tetrabiodistributed/project-tetra/README.md

# Project Tetra - Project Repository
This repository contains STL files and schematics for Project Tetra.

Project documentation available at https://tetrabiodistributed.github.io/docs
