tetrabiodistributed/project-tetra/02_Development/README.md

READ ME

File for designs of the part in all stages, 
draft, final, in testing, 

PLEASE LABEL THE DESIGNS WITH THE STATUS AND VERSION.

PLEASE CREATE A PULL REQUEST FOR EACH DESIGN OF SPLITTER

MAIN FOCUS:

TEST RESULTS NEEDED

dimensions of tubing, if they fit

strength

flow

test with different lung sizes and compliances

flow rates to diff patients

TO DESIGN ensure fittings are ISO

device at the mouth to measure tidal flow, pressure,tidal volume

antiviral & antibacterial filter - integrated into design but not essential for operation

regulator of max pressure into lungs

PEEP valve connector

3 way valve formpatiemt isolation

On git with files please create a text/pdf documentation

Thread specs: ALL IN 3/8" NPT PLEASE
