tetrabiodistributed/project-tetra/03_Visulisation_and_Handbooks/CAD_drawings/readme

Add folder for CAD drawings of components and assemblies
