tetrabiodistributed/project-tetra/02_Development/one way valve/ReadMe.txt

One_way_valve V3

*** Parts list

* "one-way valve body V3"
* "one-way valve umbrella seal V3"
*** ASSEMBLY INSTRUCTION
* The umbrella seal is a felxible silicone component with a small diameter "stem" feature and a wide flat "umbrella" feature. 
* Insert the umbrella seal, stem first, from the downstream end (against the arrow) and push the stem such that it pushes all the way through the center hole, trapping the seal. 
* The underside of the umbrella feature should lie flat against the flat internal surface.

*** TESTING:

* Test ability as a one way valve and also do cycle testing to ensure it can withstand the 1000cycles/hour
