tetrabiodistributed/project-tetra/02_Development/CPAP Regulator/README.md

**Read Me**

The folder venturi valve contains the most up to date venturi valve
The other folder contains all the other parts to be printed.
