tetrabiodistributed/project-tetra/03_Visulisation_and_Handbooks/CAD_drawings/PEEP_valve_rev2/readme

CAD drawings for PEEP valve regulator rev2
