tetrabiodistributed/project-tetra/02_Development/3WayValve/3WayConicalValve/readme.md

# 3 Way Conical Valve

3D printed 3 Way Valve for 22mm/15mm ISO 5356 Respiratory Tubing

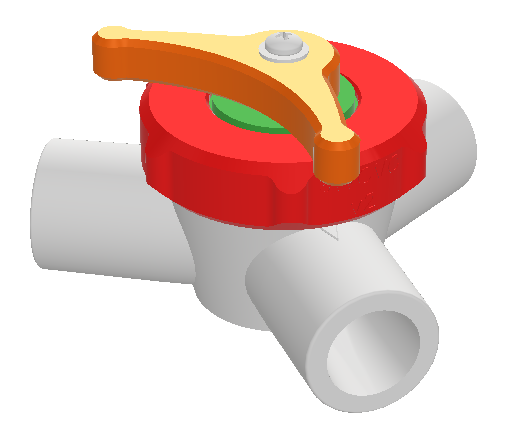
[picture p1: 02_Development/3WayValve/3WayConicalValve/3WayConicalValve.PNG]
valve


## Background

Based on request here: https://helpfulengineering.slack.com/archives/C0103QJMA84/p1584585757410000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

Valve design created that supports airflow in any 2 of the 3 ports. Utilizes 2 3D printed parts, a M3x6 screw and M3x8 washer. Substitue with #4-40 screw and #4 washer. 

Latest version is now 4 parts.

### Making Valve

Print 1 each of the following parts

* 3WayConicalValveBodyV2.stl
* 3WayConicalValveCockV2.stl
* 3WayConicalValveCapV2.stl
* 3WayConicalValveHandleV3.stl (UPDATED: new design to indicate port flow)

Purchase or find the following hardware

* M3 x 6 screw 
     * https://www.mcmaster.com/92000a116
       * or
     * https://www.homedepot.com/p/Everbilt-M3-0-5-x-6-mm-Phillips-Pan-Head-Zinc-Plated-Machine-Screw-3-Pack-802698/204282657
* M3 washer with a minimum 8mm OD (outer diameter) 
     * https://www.mcmaster.com/91116a120
       * or
     * https://www.homedepot.com/p/Everbilt-M3-Zinc-Plated-Steel-Flat-Washers-5-Pack-803518/204284512

Blind tap the screw hole at the bottom of the 3WayValveCock. If you don't have access to a tap, you can force the m3 screw into the hole. If it's not easy going, pre-heat the screw to make it easier.

Assemble, per drawing
