tetrabiodistributed/project-tetra/02_Development/TetraValve/STL/v4-1/Readme

Design works with G-74 - Compression Spring from Century Spring Corp
https://www.centuryspring.com/catalog/?page=product&cid=root&id=G-74CS

Add seal pad to base of valve head (allowance for 0.5mm thickness, if larger, characteristics may change)

Original spec o-rings ordered from McMaster Carr

O-Ring: -018 N70 NITRILE (NBR, BUNA) 70 DUROMETER BLACK https://www.globaloring.com/product/n70018/
O-Ring: -020 N70 NITRILE (NBR, BUNA) 70 DUROMETER BLACK https://www.globaloring.com/product/n70020/
O-Ring: -128 N70 NITRILE (NBR, BUNA) 70 DUROMETER BLACK https://www.globaloring.com/product/n70128/
