tetrabiodistributed/project-tetra/02_Development/FlowMeter/RPi Board/Sensor_manifold/v2/Readme.md

## Pressure sensor manifold V2 

Details on changes listed on [project card](https://github.com/orgs/tetrabiodistributed/projects/1#card-41428429)

Manifold v1 design by jgrano, updated by Burhan-Q
