tetrabiodistributed/project-tetra/02_Development/Display/Documentation/TubingDataInformationScreen.odp

## Tubing Data Information Screen

Each column is a patient connected to the port labelled with the number

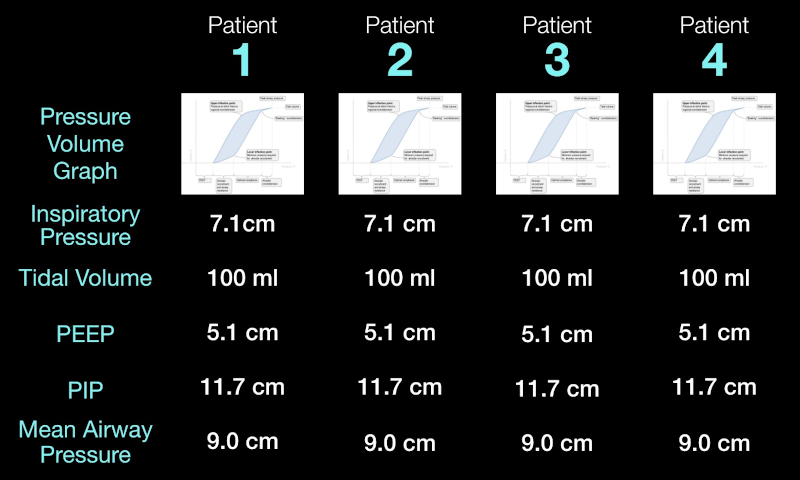
[picture p3: figure]

At the intersection of a row and column, there is the value of the row's descriptor for the column's patient

Positive End-Expiratory Pressure

Peak Inspiratory Pressure

Each row is a descriptor of the state of the patients's airways
