tetrabiodistributed/project-tetra/02_Development/CPAP Regulator/Concept Sketches/CPAP valve concept - bubbler fixed.pdf

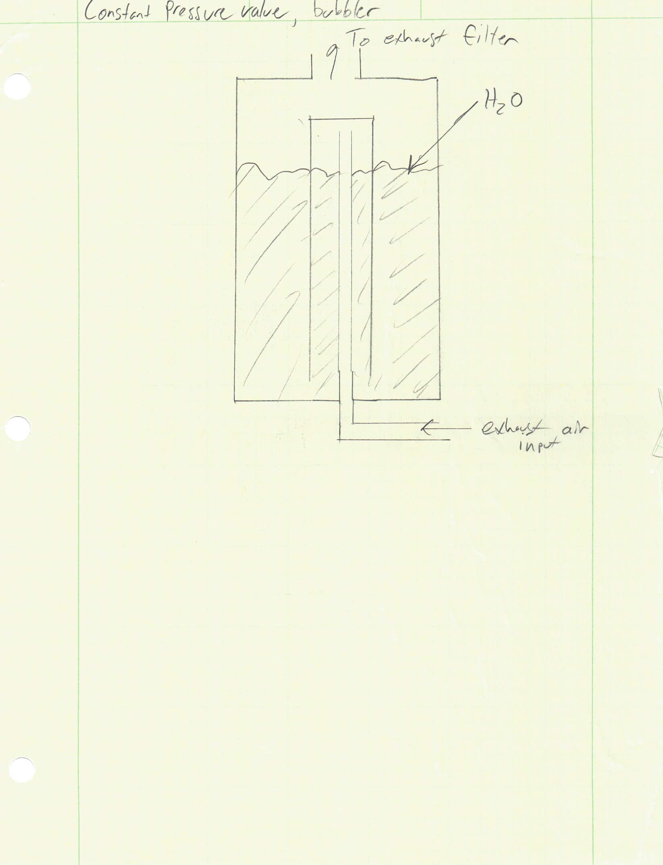
[picture p14: page 1]
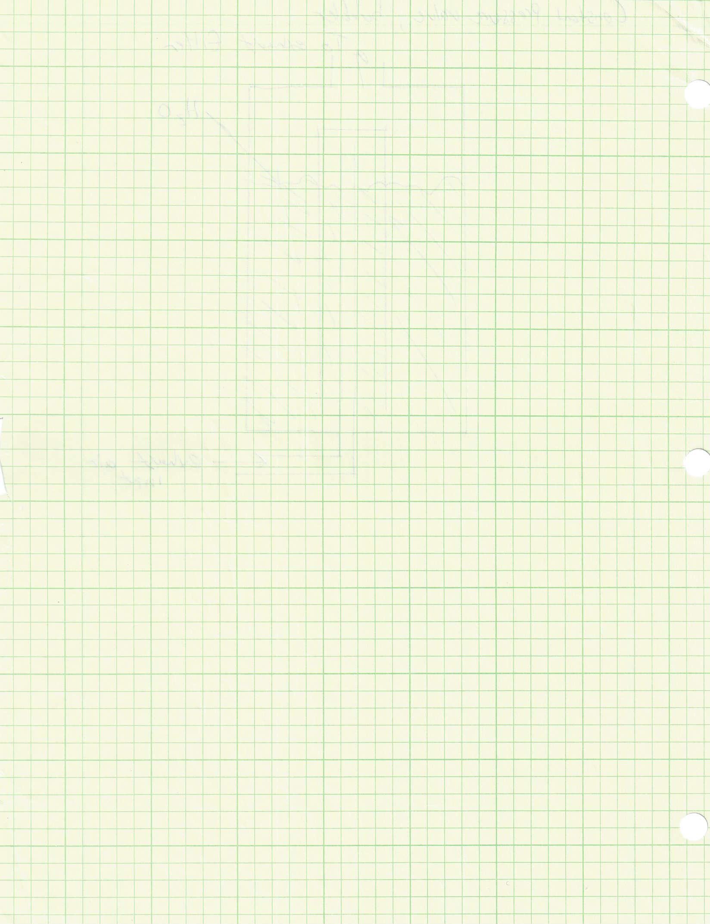
[picture p15: page 2]
