tetrabiodistributed/project-tetra/02_Development/CPAP Regulator/Concept Sketches/CPAP valve concept - isolated piston.pdf

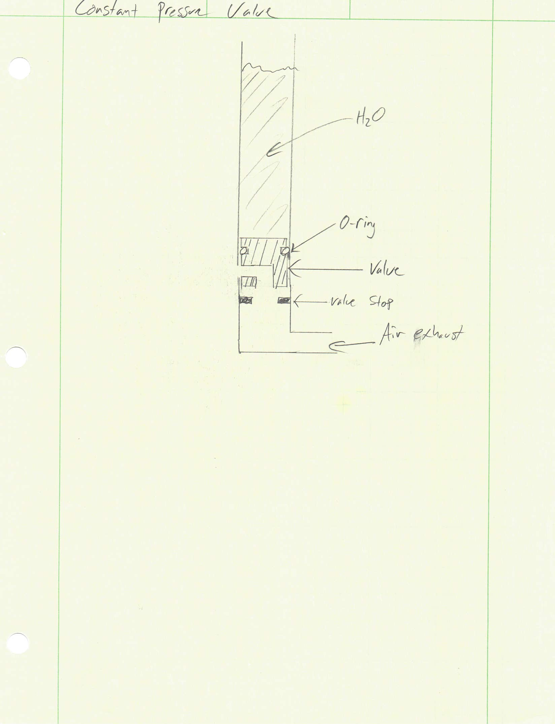
[picture p16: page 1]
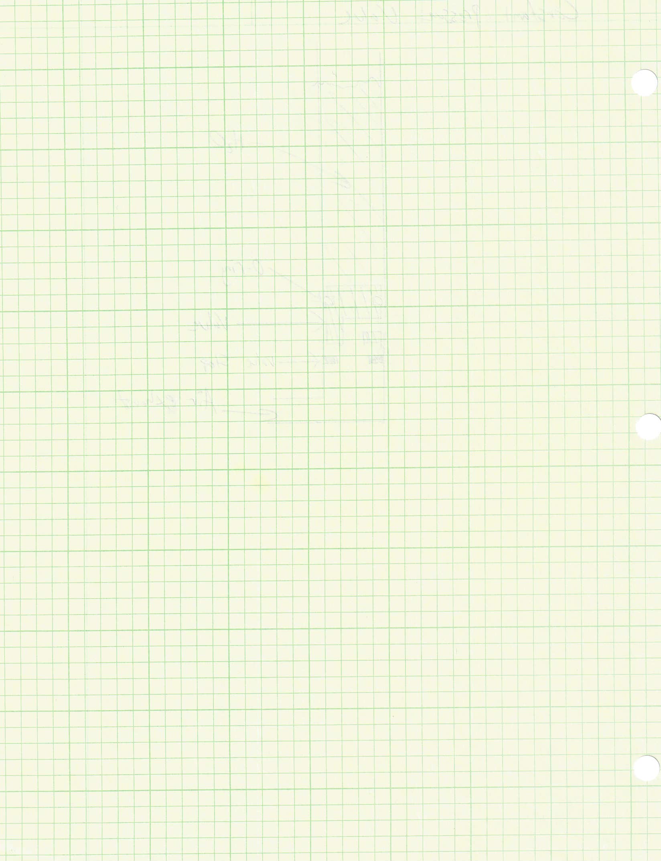
[picture p17: page 2]
