tetrabiodistributed/project-tetra/02_Development/Old/3WayValve/TeeValve - older/readme.md

# Project Title

3D printed Tee Valve for 22mm/15mm ISO 5356 Respiratory Tubing

## Background

This is an iteration of 3WayValve design and is similar as flow can be directed from any port to the other port. Unrestricted flow is from any 90 degree connection. Thru flow is somewhat restricted. It also allows for fully shutting off flow. Utilizes 2 3D printed parts, a M3x6 screw and M3x8 washer.

The T shape of the valve is less confusing than a symmetric 3 way valve. The T offers 2 ports in-line that are the inputs, and a 3rd port that can go to the user.

### Making Valve

Print 1 each of the following parts

* TeeValveBody_v001.stl
* TeeValveCock_v001.stl

Note: 3D printers make parts with varying tolerances, and material can affect the fit.  If fit is too tight, I included 2 parts that are undersized. Need to confirm air leaks are acceptable with these parts. 
* TeeValveCock_v001-undersize 1 (body diameter is undersized by .2 mm)
* TeeValveCock_v001-undersize 2 (body diameter is undersized by .4 mm)

Purchase or find the following hardware

* M3 x 6 screw
     * https://www.mcmaster.com/92000a116
     * https://www.homedepot.com/p/Everbilt-M3-0-5-x-6-mm-Phillips-Pan-Head-Zinc-Plated-Machine-Screw-3-Pack-802698/204282657
* M3 washer with a minimum 8mm OD (outer diameter) 
     * https://www.mcmaster.com/91116a120
     * https://www.homedepot.com/p/Everbilt-M3-Zinc-Plated-Steel-Flat-Washers-5-Pack-803518/204284512

Blind tap the screw hole at the bottom of the TeeValveCock

Assemble, per drawing. Remove any loose printed material and clean part before use.

## Revisions
19MAR2020 - Initial Release

## Designed With

* Autodesk Inventor 2020 

by Patrick Campbell

## License

This project is licensed under the MIT License
