tetrabiodistributed/project-tetra/02_Development/FlowMeter/RPi Board/Sensor_manifold/v1/Readme.md

## Pressure sensor manifold v1

by jgrano
