tetrabiodistributed/project-tetra/03_Visulisation_and_Handbooks/Old/Schematics/Vent Splitter Schematics v7.pptx

Inspiratory Splitter Box

Patient A Tubing

Patient B Tubing

A

Filter

Filter

B

Bias Circuit

Patient A Tubing

Patient B Tubing

A

Filter

Filter

B

Ventilator

Inspiratory Arm

Expiratory Splitter Box

Expiratory Arm

This design will allow a modern ventilator to have a splitter. The key innovation here came from the Differential Multiventilation group– the Bias Circuit. That circuit bypasses the compensatory electronics inside the ventilator. Ventilators without those electronics will not need that bias circuit. Inspiratory and Expiratory Splitter Boxes are on the pages to follow. #project-4-way-ventilator, Helpful Engineering (rev v7 25 April 2020)

## Slide 2

Ventilator Splitter Box (VSB)

Inspiratory Section

Expiratory Section

Ventilator

VSP VSB Schematics v7
25 April 2020

Inspiratory Arm

1-Way Valve

Patient 1 Flow Control

P1 Inspiration

1-Way Valve

Patient 2 Flow Control

P2 Inspiration

1-Way Valve

Patient 3 Flow Control

P3 Inspiration

1-Way Valve

Patient 4 Flow Control

P4 Inspiration

Bias Circuit

P1 Expiration

Expiratory Arm

P1 PEEP

P1 Flow Meter

P1 Shutoff

P2 PEEP

P2 Flow Meter

P2 Shutoff

P2 Expiration

P3 PEEP

P3 Flow Meter

P3 Shutoff

P3 Expiration

P3 PEEP

P4 Flow Meter

P4 Shutoff

P4 Expiration
