tetrabiodistributed/project-tetra/03_Visulisation_and_Handbooks/Old/Schematics/Vent Splitter Schematics v6.pptx

Inspiratory Splitter Box

Patient A Tubing

Patient B Tubing

A

Filter

B

Filter

Patient A Tubing

A

Filter

B

Filter

Patient B Tubing

Ventilator

Inspiratory Arm

1-way
Valve

Flow Control

Splitter

1-way
Valve

Flow Control

Expiratory Splitter Box

Expiratory Arm

PEEP Valve

Shutoff

Flow Meter

Splitter

PEEP Valve

Shutoff

Flow Meter

The goal of this design is to compartmentalize patient tubing so that patients can be added and removed without affecting other patients on the circuit. Thus, all components need to be separated by filters, but self-contained so clinicians aren’t having to attach individual splitter components. Flow control can initially be by a hand-controlled valve. #project-4-way-ventilator, Helpful Engineering (rev v5 8 April 2020)

## Slide 2

Ventilator Splitter Box (VSB)

Inspiratory Section

Expiratory Section

Ventilator

VSP VSB Schematics v6
13 April 2020

Inspiratory Arm

Patient 1 Flow Control

P1 Inspiration

Patient 2 Flow Control

P2 Inspiration

Patient 3 Flow Control

P3 Inspiration

Patient 4 Flow Control

P4 Inspiration

Expiratory Arm

P1 PEEP

P1 Flow Meter

P1 Shutoff

P1 Expiration

P2 PEEP

P2 Flow Meter

P2 Shutoff

P2 Expiration

P3 PEEP

P3 Flow Meter

P3 Shutoff

P3 Expiration

P3 PEEP

P4 Flow Meter

P4 Shutoff

P4 Expiration
