tetrabiodistributed/project-tetra/02_Development/3WayValve/3WayOring/Rev8/V1_0_X_SAK/01_CAD_Daten/image (1).png

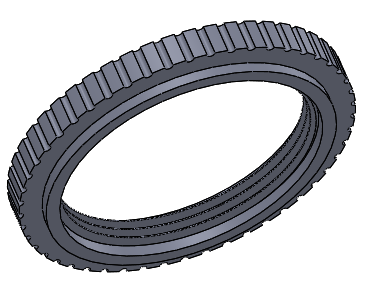
02_Development/3WayValve/3WayOring/Rev8/V1_0_X_SAK/01_CAD_Daten/image (1).png
