tetrabiodistributed/project-tetra/02_Development/3WayValve/3WayOring/Rev8/V1_0_X_SAK/02_Renderings/01_SAK.png

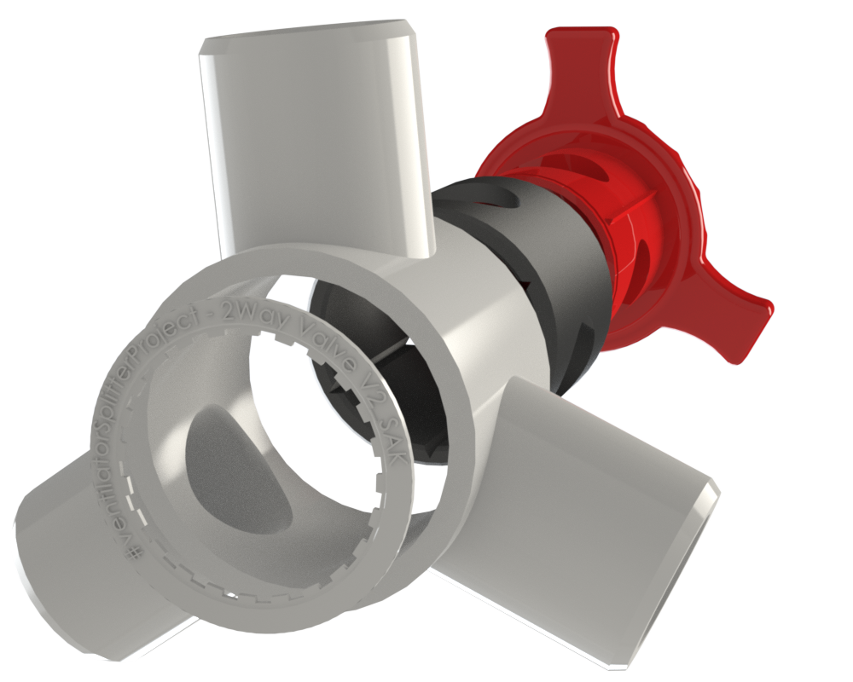
02_Development/3WayValve/3WayOring/Rev8/V1_0_X_SAK/02_Renderings/01_SAK.png
