tetrabiodistributed/project-tetra/02_Development/3WayValve/3WayOring/Rev8/V1_0_X_SAK/MoldingForm/3WayValveMoldingForm.jpg

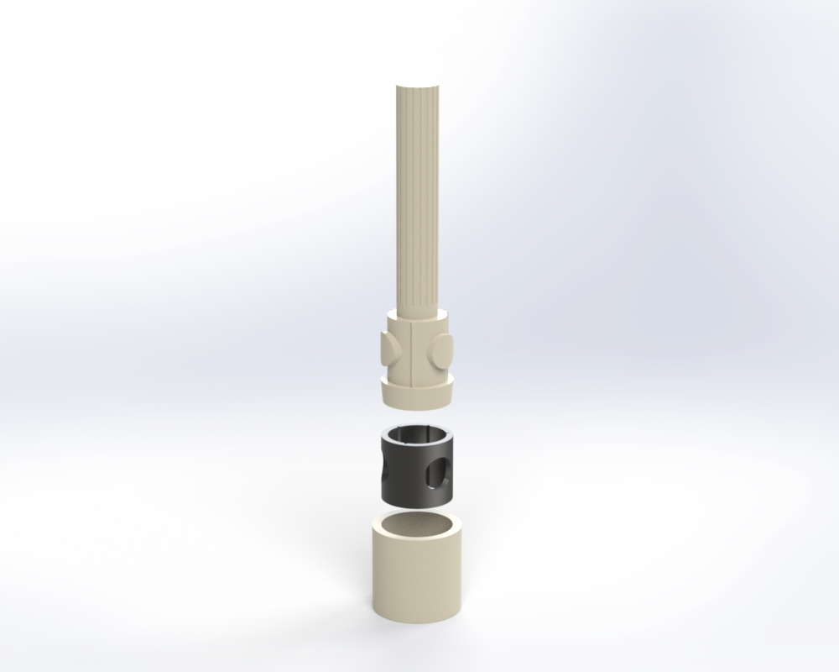
02_Development/3WayValve/3WayOring/Rev8/V1_0_X_SAK/MoldingForm/3WayValveMoldingForm.jpg
