tetrabiodistributed/project-tetra/02_Development/CPAP Regulator/Concept Sketches/CPAP valve concept - bubbler sliding dipstick.jpg

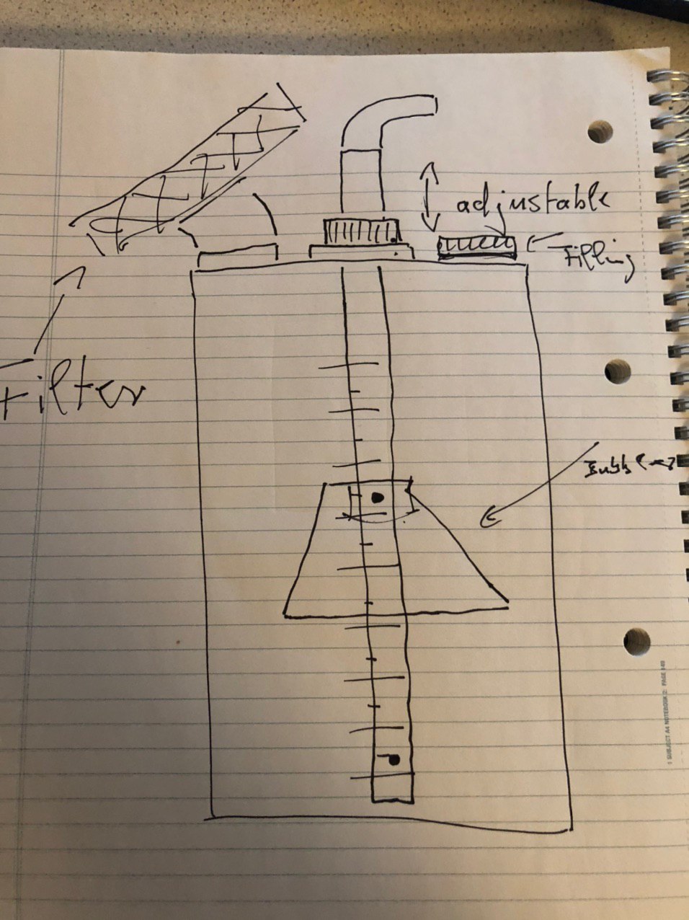
02_Development/CPAP Regulator/Concept Sketches/CPAP valve concept - bubbler sliding dipstick.jpg
