tetrabiodistributed/project-tetra/02_Development/CPAP Regulator/Positive Ending Expiratory Pressure Valve (rev. 2)/Pictures/IMG_5869.JPG

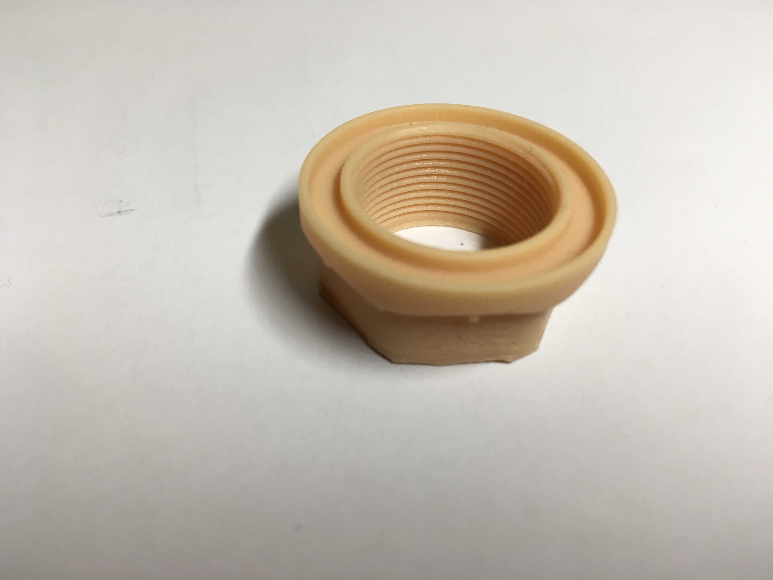
02_Development/CPAP Regulator/Positive Ending Expiratory Pressure Valve (rev. 2)/Pictures/IMG_5869.JPG
