tetrabiodistributed/project-tetra/02_Development/CPAP Regulator/positive-ending-expiratory-pressure-valve-rev1/3D/Venturi Nozzle/CFD r2.jpg

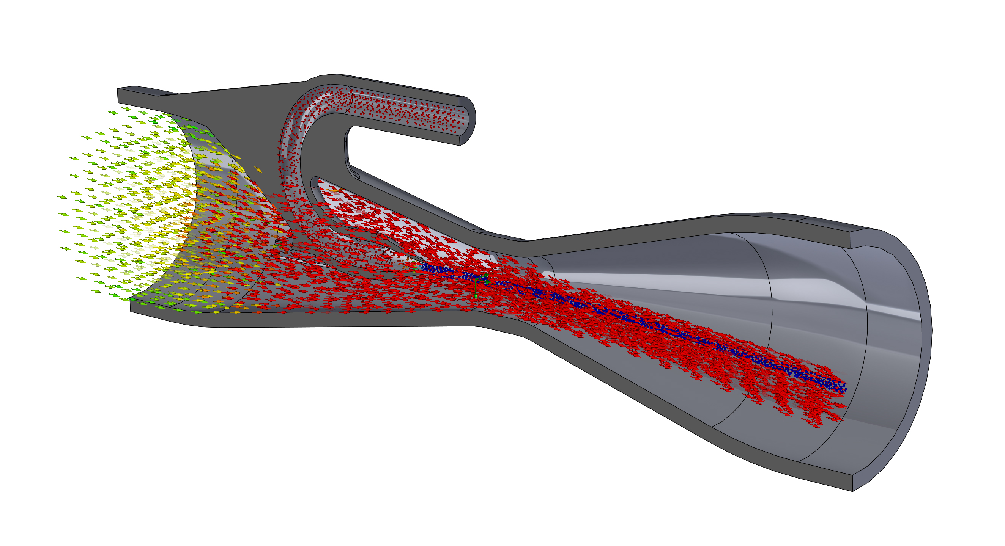
02_Development/CPAP Regulator/positive-ending-expiratory-pressure-valve-rev1/3D/Venturi Nozzle/CFD r2.jpg
