tetrabiodistributed/project-tetra/02_Development/CPAP Regulator/positive-ending-expiratory-pressure-valve-rev1/3D/Venturi Nozzle/Render rev2_1.jpg

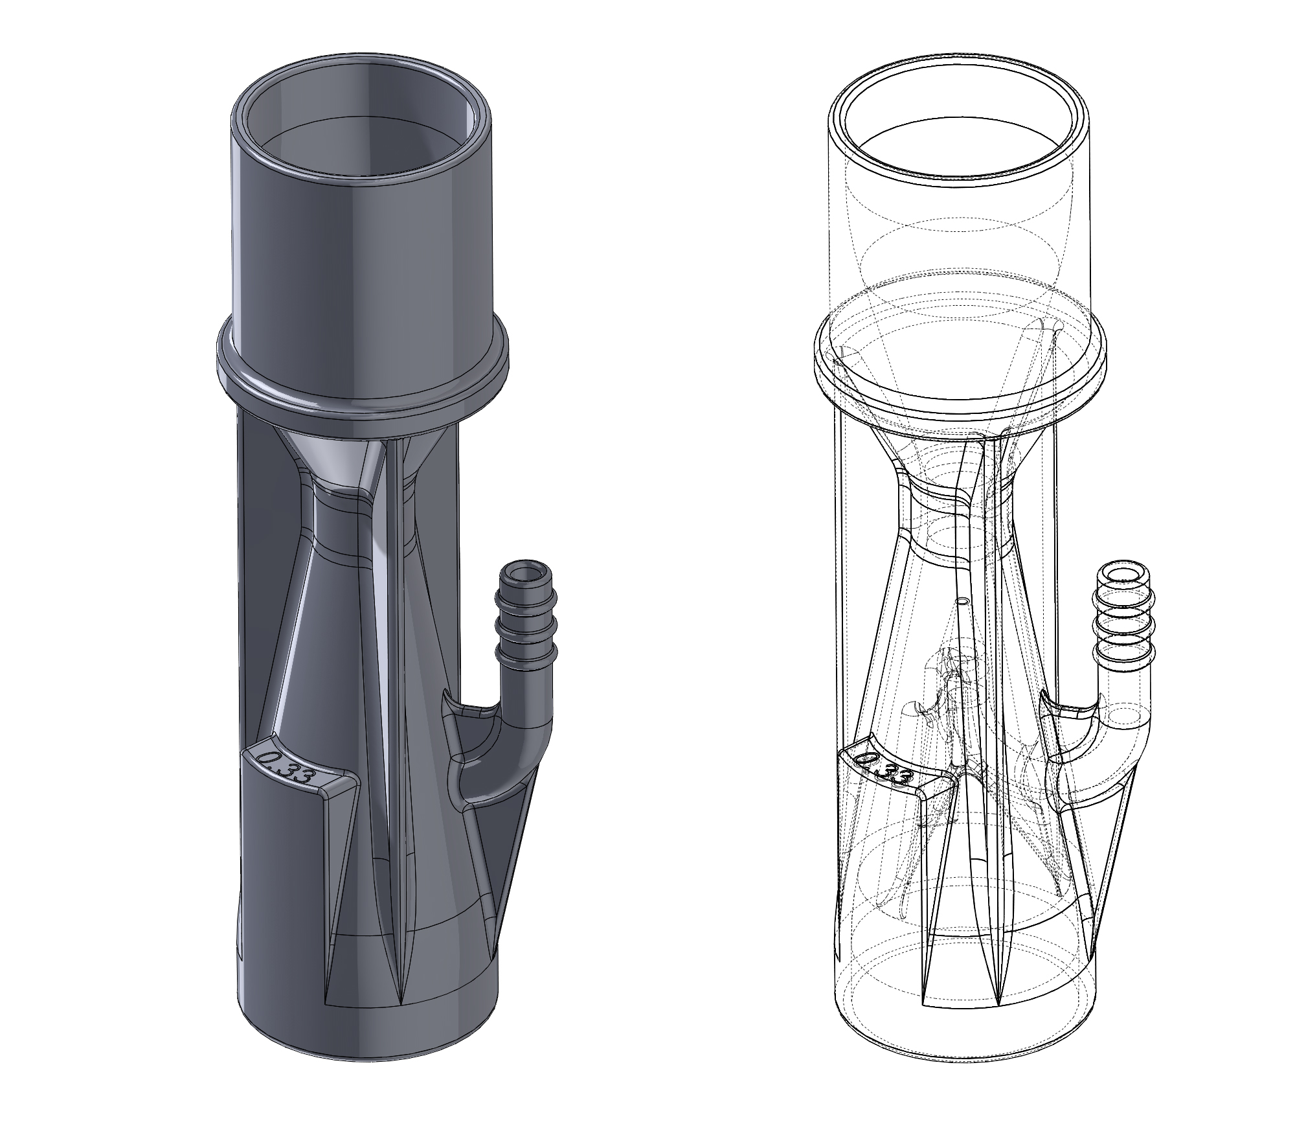
02_Development/CPAP Regulator/positive-ending-expiratory-pressure-valve-rev1/3D/Venturi Nozzle/Render rev2_1.jpg
