tetrabiodistributed/project-tetra/02_Development/CPAP Regulator/positive-ending-expiratory-pressure-valve-rev1/PEEP Calculation.png

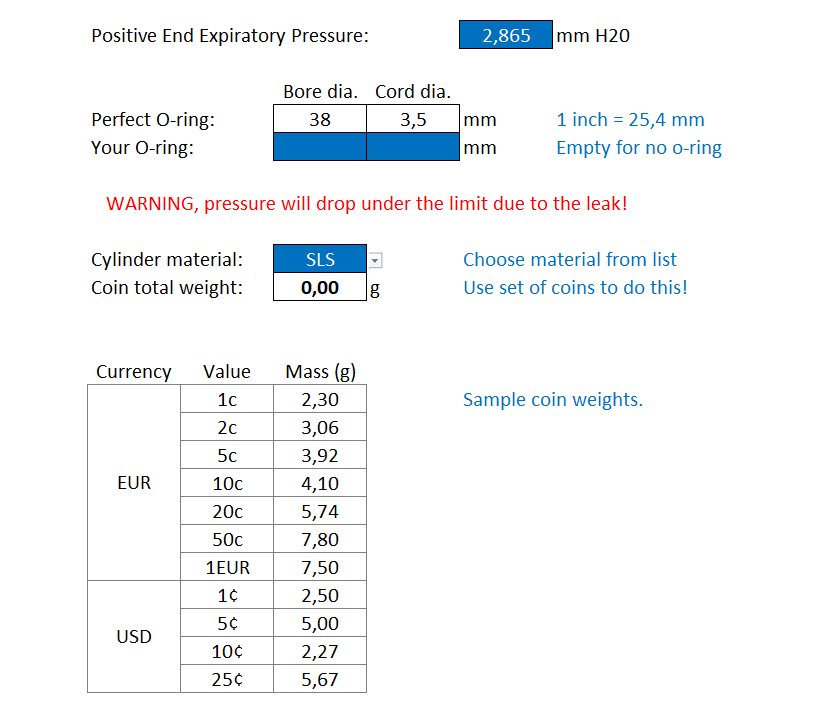
02_Development/CPAP Regulator/positive-ending-expiratory-pressure-valve-rev1/PEEP Calculation.png
