tetrabiodistributed/project-tetra/02_Development/CPAP Regulator/positive-ending-expiratory-pressure-valve-rev1/Render 2.jpg

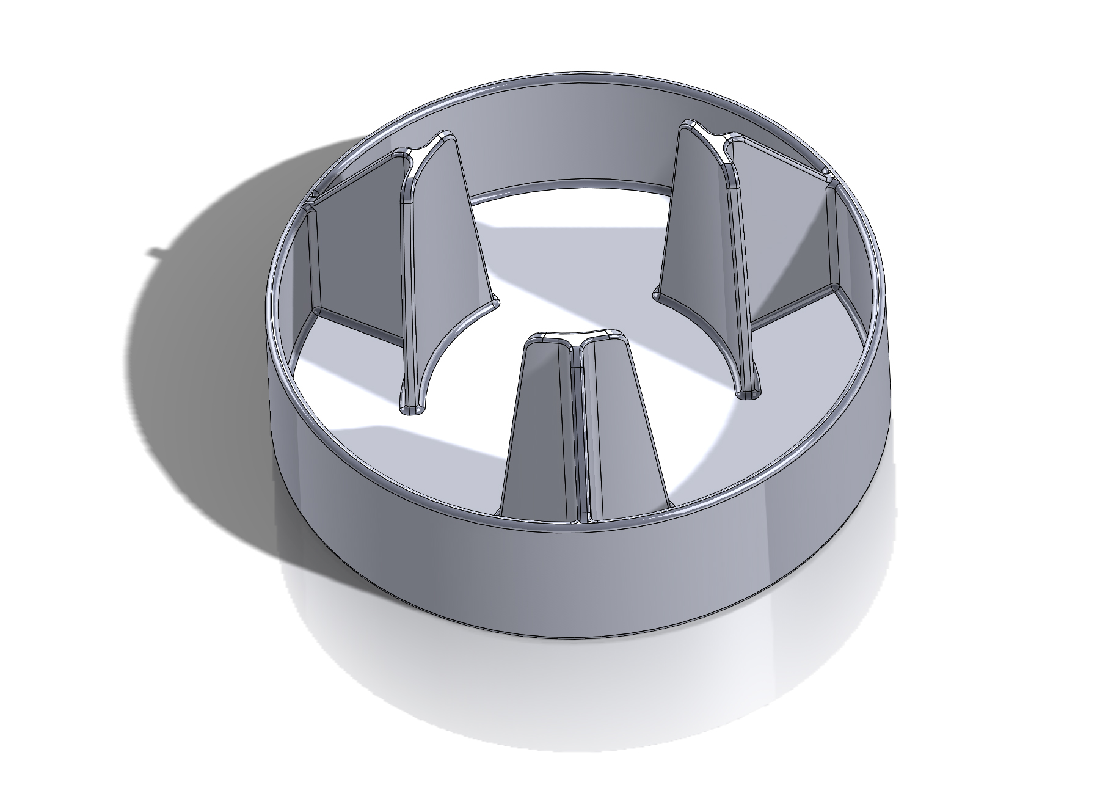
02_Development/CPAP Regulator/positive-ending-expiratory-pressure-valve-rev1/Render 2.jpg
