tetrabiodistributed/project-tetra/02_Development/CPAP Regulator/positive-ending-expiratory-pressure-valve-rev1/Render 4.jpg

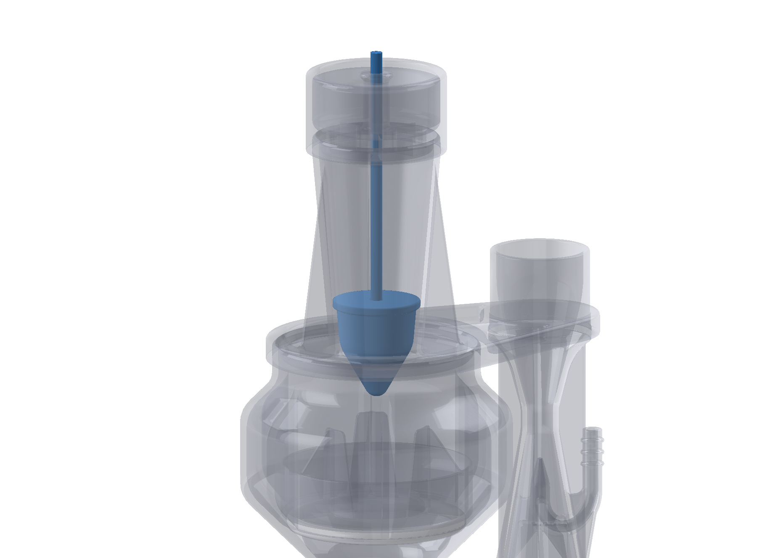
02_Development/CPAP Regulator/positive-ending-expiratory-pressure-valve-rev1/Render 4.jpg
