tetrabiodistributed/project-tetra/02_Development/CPAP Regulator/Venturi valve/Respirator-free reanimation Venturi's valve (rev. 4)/Renderings/Revision 4 - rendering 5_2.JPG

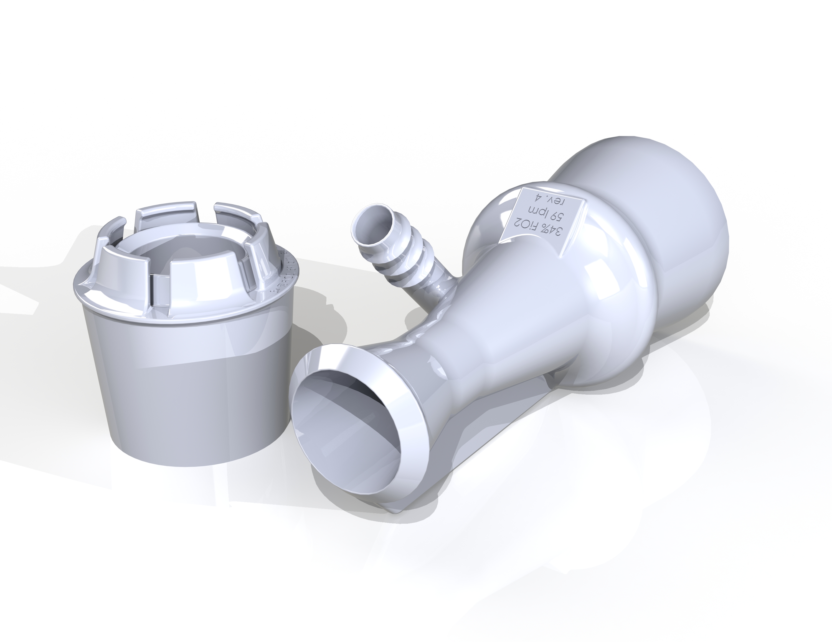
02_Development/CPAP Regulator/Venturi valve/Respirator-free reanimation Venturi's valve (rev. 4)/Renderings/Revision 4 - rendering 5_2.JPG
