tetrabiodistributed/project-tetra/02_Development/CPAP Regulator/Venturi valve/Respirator-free reanimation Venturi's valve (rev. 4)/Renderings/Revision 4 - rendering 6_2.jpg

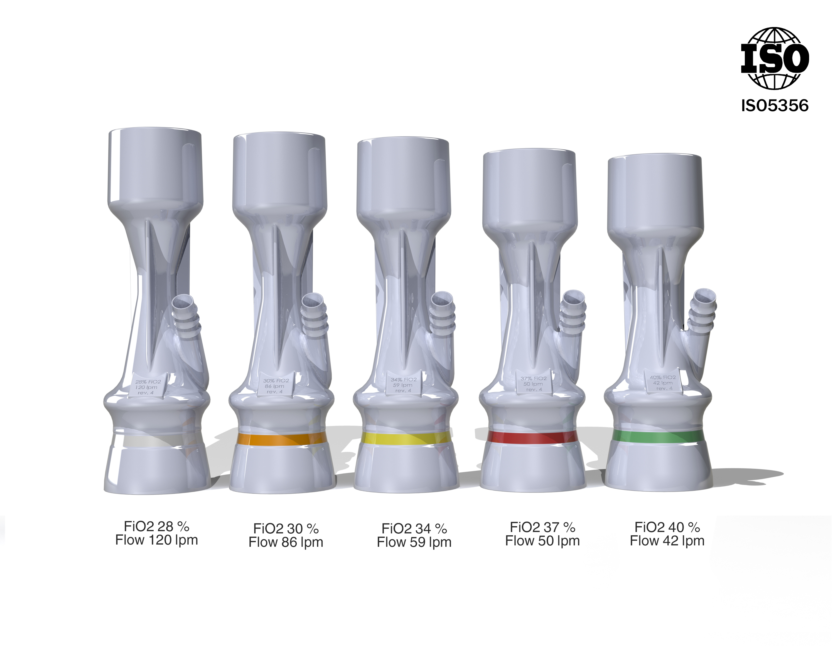
02_Development/CPAP Regulator/Venturi valve/Respirator-free reanimation Venturi's valve (rev. 4)/Renderings/Revision 4 - rendering 6_2.jpg
