tetrabiodistributed/project-tetra/02_Development/FlowMeter/flowmeter.png

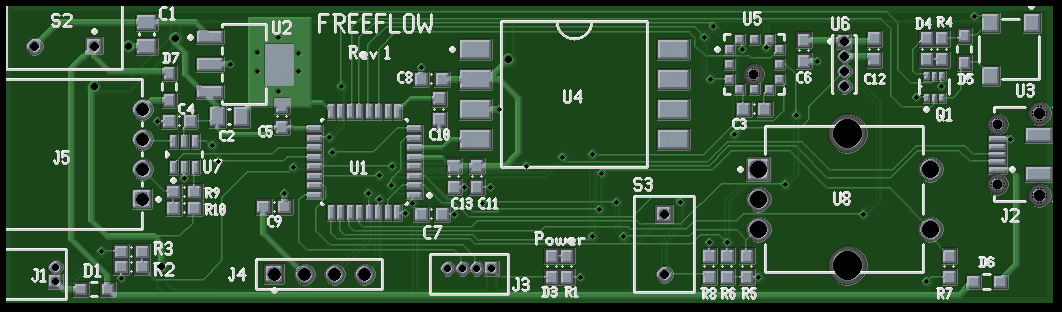
02_Development/FlowMeter/flowmeter.png
