tetrabiodistributed/project-tetra/02_Development/FlowMeter/Honeywell.PNG

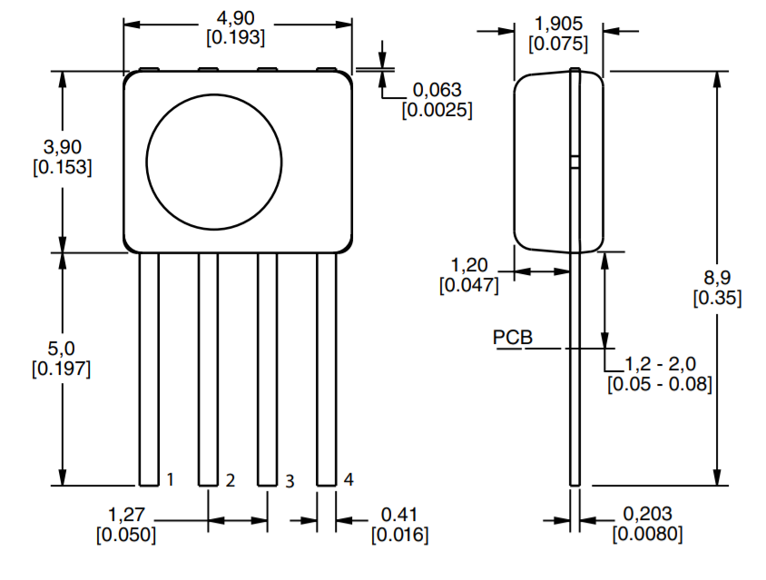
02_Development/FlowMeter/Honeywell.PNG
