tetrabiodistributed/project-tetra/02_Development/inspiratory 2-way splitter/02_Renderings/inspiratory 2-way splitter front view.PNG

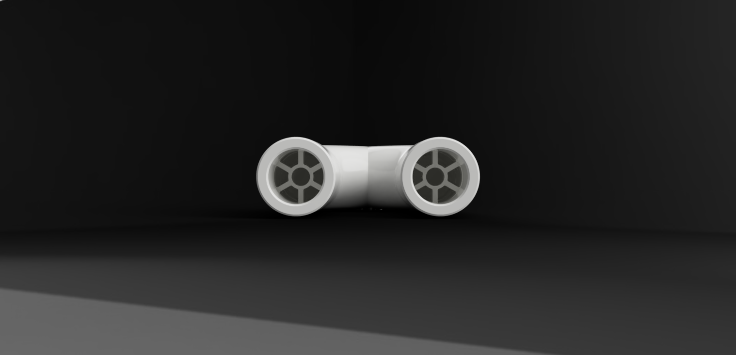
02_Development/inspiratory 2-way splitter/02_Renderings/inspiratory 2-way splitter front view.PNG
