tetrabiodistributed/project-tetra/02_Development/inspiratory 2-way splitter/02_Renderings/inspiratory 2-way splitter.png

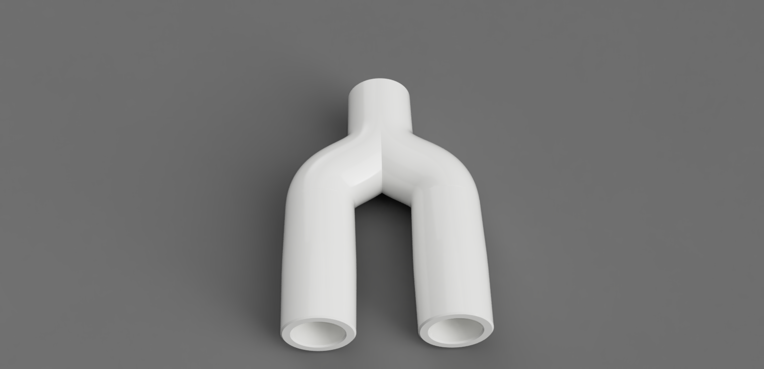
02_Development/inspiratory 2-way splitter/02_Renderings/inspiratory 2-way splitter.png
