tetrabiodistributed/project-tetra/02_Development/Main-Splitter/03_15mm adaptor/4WayVent_3DP_v06_15 mm adapter.JPG

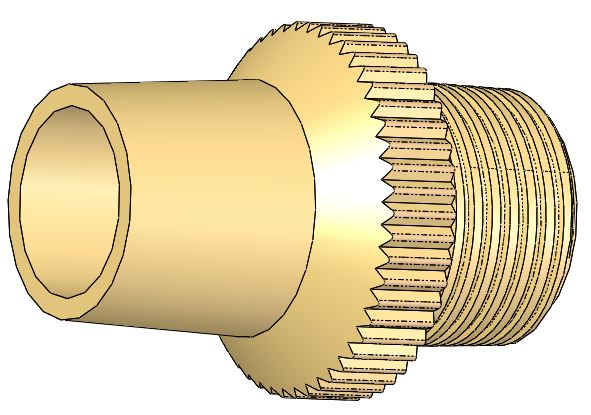
02_Development/Main-Splitter/03_15mm adaptor/4WayVent_3DP_v06_15 mm adapter.JPG
