tetrabiodistributed/project-tetra/02_Development/Male to male connector/Rev2/02_Renderings/male_conector_3_8_NPT_Render_1.png

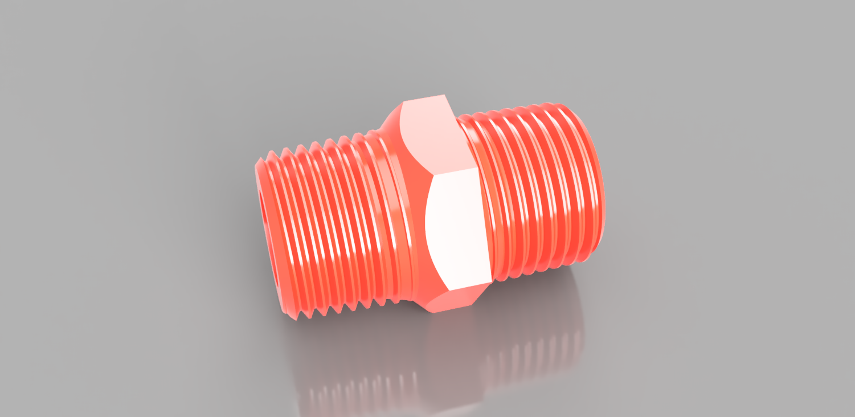
02_Development/Male to male connector/Rev2/02_Renderings/male_conector_3_8_NPT_Render_1.png
