tetrabiodistributed/project-tetra/02_Development/one way valve/one-way valve umbrella seal V3.JPG

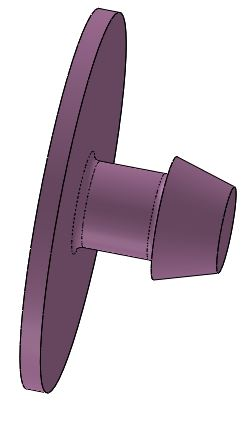
02_Development/one way valve/one-way valve umbrella seal V3.JPG
