tetrabiodistributed/project-tetra/02_Development/one way valve/one-way valve V3 cross-section.JPG

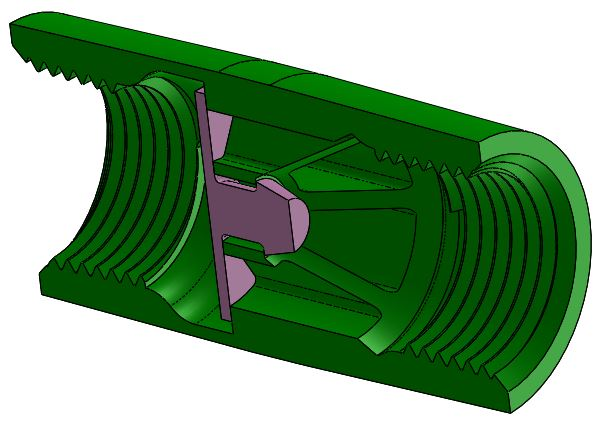
02_Development/one way valve/one-way valve V3 cross-section.JPG
