tetrabiodistributed/project-tetra/02_Development/one way valve/Rev2 - Use This with TPU/02_Renders/Cut view.png

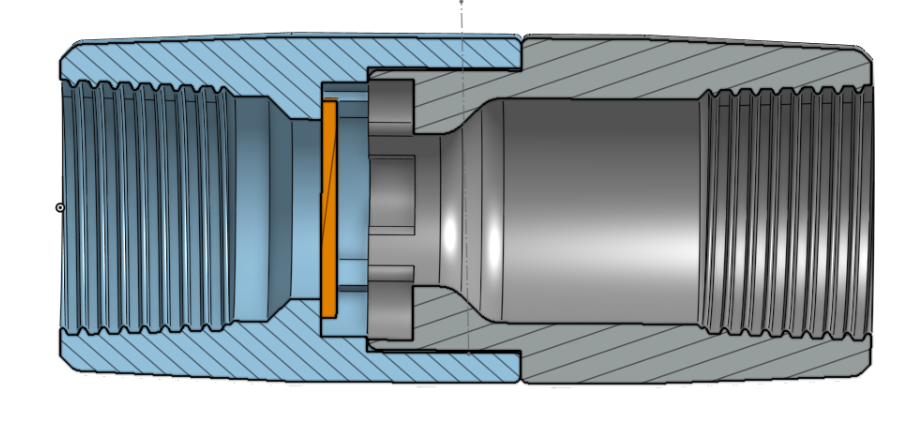
02_Development/one way valve/Rev2 - Use This with TPU/02_Renders/Cut view.png
