tetrabiodistributed/project-tetra/02_Development/one way valve/Rev4_Unthreaded/02_Renders/ValveBody_CrossSection.png

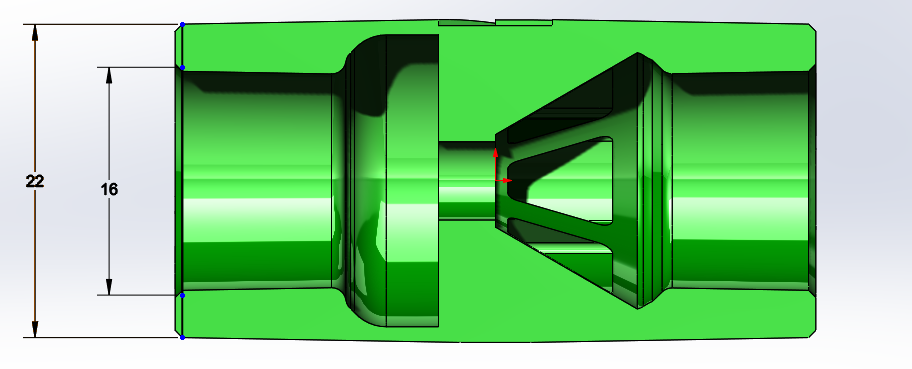
02_Development/one way valve/Rev4_Unthreaded/02_Renders/ValveBody_CrossSection.png
