tetrabiodistributed/project-tetra/02_Development/OneWayValveNew/photo_2020-04-03 14.55.22.jpeg

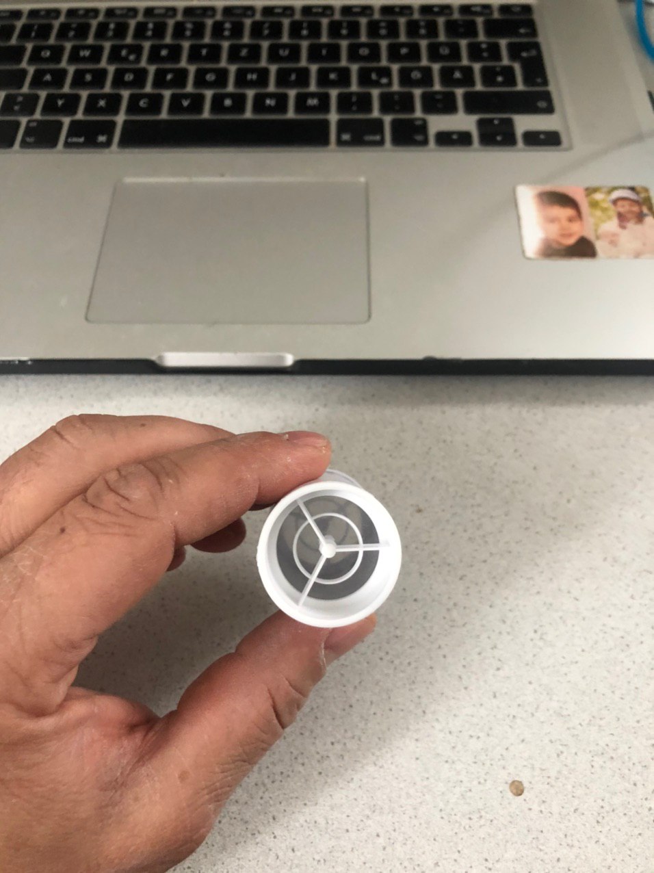
02_Development/OneWayValveNew/photo_2020-04-03 14.55.22.jpeg
