tetrabiodistributed/project-tetra/02_Development/OneWayValveNew/photo_2020-04-03 20.42.10.jpeg

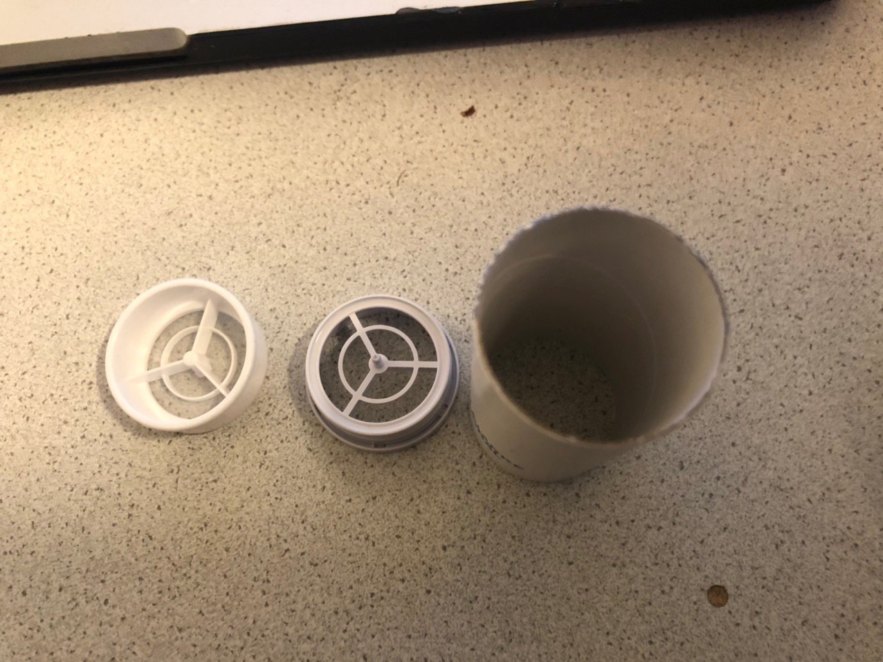
02_Development/OneWayValveNew/photo_2020-04-03 20.42.10.jpeg
