tetrabiodistributed/project-tetra/02_Development/OneWayValveNew/photo_2020-04-03 21.38.17.jpeg

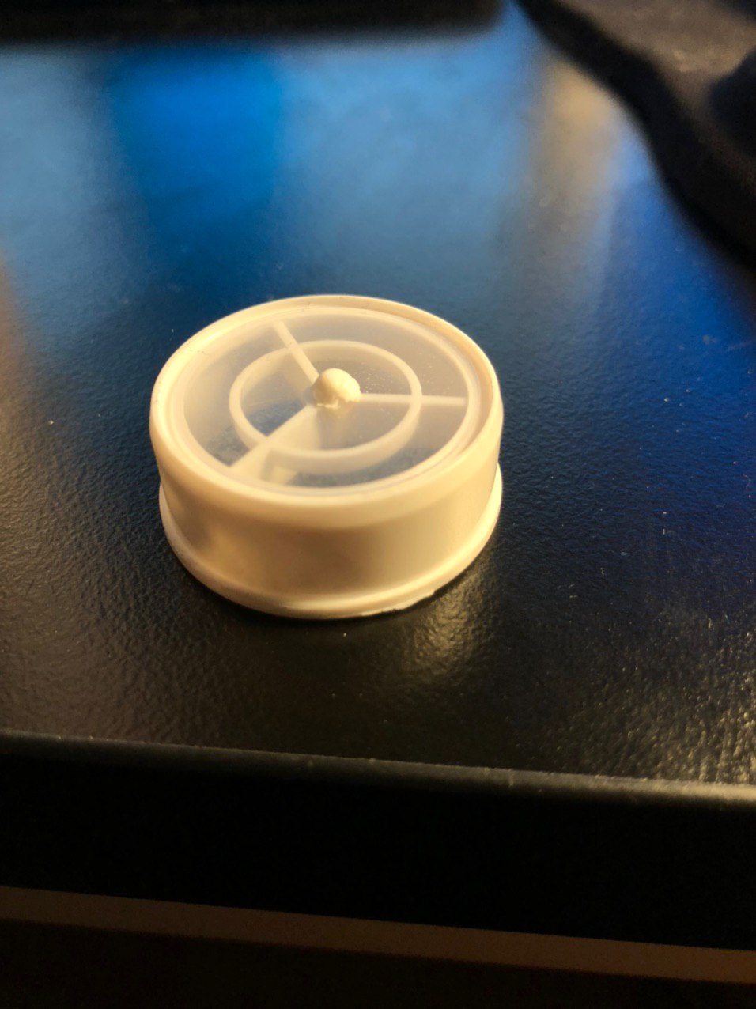
02_Development/OneWayValveNew/photo_2020-04-03 21.38.17.jpeg
