tetrabiodistributed/project-tetra/02_Development/tesla valve 1-4_1.png

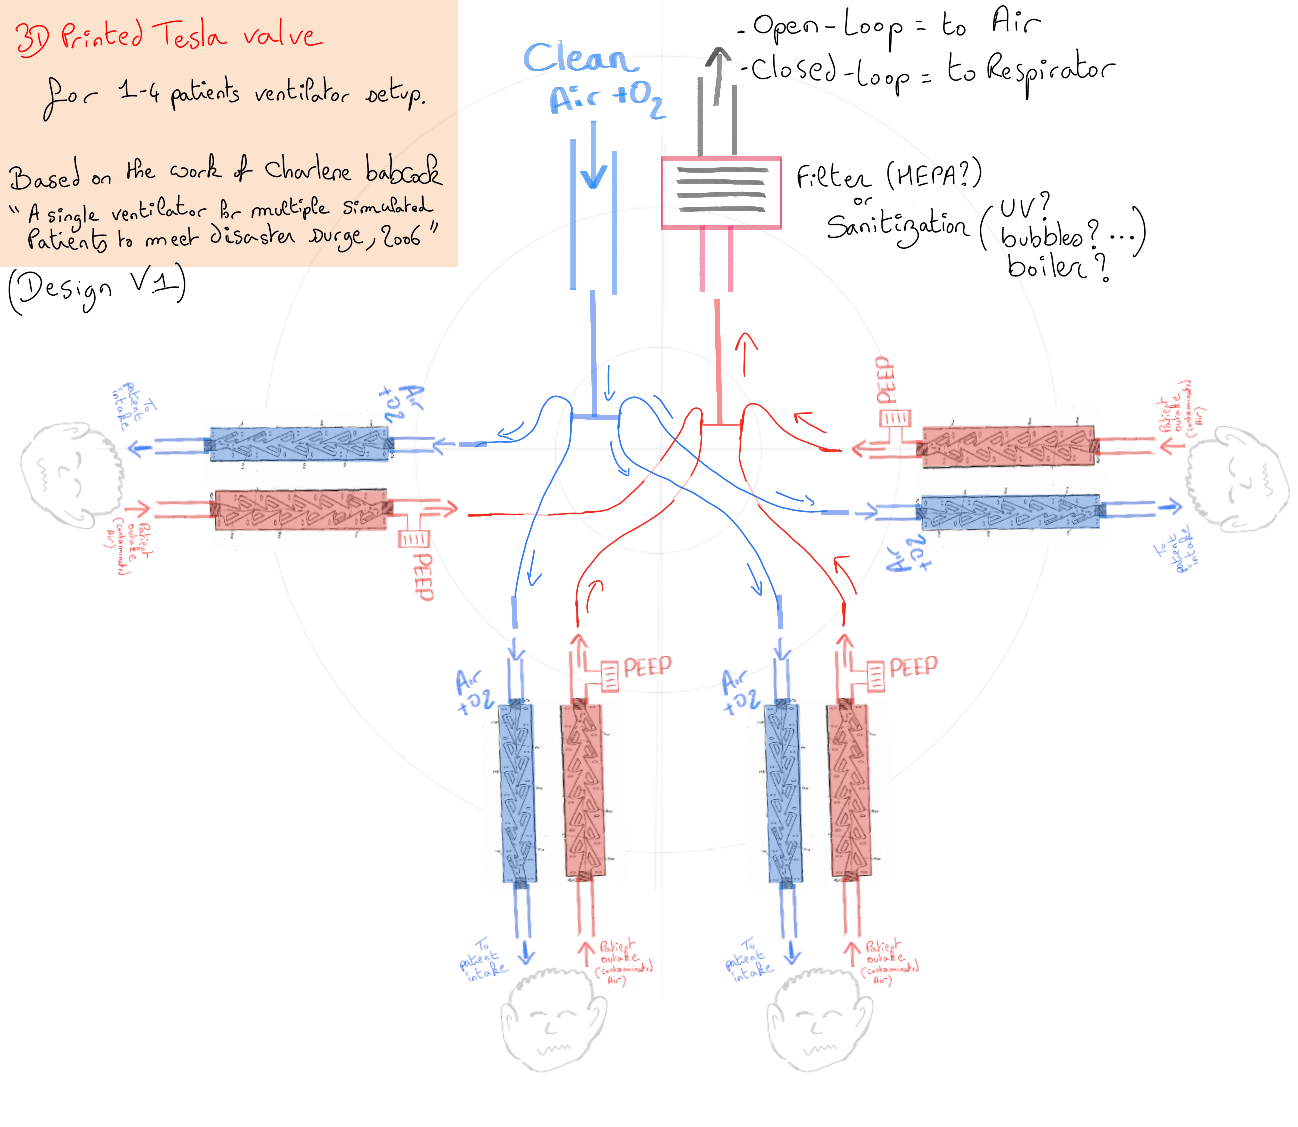
02_Development/tesla valve 1-4_1.png
