tetrabiodistributed/project-tetra/03_Visulisation_and_Handbooks/CAD_drawings/Tetra_drawing_templates/August-2020/DWG/output-onlinejpgtools_1.png

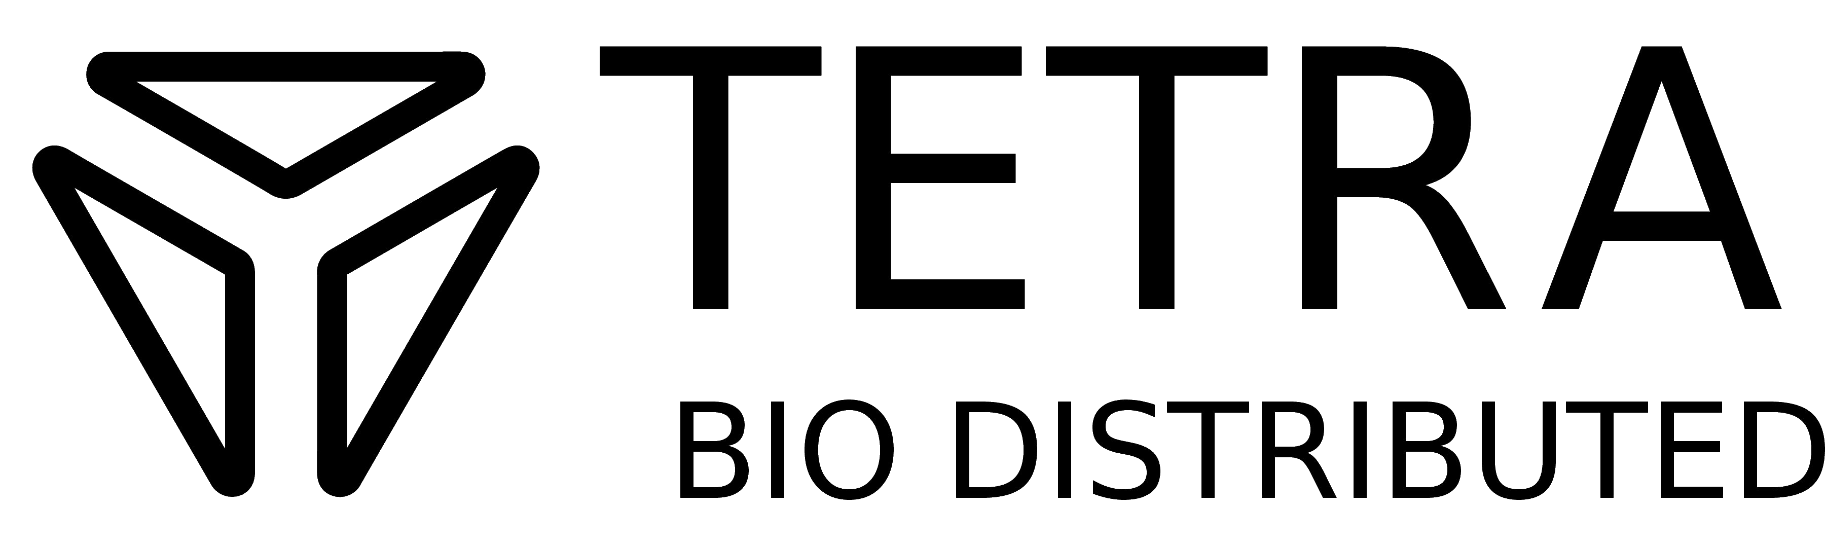
03_Visulisation_and_Handbooks/CAD_drawings/Tetra_drawing_templates/August-2020/DWG/output-onlinejpgtools_1.png
