tetrabiodistributed/project-tetra/05_Visulisation_and_Handbooks/Label Advisory v1 schematic.png

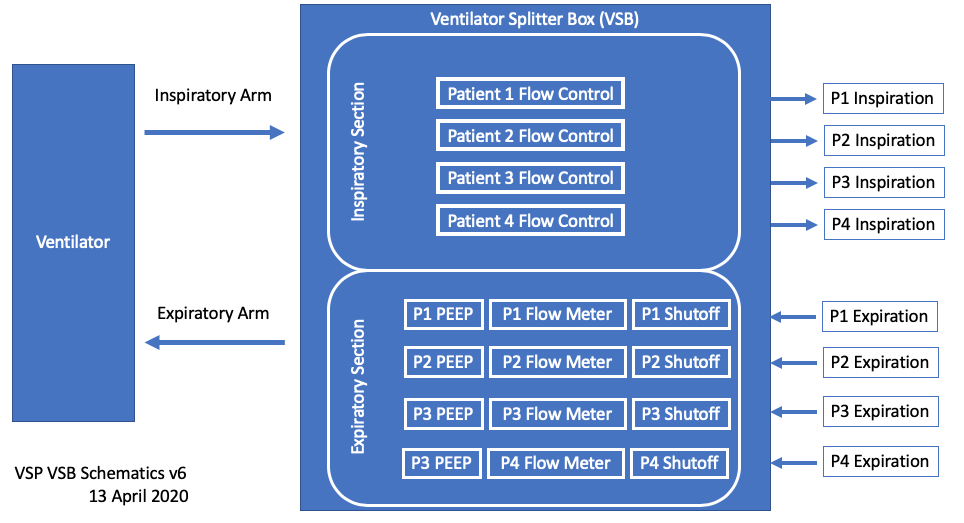
05_Visulisation_and_Handbooks/Label Advisory v1 schematic.png
