tetrabiodistributed/project-tetra/05_Visulisation_and_Handbooks/Overall Schematic v1.png

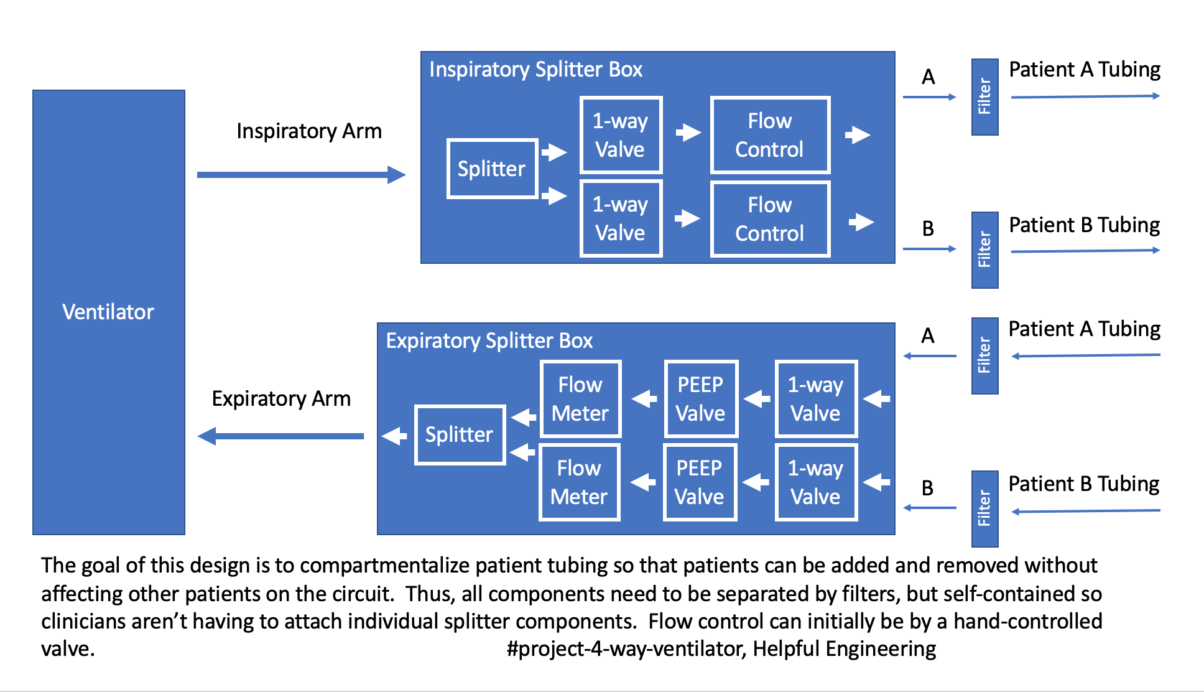
05_Visulisation_and_Handbooks/Overall Schematic v1.png
