tetrabiodistributed/project-tetra/05_Visulisation_and_Handbooks/PVC Inspiratory v1.png

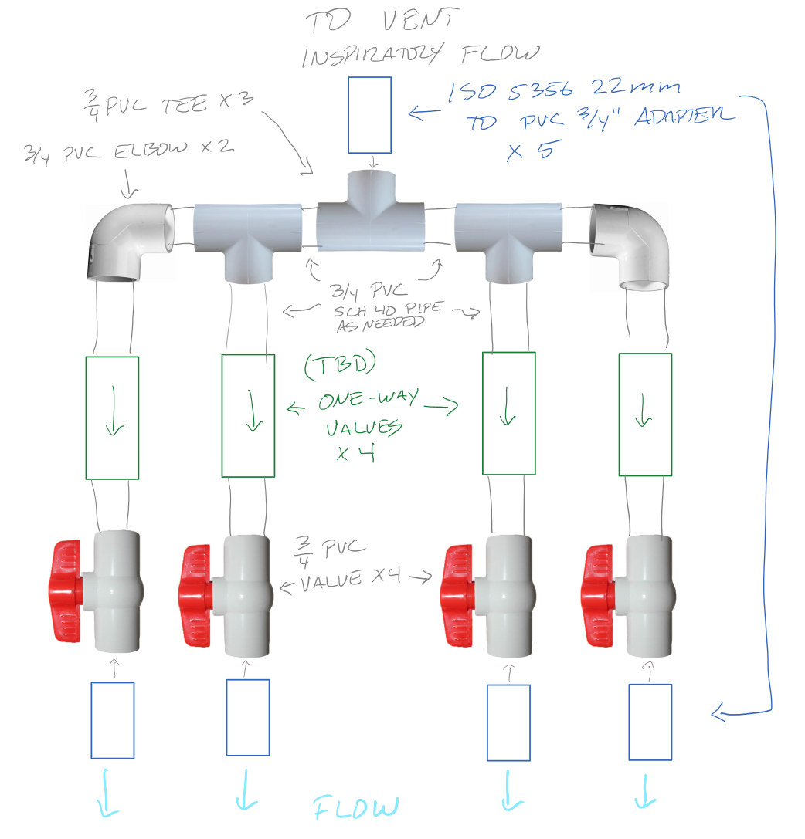
05_Visulisation_and_Handbooks/PVC Inspiratory v1.png
