tetrabiodistributed/project-tetra/05_Visulisation_and_Handbooks/Screen Shot 2020-06-04 at 10.51.27 AM.png

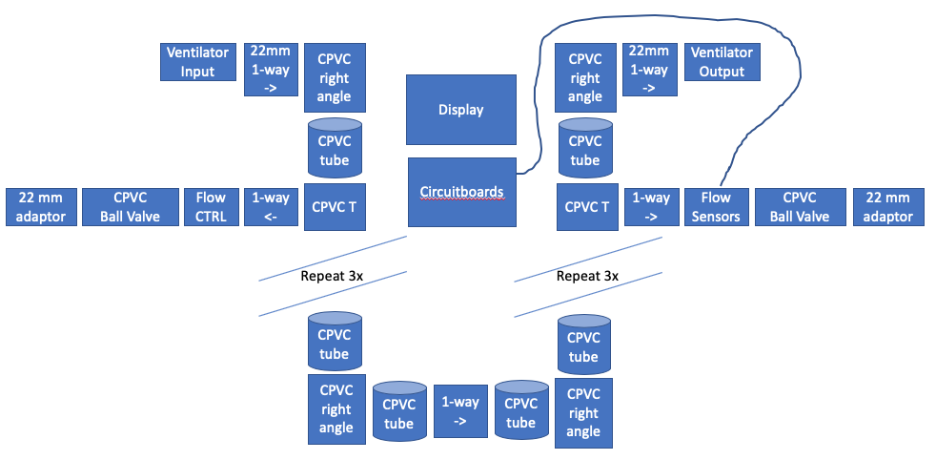
05_Visulisation_and_Handbooks/Screen Shot 2020-06-04 at 10.51.27 AM.png
