tetrabiodistributed/project-tetra/02_Development/Prototype_release/Alpha/Parts_to_print/Readme.md

# Parts Released for production #

[Project Tetra Printing Doc](https://docs.google.com/spreadsheets/d/1FWTYRxglWDqIK_xI6HlBGKUegICQRsXe5NHCJTlTlHs/edit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)

Part number | Description | Quantity
------------ | ------------ | ------------ 
P-TET-000001-0 | 90 Degree Elbow | 4
P-TET-000002-0 | Large T | 4
P-TET-000003-0 | Ventilator_IO-T | 2
P-TET-000004-0 | RPi display frame | 1
P-TET-000005-0 | Pressure Manifold (SLA)| 1
P-TET-000006-0 | ISO Adapter w/ pressure port | 4
P-TET-000008-0 | Pressure Manifold (FDM) | 1
P-TET-000009-0 | Front Port Cover | 4
P-TET-000010-0 | interior insipiratory support lower | 4
P-TET-000011-0 | interior insipiratory support upper | 4
P-TET-000012-0 | interior expiratory support upper | 5
P-TET-000013-0 | interior expiratory support lower | 5
P-TET-000014-0 | Handle | 2
P-TET-000015-0 | Corner Bracket Left | 1
P-TET-000016-0 | Corner Bracket Right | 1
P-TET-000017-0 | RPi display mounting bracket | 2
P-TET-000018-0 | Shut off Valve Main Body | 4
P-TET-000019-0 | Shut off Valve Thru Body | 8
P-TET-000020-0 | Shut off Valve Cap | 8
P-TET-000021-0 | Shut off Valve Knob | 8
P-TET-000022-0 | Tetra Valve Plunger | 4
P-TET-000023-0 | Tetra Valve Main Body | 4
