tetrabiodistributed/project-tetra/02_Development/Push_Fit_Design/BOM.md

| P/N 	| Item 	| Link 	| No off 	|
|---	|---	|---	|---	|
| M-AS-PT12 	| Equal Tee Push In Fittings 12mm 	| https://www.airsupplies.co.uk/equal-tee-12303 	| 6 	  |
| M-AS-PY12 	| Equal Y Push In Fittings 12mm 	| https://www.airsupplies.co.uk/equal-y | 2 	  |
| M-AS-PSY12 	| Stem Y Push In Fittings 12mm 	| https://www.airsupplies.co.uk/stem-y | 4 	 |
| M-AS-PSCF12 	| Flow Controller Push In Fittings 12mm 	| https://www.airsupplies.co.uk/flow-controller 	| 4 	  |
| M-RS-145-3731  	| Ball Valve Push In Fittings 12mm 	| https://uk.rs-online.com/web/p/pneumatic-manual-control-valves/1453731 | 8 	 |
| M-AS-MNT12-10B  | Nylon Tubing 12mm 30m 	| https://www.airsupplies.co.uk/colour-blue-12mm-o-d-x-10mm-i-d-x30m-lengt 	 | 1 	  |
| M-AS-PL12 | Equal Elbow Push In Fittings 12mm 	| https://www.airsupplies.co.uk/equal-elbow-12395 	 | 8 	  |
| M-AS-PMS12/06 | Male Stud Push In Fittings 12mm 3/8" BSPT  	| https://www.airsupplies.co.uk/male-stud-11886 | 38 	  |
| M-RS-265-5545 | 6mm Push fit to M5 elbow 	| https://uk.rs-online.com/web/p/pneumatic-fittings/2655545 | 4 	  |
| M-TBC-BS111 | 70A Durometer Nitrile O-Ring BS111 	 | https://www.thebearingcompany.co.uk/products/bs111-10-77mm-x-2-62mm-70-shore-oring/ | 4 	  |
| M-AS-PRC08/06  	| Stem Reducer 8mm to 6mm 	| https://www.airsupplies.co.uk/stem-o-d-mm-a-12-tube-o-d-mm-b-8 | 4 	 | 
| M-AS-PRC12/08 | Stem Reducer 12mm to 8mm 	 | https://www.airsupplies.co.uk/stem-o-d-mm-a-12-tube-o-d-mm-b-8 | 4 	 |
| M-AM-MS016-10 | Silicone one way valves 	 | https://www.amazon.co.uk/Trimming-Shop-Breathing-Accessories-Protection/dp/B08F2JQKSX | 9 	  | 
| P-TET-000138-0 	| 3D print non-return valve 	| https://github.com/tetrabiodistributed/project-tetra/blob/main/02_Development/Push_Fit_Design/P-TET-000138-0.stl 	| 9 	  |
| P-TET-000127-1 	| 3D print push fit to tube adapter | https://github.com/tetrabiodistributed/project-tetra/blob/main/02_Development/Push_Fit_Design/P-TET-000127-1.stl 	| 10 	  |
| P-TET-000126-0 	| Push fit pressure manifold | https://github.com/tetrabiodistributed/project-tetra/blob/main/02_Development/Push_Fit_Design/D-TET-001105-0%20Push%20Fit%20Manifold%20Drawing.pdf| 1 	  |
| P-TET-000136-1 	| 3D print push fit to Sensirion adapter female | https://github.com/tetrabiodistributed/project-tetra/blob/main/02_Development/Push_Fit_Design/P-TET-000136-1.stl 	| 4 	  |
| P-TET-000137-1 	| 3D print push fit to Sensirion adapter female | https://github.com/tetrabiodistributed/project-tetra/blob/main/02_Development/Push_Fit_Design/P-TET-000137-1.stl  | 4 	 | 
| M-AS-PC01 | Nylon Tube Cutter 	| https://www.airsupplies.co.uk/nylon-tube-cutter 	 | 1 	  |
