tetrabiodistributed/project-tetra/02_Development/FlowMeter/RPi Board/BOM and Parts Layout/RPI_v2_BOM.csv

Qty | designator | footprint | comment | LCSC Part#
5 | C1,C4,C5,C16,C17 | CAP-0805 | 33NF 50V 0805 | C1739
7 | C2,C3,C6,C9,C10,C11,C12 | CAP-0805 | 100NF 50V 0805 | C49678
5 | C14,C15,C19,C20,C23 | CAP-0805 | 1UF 50V 0805 ROHS | C28323
2 | C7, C8 | CAP-0805 | 10UF 25V 0805 | C15850
1 | R46 | 0805_R | 0OHMS ±1% 1/8W 0805 | C17477
8 | R4,R26,R27,R28,R37,R38,R43,R44 | 0805_R | 100OHMS ±1% 1/8W 0805 ROHS | C17408
4 | R3,R23,R24,R45 | 0805_R | 1KOHMS ±1% 1/8W 0805 ROHS | C17513
2 | R5,R12 | 0805_R | 2KOHMS ±1% 1/8W 0805 ROHS | C17604
1 | R2 | 0805_R | 3.3KOHMS ±1% 1/8W 0805 ROHS | C26010
30 | R1,R6,R7,R8,R9,R10,R11,R13,R14,R15,R16,R17,R18,R19,R20,R21,R22,R25,R29,R30,R31,R32,R33,R34,R35,R36,R39,R40,R41,R42 | 0805_R | 10KOHMS ±1% 1/8W 0805 ROHS | C17414
1 | C22 | SMD-ECAP-10x10 | 220uF 50V 10x10mm panasonic G | C134732
1 | C21 | SMD-ECAP-10x10 | 330UF ±20% 35V 10x10mm panasonic G | C134522
1 | D3 | SMA(DO-214AC) | SCHOTTKY BARRIER DIODES (SBD) SMA(DO-214AC) | C22452
1 | C18 | CAP-0805 | 470NF 50V 0805 | C13967
1 | L1 | SMD-PIND-12.5x12.5x8_2.9x5.4 | 47UH ±20% 2.5A SMD,12.5X12.5X8MM(MAX) ROHS | C169376
1 | ADC1 | HTSSOP-16_EP_4.4x5.0x0.65P | (ADCS) 12 1M 8 SPI,DSP 2.7V~5.25V | C179666
1 | Q2 | SOT-23 | NPN 500MA 25V SOT-23(SOT-23-3) ROHS | C2146
4 | D1,D2,D4,D5 | LED-1206 | red led, FV1.8V 20ma | C88326
1 | REF1 | SOT23-3 | VOLTAGE REFERENCES 4.096V | C19415
5 | P1,P2,P3,P4,P5 | LGA-8-2.5X2.0 | SPL006-007 – Pressure humidity sensors | C233787
1 | VREG1 | TO263-5 | XL4015 DC-DC CONVERTERS ADJ 1 8V 36V 1.25V 32V 5A | C51661
2 | U6, U7 | TSSOP-24_4.4x7.8x0.65P | TCA9548AP – i2c multiplexer | C21198
