tetrabiodistributed/project-tetra/02_Development/3WayValve/3WayConicalValve/3WayConicalValveAssembly.step

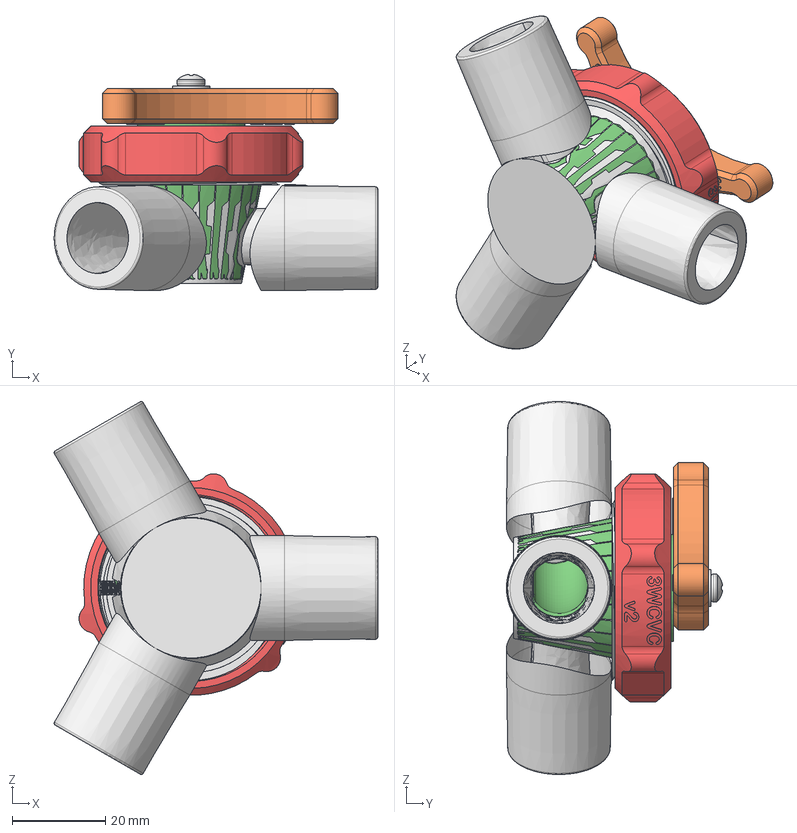
[picture p96: CAD file, 2020-03-27]
02_Development/3WayValve/3WayConicalValve/3WayConicalValveAssembly.step
69.3 x 46.3 x 79.9 mm
3WayConicalValveBodyv3
3WayConicalValveCockV2
3WayConicalValveHandle
3WayConicalValveCapV2
Screw M3 x 6 Pan Head Phillips
Washer M3
