tetrabiodistributed/project-tetra/02_Development/3WayValve/3WayOring/Rev8/V1_0_X_SAK/01_CAD_Daten/2WaySplitterAssemblyV1_0_2.SLDASM

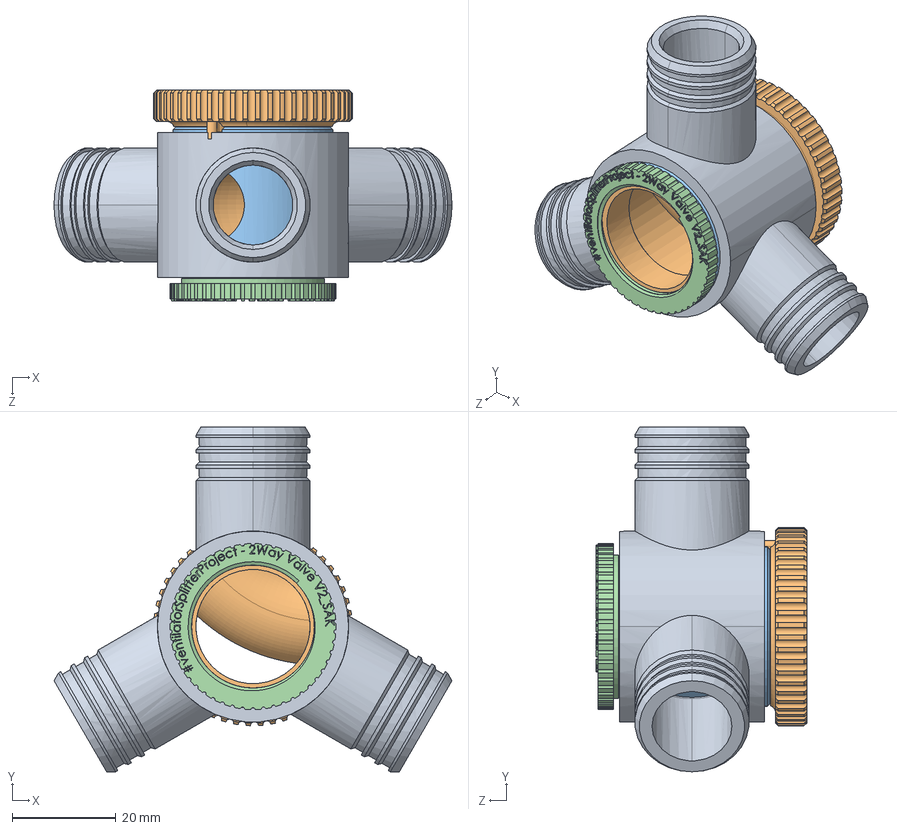
[picture p97: CAD file, 2020-04-07]
02_Development/3WayValve/3WayOring/Rev8/V1_0_X_SAK/01_CAD_Daten/2WaySplitterAssemblyV1_0_2.SLDASM
76.6 x 66.4 x 40.5 mm
ValveBodyV1_Unthreaded
ValveCock_V1_0_3_SAK
TPERing_V1_0_2_SAK
FixRingV1_0_1_SAK
