tetrabiodistributed/project-tetra/02_Development/shut_off_valve/ver5/globe_valve_005.SLDASM

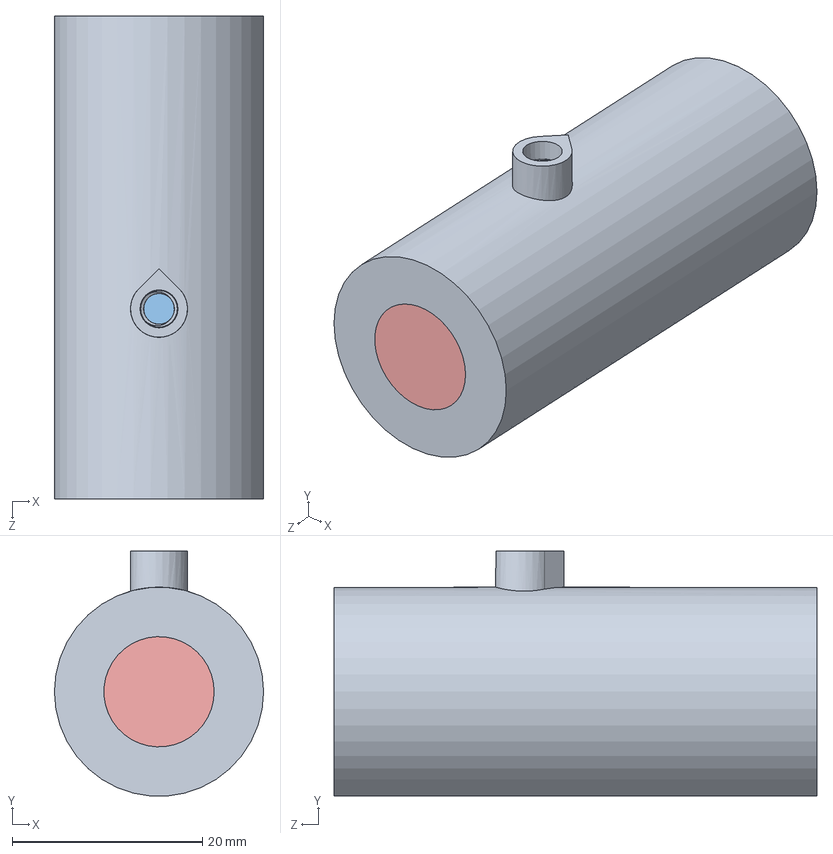
[picture p98: CAD file, 2020-04-15]
02_Development/shut_off_valve/ver5/globe_valve_005.SLDASM
22.0 x 25.8 x 50.8 mm
globe_valve_test-005
globe_valve_test-005_stopper-001
LID4
LID5
LID6
