tetrabiodistributed/project-tetra/02_Development/3WayValve/3WayOring/Rev8/V1_0_X_SAK/MoldingForm/MoldAssmably.SLDASM

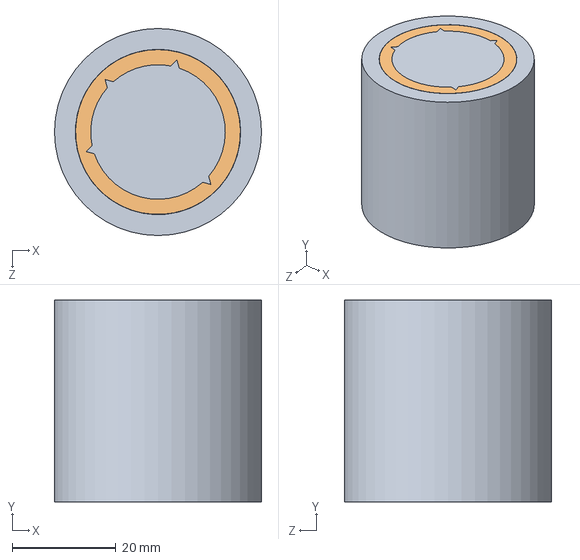
[picture p99: CAD file, 2020-03-27]
02_Development/3WayValve/3WayOring/Rev8/V1_0_X_SAK/MoldingForm/MoldAssmably.SLDASM
40.0 x 39.0 x 40.0 mm
ShellV1_0_0
TPERing_V1_0_3_MoldV_SAK
