tetrabiodistributed/project-tetra/02_Development/TetraValve/v7/SW-2018/tetra_concept-v7-4.SLDASM

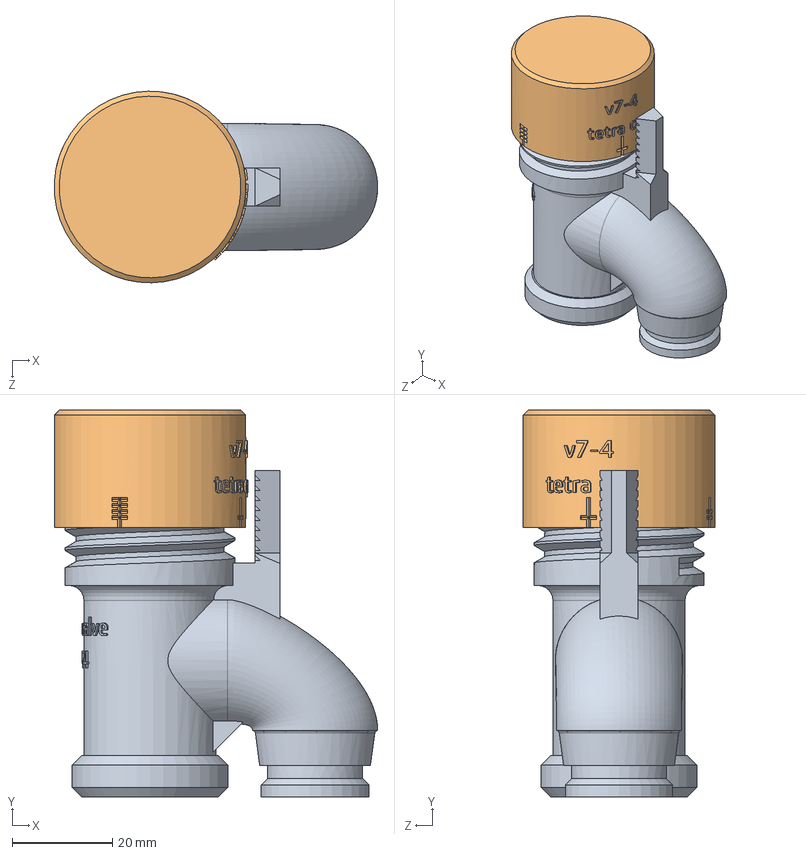
[picture p100: CAD file, 2020-07-01]
02_Development/TetraValve/v7/SW-2018/tetra_concept-v7-4.SLDASM
64.6 x 77.3 x 38.3 mm
tetra_concept-body-v7-4
tetra_cap_v7-4
