tetrabiodistributed/project-tetra/02_Development/3WayValve/3WayOring/Rev8/V1_0_X_SAK/MoldingForm/MoldAssmably02.SLDASM

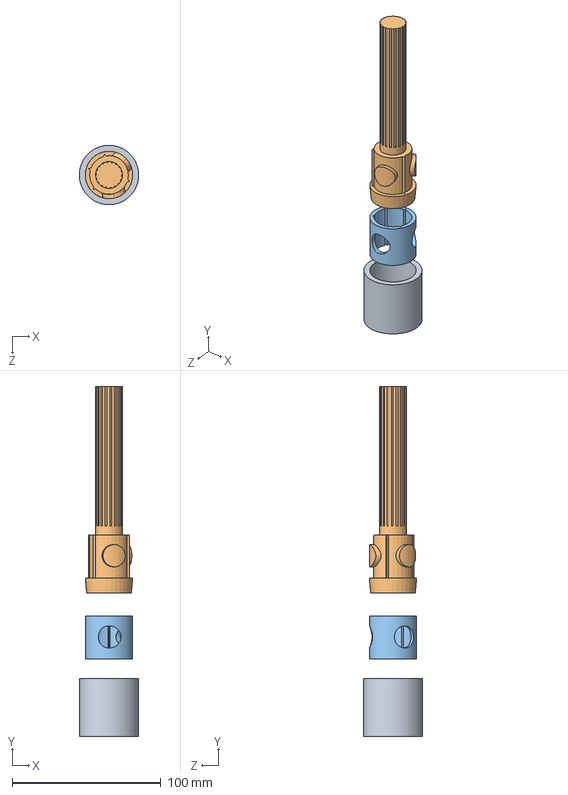
[picture p101: CAD file, 2020-03-27]
02_Development/3WayValve/3WayOring/Rev8/V1_0_X_SAK/MoldingForm/MoldAssmably02.SLDASM
40.0 x 235.7 x 40.0 mm
3WayValve_RIng_MoldPartA
3WayValve_RIng_MoldPartB
TPERing_V1_0_3_MoldV_SAK
