tetrabiodistributed/project-tetra/02_Development/CPAP Regulator/positive-ending-expiratory-pressure-valve-rev1/3D/2. Main body.STEP

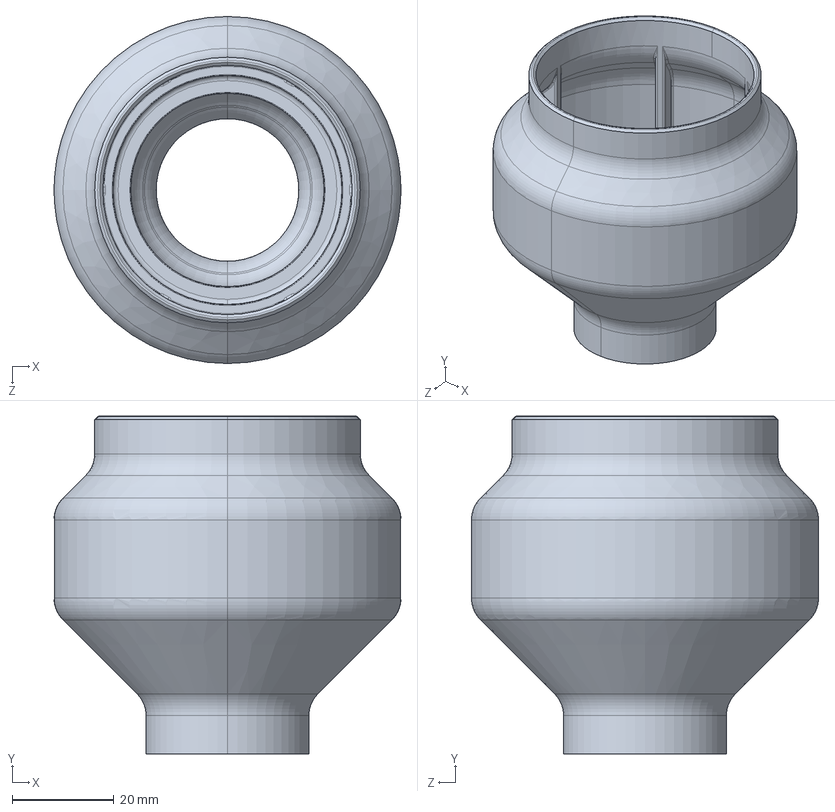
[picture p102: CAD file, 2020-03-22]
02_Development/CPAP Regulator/positive-ending-expiratory-pressure-valve-rev1/3D/2. Main body.STEP
68.1 x 66.4 x 68.2 mm
