tetrabiodistributed/project-tetra/02_Development/one way valve/Rev3 - Test Both/01_CAD_Data/OWV Assembly.STEP

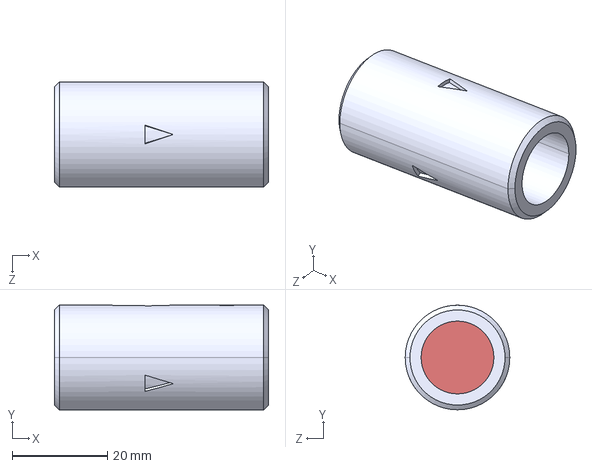
[picture p103: CAD file, 2020-03-24]
02_Development/one way valve/Rev3 - Test Both/01_CAD_Data/OWV Assembly.STEP
45.0 x 22.0 x 22.0 mm
OWV
Umbrella Silicone
