tetrabiodistributed/project-tetra/02_Development/3WayOring/Rev8_V1_0_0/V1_0_0_SAK/01_CAD_Daten/ValveCock_V1_0_1_SAK.SLDPRT

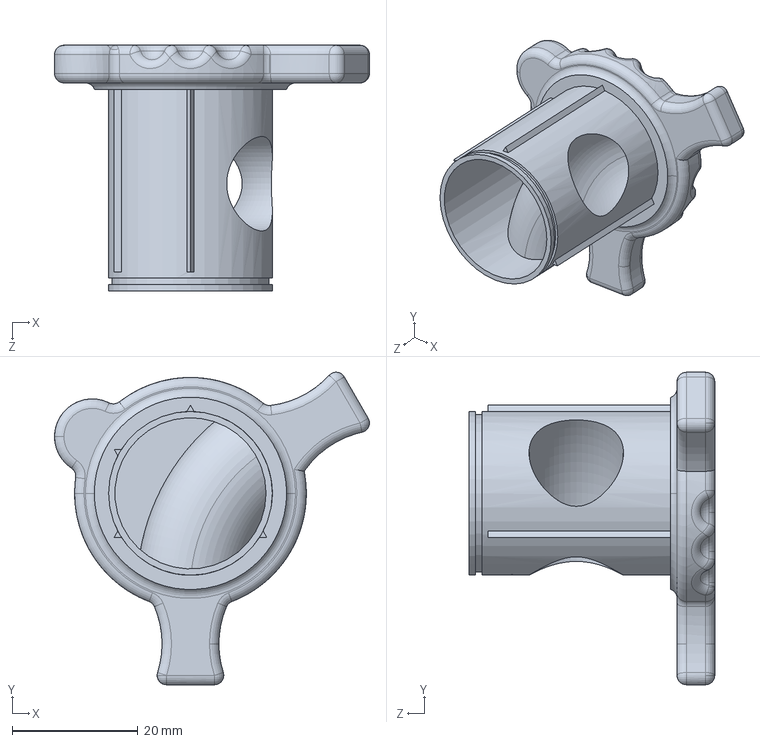
[picture p105: CAD file, 2020-03-23]
02_Development/3WayOring/Rev8_V1_0_0/V1_0_0_SAK/01_CAD_Daten/ValveCock_V1_0_1_SAK.SLDPRT
50.0 x 49.6 x 39.0 mm
