tetrabiodistributed/project-tetra/02_Development/3WayValve/3WayOring/Rev8/V1_0_X_SAK/03_Printign/UM5/UMS5_TPERing_V1_0_2_SAK.3mf

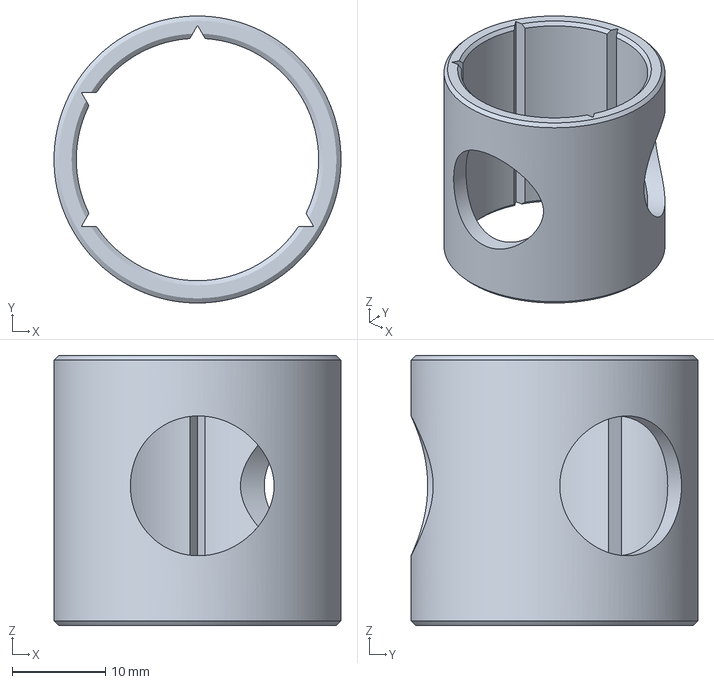
[picture p106: CAD file, 2020-03-23]
02_Development/3WayValve/3WayOring/Rev8/V1_0_X_SAK/03_Printign/UM5/UMS5_TPERing_V1_0_2_SAK.3mf
30.8 x 30.8 x 29.0 mm
