tetrabiodistributed/project-tetra/02_Development/3WayValve/3WayOring/Rev8/V1_0_X_SAK/04_STL_Files/ValveBodyV1_0_3_SAK.STL

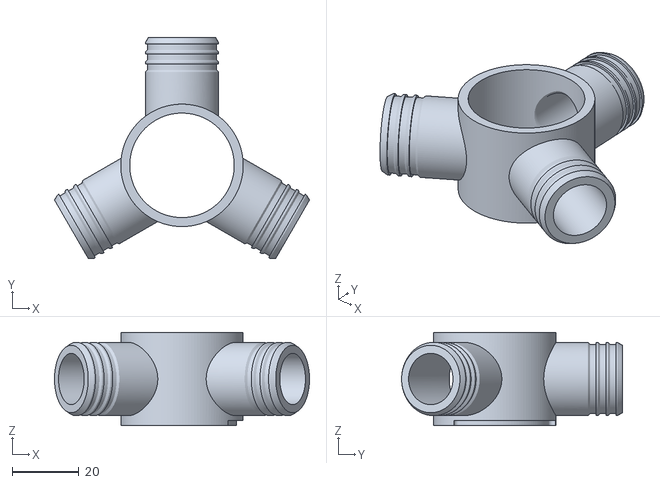
[picture p107: CAD file, 2020-04-07]
02_Development/3WayValve/3WayOring/Rev8/V1_0_X_SAK/04_STL_Files/ValveBodyV1_0_3_SAK.STL
76.6 x 66.4 x 28.0
