tetrabiodistributed/project-tetra/02_Development/3WayValve/3WayOring/Rev8/V1_0_X_SAK/MoldingForm/3WayValve_RIng_MoldPartA.sldprt

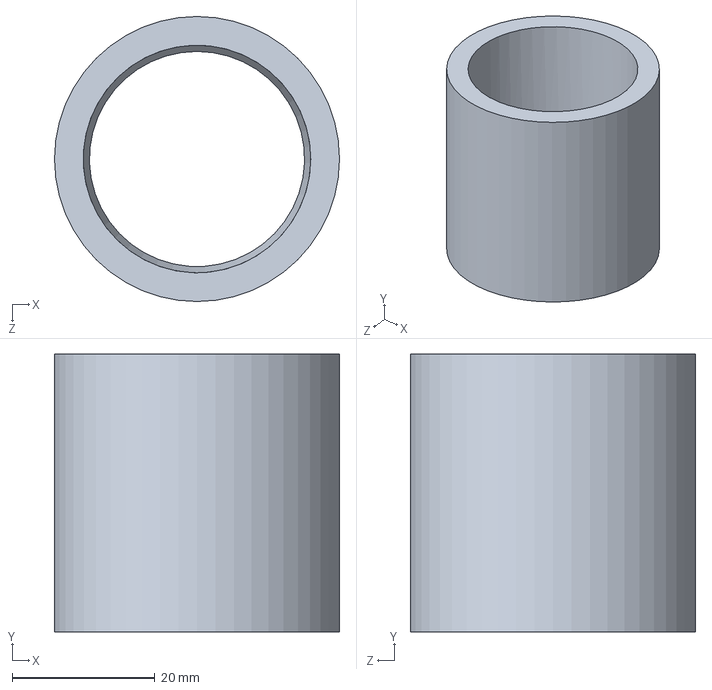
[picture p108: CAD file, 2020-03-27]
02_Development/3WayValve/3WayOring/Rev8/V1_0_X_SAK/MoldingForm/3WayValve_RIng_MoldPartA.sldprt
40.0 x 39.0 x 40.0 mm
