tetrabiodistributed/project-tetra/02_Development/CPAP Regulator/positive-ending-expiratory-pressure-valve-rev1/3D Printing/Venturi Nozzle revision 2 B=0,3.STL

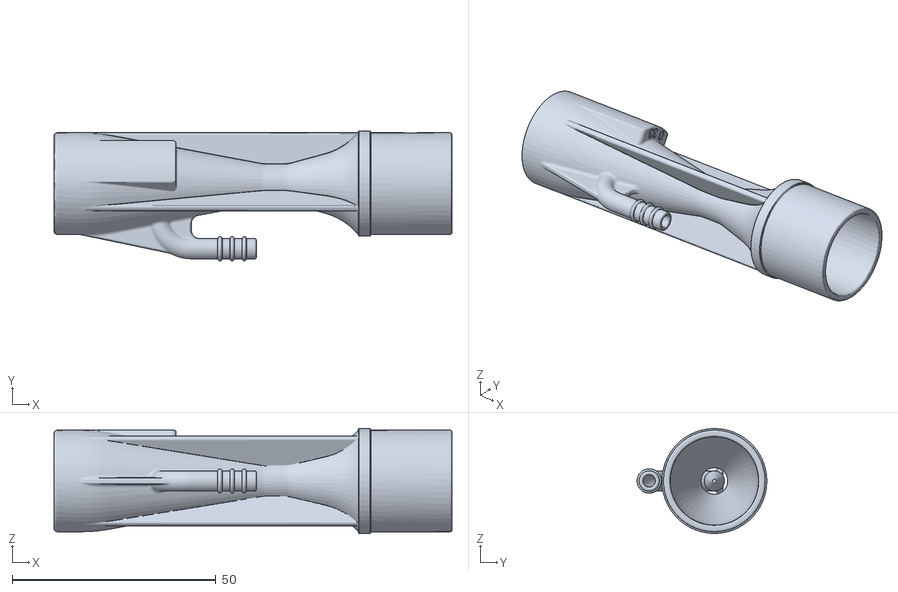
[picture p109: CAD file, 2020-03-22]
02_Development/CPAP Regulator/positive-ending-expiratory-pressure-valve-rev1/3D Printing/Venturi Nozzle revision 2 B=0,3.STL
97.8 x 31.9 x 25.8
