tetrabiodistributed/project-tetra/02_Development/CPAP Regulator/positive-ending-expiratory-pressure-valve-rev1/3D/D. Coins.SLDPRT

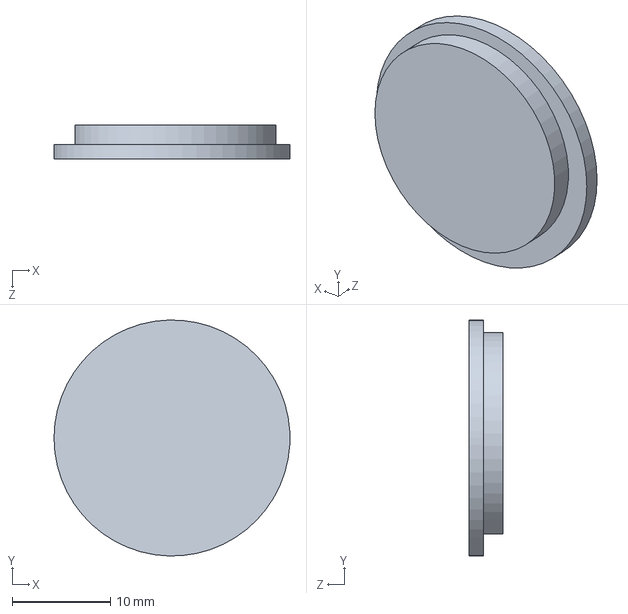
[picture p110: CAD file, 2020-03-22]
02_Development/CPAP Regulator/positive-ending-expiratory-pressure-valve-rev1/3D/D. Coins.SLDPRT
24.0 x 24.0 x 3.50 mm
