tetrabiodistributed/project-tetra/02_Development/CPAP Regulator/Venturi valve/Respirator-free reanimation Venturi's valve (rev. 4)/STEP/Respirator-free reanimation Venturi's valve (rev. 4) FiO2-37 Cap ISO 22mm.STEP

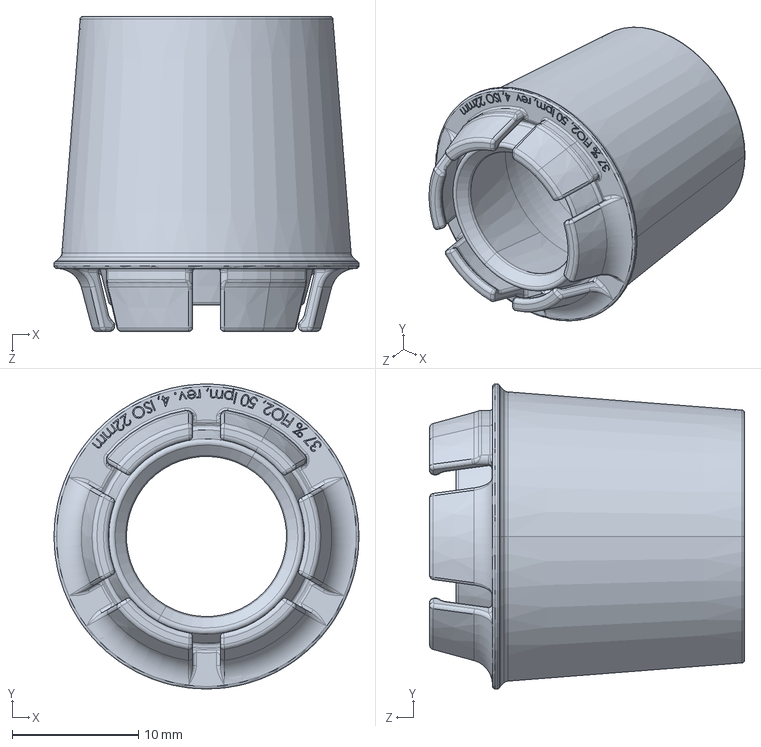
[picture p111: CAD file, 2020-03-26]
02_Development/CPAP Regulator/Venturi valve/Respirator-free reanimation Venturi's valve (rev. 4)/STEP/Respirator-free reanimation Venturi's valve (rev. 4) FiO2-37 Cap ISO 22mm.STEP
24.2 x 24.2 x 25.0 mm
