tetrabiodistributed/project-tetra/02_Development/CPAP Regulator/Venturi valve/Respirator-free reanimation Venturi's valve (rev. 4)/STL/Respirator-free reanimation Venturi's valve (rev. 4) FiO2-30 Vertical, 1-piece.STL

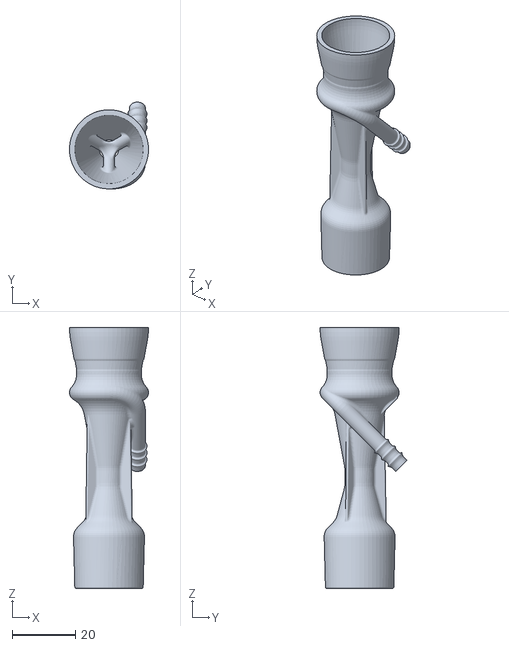
[picture p112: CAD file, 2020-03-26]
02_Development/CPAP Regulator/Venturi valve/Respirator-free reanimation Venturi's valve (rev. 4)/STL/Respirator-free reanimation Venturi's valve (rev. 4) FiO2-30 Vertical, 1-piece.STL
25.0 x 27.5 x 82.5
