tetrabiodistributed/project-tetra/02_Development/Expiratory 2 way splitter/01_CAD_Data/Expiratory 2 way splitter v2.step

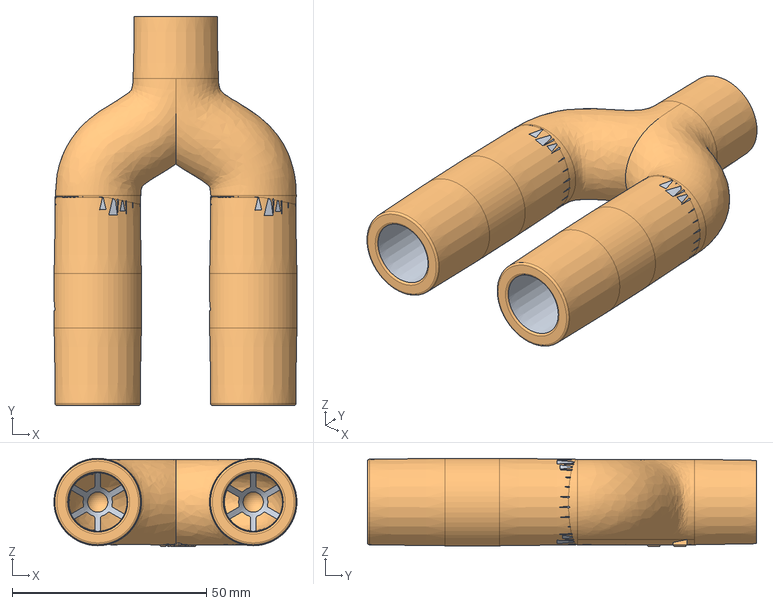
[picture p113: CAD file, 2020-04-11]
02_Development/Expiratory 2 way splitter/01_CAD_Data/Expiratory 2 way splitter v2.step
62.5 x 100.1 x 22.8 mm
OWV body Rev5 x 2
