tetrabiodistributed/project-tetra/02_Development/FlowMeter/FastTrackTidalVolMeter/PCB/Olimex POE ISO PCBA.stp

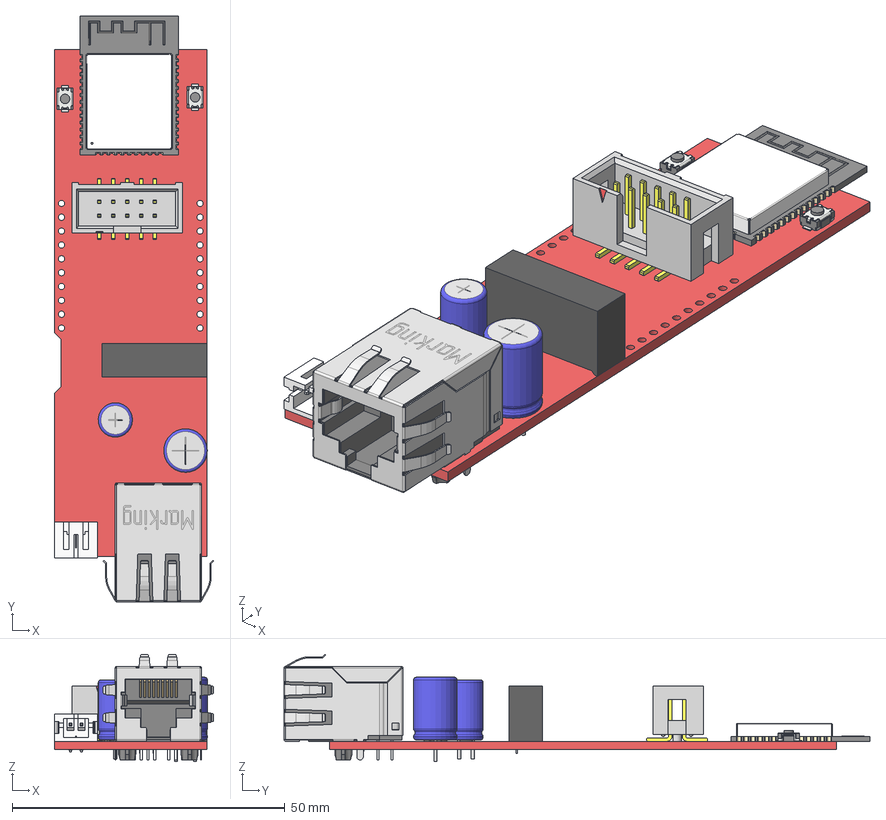
[picture p114: CAD file, 2020-03-23]
02_Development/FlowMeter/FastTrackTidalVolMeter/PCB/Olimex POE ISO PCBA.stp
29.2 x 107.4 x 19.7 mm
Olimex POE ISO PCB
Olimex POE ISO C29
Olimex POE ISO C27
insulator
shielding
ESP-WROOM-32D
Pushbutton IT1185AU2 x 2
Olimex POE ISO BAT1 JST PH 2 Pin DW02R
User Library-HTST-105-01-F-DV-A__HTST-105-01-DV-A_header
User Library-HTST-105-01-F-DV-A__HTST-First_Position_Indicator
User Library-HTST-105-01-F-DV-A__T-1S6-05-01-DV_
Olimex POE ISO DCDC1 Mornsun F0505S-2WR2
