tetrabiodistributed/project-tetra/02_Development/FlowMeter/LQFP-32-7x7.STEP

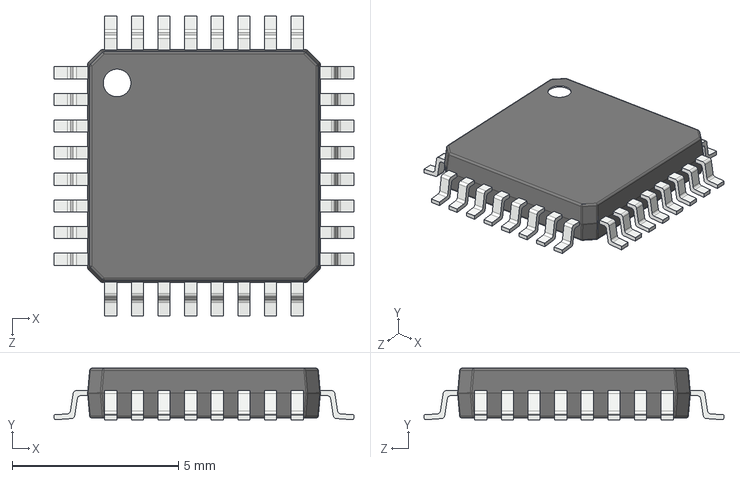
[picture p115: CAD file, 2020-03-22]
02_Development/FlowMeter/LQFP-32-7x7.STEP
9.02 x 1.55 x 9.02 mm
