tetrabiodistributed/project-tetra/02_Development/FlowMeter/RPi Board/Sensor_manifold/v2/STEP/Manifold_v2-0.STEP

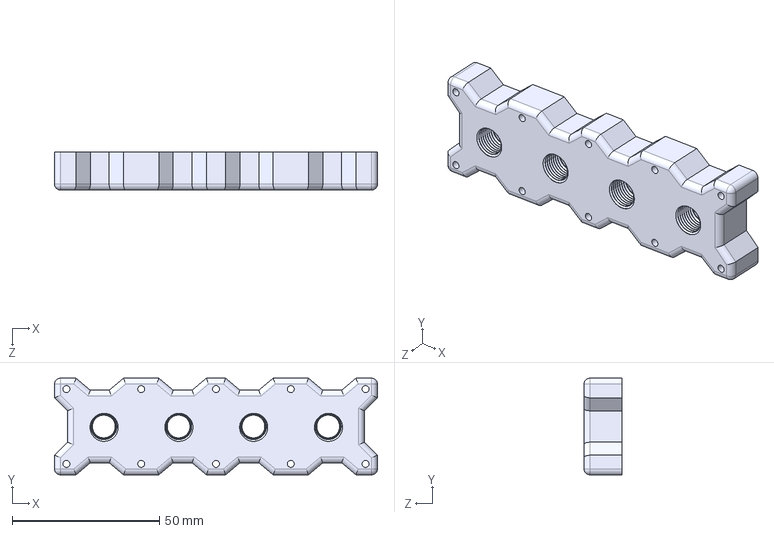
[picture p116: CAD file, 2021-01-24]
02_Development/FlowMeter/RPi Board/Sensor_manifold/v2/STEP/Manifold_v2-0.STEP
109.7 x 32.8 x 12.9 mm
