tetrabiodistributed/project-tetra/02_Development/FlowMeter/sensirion_connector_pcb/cad_step_files/connector_board.step

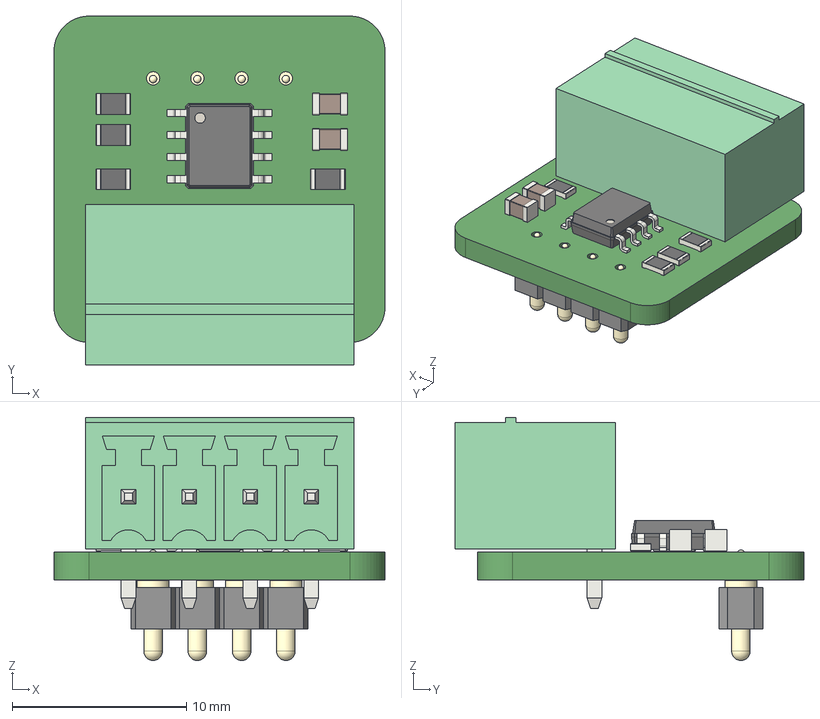
[picture p117: CAD file, 2020-08-05]
02_Development/FlowMeter/sensirion_connector_pcb/cad_step_files/connector_board.step
19.0 x 20.0 x 13.9 mm
