tetrabiodistributed/project-tetra/02_Development/Main-Splitter/00_Unthreaded_Splitters/3Way_WYE_V1.STEP

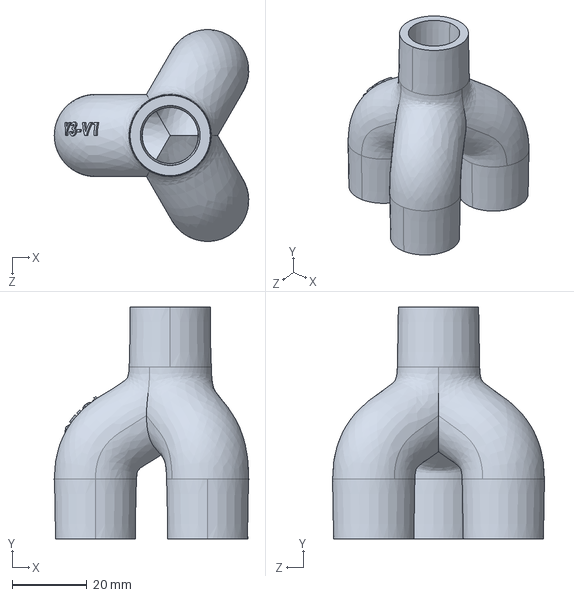
[picture p118: CAD file, 2020-04-07]
02_Development/Main-Splitter/00_Unthreaded_Splitters/3Way_WYE_V1.STEP
52.0 x 62.0 x 56.6 mm
