tetrabiodistributed/project-tetra/02_Development/Main-Splitter/01_2Way/2WayVent_3DP_v05.step

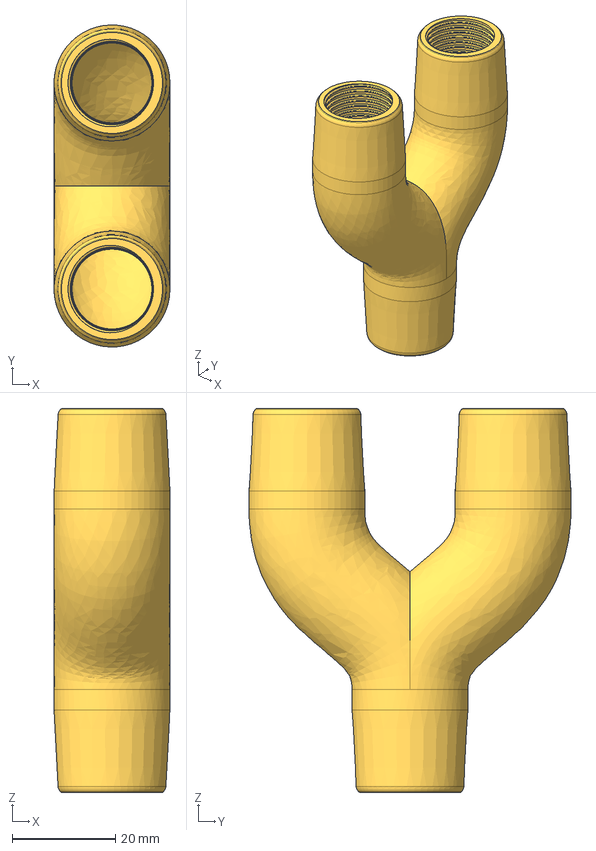
[picture p119: CAD file, 2020-03-19]
02_Development/Main-Splitter/01_2Way/2WayVent_3DP_v05.step
22.5 x 62.5 x 74.5 mm
