tetrabiodistributed/project-tetra/02_Development/Main-Splitter/02_4Way/4WayVent_3DP_v05.step

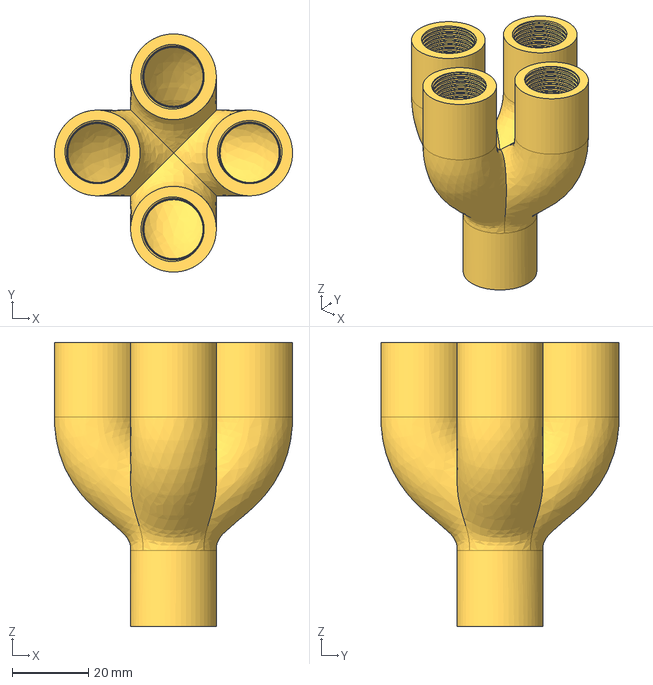
[picture p120: CAD file, 2020-03-19]
02_Development/Main-Splitter/02_4Way/4WayVent_3DP_v05.step
62.5 x 62.5 x 74.5 mm
