tetrabiodistributed/project-tetra/02_Development/Main-Splitter/03_15mm adaptor/4WayVent_3DP_v06_15 mm adapter.STEP

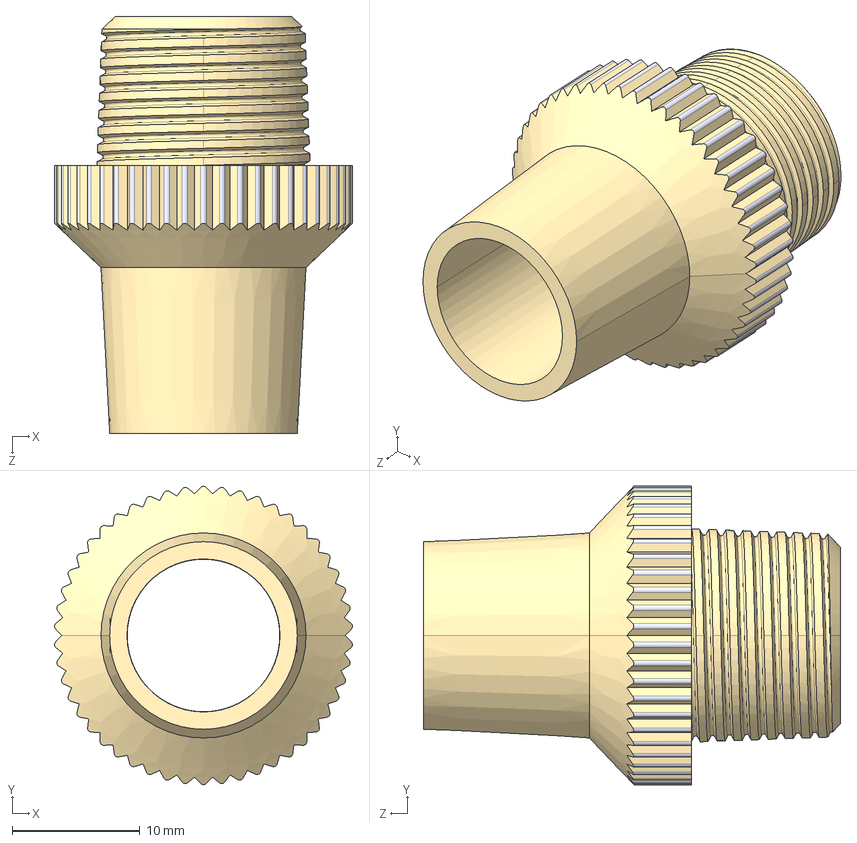
[picture p121: CAD file, 2020-03-26]
02_Development/Main-Splitter/03_15mm adaptor/4WayVent_3DP_v06_15 mm adapter.STEP
23.4 x 23.4 x 32.7 mm
