tetrabiodistributed/project-tetra/02_Development/Main-Splitter/04_Hand oprerated cap - Newer/4WayLid_HandOperated_BBC_V2_0_1.STEP

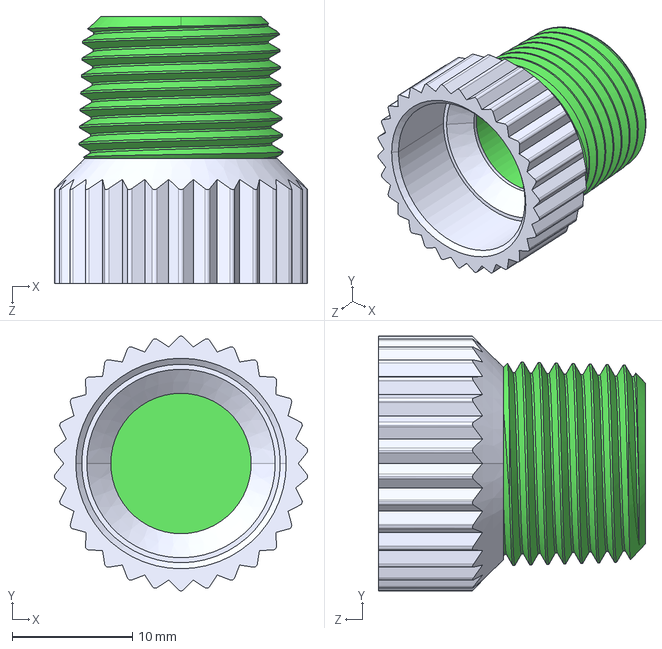
[picture p122: CAD file, 2020-03-24]
02_Development/Main-Splitter/04_Hand oprerated cap - Newer/4WayLid_HandOperated_BBC_V2_0_1.STEP
21.1 x 21.2 x 22.2 mm
