tetrabiodistributed/project-tetra/02_Development/Main-Splitter/06 Peep and Restrictor Valve/STEP/HEVS PEEP V1.stp

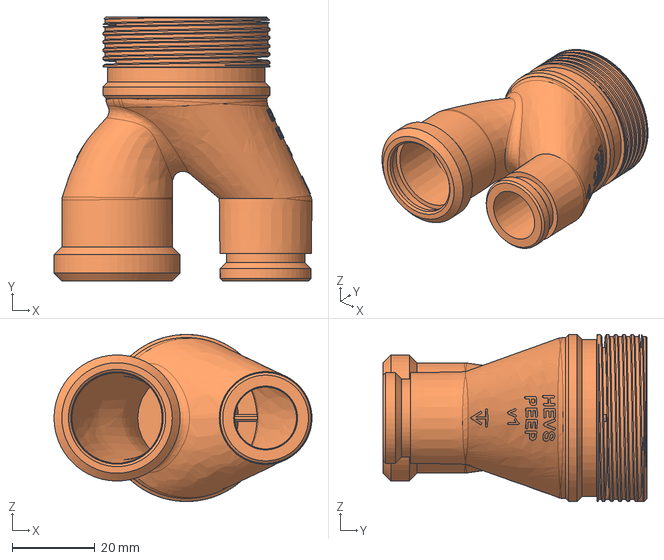
[picture p123: CAD file, 2020-04-30]
02_Development/Main-Splitter/06 Peep and Restrictor Valve/STEP/HEVS PEEP V1.stp
62.5 x 64.0 x 40.5 mm
