tetrabiodistributed/project-tetra/02_Development/Main-Splitter/BQ_parts/01-SW2018/1-5way_splitter_BQ_SW-2018.SLDPRT

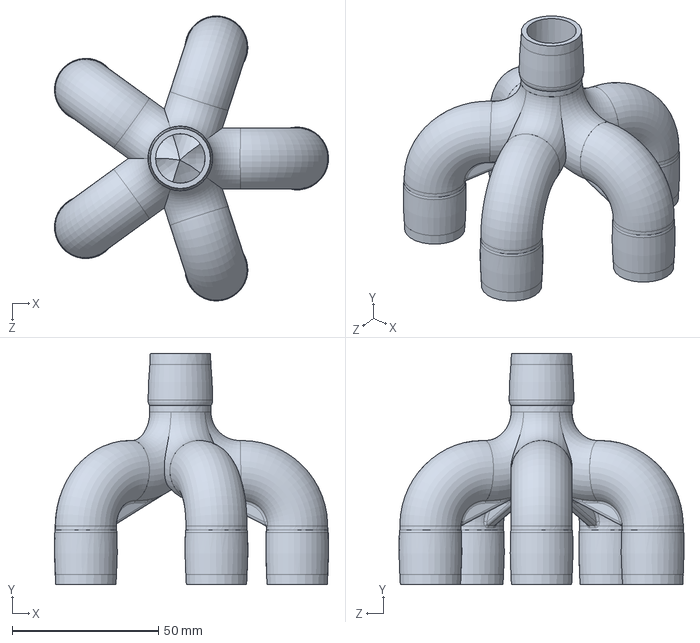
[picture p124: CAD file, 2020-06-04]
02_Development/Main-Splitter/BQ_parts/01-SW2018/1-5way_splitter_BQ_SW-2018.SLDPRT
93.9 x 79.1 x 97.6 mm
