tetrabiodistributed/project-tetra/02_Development/Male to male connector/Rev2/01_CAD_Data/male conector 3_8 NPT.STEP

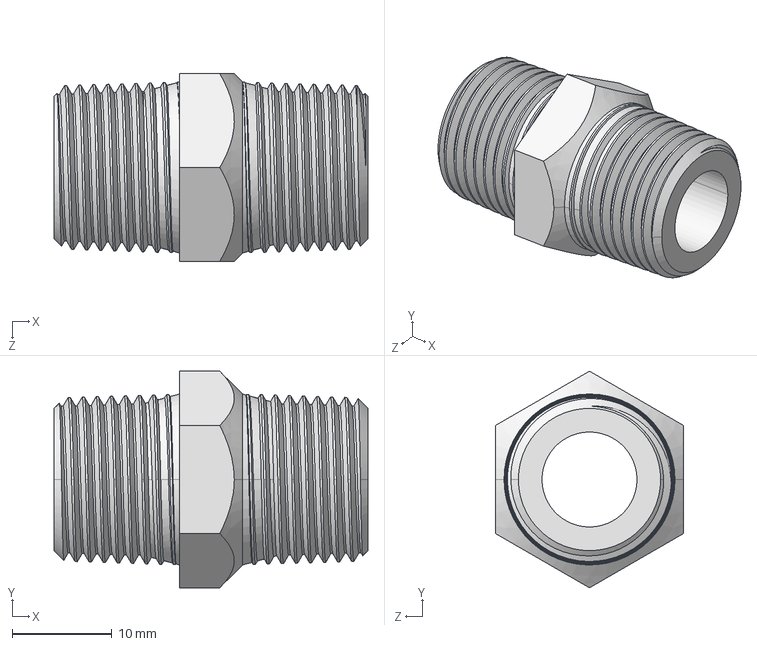
[picture p125: CAD file, 2020-03-23]
02_Development/Male to male connector/Rev2/01_CAD_Data/male conector 3_8 NPT.STEP
31.5 x 21.7 x 18.8 mm
