tetrabiodistributed/project-tetra/02_Development/one way valve/Rev2 - Use This with TPU/01_CAD_Data/TPU - Disk v1.stl

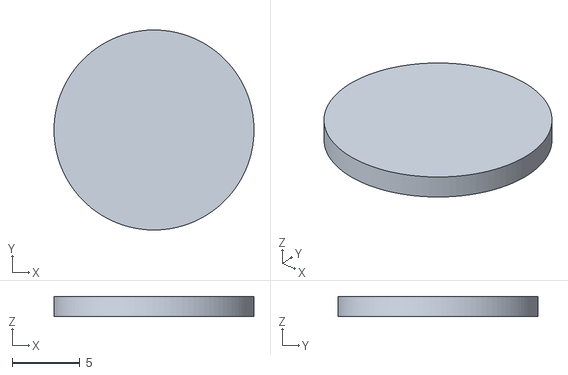
[picture p126: CAD file, 2020-03-24]
02_Development/one way valve/Rev2 - Use This with TPU/01_CAD_Data/TPU - Disk v1.stl
14.8 x 14.8 x 1.50
