tetrabiodistributed/project-tetra/02_Development/one way valve/Rev3 - Test Both/01_CAD_Data/Umbrella Silicone.STEP

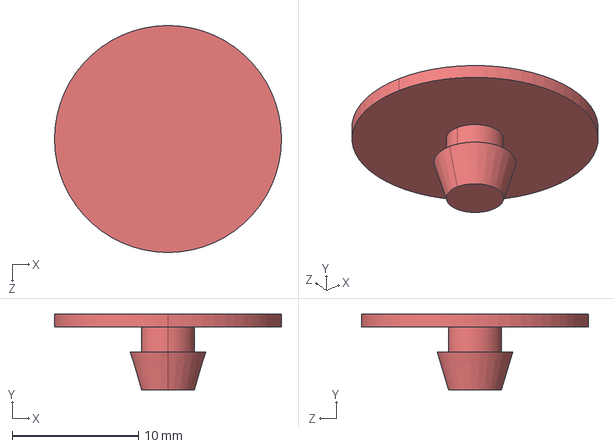
[picture p127: CAD file, 2020-03-24]
02_Development/one way valve/Rev3 - Test Both/01_CAD_Data/Umbrella Silicone.STEP
18.0 x 6.00 x 18.0 mm
