tetrabiodistributed/project-tetra/02_Development/one way valve/Rev3 - Test Both/03_STL_Files/OWV.STL

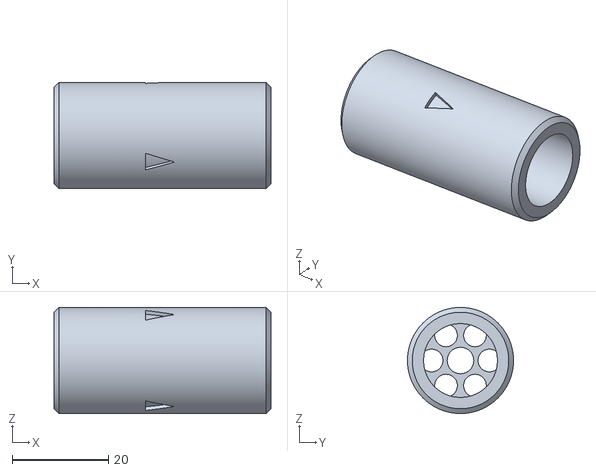
[picture p128: CAD file, 2020-03-24]
02_Development/one way valve/Rev3 - Test Both/03_STL_Files/OWV.STL
45.0 x 22.0 x 22.0
