tetrabiodistributed/project-tetra/02_Development/one way valve/Rev4 TPU use under test/03_STL_Files/one-way valve umbrella seal V3.STL

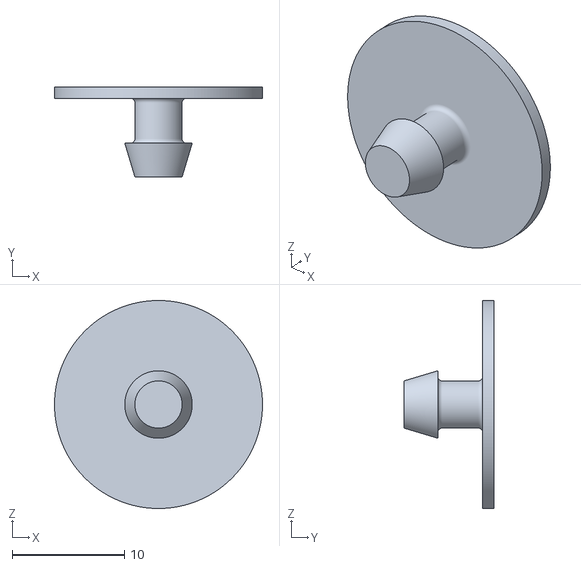
[picture p130: CAD file, 2020-03-25]
02_Development/one way valve/Rev4 TPU use under test/03_STL_Files/one-way valve umbrella seal V3.STL
18.5 x 8.00 x 18.5
