tetrabiodistributed/project-tetra/02_Development/one way valve/Rev4 TPU use under test/04_Molding_Form_Umberella/V2/BC Umbrella Mold_male.STL

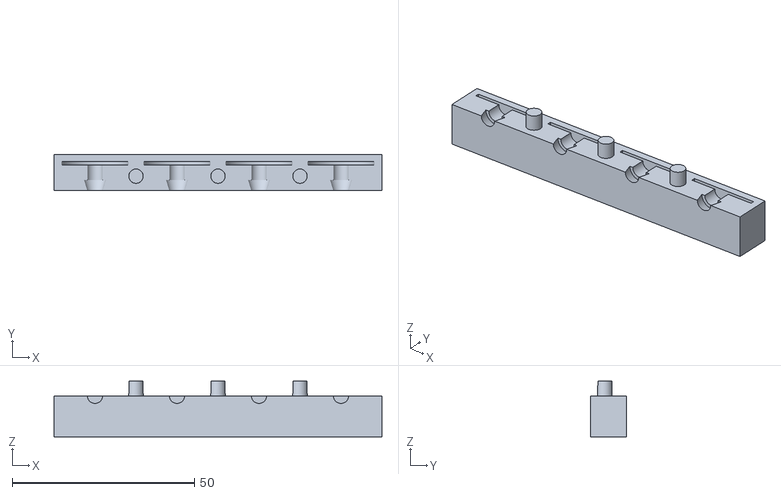
[picture p131: CAD file, 2020-04-07]
02_Development/one way valve/Rev4 TPU use under test/04_Molding_Form_Umberella/V2/BC Umbrella Mold_male.STL
90.0 x 10.0 x 15.3
