tetrabiodistributed/project-tetra/02_Development/one way valve/Rev4_Unthreaded/01_CAD_Data/Backup (1) of one-way valve body V3_Unthreaded.SLDPRT

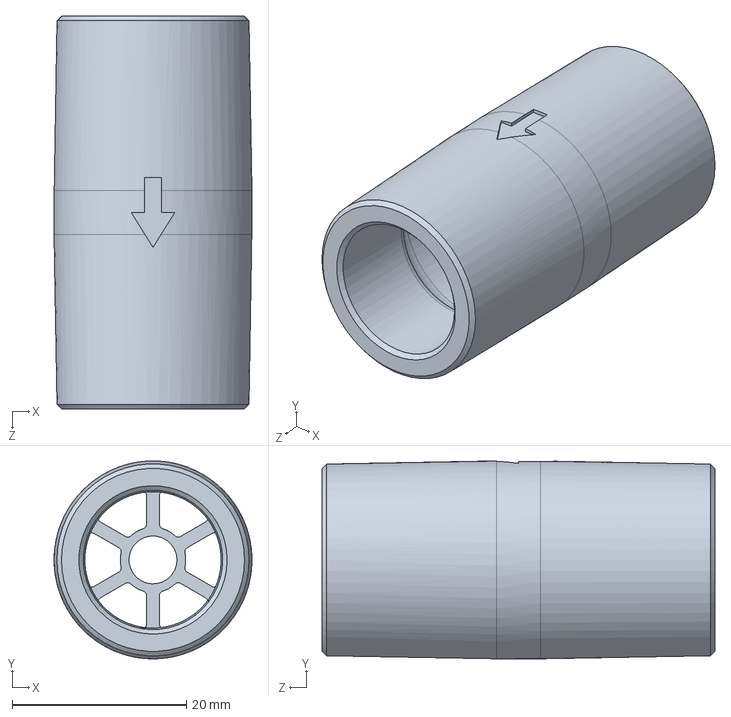
[picture p132: CAD file, 2020-04-07]
02_Development/one way valve/Rev4_Unthreaded/01_CAD_Data/Backup (1) of one-way valve body V3_Unthreaded.SLDPRT
22.7 x 22.7 x 45.0 mm
