tetrabiodistributed/project-tetra/02_Development/one way valve/Rev5/01_CAD_Data/OWV seal ReV5.STEP

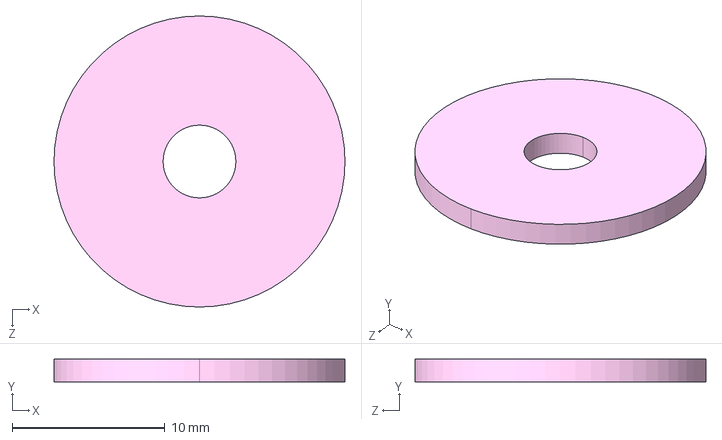
[picture p133: CAD file, 2020-04-07]
02_Development/one way valve/Rev5/01_CAD_Data/OWV seal ReV5.STEP
19.0 x 1.50 x 19.0 mm
