tetrabiodistributed/project-tetra/02_Development/one way valve/Rev5/01_CAD_Data/SW-2018/OWV_body_rev5_BQ-2018.SLDPRT

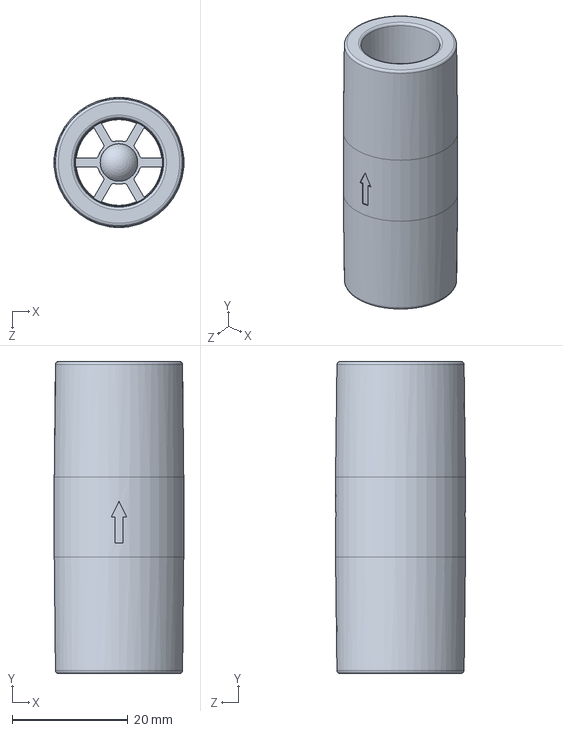
[picture p134: CAD file, 2020-04-27]
02_Development/one way valve/Rev5/01_CAD_Data/SW-2018/OWV_body_rev5_BQ-2018.SLDPRT
22.4 x 54.0 x 22.5 mm
