tetrabiodistributed/project-tetra/02_Development/one way valve/Rev5/02_Mold_files/OWV Rev5 seal Mold Female.STL

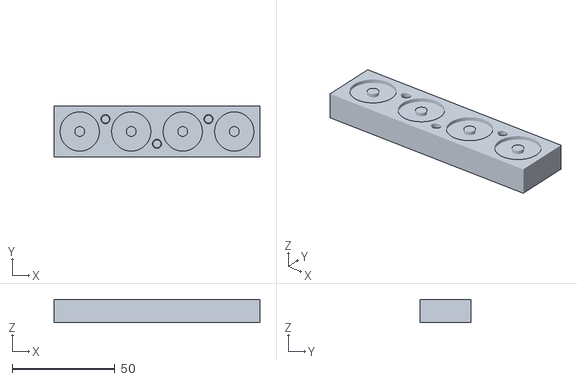
[picture p135: CAD file, 2020-04-07]
02_Development/one way valve/Rev5/02_Mold_files/OWV Rev5 seal Mold Female.STL
100.0 x 25.0 x 11.2
