tetrabiodistributed/project-tetra/02_Development/OneWayValveNew/FlapperBodyV1_0_0.SLDPRT

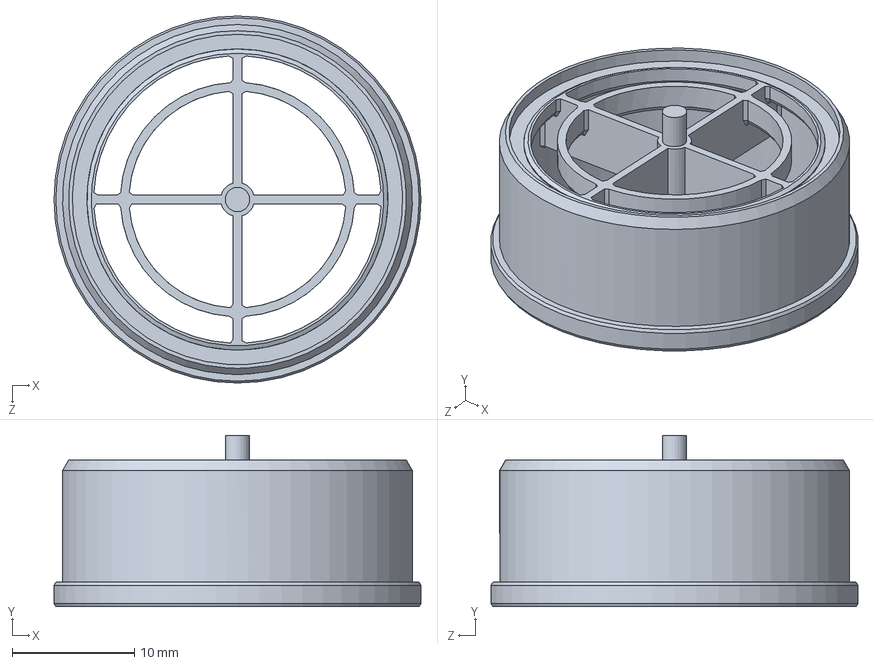
[picture p136: CAD file, 2020-04-07]
02_Development/OneWayValveNew/FlapperBodyV1_0_0.SLDPRT
30.0 x 14.0 x 30.0 mm
