tetrabiodistributed/project-tetra/02_Development/peep knob.stp

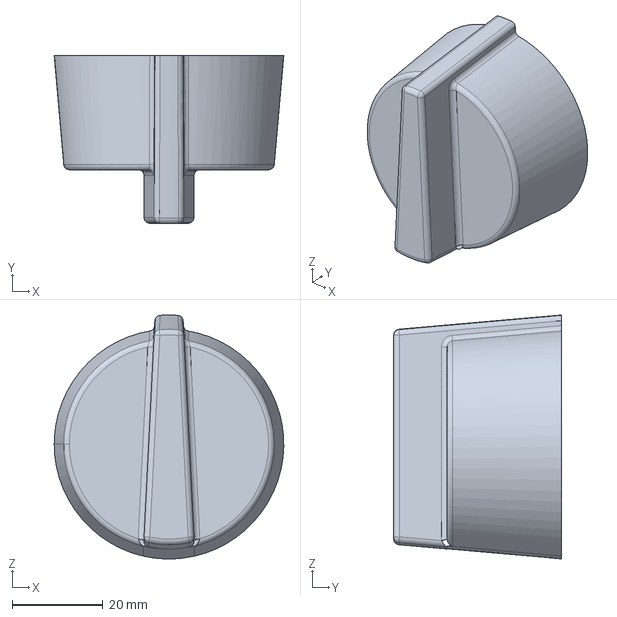
[picture p137: CAD file, 2020-05-14]
02_Development/peep knob.stp
50.6 x 36.9 x 53.8 mm
