tetrabiodistributed/project-tetra/02_Development/PEEP_valve/Hevs_Peep_Body_v2_cut-feet.STL

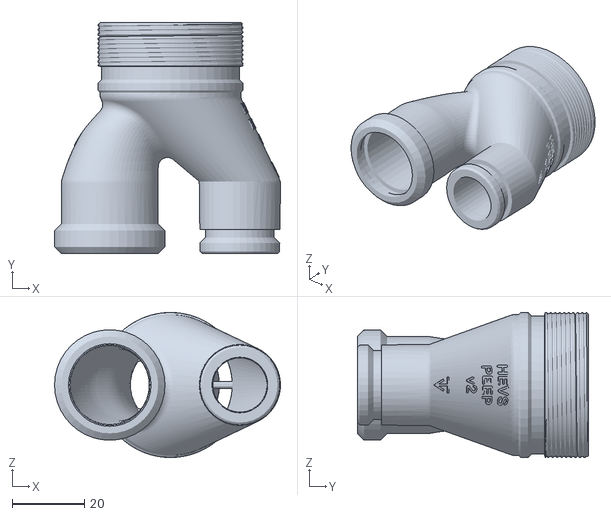
[picture p138: CAD file, 2020-05-14]
02_Development/PEEP_valve/Hevs_Peep_Body_v2_cut-feet.STL
62.5 x 64.0 x 40.1
