tetrabiodistributed/project-tetra/02_Development/Prototype_release/Alpha/For_testing/P-TET-000019-2.stl

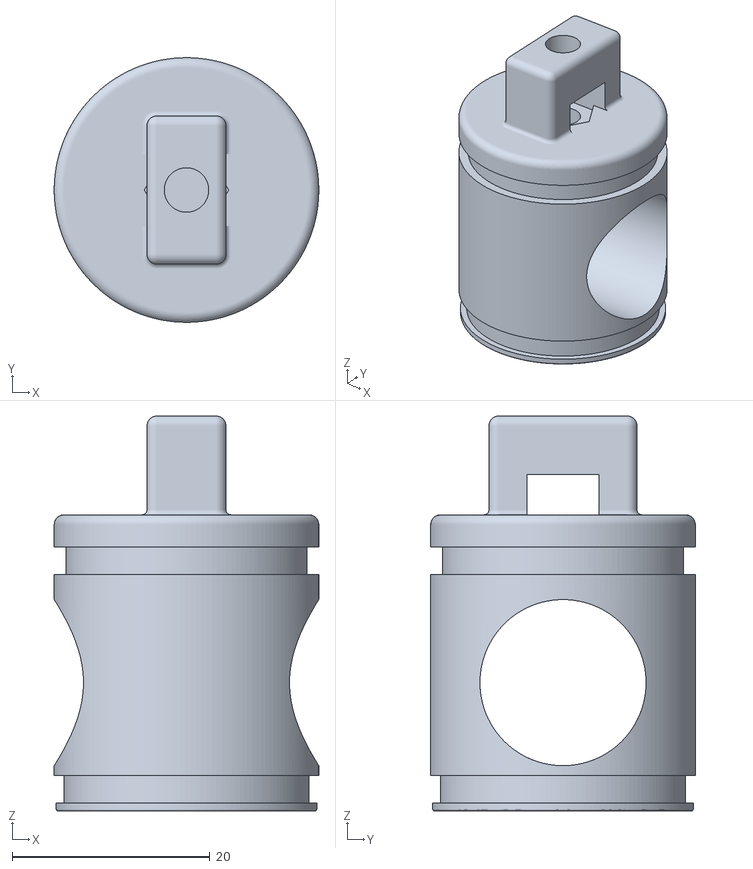
[picture p139: CAD file, 2020-07-30]
02_Development/Prototype_release/Alpha/For_testing/P-TET-000019-2.stl
26.8 x 26.8 x 40.0
