tetrabiodistributed/project-tetra/02_Development/Prototype_release/Alpha_sprint-2/STEP/A-TET-001002_RPi_complex/A-TET-001004_Tetra_PBCA/A-TET-001003_Pressure_manifold/P-TET-000008-0_Pressure_manifold-FDM.step

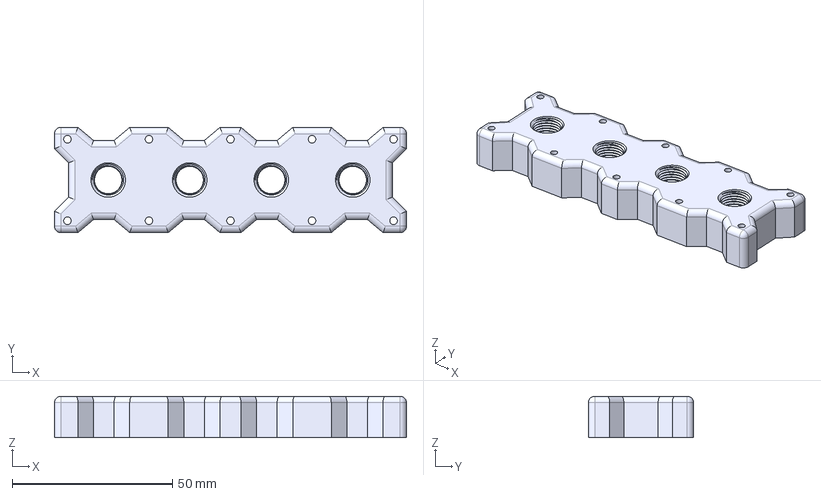
[picture p140: CAD file, 2020-09-01]
02_Development/Prototype_release/Alpha_sprint-2/STEP/A-TET-001002_RPi_complex/A-TET-001004_Tetra_PBCA/A-TET-001003_Pressure_manifold/P-TET-000008-0_Pressure_manifold-FDM.step
109.7 x 32.8 x 12.9 mm
