tetrabiodistributed/project-tetra/02_Development/Prototype_release/Alpha_sprint-2/STEP/A-TET-001002_RPi_complex/A-TET-001004_Tetra_PBCA/P-TET-000004-1_RPi_display_frame.step

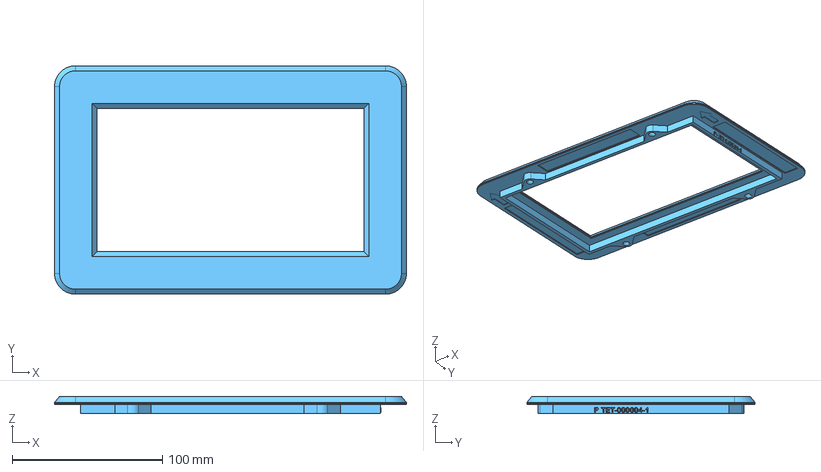
[picture p141: CAD file, 2020-09-01]
02_Development/Prototype_release/Alpha_sprint-2/STEP/A-TET-001002_RPi_complex/A-TET-001004_Tetra_PBCA/P-TET-000004-1_RPi_display_frame.step
234.3 x 152.0 x 11.5 mm
