tetrabiodistributed/project-tetra/02_Development/Prototype_release/Alpha_sprint-2/STEP/A-TET-001002_RPi_complex/P-TET-000017-1_RPi_display_bracket.step

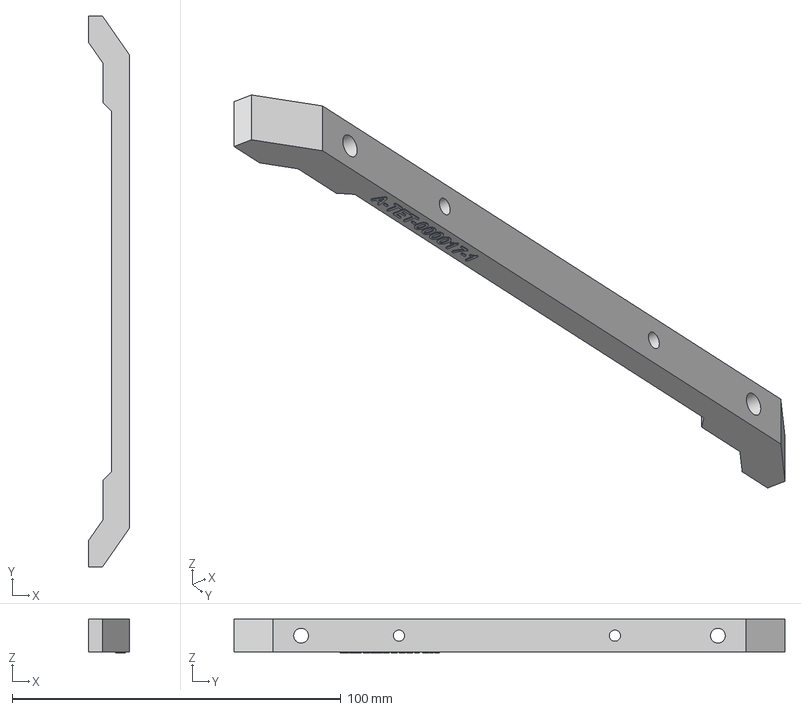
[picture p142: CAD file, 2020-09-01]
02_Development/Prototype_release/Alpha_sprint-2/STEP/A-TET-001002_RPi_complex/P-TET-000017-1_RPi_display_bracket.step
12.5 x 167.5 x 10.2 mm
