tetrabiodistributed/project-tetra/02_Development/Prototype_release/Alpha_sprint-2/STEP/A-TET-001007_Tetra_enclosure/P-TET-000016-1_Enclosure_corner-right.step

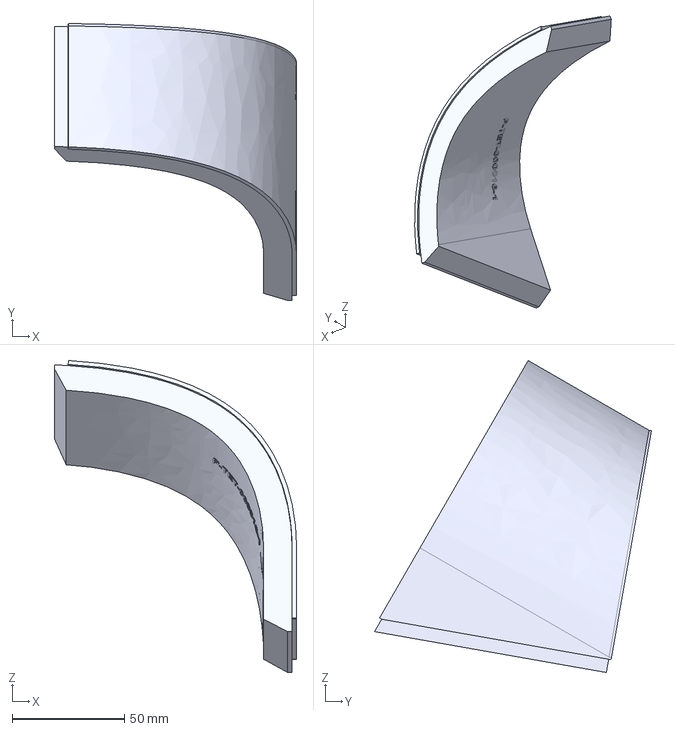
[picture p143: CAD file, 2020-09-01]
02_Development/Prototype_release/Alpha_sprint-2/STEP/A-TET-001007_Tetra_enclosure/P-TET-000016-1_Enclosure_corner-right.step
108.0 x 123.5 x 139.1 mm
