tetrabiodistributed/project-tetra/02_Development/Prototype_release/Alpha_sprint-2/STEP/A-TET-001007_Tetra_enclosure/Sheet_metal/Flat_patterns/Tetra-Flat-Pattern_Base_panel.dxf

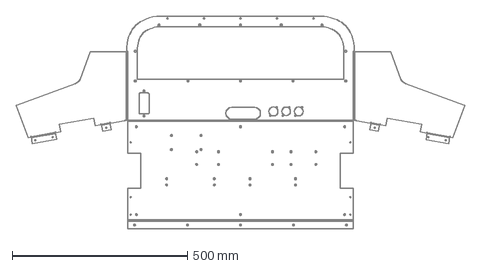
[picture p144: CAD file, 2020-09-01]
02_Development/Prototype_release/Alpha_sprint-2/STEP/A-TET-001007_Tetra_enclosure/Sheet_metal/Flat_patterns/Tetra-Flat-Pattern_Base_panel.dxf
1278.4 x 606.9 mm
