tetrabiodistributed/project-tetra/02_Development/Prototype_release/Alpha_sprint-2/STEP/A-TET-001007_Tetra_enclosure/Sheet_metal/Tetra-Front_cover_panel.step

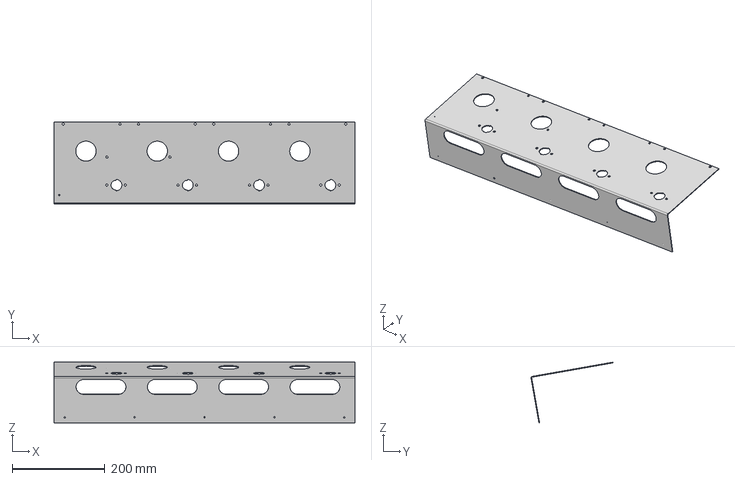
[picture p145: CAD file, 2020-09-01]
02_Development/Prototype_release/Alpha_sprint-2/STEP/A-TET-001007_Tetra_enclosure/Sheet_metal/Tetra-Front_cover_panel.step
650.0 x 177.1 x 131.0 mm
