tetrabiodistributed/project-tetra/02_Development/Prototype_release/Alpha_sprint-2/STEP/A-TET-001013_Tetra_inspiratory_and_expiratory_complex/P-TET-000002-0_Large-T.step

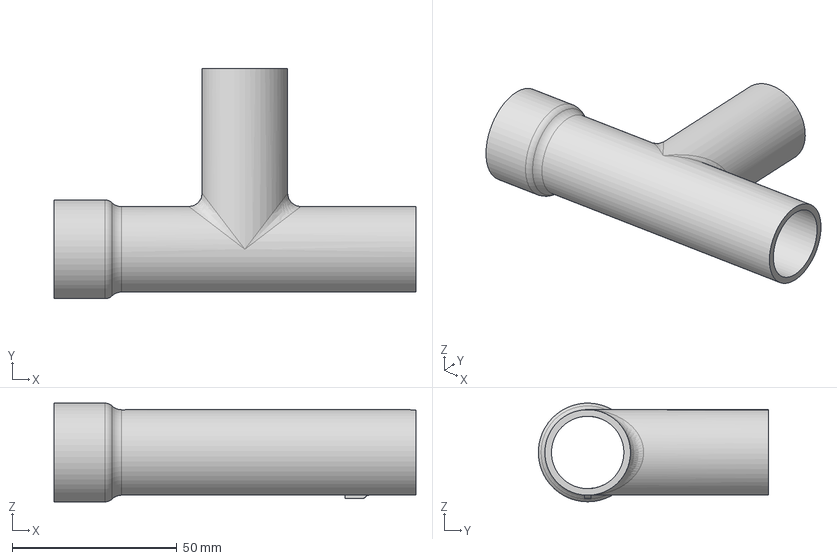
[picture p146: CAD file, 2020-09-01]
02_Development/Prototype_release/Alpha_sprint-2/STEP/A-TET-001013_Tetra_inspiratory_and_expiratory_complex/P-TET-000002-0_Large-T.step
110.0 x 70.0 x 30.0 mm
