tetrabiodistributed/project-tetra/02_Development/Prototype_release/Alpha_sprint-2/STEP/A-TET-001015_Standalone_shutoff_valve/P-TET-000018-2_Shutoff_valve_body.step

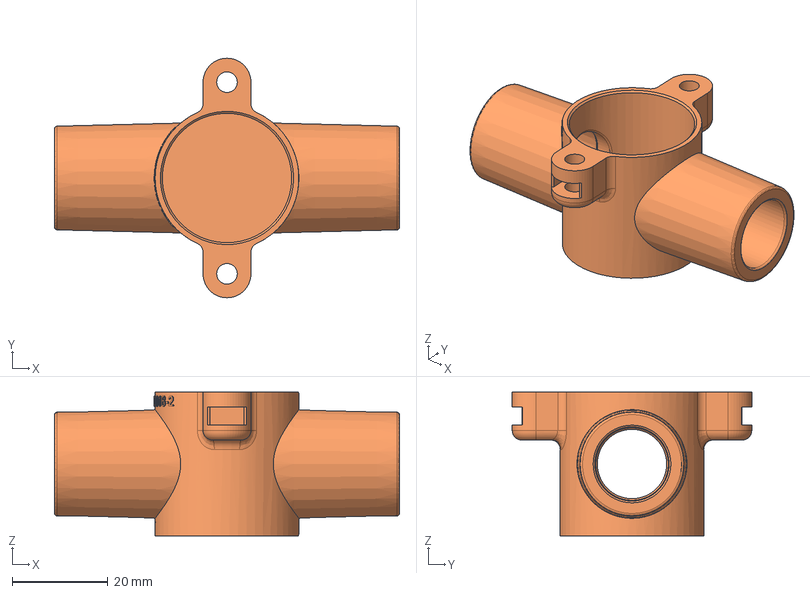
[picture p148: CAD file, 2020-09-01]
02_Development/Prototype_release/Alpha_sprint-2/STEP/A-TET-001015_Standalone_shutoff_valve/P-TET-000018-2_Shutoff_valve_body.step
72.0 x 50.0 x 30.0 mm
