tetrabiodistributed/project-tetra/02_Development/Prototype_release/Alpha_sprint-2/STEP/A-TET-001016_Bias_complex/P-TET-000025-1.step

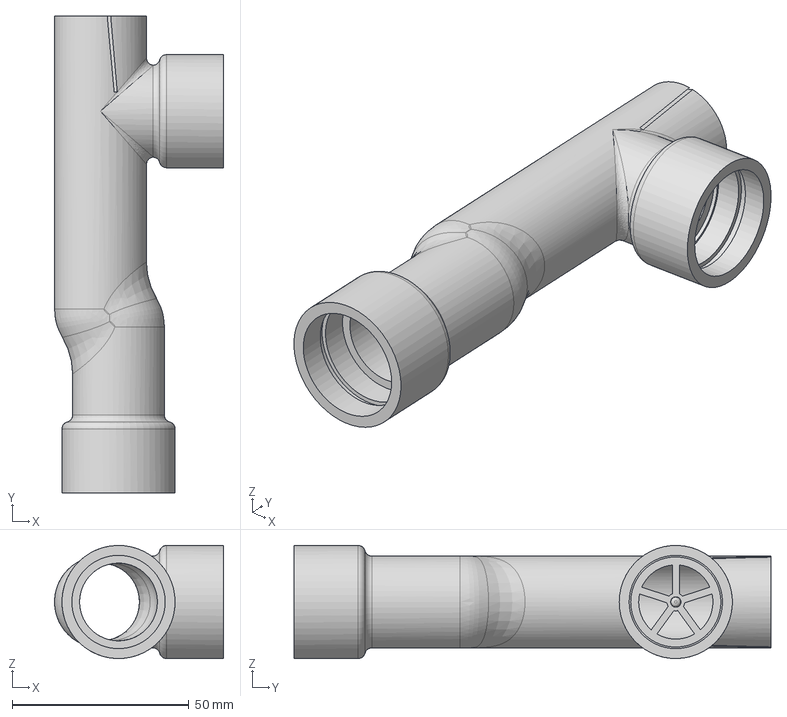
[picture p149: CAD file, 2020-09-01]
02_Development/Prototype_release/Alpha_sprint-2/STEP/A-TET-001016_Bias_complex/P-TET-000025-1.step
47.8 x 134.9 x 32.0 mm
