tetrabiodistributed/project-tetra/02_Development/Prototype_release/Alpha_sprint-2/STEP/A-TET-001019_ISO_Adapter/P-TET-000006-1.step

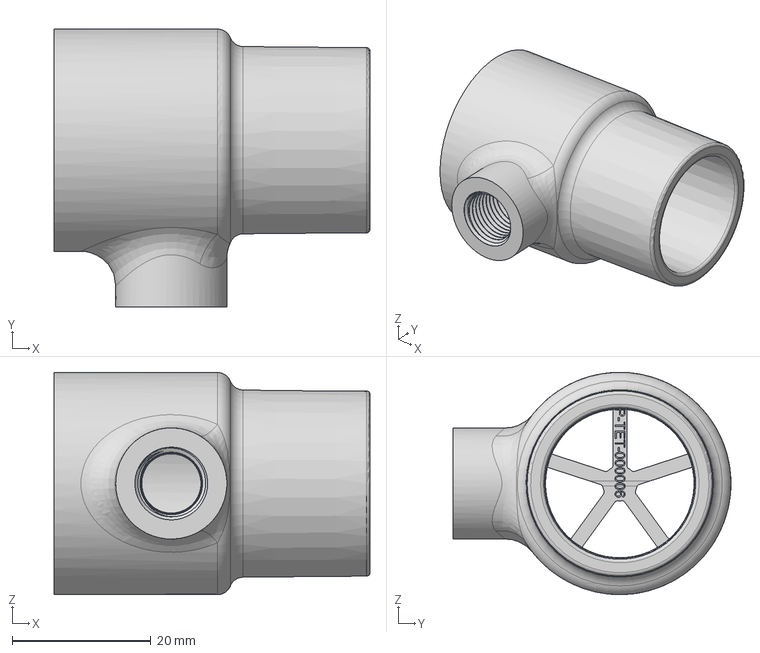
[picture p150: CAD file, 2020-09-01]
02_Development/Prototype_release/Alpha_sprint-2/STEP/A-TET-001019_ISO_Adapter/P-TET-000006-1.step
45.5 x 40.0 x 32.0 mm
