tetrabiodistributed/project-tetra/02_Development/Prototype_release/Alpha_sprint-2/STEP/A-TET-001020_Inspiratory_support_mounts/P-TET-000011-0_Inspiratory_mount_support_upper.step

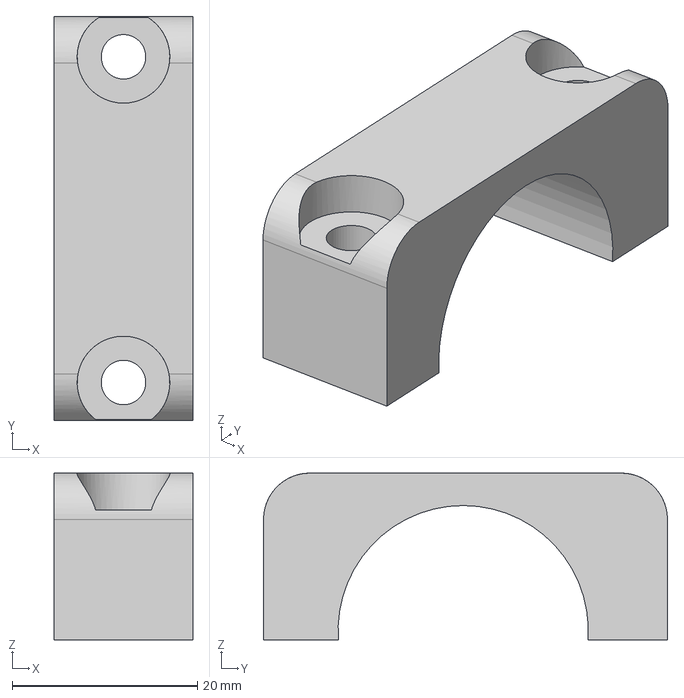
[picture p151: CAD file, 2020-09-01]
02_Development/Prototype_release/Alpha_sprint-2/STEP/A-TET-001020_Inspiratory_support_mounts/P-TET-000011-0_Inspiratory_mount_support_upper.step
15.0 x 43.6 x 18.0 mm
