tetrabiodistributed/project-tetra/02_Development/Prototype_release/Alpha_sprint-2/STEP/A-TET-001030_Tetra_valve/A-TET-001018_Tetra_Valave_knob_and_core/P-TET-000031-0_Tetra_valve_knob.step

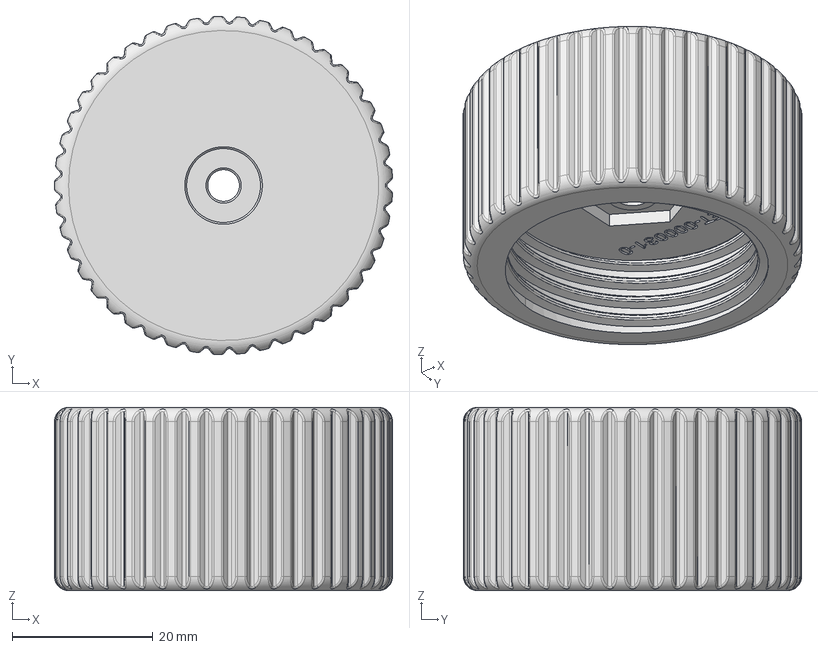
[picture p152: CAD file, 2020-09-01]
02_Development/Prototype_release/Alpha_sprint-2/STEP/A-TET-001030_Tetra_valve/A-TET-001018_Tetra_Valave_knob_and_core/P-TET-000031-0_Tetra_valve_knob.step
48.0 x 48.0 x 26.0 mm
