tetrabiodistributed/project-tetra/02_Development/Prototype_release/Alpha_sprint-2/STEP/A-TET-001030_Tetra_valve/P-TET-000028-1_Tetra_valve_body.step

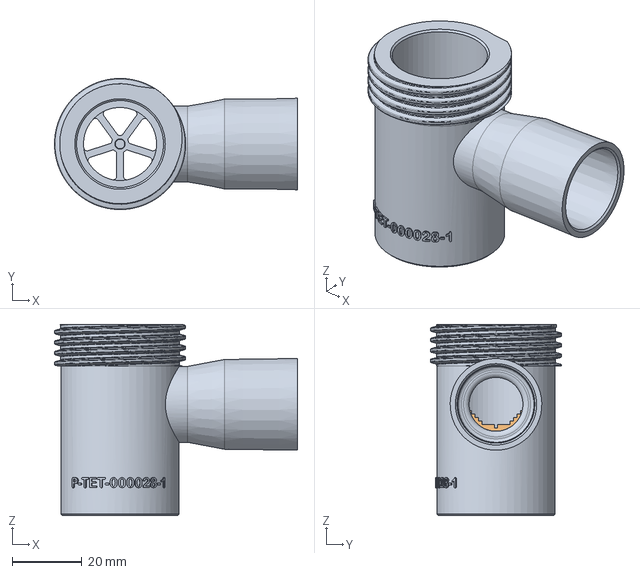
[picture p153: CAD file, 2020-09-01]
02_Development/Prototype_release/Alpha_sprint-2/STEP/A-TET-001030_Tetra_valve/P-TET-000028-1_Tetra_valve_body.step
69.8 x 37.7 x 55.0 mm
