tetrabiodistributed/project-tetra/02_Development/Prototype_release/Alpha_sprint-2/STL/A-TET-001007_Tetra_enclosure/P-TET-000007-0_Radial_panel_joint/P-TET-000007B-0_Radial_panel_joint.stl

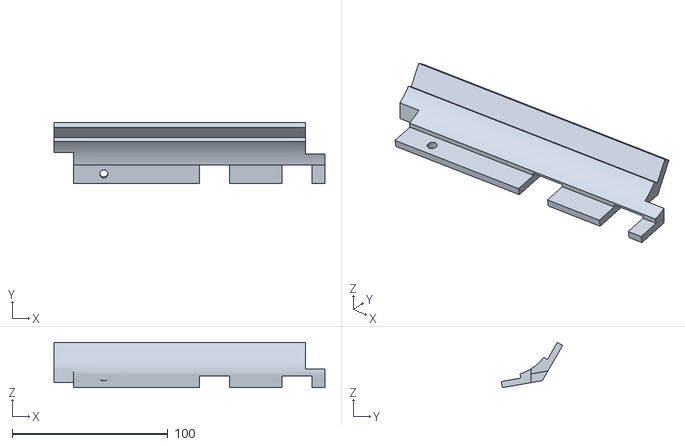
[picture p154: CAD file, 2020-09-01]
02_Development/Prototype_release/Alpha_sprint-2/STL/A-TET-001007_Tetra_enclosure/P-TET-000007-0_Radial_panel_joint/P-TET-000007B-0_Radial_panel_joint.stl
174.0 x 39.4 x 29.1
