tetrabiodistributed/project-tetra/02_Development/Prototype_release/Alpha_sprint-2/STL/A-TET-001016_Bias_complex/P-TET-000026-1/P-TET-000026-1B.stl

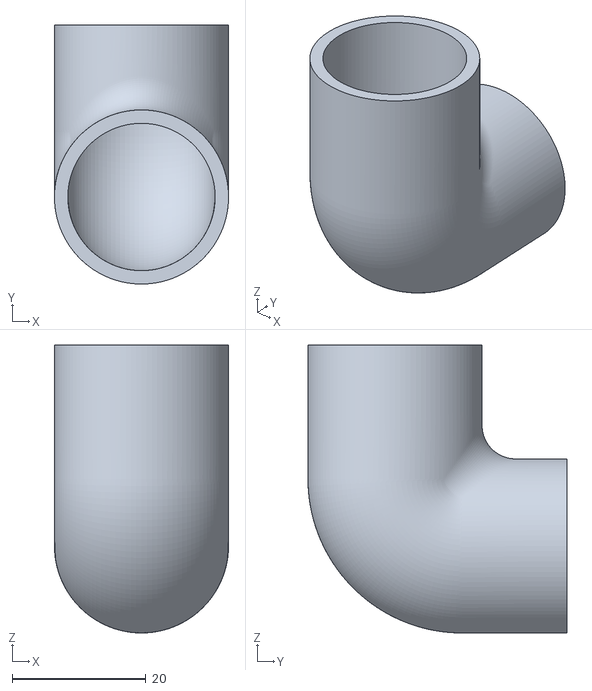
[picture p155: CAD file, 2020-09-01]
02_Development/Prototype_release/Alpha_sprint-2/STL/A-TET-001016_Bias_complex/P-TET-000026-1/P-TET-000026-1B.stl
26.0 x 38.7 x 43.0
