tetrabiodistributed/project-tetra/02_Development/Prototype_release/Beta_P1/P-TET-000006-2.stl

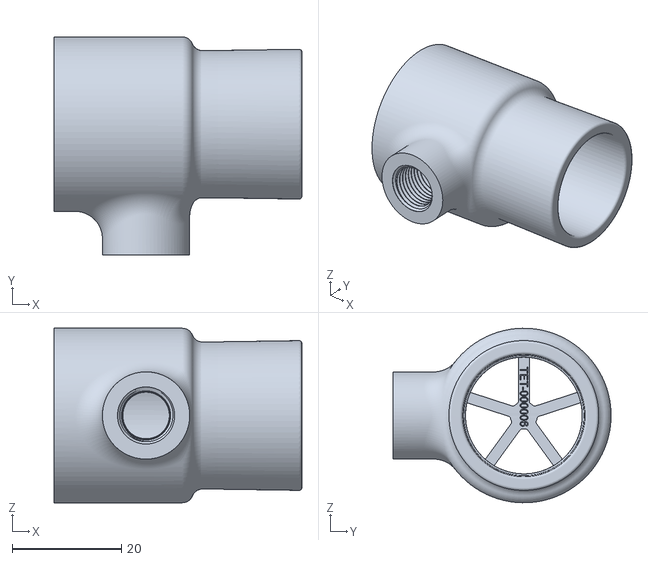
[picture p156: CAD file, 2020-11-24]
02_Development/Prototype_release/Beta_P1/P-TET-000006-2.stl
45.5 x 40.0 x 32.0
