tetrabiodistributed/project-tetra/02_Development/Push_Fit_Design/P-TET-000126-0.step

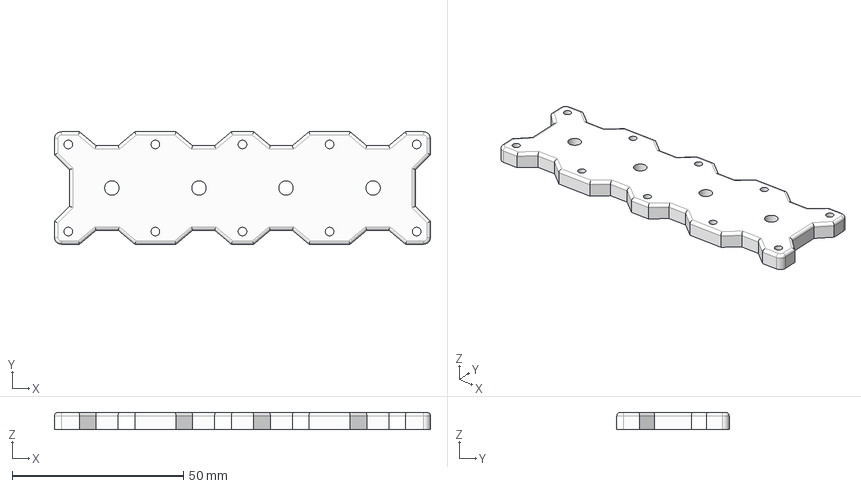
[picture p157: CAD file, 2021-03-06]
02_Development/Push_Fit_Design/P-TET-000126-0.step
109.7 x 32.8 x 5.00 mm
