tetrabiodistributed/project-tetra/02_Development/PVCManifold/Valve Lower Mount v1.stp

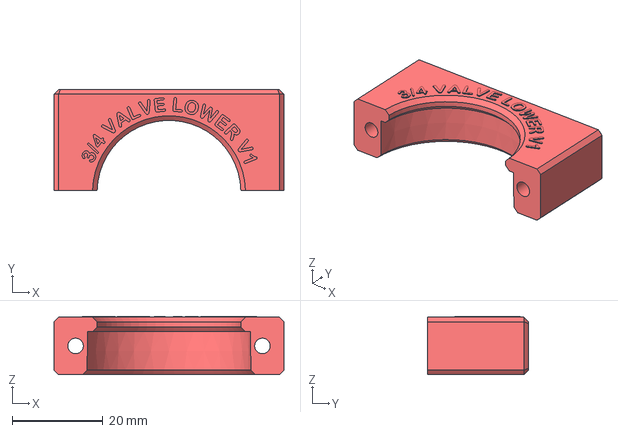
[picture p158: CAD file, 2020-04-08]
02_Development/PVCManifold/Valve Lower Mount v1.stp
50.8 x 22.4 x 12.9 mm
