tetrabiodistributed/project-tetra/02_Development/shut_off_valve/ver5/globe_valve_test-005_stopper-002.STEP

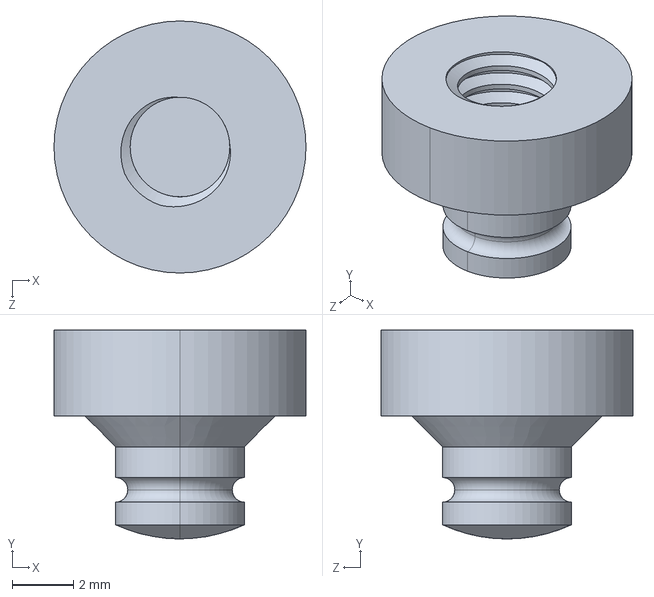
[picture p159: CAD file, 2020-04-15]
02_Development/shut_off_valve/ver5/globe_valve_test-005_stopper-002.STEP
8.20 x 6.80 x 8.20 mm
