tetrabiodistributed/project-tetra/02_Development/TetraValve/CAD/PEEP_valve_head_v3.STEP

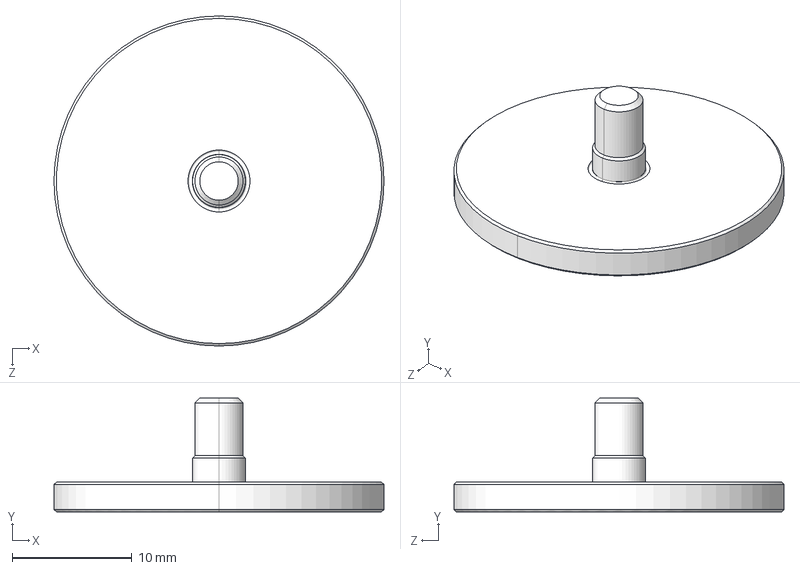
[picture p160: CAD file, 2020-05-21]
02_Development/TetraValve/CAD/PEEP_valve_head_v3.STEP
27.5 x 9.50 x 27.5 mm
