tetrabiodistributed/project-tetra/02_Development/TetraValve/STEP/TetraValveHead v3.stp

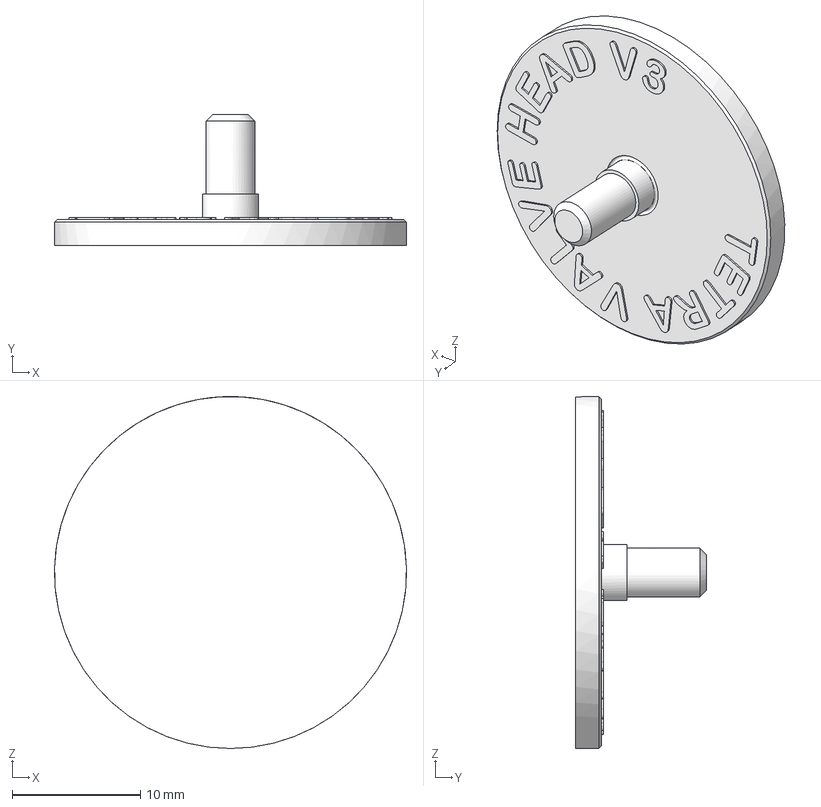
[picture p161: CAD file, 2020-05-21]
02_Development/TetraValve/STEP/TetraValveHead v3.stp
27.5 x 10.2 x 27.5 mm
