tetrabiodistributed/project-tetra/02_Development/TetraValve/STL/v4-1/TETRA_valve_head_v4-1.STL

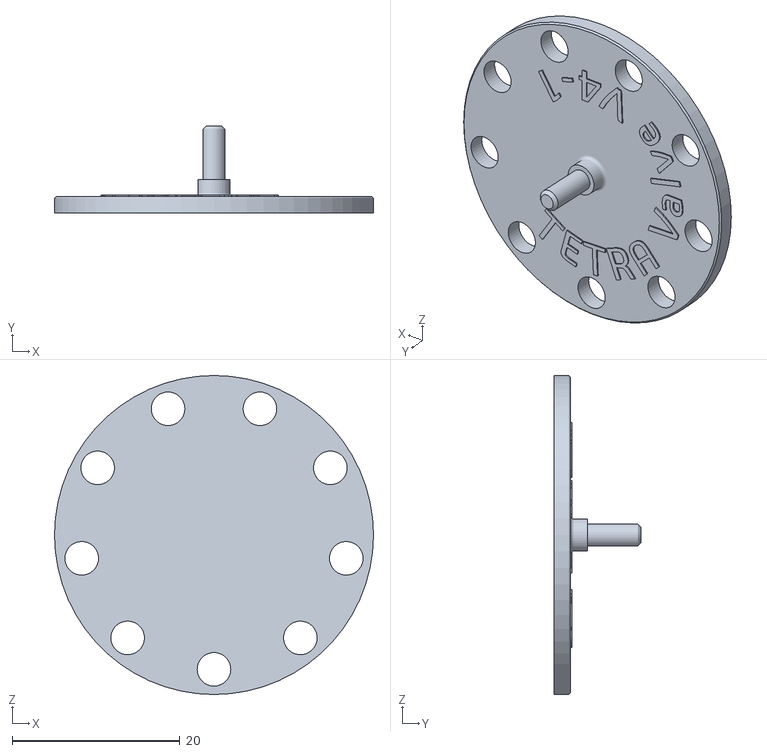
[picture p162: CAD file, 2020-06-04]
02_Development/TetraValve/STL/v4-1/TETRA_valve_head_v4-1.STL
38.0 x 10.4 x 38.0
