tetrabiodistributed/project-tetra/02_Development/TetraValve/STL/v4-2/Tetra_valve_body-v4-2.STL

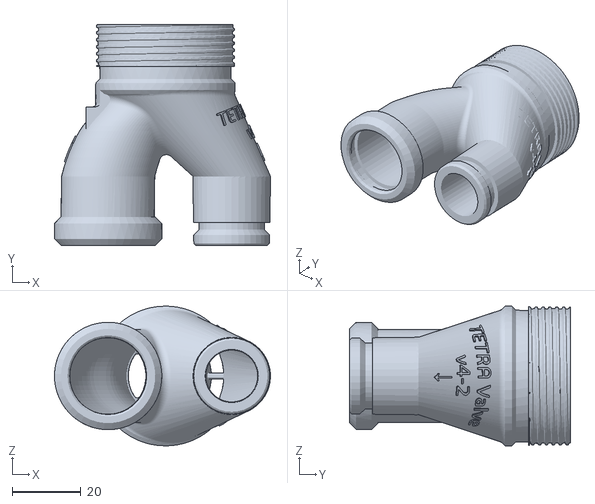
[picture p163: CAD file, 2020-06-04]
02_Development/TetraValve/STL/v4-2/Tetra_valve_body-v4-2.STL
62.6 x 64.0 x 40.5
