tetrabiodistributed/project-tetra/02_Development/TetraValve/v7/STL/tetra_cap_v7-4-1_High_Res.STL

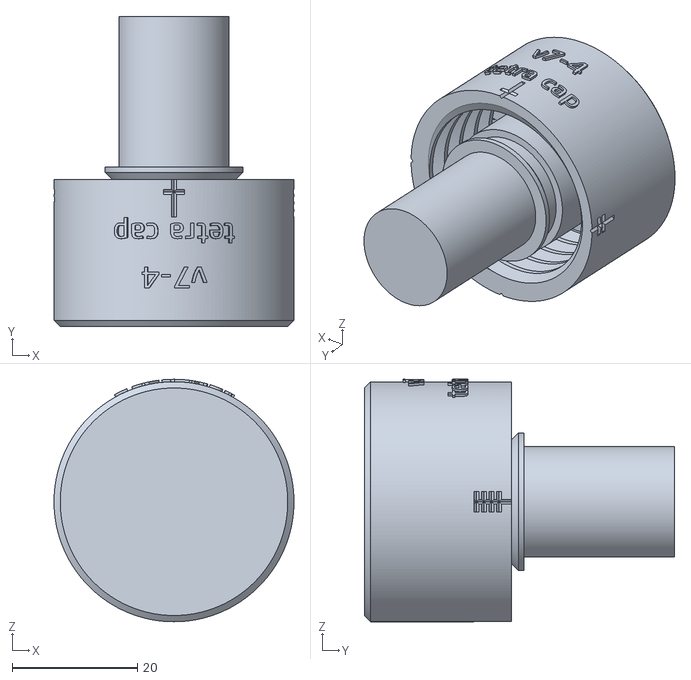
[picture p164: CAD file, 2020-07-01]
02_Development/TetraValve/v7/STL/tetra_cap_v7-4-1_High_Res.STL
38.3 x 49.5 x 38.7
