tetrabiodistributed/project-tetra/02_Development/Thru hole connector/01_Cad_Data/thru hole connector v1.step

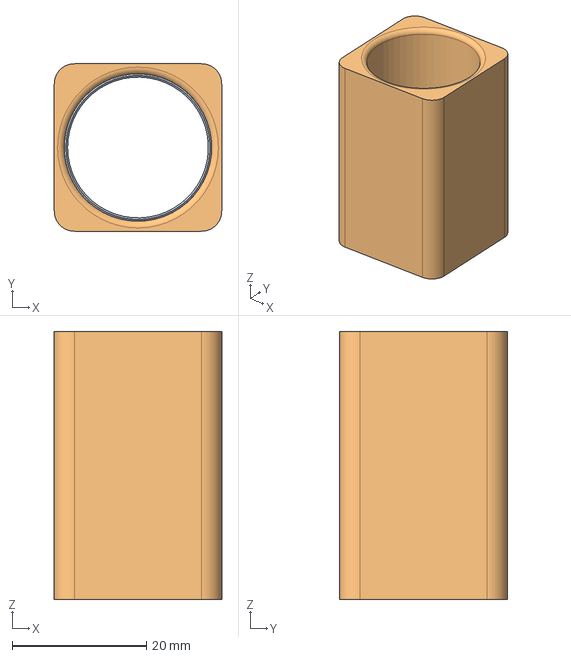
[picture p165: CAD file, 2020-05-04]
02_Development/Thru hole connector/01_Cad_Data/thru hole connector v1.step
25.0 x 25.0 x 40.0 mm
