tetrabiodistributed/project-tetra/02_Development/Valve-Threaded/4Way/Hand oprerated cap - Newer/4WayLid_HandOperated_BBC_V2.STEP

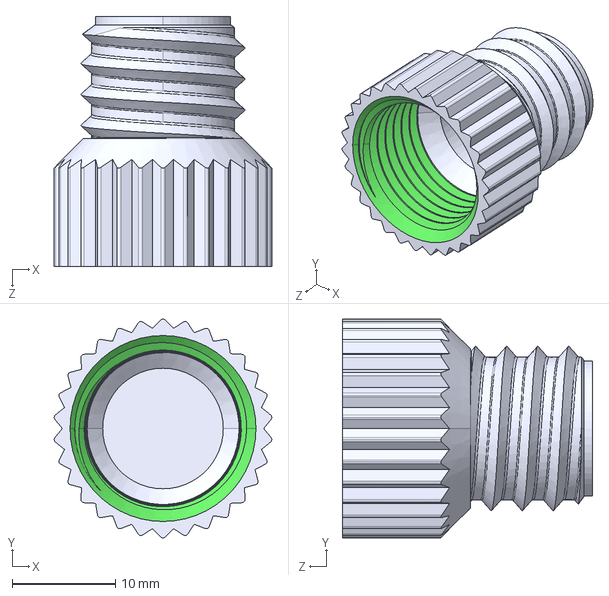
[picture p166: CAD file, 2020-03-23]
02_Development/Valve-Threaded/4Way/Hand oprerated cap - Newer/4WayLid_HandOperated_BBC_V2.STEP
21.1 x 21.2 x 24.2 mm
