tetrabiodistributed/project-tetra/In development/Two way - SAK/2WayValve.STEP

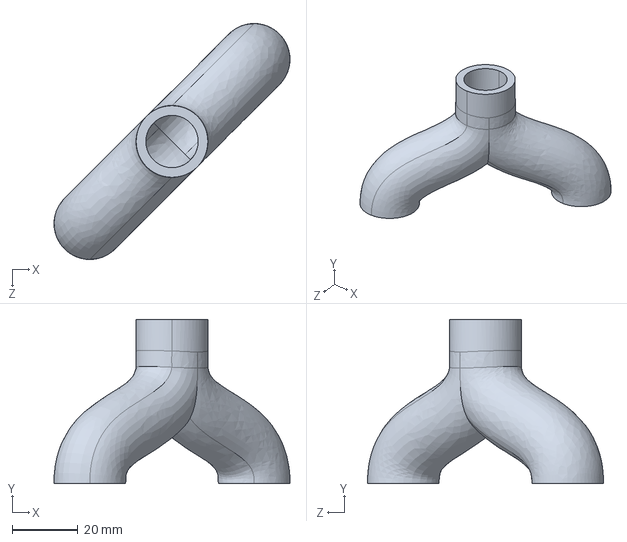
[picture p167: CAD file, 2020-03-18]
In development/Two way - SAK/2WayValve.STEP
71.8 x 50.0 x 71.8 mm
