tetrabiodistributed/project-tetra/02_Development/3WayValve/3WayConicalValve/3WayConicalValveHandleV3.stl

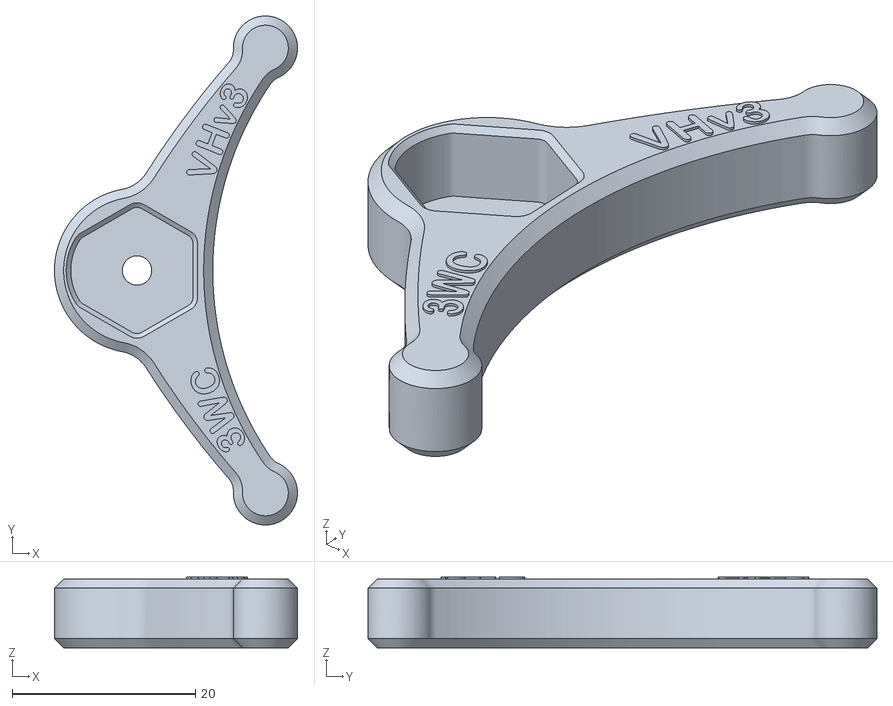
[picture p168: CAD file, 2020-03-27]
02_Development/3WayValve/3WayConicalValve/3WayConicalValveHandleV3.stl
26.5 x 55.5 x 7.70
