tetrabiodistributed/project-tetra/02_Development/CPAP Regulator/Positive Ending Expiratory Pressure Valve (rev. 2)/STEP/Air inlet.STEP

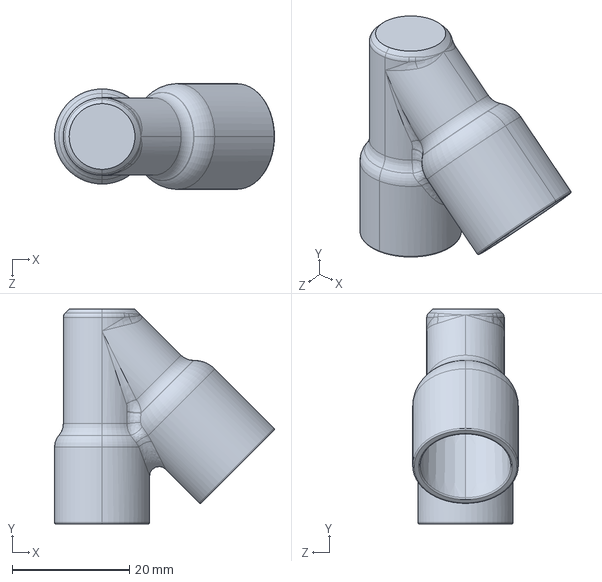
[picture p170: CAD file, 2020-04-07]
02_Development/CPAP Regulator/Positive Ending Expiratory Pressure Valve (rev. 2)/STEP/Air inlet.STEP
37.5 x 36.6 x 18.0 mm
