tetrabiodistributed/project-tetra/02_Development/CPAP Regulator/positive-ending-expiratory-pressure-valve-rev1/3D/7. Expirational gases filter body.STEP

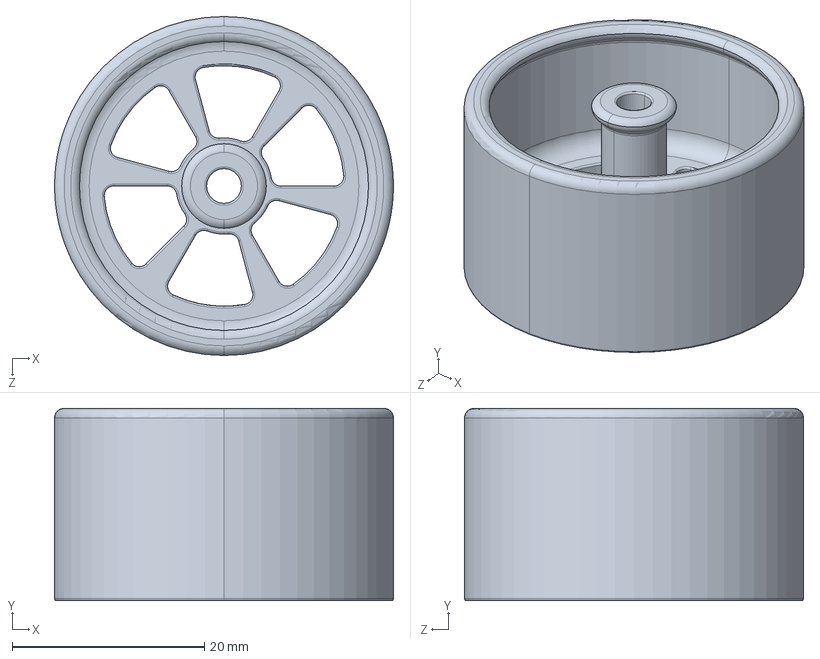
[picture p171: CAD file, 2020-03-22]
02_Development/CPAP Regulator/positive-ending-expiratory-pressure-valve-rev1/3D/7. Expirational gases filter body.STEP
35.3 x 20.0 x 35.3 mm
