tetrabiodistributed/project-tetra/02_Development/CPAP Regulator/Venturi valve/Respirator-free reanimation Venturi's valve (rev. 4)/STEP/Respirator-free reanimation Venturi's valve (rev. 4) FiO2-28 Vertical, 1-piece.STEP

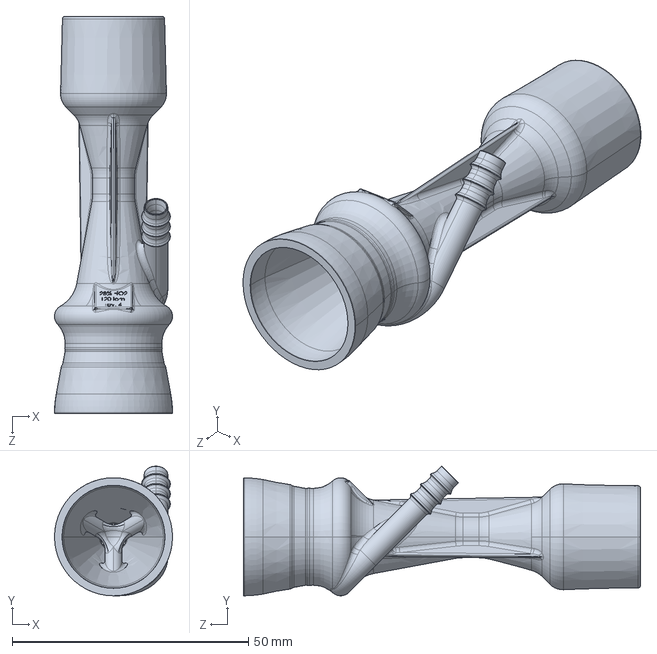
[picture p172: CAD file, 2020-03-26]
02_Development/CPAP Regulator/Venturi valve/Respirator-free reanimation Venturi's valve (rev. 4)/STEP/Respirator-free reanimation Venturi's valve (rev. 4) FiO2-28 Vertical, 1-piece.STEP
25.0 x 27.5 x 84.1 mm
