tetrabiodistributed/project-tetra/02_Development/FlowMeter/pec12r-4x20f-sxxxx.stp

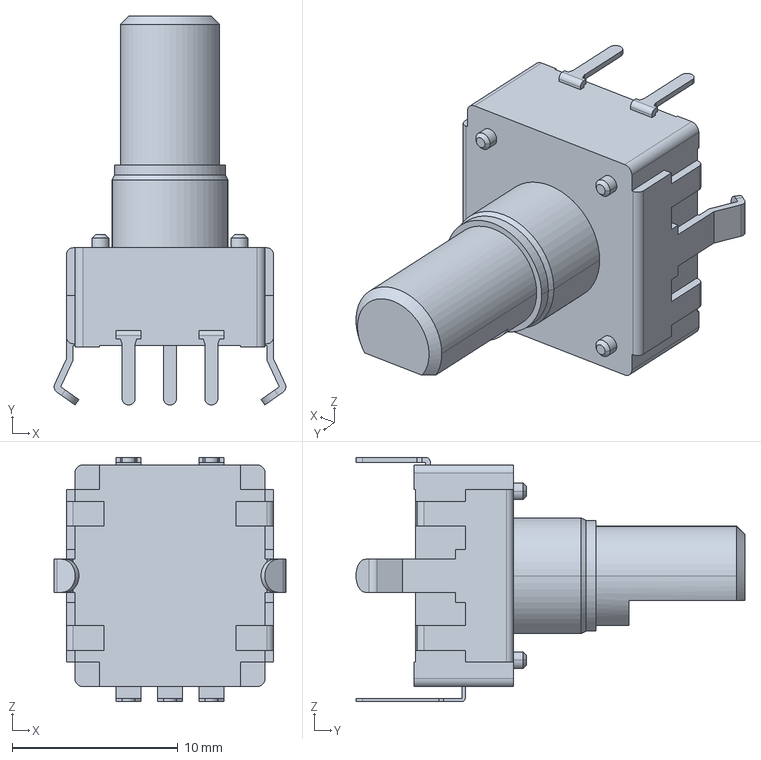
[picture p173: CAD file, 2020-03-22]
02_Development/FlowMeter/pec12r-4x20f-sxxxx.stp
14.0 x 23.5 x 14.7 mm
