tetrabiodistributed/project-tetra/02_Development/FlowMeter/sensirion_connector_pcb/cad_step_files/Phoneix_connector_from_Patrick's_model.step

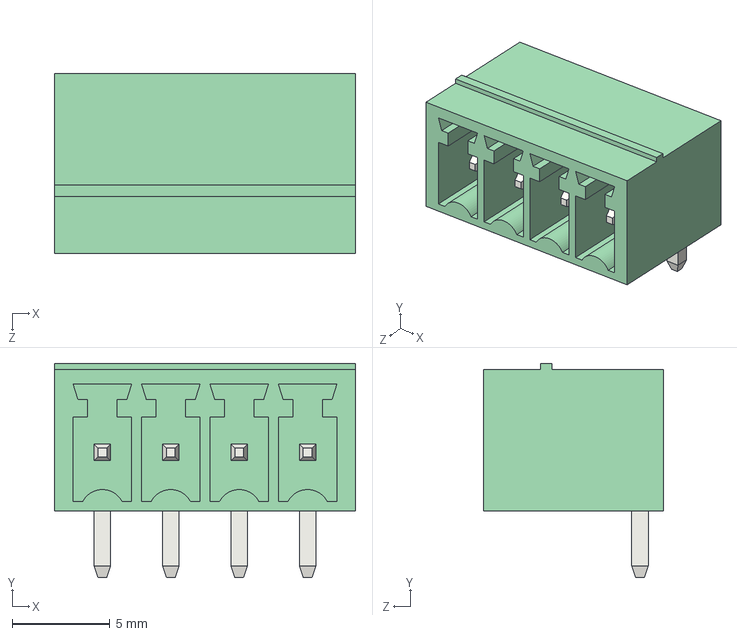
[picture p174: CAD file, 2020-08-05]
02_Development/FlowMeter/sensirion_connector_pcb/cad_step_files/Phoneix_connector_from_Patrick's_model.step
15.4 x 10.9 x 9.20 mm
