tetrabiodistributed/project-tetra/02_Development/Hotwire Flow Meter V1 - Short NPT v2.stl

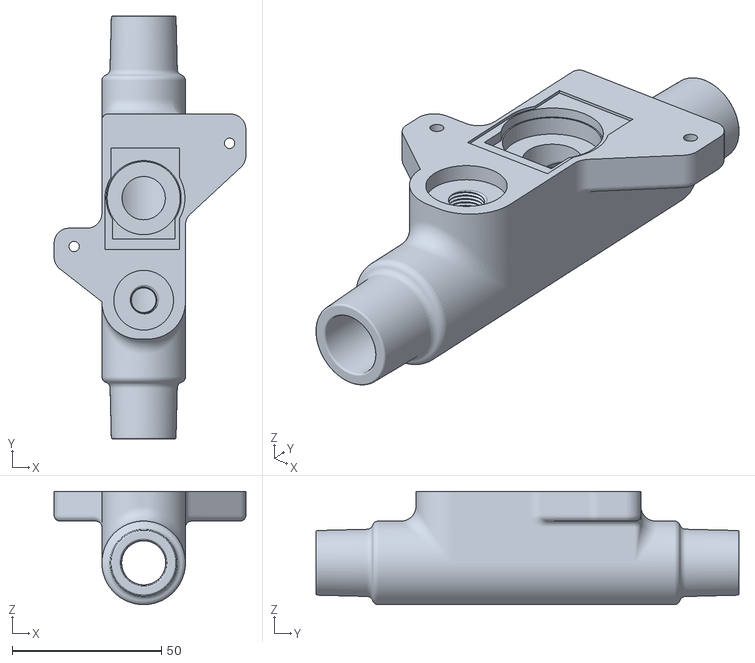
[picture p175: CAD file, 2020-05-04]
02_Development/Hotwire Flow Meter V1 - Short NPT v2.stl
64.2 x 141.7 x 37.9
