tetrabiodistributed/project-tetra/02_Development/Main-Splitter/00_Unthreaded_Splitters/4Way_WYE_V1.STEP

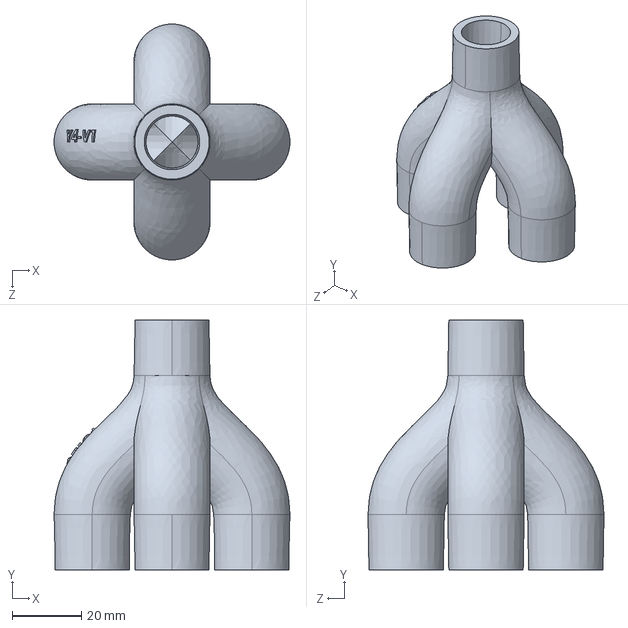
[picture p176: CAD file, 2020-04-07]
02_Development/Main-Splitter/00_Unthreaded_Splitters/4Way_WYE_V1.STEP
68.0 x 72.0 x 68.0 mm
