tetrabiodistributed/project-tetra/02_Development/Main-Splitter/01_2Way/2WayVent_3DP_v05_15 mm adapter.step

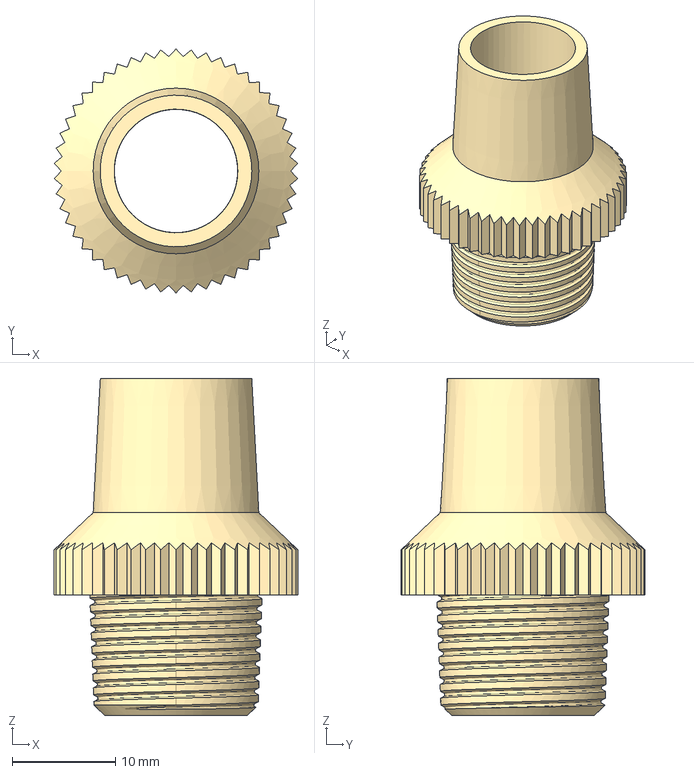
[picture p177: CAD file, 2020-03-19]
02_Development/Main-Splitter/01_2Way/2WayVent_3DP_v05_15 mm adapter.step
23.6 x 23.7 x 32.7 mm
