tetrabiodistributed/project-tetra/02_Development/Main-Splitter/BQ_parts/01-SW2018/1-3way_splitter_BQ_SW-2018.SLDPRT

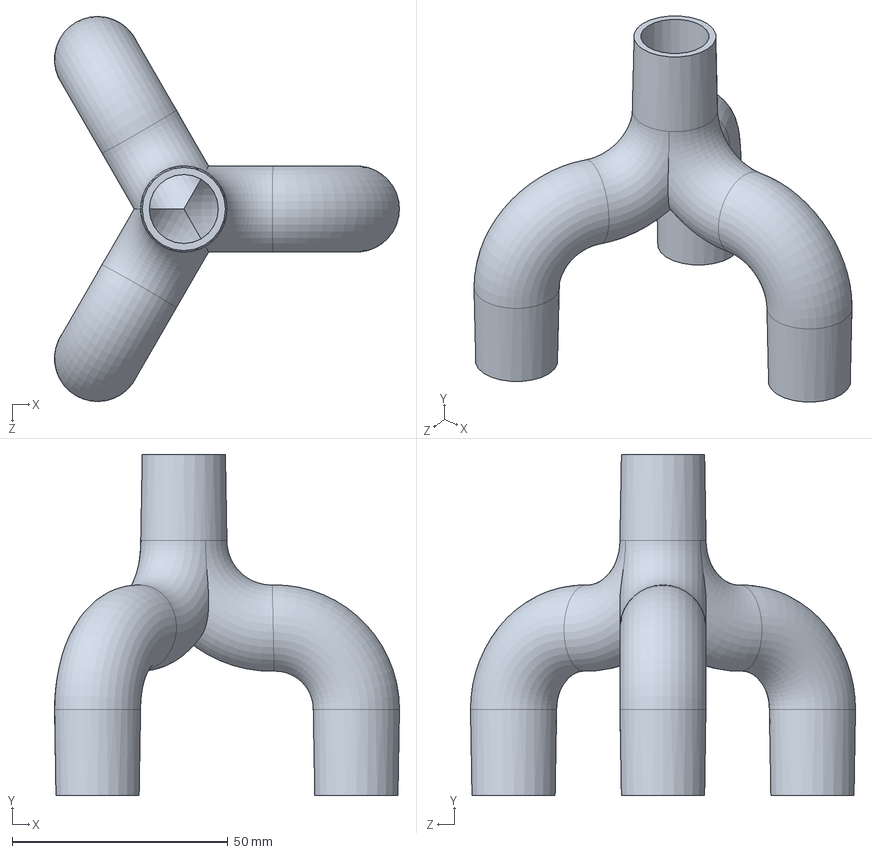
[picture p178: CAD file, 2020-04-27]
02_Development/Main-Splitter/BQ_parts/01-SW2018/1-3way_splitter_BQ_SW-2018.SLDPRT
80.0 x 79.1 x 89.3 mm
