tetrabiodistributed/project-tetra/02_Development/Main-Splitter/BQ_parts/02-STEP/Expiratory_splitter_BQ-2018.STEP

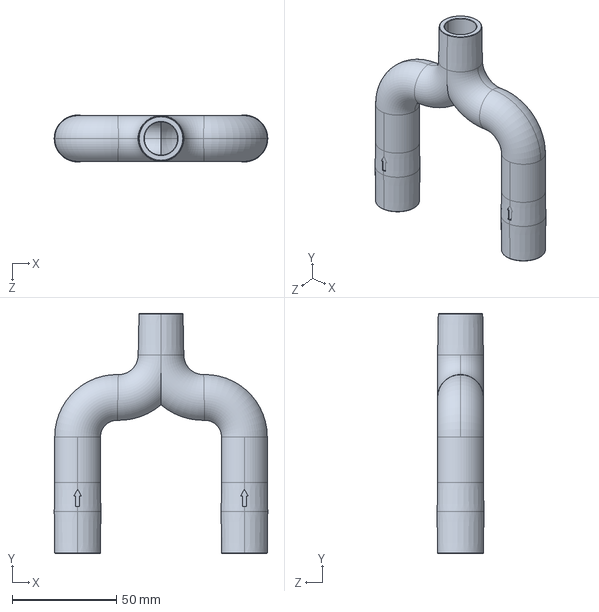
[picture p179: CAD file, 2020-04-27]
02_Development/Main-Splitter/BQ_parts/02-STEP/Expiratory_splitter_BQ-2018.STEP
102.5 x 115.1 x 22.5 mm
