tetrabiodistributed/project-tetra/02_Development/one way valve/Rev4 TPU use under test/01_CAD_Data/one-way valve body V3.STEP

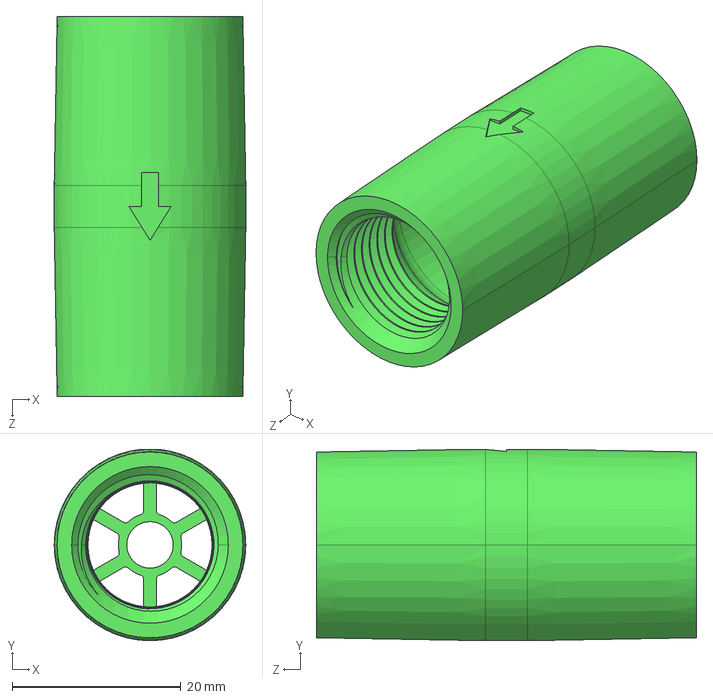
[picture p180: CAD file, 2020-03-25]
02_Development/one way valve/Rev4 TPU use under test/01_CAD_Data/one-way valve body V3.STEP
22.7 x 22.7 x 45.0 mm
