tetrabiodistributed/project-tetra/02_Development/one way valve/Rev5/01_CAD_Data/OWV body Rev5.STEP

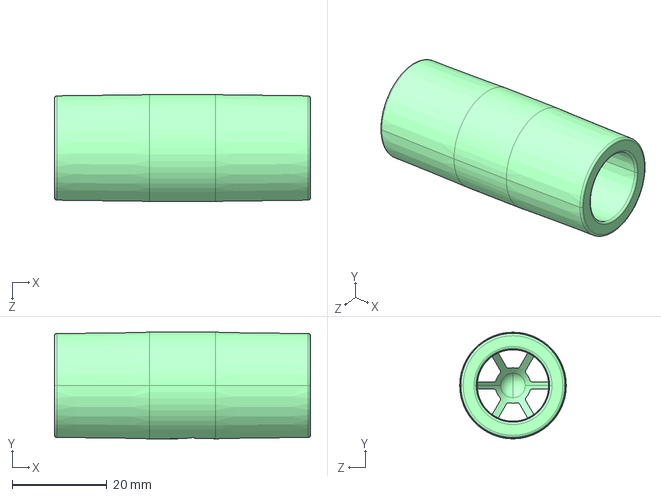
[picture p182: CAD file, 2020-04-07]
02_Development/one way valve/Rev5/01_CAD_Data/OWV body Rev5.STEP
54.0 x 22.5 x 22.5 mm
