tetrabiodistributed/project-tetra/02_Development/one way valve/Rev5/02_Mold_files/OWV Rev5 seal Mold Male.STL

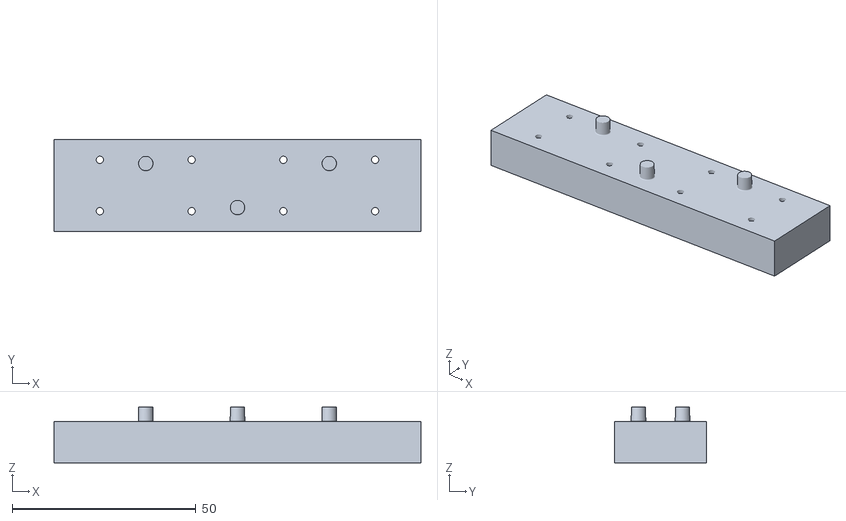
[picture p183: CAD file, 2020-04-07]
02_Development/one way valve/Rev5/02_Mold_files/OWV Rev5 seal Mold Male.STL
100.0 x 25.0 x 15.3
