tetrabiodistributed/project-tetra/02_Development/PEEP_valve/HEVS PEEP Cap V1.stl

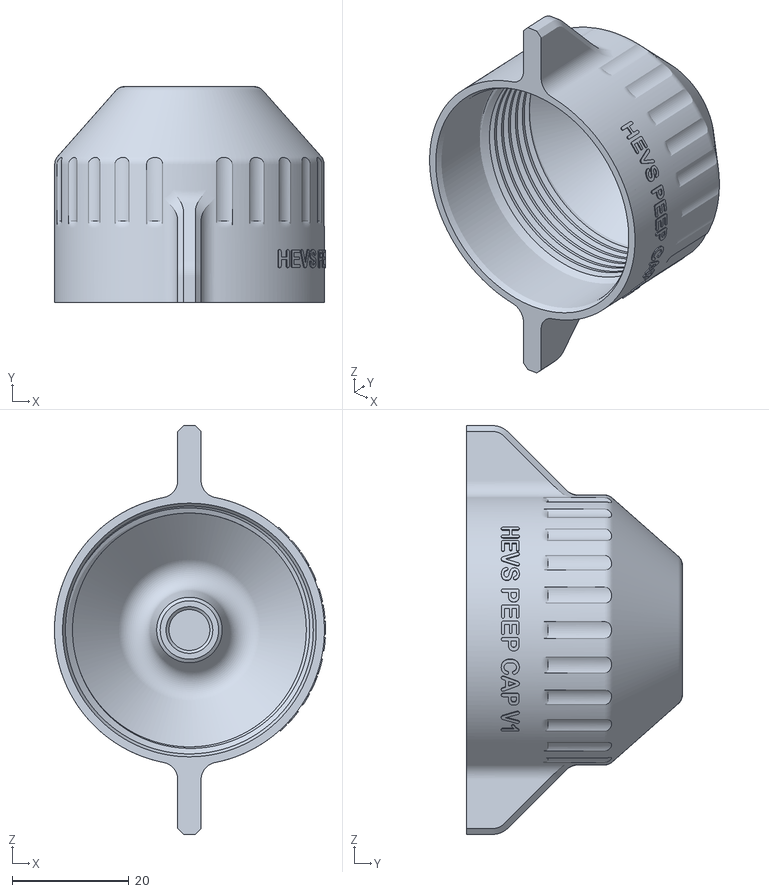
[picture p184: CAD file, 2020-05-14]
02_Development/PEEP_valve/HEVS PEEP Cap V1.stl
46.4 x 36.9 x 70.0
