tetrabiodistributed/project-tetra/02_Development/Prototype_release/Alpha/For_testing/P-TET-000021-1.stl

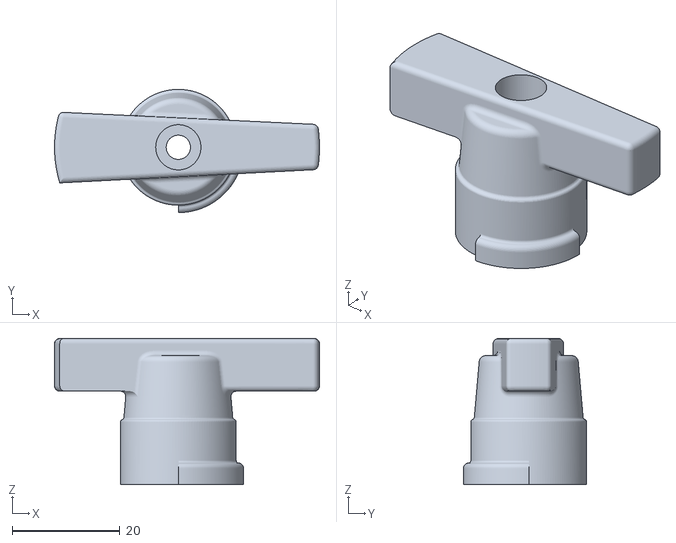
[picture p185: CAD file, 2020-07-30]
02_Development/Prototype_release/Alpha/For_testing/P-TET-000021-1.stl
49.2 x 22.9 x 27.1
