tetrabiodistributed/project-tetra/02_Development/Prototype_release/Alpha/Parts_to_print/P-TET-000030-1.stl

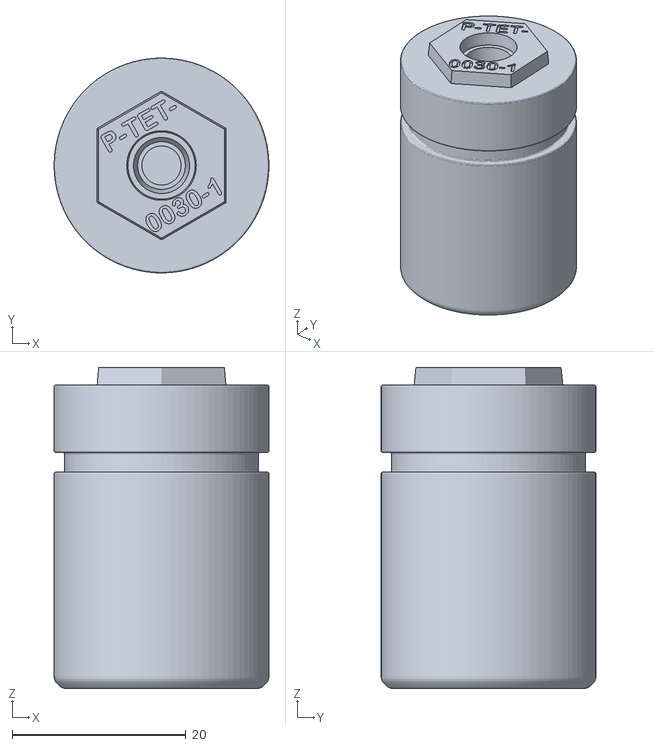
[picture p186: CAD file, 2020-09-01]
02_Development/Prototype_release/Alpha/Parts_to_print/P-TET-000030-1.stl
24.7 x 24.7 x 36.9
