tetrabiodistributed/project-tetra/02_Development/Prototype_release/Alpha_sprint-2/STEP/A-TET-001007_Tetra_enclosure/P-TET-000007-0_Radial_panel_joint.step

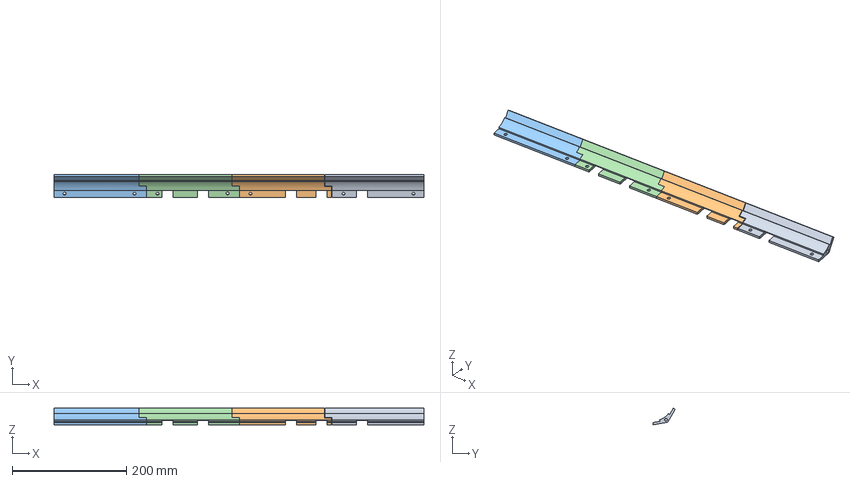
[picture p187: CAD file, 2020-09-01]
02_Development/Prototype_release/Alpha_sprint-2/STEP/A-TET-001007_Tetra_enclosure/P-TET-000007-0_Radial_panel_joint.step
646.8 x 39.4 x 29.1 mm
