tetrabiodistributed/project-tetra/02_Development/Prototype_release/Alpha_sprint-2/STEP/A-TET-001007_Tetra_enclosure/Sheet_metal/Flat_patterns/Tetra-Flat-Pattern_Front_cover_panel.dxf

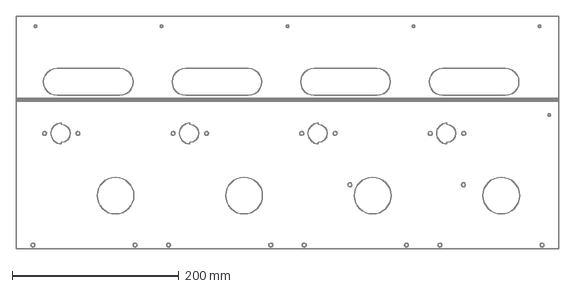
[picture p188: CAD file, 2020-09-01]
02_Development/Prototype_release/Alpha_sprint-2/STEP/A-TET-001007_Tetra_enclosure/Sheet_metal/Flat_patterns/Tetra-Flat-Pattern_Front_cover_panel.dxf
650.0 x 278.6 mm
