tetrabiodistributed/project-tetra/02_Development/Prototype_release/Alpha_sprint-2/STEP/A-TET-001007_Tetra_enclosure/Sheet_metal/Tetra-Rear_cover_panel.step

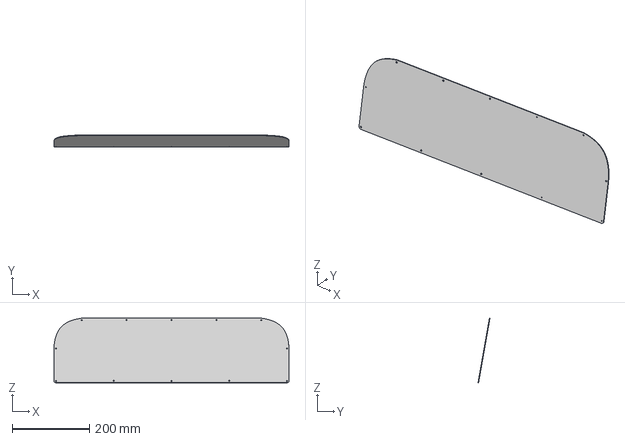
[picture p189: CAD file, 2020-09-01]
02_Development/Prototype_release/Alpha_sprint-2/STEP/A-TET-001007_Tetra_enclosure/Sheet_metal/Tetra-Rear_cover_panel.step
610.0 x 31.1 x 168.0 mm
