tetrabiodistributed/project-tetra/02_Development/Prototype_release/Alpha_sprint-2/STEP/A-TET-001013_Tetra_inspiratory_and_expiratory_complex/P-TET-000001-0_90-degree_elbow.step

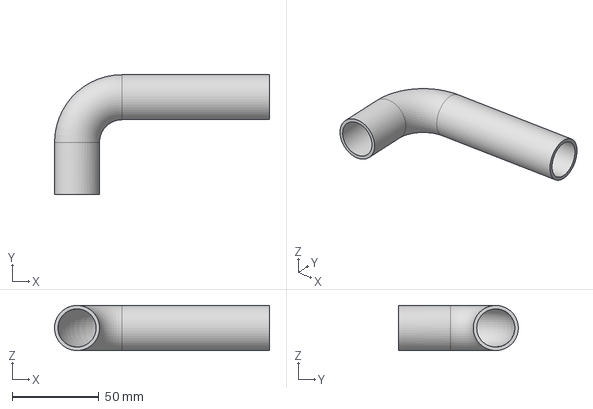
[picture p190: CAD file, 2020-09-01]
02_Development/Prototype_release/Alpha_sprint-2/STEP/A-TET-001013_Tetra_inspiratory_and_expiratory_complex/P-TET-000001-0_90-degree_elbow.step
124.0 x 69.0 x 26.0 mm
