tetrabiodistributed/project-tetra/02_Development/Prototype_release/Alpha_sprint-2/STEP/A-TET-001014_Expiratory_support_mounts/P-TET-000013-0_Expiratory_mount_support_upper.step

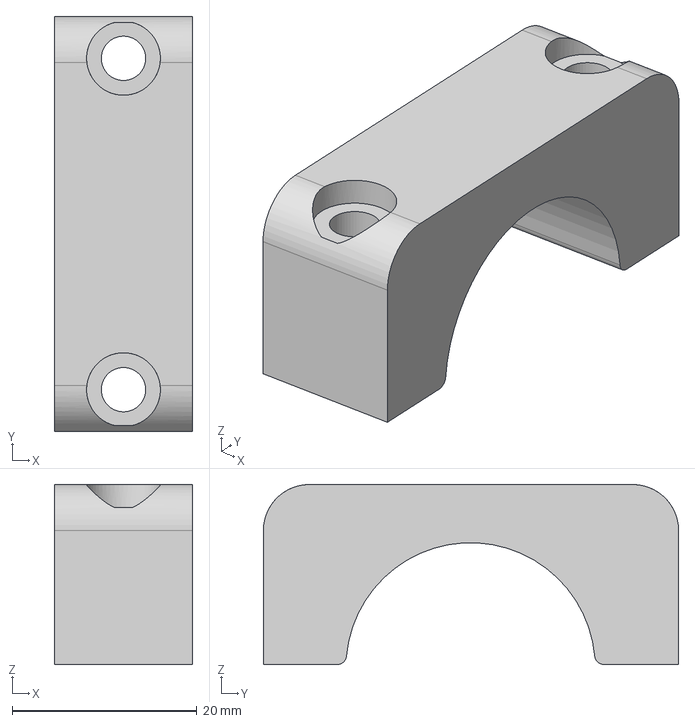
[picture p191: CAD file, 2020-09-01]
02_Development/Prototype_release/Alpha_sprint-2/STEP/A-TET-001014_Expiratory_support_mounts/P-TET-000013-0_Expiratory_mount_support_upper.step
15.0 x 45.0 x 19.5 mm
