tetrabiodistributed/project-tetra/02_Development/Prototype_release/Alpha_sprint-2/STEP/A-TET-001016_Bias_complex/P-TET-000026-1.step

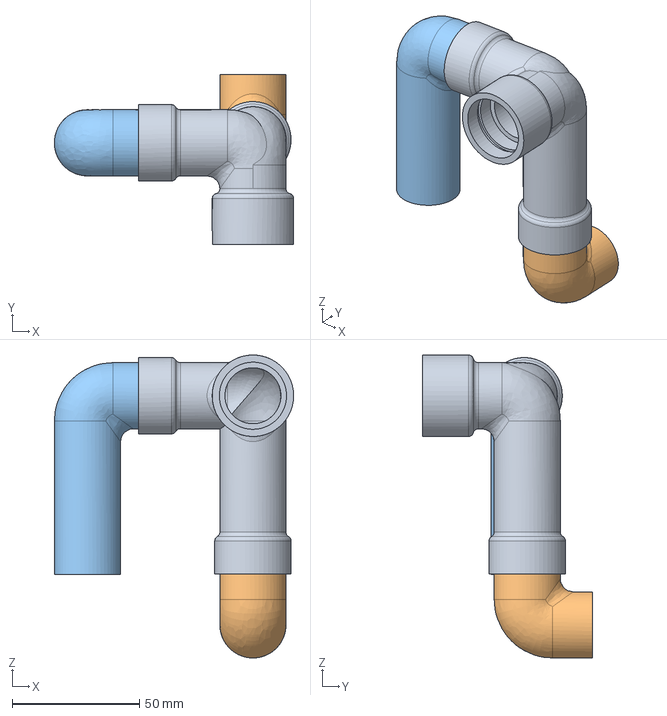
[picture p192: CAD file, 2020-09-01]
02_Development/Prototype_release/Alpha_sprint-2/STEP/A-TET-001016_Bias_complex/P-TET-000026-1.step
94.0 x 66.9 x 119.0 mm
