tetrabiodistributed/project-tetra/02_Development/Prototype_release/Alpha_sprint-2/STEP/A-TET-001017_Sensirion_and_comm_PCB/P-TET-000027-0_Sensirion_PCB_harness.step

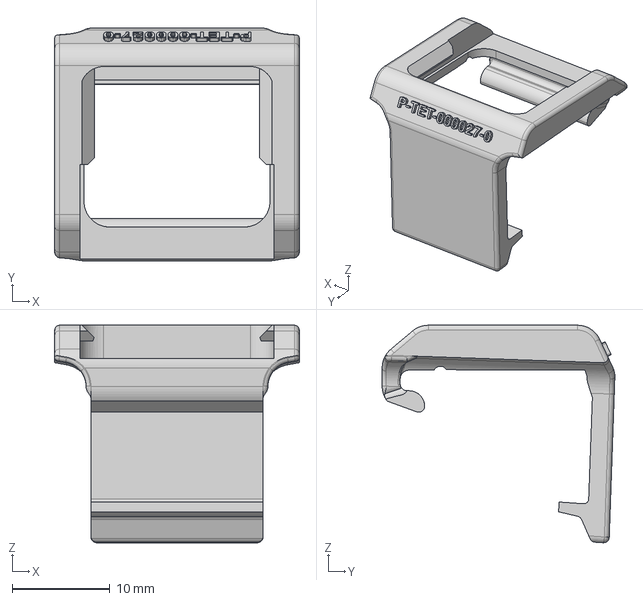
[picture p193: CAD file, 2020-09-01]
02_Development/Prototype_release/Alpha_sprint-2/STEP/A-TET-001017_Sensirion_and_comm_PCB/P-TET-000027-0_Sensirion_PCB_harness.step
25.0 x 23.8 x 22.2 mm
