tetrabiodistributed/project-tetra/02_Development/Prototype_release/Alpha_sprint-2/STL/A-TET-001016_Bias_complex/P-TET-000026-1/P-TET-000026-1A.stl

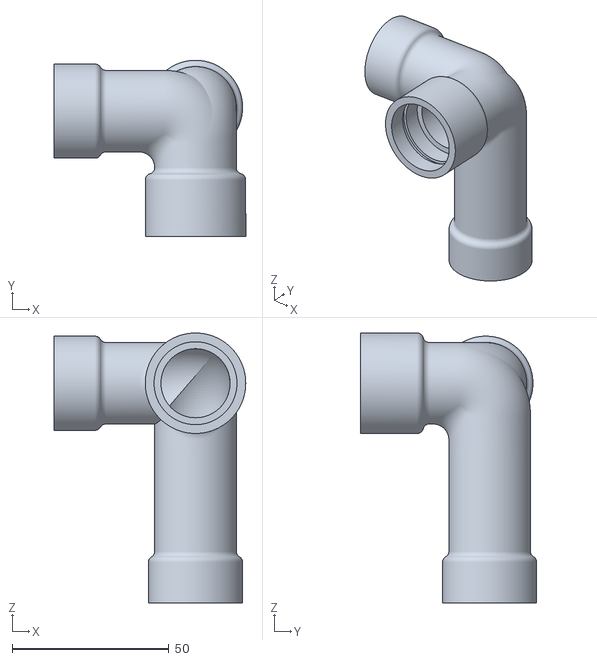
[picture p196: CAD file, 2020-09-01]
02_Development/Prototype_release/Alpha_sprint-2/STL/A-TET-001016_Bias_complex/P-TET-000026-1/P-TET-000026-1A.stl
61.0 x 56.2 x 86.0
