tetrabiodistributed/project-tetra/02_Development/Prototype_release/Beta_P1/P-TET-000033-0.stl

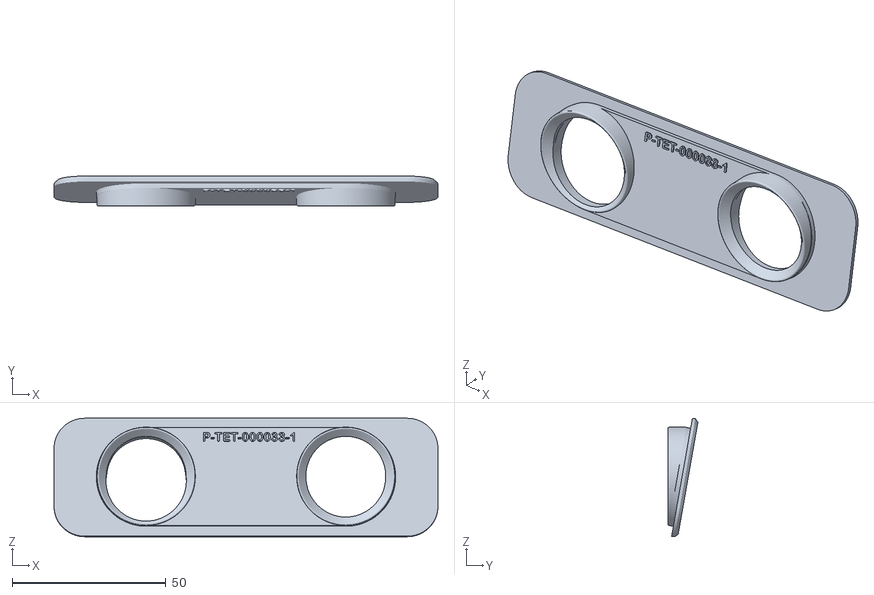
[picture p197: CAD file, 2020-10-22]
02_Development/Prototype_release/Beta_P1/P-TET-000033-0.stl
125.0 x 9.72 x 38.6
