tetrabiodistributed/project-tetra/02_Development/PVCManifold/Valve Upper Mount v1.stp

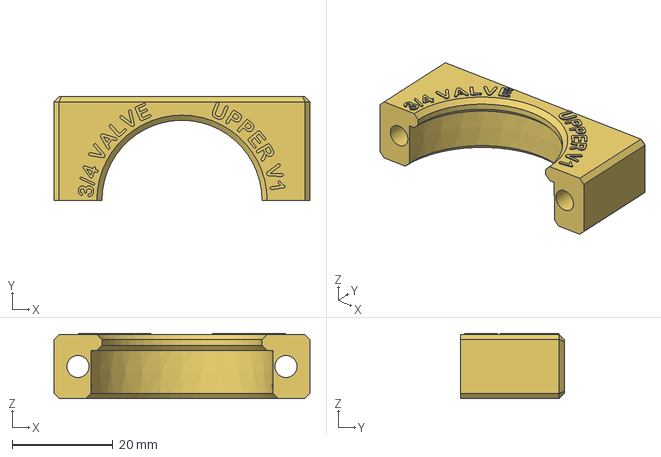
[picture p198: CAD file, 2020-04-08]
02_Development/PVCManifold/Valve Upper Mount v1.stp
50.8 x 20.5 x 12.9 mm
