tetrabiodistributed/project-tetra/02_Development/TetraValve/CAD/Patrick Peep Valve Seal.STEP

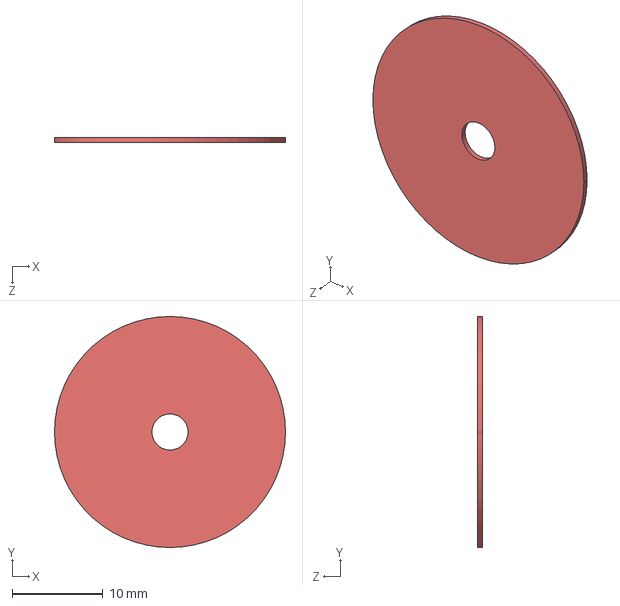
[picture p199: CAD file, 2020-05-21]
02_Development/TetraValve/CAD/Patrick Peep Valve Seal.STEP
25.4 x 25.4 x 0.508 mm
