tetrabiodistributed/project-tetra/02_Development/TetraValve/v7/SW-2018/tetra_concept-body-v7-4.SLDPRT

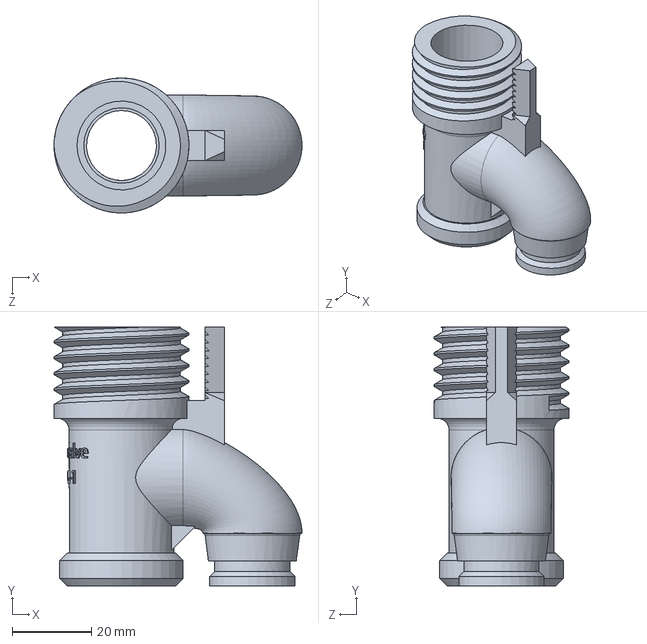
[picture p200: CAD file, 2020-07-01]
02_Development/TetraValve/v7/SW-2018/tetra_concept-body-v7-4.SLDPRT
62.5 x 65.3 x 34.0 mm
