tetrabiodistributed/project-tetra/02_Development/Valve-Threaded/4Way/Hand oprerated cap - Newer/4WayLid_HandOperated_SAK_V1_0_0.STEP

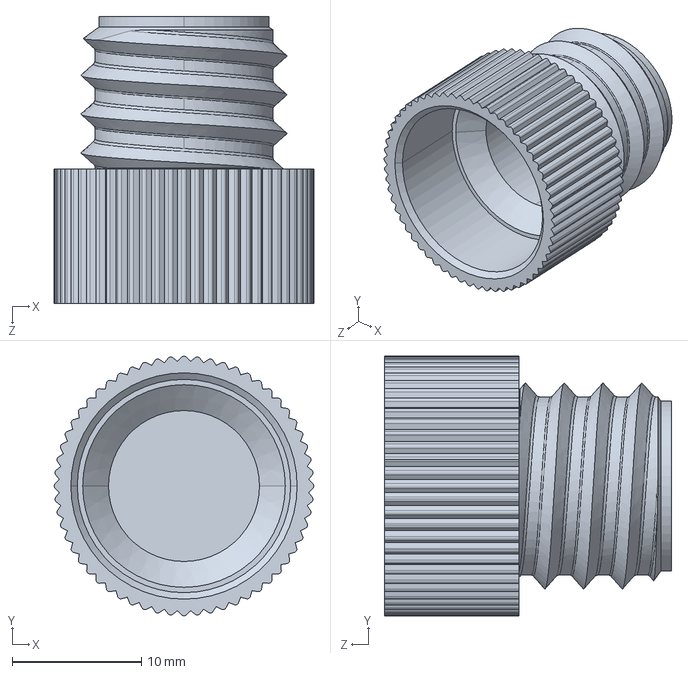
[picture p201: CAD file, 2020-03-19]
02_Development/Valve-Threaded/4Way/Hand oprerated cap - Newer/4WayLid_HandOperated_SAK_V1_0_0.STEP
20.1 x 20.1 x 22.2 mm
