tetrabiodistributed/project-tetra/02_Development/3WayValve/3WayConicalValve/3WayConicalValveCockV2.stl

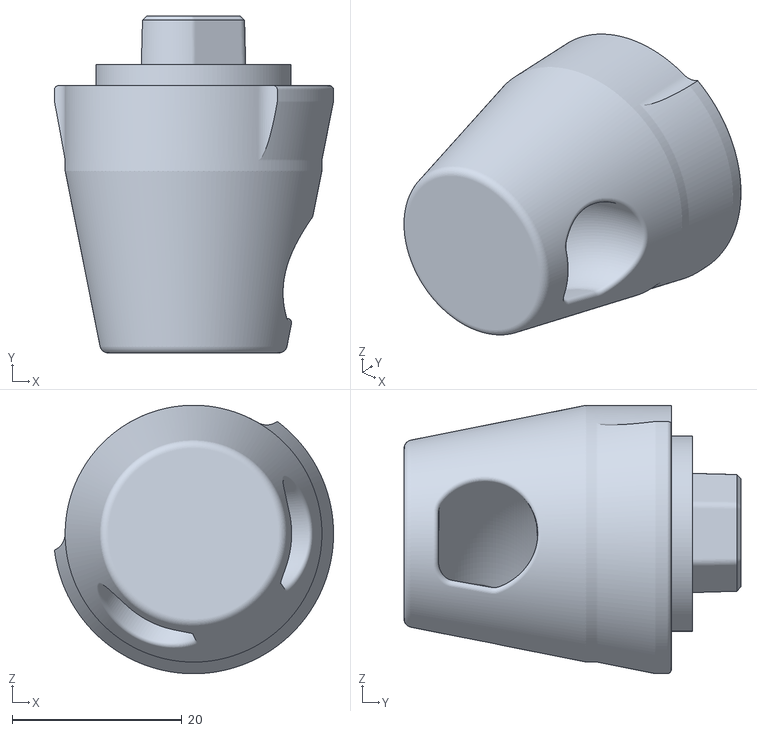
[picture p202: CAD file, 2020-03-26]
02_Development/3WayValve/3WayConicalValve/3WayConicalValveCockV2.stl
32.9 x 39.7 x 31.6
