tetrabiodistributed/project-tetra/02_Development/3WayValve/3WayOring/Rev8/V1_0_X_SAK/01_CAD_Daten/FixRingV1_0_2_SAK_BC.STEP

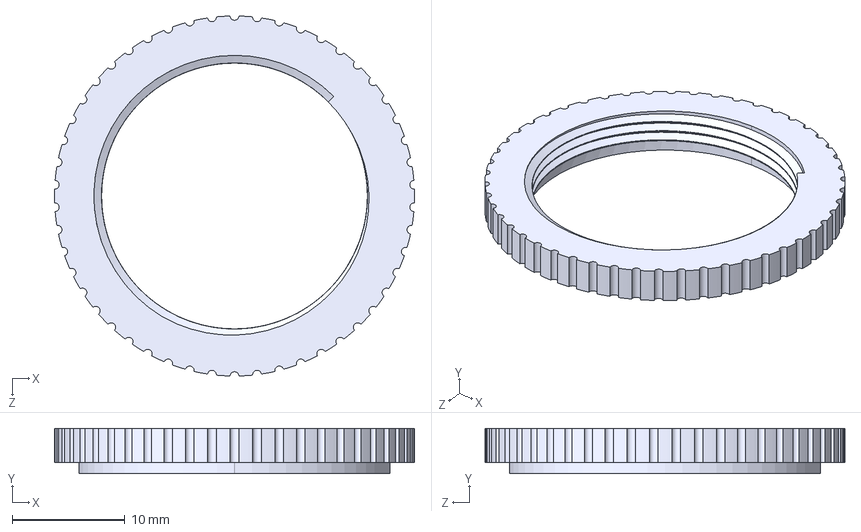
[picture p203: CAD file, 2020-03-26]
02_Development/3WayValve/3WayOring/Rev8/V1_0_X_SAK/01_CAD_Daten/FixRingV1_0_2_SAK_BC.STEP
32.0 x 4.00 x 32.0 mm
