tetrabiodistributed/project-tetra/(list of files, cad)

Other CAD files:
03_Visulisation_and_Handbooks/CAD_drawings/Tetra_drawing_templates/August-2020/DXF/Tetra Drawing Template - Assembly v18 Assembly.dxf
03_Visulisation_and_Handbooks/CAD_drawings/Tetra_drawing_templates/August-2020/DXF/Tetra Drawing Template - Part SLA v2 Assembly.dxf
03_Visulisation_and_Handbooks/CAD_drawings/Tetra_drawing_templates/August-2020/DWG/Tetra Drawing Template - Assembly v18.dwg
03_Visulisation_and_Handbooks/CAD_drawings/Tetra_drawing_templates/August-2020/DXF/Tetra Drawing Template - Part FDM v2 Assembly.dxf
02_Development/shut_off_valve/ver5/globe_valve_005-2.SLDASM
02_Development/CPAP Regulator/positive-ending-expiratory-pressure-valve-rev1/3D/Venturi Nozzle/Venturi Nozzle revision 2 B=0,3.STEP
02_Development/FlowMeter/RPi Board/Sensor_manifold/v2/SW-2018/Manifold_v2-0.SLDPRT
02_Development/inspiratory 2-way splitter/01_CAD_Data/inspiratory 2-way splitter v4.step
02_Development/Main-Splitter/BQ_parts/02-STEP/1-5way_splitter_BQ_SW-2018.STEP
02_Development/Main-Splitter/BQ_parts/03-STL's/1-5way_splitter_BQ_SW-2018.STL
02_Development/Male to male connector/Rev2/03_STL_Files/male conector 3_8 NPT.STL
02_Development/one way valve/Rev4_Unthreaded/03_STL_Files/one-way valve body V3_Unthreaded.STL
02_Development/one way valve/Rev5/03_Main_STL's/OWV seal ReV5.STL
02_Development/Pressure Manifold/P-TET-000008-0.stl
02_Development/Prototype_release/Alpha/Parts_to_print/P-TET-000008-1.stl
02_Development/Prototype_release/Alpha_sprint-2/STEP/A-TET-001017_Sensirion_and_comm_PCB/P-TET-000029-0_Sensirion_Comm_PCB.step
02_Development/Prototype_release/Alpha_sprint-2/STL/A-TET-001002_RPi_complex/P-TET-000004-1_RPi_display_frame.stl
02_Development/Prototype_release/Alpha_sprint-2/STL/A-TET-001007_Tetra_enclosure/P-TET-000015-1_Enclosure_corner-right.stl
02_Development/Prototype_release/Alpha_sprint-2/STL/A-TET-001014_Expiratory_support_mounts/P-TET-000013-0_Expiratory_mount_support_lower.stl
02_Development/TetraValve/v7/SW-2018/tetra_cap_v7-4.SLDPRT
02_Development/Thru hole connector/02_STL_Files/thru hole connector v1.stl
03_Visulisation_and_Handbooks/CAD_drawings/Tetra_drawing_templates/August-2020/DWG/Tetra Drawing Template - Part FDM v2.dwg
In development/4WayVent - SAK/4WayValveV1.1.STL
Manifold_v2-0.STEP
02_Development/3WayValve/3WayOring/Rev8/V1_0_X_SAK/01_CAD_Daten/ValveBodyV1_0_3_SAK.SLDPRT
02_Development/3WayValve/3WayOring/Rev8/V1_0_X_SAK/04_STL_Files/TPERing_V1_0_2_SAK.STL
02_Development/one way valve/Rev2 - Use This with TPU/01_CAD_Data/TPU - Disk v2.step
02_Development/one way valve/Rev3 - Test Both/01_CAD_Data/OWV.STEP
02_Development/one way valve/Rev4_Unthreaded/01_CAD_Data/one-way valve body V3_Unthreaded.STEP
02_Development/Pressure Manifold/P-TET-000005-0.stl
02_Development/Prototype_release/Alpha_sprint-2/STEP/A-TET-001002_RPi_complex/A-TET-001004_Tetra_PBCA/A-TET-001003_Pressure_manifold/P-TET-000005-0_Pressure_manifold-SLA.step
02_Development/Prototype_release/Alpha_sprint-2/STEP/A-TET-001015_Standalone_shutoff_valve/P-TET-000021-2_Shutoff_valve_knob.step
02_Development/Prototype_release/Alpha_sprint-2/STEP/A-TET-001030_Tetra_valve/A-TET-001018_Tetra_Valave_knob_and_core/P-TET-000030-1_Tetra_valve_core.step
02_Development/Prototype_release/Alpha_sprint-2/STL/A-TET-001014_Expiratory_support_mounts/P-TET-000012-0_Expiratory_mount_support_upper.stl
02_Development/TetraValve/STEP/TetraValveCap v3.stp
02_Development/TetraValve/STL/v4-2/TETRA_cap_v4-2.STL
02_Development/TetraValve/STL/v4/TETRA_cap_v4-2_2mm_pitch.STL
03_Visulisation_and_Handbooks/CAD_drawings/Tetra_drawing_templates/August-2020/DWG/Tetra Drawing Template - Part SLA v2.dwg
02_Development/3WayValve/3WayConicalValve/3WayConicalValveBodyv2.stl
02_Development/3WayValve/3WayConicalValve/3WayConicalValveCapV2.stl
02_Development/3WayValve/3WayConicalValve/3WayConicalValveHandleV2.stl
02_Development/3WayValve/3WayConicalValve/92000A116_18-8 SS METRIC PAN HEAD PHIL MACHINE SCREW.STEP
02_Development/3WayValve/3WayOring/Rev5/Assem.STEP
02_Development/3WayValve/3WayOring/Rev5/ValveBody.STEP
02_Development/3WayValve/3WayOring/Rev5/ValveBody.STL
02_Development/3WayValve/3WayOring/Rev5/ValveCock.STEP
02_Development/3WayValve/3WayOring/Rev6/3D printable o-ring, TPU.stl
02_Development/3WayValve/3WayOring/Rev6/Assem.STEP
02_Development/3WayValve/3WayOring/Rev6/O-ring v1.f3d
02_Development/3WayValve/3WayOring/Rev6/O-ring v1.step
02_Development/3WayValve/3WayOring/Rev6/ValveBody.STEP
02_Development/3WayValve/3WayOring/Rev6/ValveBody.STL
02_Development/3WayValve/3WayOring/Rev6/ValveCock.STEP
02_Development/3WayValve/3WayOring/Rev7/TPERing_V1_0_0_SAK.SLDPRT
02_Development/3WayValve/3WayOring/Rev7/TPERing_V1_0_0_SAK.STEP
02_Development/3WayValve/3WayOring/Rev7/TPERing_V1_0_0_SAK.STL
02_Development/3WayValve/3WayOring/Rev7/ValveBodyV1_0_0_SAK.SLDPRT
02_Development/3WayValve/3WayOring/Rev7/ValveBodyV1_0_0_SAK.STEP
02_Development/3WayValve/3WayOring/Rev7/ValveBodyV1_0_0_SAK.STL
02_Development/3WayValve/3WayOring/Rev7/ValveCock_V1_0_0_SAK.SLDPRT
02_Development/3WayValve/3WayOring/Rev7/ValveCock_V1_0_0_SAK.STEP
02_Development/3WayValve/3WayOring/Rev8/V1_0_X_SAK/01_CAD_Daten/2WaySplitterAssembly.SLDASM
02_Development/3WayValve/3WayOring/Rev8/V1_0_X_SAK/01_CAD_Daten/Backup (1) of ValveCock_V1_0_3_SAK.SLDPRT
02_Development/3WayValve/3WayOring/Rev8/V1_0_X_SAK/01_CAD_Daten/FixRingV1_0_0_SAK.SLDPRT
02_Development/3WayValve/3WayOring/Rev8/V1_0_X_SAK/01_CAD_Daten/FixRingV1_0_0_SAK.STEP
02_Development/3WayValve/3WayOring/Rev8/V1_0_X_SAK/01_CAD_Daten/FixRingV1_0_0_SAK.STL
02_Development/3WayValve/3WayOring/Rev8/V1_0_X_SAK/01_CAD_Daten/FixRingV1_0_1_SAK.SLDPRT
02_Development/3WayValve/3WayOring/Rev8/V1_0_X_SAK/01_CAD_Daten/FixRingV1_0_1_SAK.STEP
02_Development/3WayValve/3WayOring/Rev8/V1_0_X_SAK/01_CAD_Daten/FixRingV1_0_2_SAK_BC.SLDPRT
02_Development/3WayValve/3WayOring/Rev8/V1_0_X_SAK/01_CAD_Daten/TPERing_V1_0_2_SAK.SLDPRT
02_Development/3WayValve/3WayOring/Rev8/V1_0_X_SAK/01_CAD_Daten/TPERing_V1_0_2_SAK.STL
02_Development/3WayValve/3WayOring/Rev8/V1_0_X_SAK/01_CAD_Daten/ValveBodyV1_0_1_SAK.SLDPRT
02_Development/3WayValve/3WayOring/Rev8/V1_0_X_SAK/01_CAD_Daten/ValveBodyV1_0_1_SAK.STEP
02_Development/3WayValve/3WayOring/Rev8/V1_0_X_SAK/01_CAD_Daten/ValveBodyV1_0_2_SAK.SLDPRT
02_Development/3WayValve/3WayOring/Rev8/V1_0_X_SAK/01_CAD_Daten/ValveBodyV1_0_2_SAK.STEP
02_Development/3WayValve/3WayOring/Rev8/V1_0_X_SAK/01_CAD_Daten/ValveCock_V1_0_3_SAK.SLDPRT
02_Development/3WayValve/3WayOring/Rev8/V1_0_X_SAK/01_CAD_Daten/ValveCock_V1_0_3_SAK.STEP
02_Development/3WayValve/3WayOring/Rev8/V1_0_X_SAK/MoldingForm/3WayValve_RIng_MoldPartA.STL
02_Development/3WayValve/3WayOring/Rev8/V1_0_X_SAK/MoldingForm/3WayValve_RIng_MoldPartB.STL
02_Development/3WayValve/3WayOring/Rev8/V1_0_X_SAK/MoldingForm/3WayValve_RIng_MoldPartB.sldprt
02_Development/CPAP Regulator/Positive Ending Expiratory Pressure Valve (rev. 2)/STEP/Air outlet.STEP
02_Development/CPAP Regulator/Positive Ending Expiratory Pressure Valve (rev. 2)/STEP/Nut.STEP
02_Development/CPAP Regulator/Positive Ending Expiratory Pressure Valve (rev. 2)/STEP/Pressure plate.STEP
02_Development/CPAP Regulator/Positive Ending Expiratory Pressure Valve (rev. 2)/STL/Air inlet.STL
02_Development/CPAP Regulator/Positive Ending Expiratory Pressure Valve (rev. 2)/STL/Air outlet.STL
02_Development/CPAP Regulator/Positive Ending Expiratory Pressure Valve (rev. 2)/STL/Nut.STL
02_Development/CPAP Regulator/Positive Ending Expiratory Pressure Valve (rev. 2)/STL/Pressure plate.STL
02_Development/CPAP Regulator/Venturi valve/Respirator-free reanimation Venturi's valve (rev. 4)/STEP/Respirator-free reanimation Venturi's valve (rev. 4) FiO2-28 Body.STEP
02_Development/CPAP Regulator/Venturi valve/Respirator-free reanimation Venturi's valve (rev. 4)/STEP/Respirator-free reanimation Venturi's valve (rev. 4) FiO2-28 Cap ISO 22mm.STEP
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
