tetrabiodistributed/project-tetra/02_Development/3WayValve/3WayConicalValve/3WayConicalValveAssembly.PNG

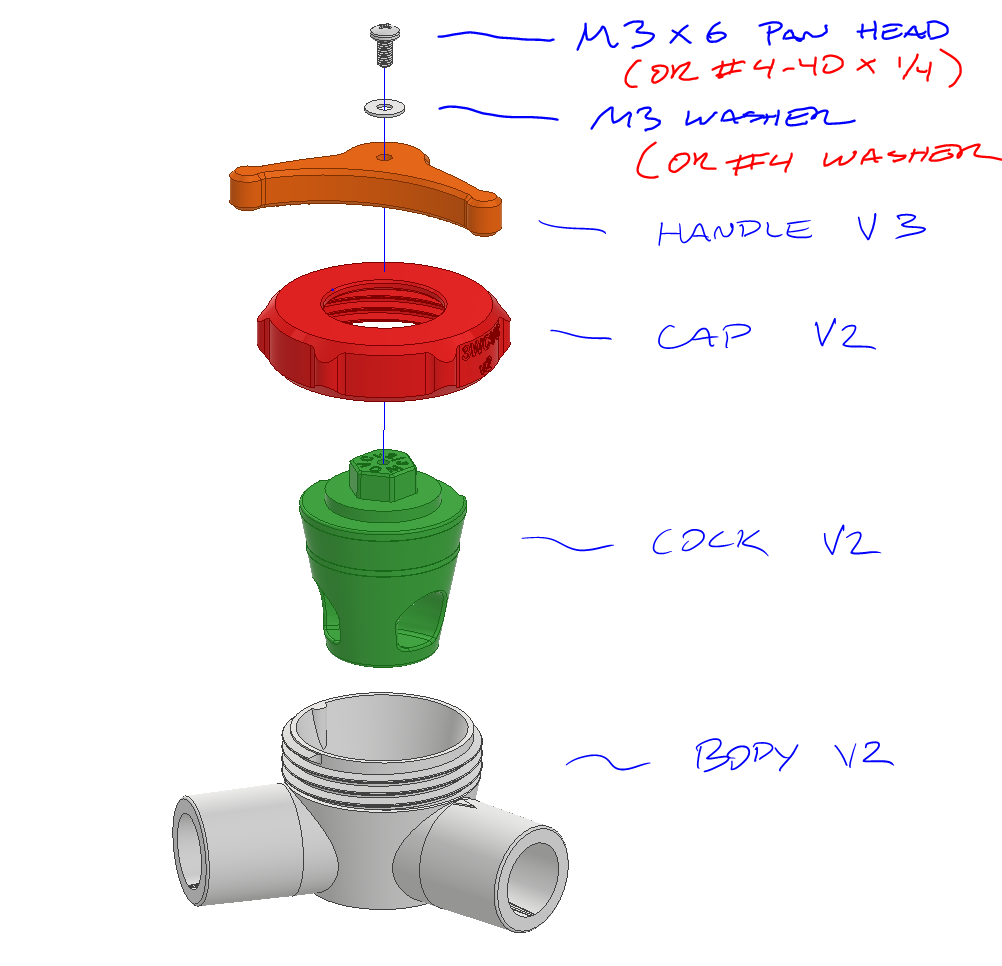
02_Development/3WayValve/3WayConicalValve/3WayConicalValveAssembly.PNG
