tetrabiodistributed/project-tetra/02_Development/3WayValve/3WayOring/Rev8/V1_0_X_SAK/03_Printign/UM5/photo_2020-03-23 05.23.45.jpeg

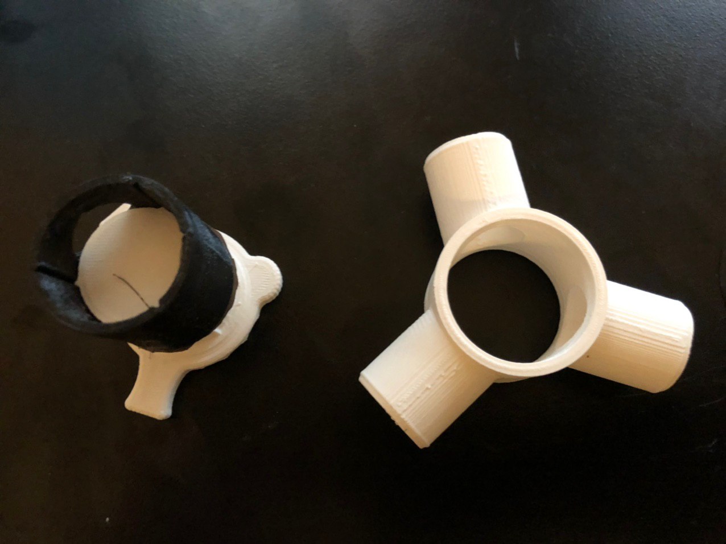
02_Development/3WayValve/3WayOring/Rev8/V1_0_X_SAK/03_Printign/UM5/photo_2020-03-23 05.23.45.jpeg
