tetrabiodistributed/project-tetra/02_Development/FlowMeter/FastTrackTidalVolMeter/PCB/Olimex ESP32 POE-ISO Step File.PNG

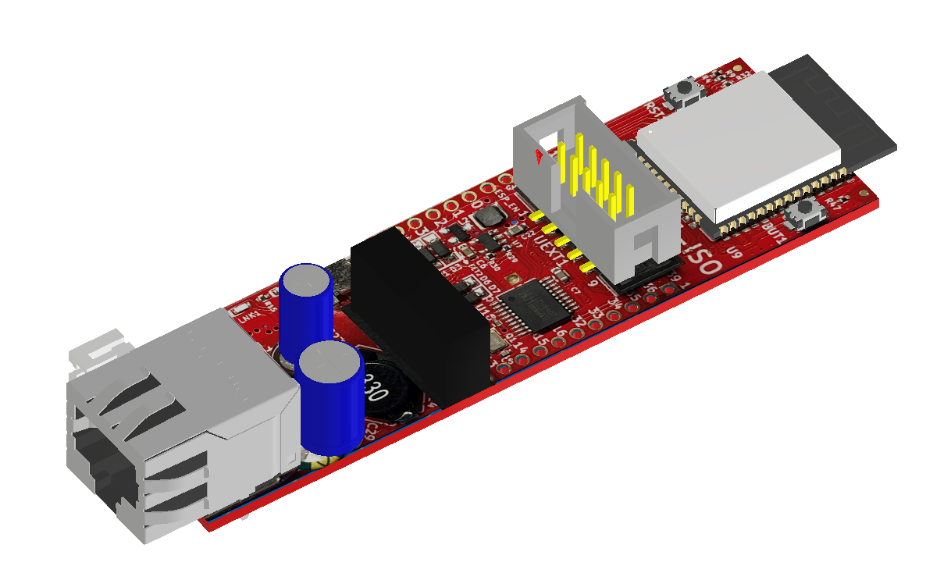
02_Development/FlowMeter/FastTrackTidalVolMeter/PCB/Olimex ESP32 POE-ISO Step File.PNG
