tetrabiodistributed/project-tetra/02_Development/one way valve/Rev3 - Test Both/02_Renderings/Assembly 2.png

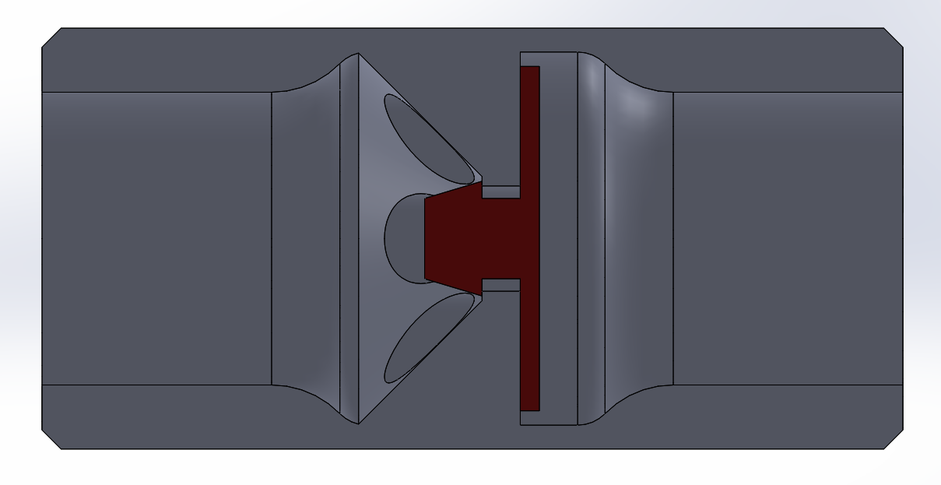
02_Development/one way valve/Rev3 - Test Both/02_Renderings/Assembly 2.png
