tetrabiodistributed/project-tetra/02_Development/CPAP Regulator/Positive Ending Expiratory Pressure Valve (rev. 2)/Printable measure/Measure.pdf

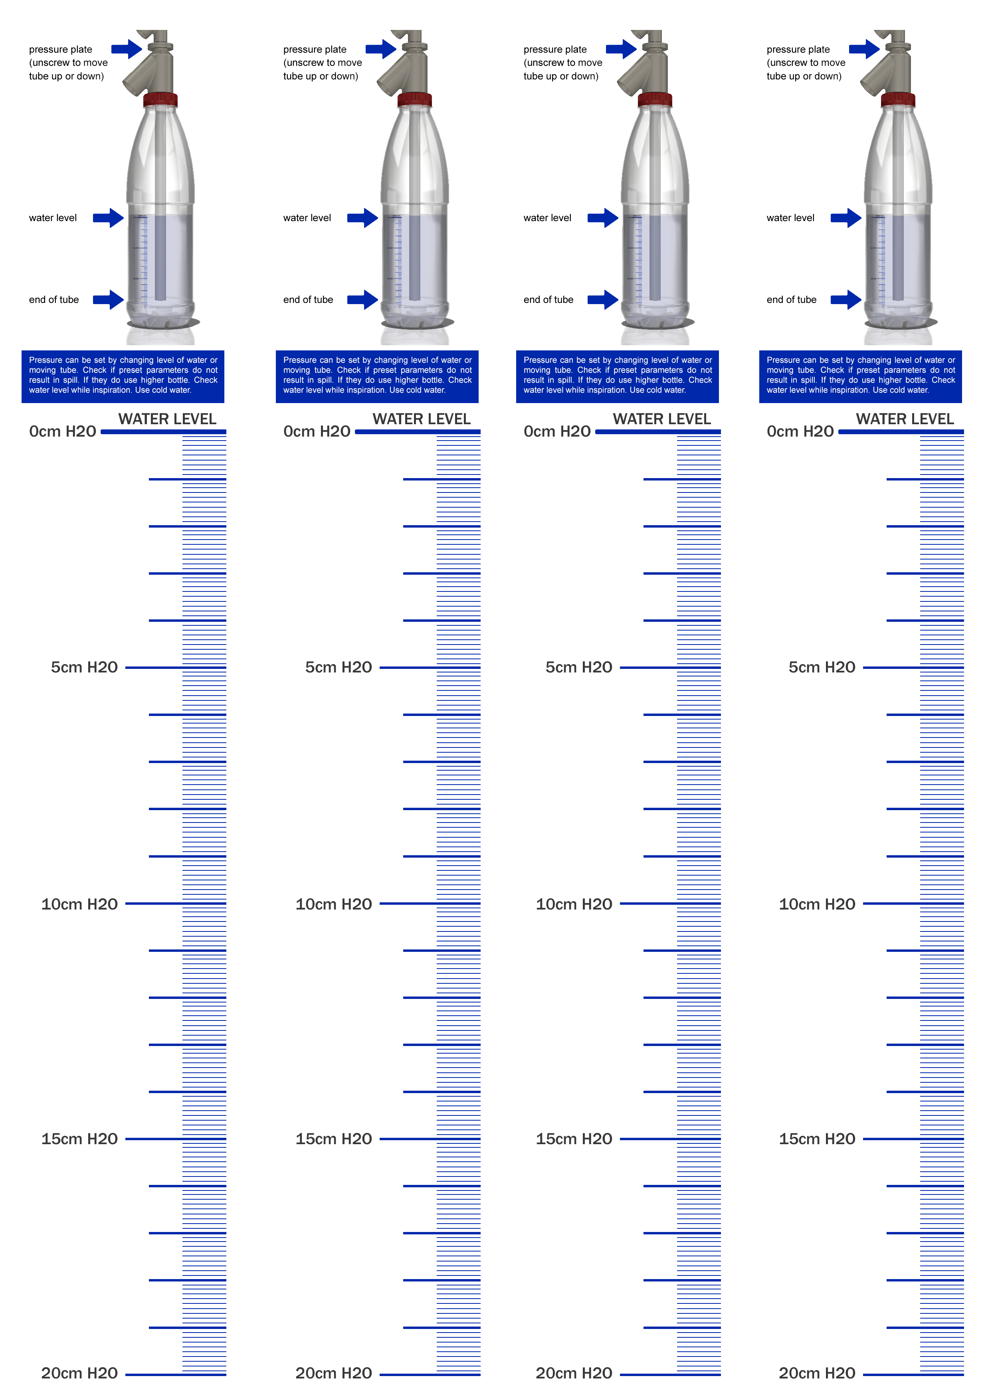
[picture p216: page 1]
