tetrabiodistributed/project-tetra/02_Development/one way valve/Rev3 - Test Both/02_Renderings/Umbrella.jpg

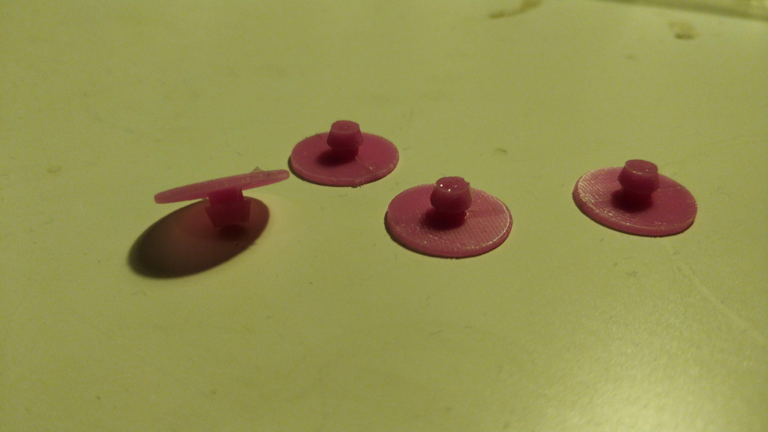
02_Development/one way valve/Rev3 - Test Both/02_Renderings/Umbrella.jpg
