tetrabiodistributed/project-tetra/02_Development/shut_off_valve/ver5/globe_valve_test-005-2_contour_right.png

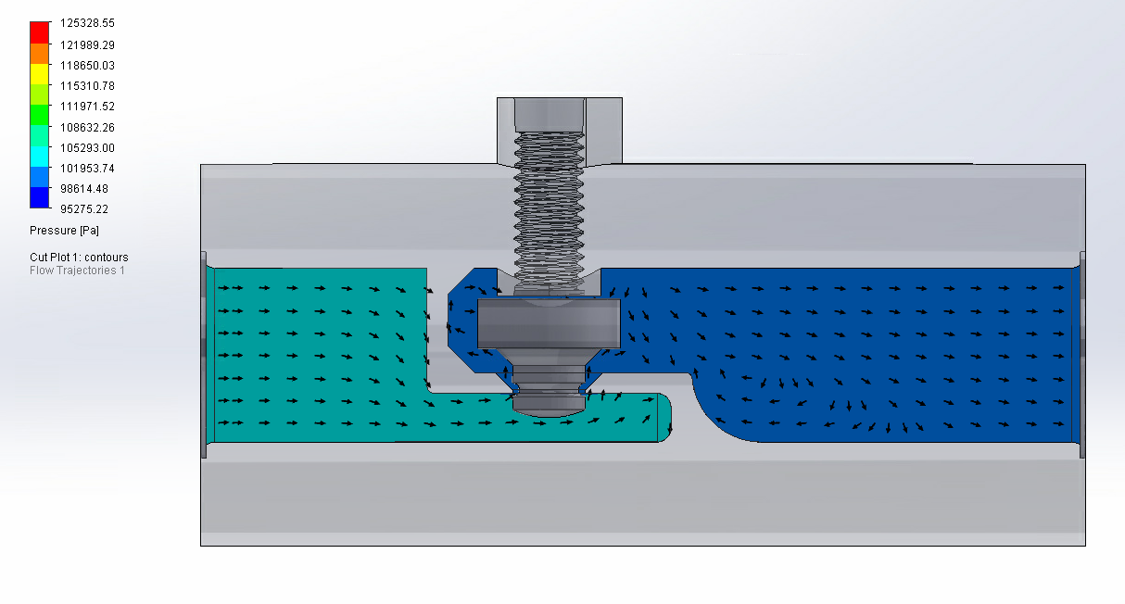
02_Development/shut_off_valve/ver5/globe_valve_test-005-2_contour_right.png
