tetrabiodistributed/project-tetra/02_Development/shut_off_valve/ver5/globe_valve_test-005-2_flow_right-2.png

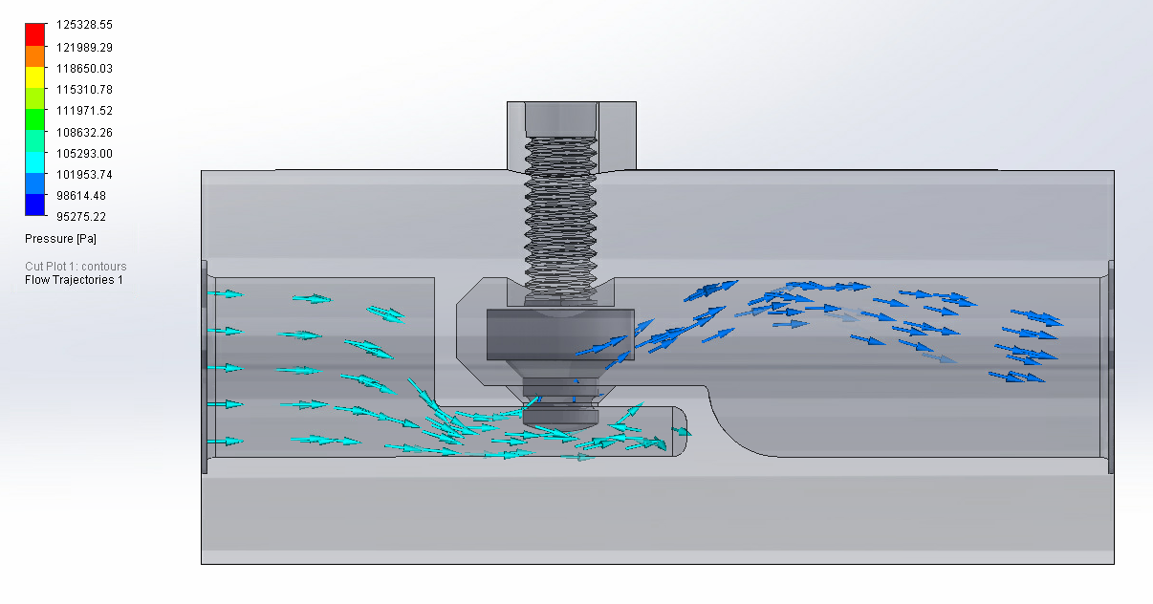
02_Development/shut_off_valve/ver5/globe_valve_test-005-2_flow_right-2.png
