tetrabiodistributed/project-tetra/(threads)

Thread 10 (2020-05-04):

Shutoff Valve too restrictive

Judoguy12, 2020-05-04:
V5 of the shutoff valve feels like it's restricting the flow too much

Closed 2020-05-04.

Thread 13 (2020-05-04):

Need for UK clinical need - URGENT FOR UK REGULATORY APPROVAL

Judoguy12, 2020-05-04:
We need a clinical need statement from different consultants to show that this is a device that is needed and would be used

Judoguy12, 2021-02-10:
Still needs to be found when we apply, don't know if this is needed for CE but certain for Emergency approval

Thread 6 (2020-05-04):

Flow Meter display

Judoguy12, 2020-05-04:
How should the display work?

Current thought: show flow in mmH2O/sec as a waveform, allow different waveforms to be shown on a central board or show each waveform on each patient line, depending on how boards are wired.

Judoguy12, 2020-05-04:
Ventilators use the following units

- Pressure - cmH20
- Flow - L/min
- Volume - ml
- Respiratory rate - br/min

fpdotmonkey, 2021-02-10:
This is explored in https://github.com/tetrabiodistributed/project-tetra-display

Closed 2021-02-10.

Thread 7 (2020-05-04):

tubing design with no right angles

Judoguy12, 2020-05-04:
Per Daniel Stemen, make sure there are no right angles in the flow system, and make sure each patient gets the same amount of flow (possibly) before flow adjustments are made.

Judoguy12, 2021-02-10:
Fixed with Our new manifold design #128

Closed 2021-02-10.

Thread 8 (2020-05-04):

iso 18562 testing

Judoguy12, 2020-05-04:
Do we need this? Hopefully not: it will be $50-$60k and 70-90 days on a prototype.

Here are my notes from the 15 April 2020 meeting notes with NAMSA:

NAMSA meeting

potential for condensate to collect in the air pathway
has to be controlled or known if it's a risk

if it's likely that condensate could form, or nothing to say that it couldn't,
then things get a bit more complex
18562, because then have to address the requirements of part 4
particulates and VOC (volatile organic chemicals)

UL laboratories
tend to like their data fairly well

data has to be toxologically

don't want new car smell going to the patient
toxilogical assessment of the chemicals and whether they are toxic at those levels

risk gets enhanced if condensate could form, because then it could get transferred to the patient

NAMSA can do the things in part 4, 2 and 3 have to be done by UL
have to hook the device up to gassed air
either examine for particles, or collect it in a tank

part 4 is biocompatibility testing
cytotoxicity testing, genotoxicity testing

a. materials to choose to help passing tests
MHRA in the UK released a guidance specific to the UK with suggestions
ABS
polycarbonate
manufacturing practices, reasonable cleanliness in manufacturing

will see straight up PVC in tubing

b. ventilators are out of the loop, just checking in the device itself

$50-$60k for testing

colleague who may know how the EUA submissions are going

prescan of particular/VOC?

heating elements inside the device
FDA hasn't been keen on things

TBD:

- we won't be able to do the testing, because it costs too much and takes too much time (and we don't even have a prototype yet tbh)
- the MHRA document should be incoming in our emails
- he will reach out to his colleague who might be able to provide guidance on the FDA EUA vs standard approaches

Thread 9 (2020-05-04):

Shutoff Valve too restrictive

Judoguy12, 2020-05-04:
V5 of the shutoff valve feels like it's restricting the flow too much

Thread 19 (2020-05-05):

PEEP valve - air leak

Burhan-Q, 2020-05-05:
- [ ] 1. Determine failure testing procedure
- [ ] 2. Investigate possible sources of failure
- [ ] 3. Determine tolerances for failure mode
- [ ] 4. Establish component life cycle
- [ ] 5. List other components that may have detrimental response
- [ ] 6. If possible, determine likelihood of failure
- [ ] 7. If possible, determine lowest threshold for detecting failure
- [ ] 8. Rank severity of failure
- [ ] 9. Document probabilistic risk analysis chart

Closed 2020-07-24.

Thread 20 (2020-05-05):

PEEP valve - incorrect positive pressure

Burhan-Q, 2020-05-05:
- [ ] 1. Determine failure testing procedure
- [ ] 2. Investigate possible sources of failure
- [ ] 3. Determine tolerances for failure mode
- [ ] 4. Establish component life cycle
- [ ] 5. List other components that may have detrimental response
- [ ] 6. If possible, determine likelihood of failure
- [ ] 7. If possible, determine lowest threshold for detecting failure
- [ ] 8. Rank severity of failure
- [ ] 9. Document probabilistic risk analysis chart

Closed 2020-07-24.

Thread 21 (2020-05-05):

PEEP valve - mechanical malfunction

Burhan-Q, 2020-05-05:
- [ ] 1. Determine failure testing procedure
- [ ] 2. Investigate possible sources of failure
- [ ] 3. Determine tolerances for failure mode
- [ ] 4. Establish component life cycle
- [ ] 5. List other components that may have detrimental response
- [ ] 6. If possible, determine likelihood of failure
- [ ] 7. If possible, determine lowest threshold for detecting failure
- [ ] 8. Rank severity of failure
- [ ] 9. Document probabilistic risk analysis chart

Closed 2020-07-24.

Thread 22 (2020-05-05):

Flowmeter - inaccurate measurement information

Burhan-Q, 2020-05-05:
- [ ] 1. Determine failure testing procedure
- [ ] 2. Investigate possible sources of failure
- [ ] 3. Determine tolerances for failure mode
- [ ] 4. Establish component life cycle
- [ ] 5. List other components that may have detrimental response
- [ ] 6. If possible, determine likelihood of failure
- [ ] 7. If possible, determine lowest threshold for detecting failure
- [ ] 8. Rank severity of failure
- [ ] 9. Document probabilistic risk analysis chart

Closed 2020-07-24.

Thread 23 (2020-05-05):

Flowmeter - display malfunction

Burhan-Q, 2020-05-05:
- [ ] 1. Determine failure testing procedure
- [ ] 2. Investigate possible sources of failure
- [ ] 3. Determine tolerances for failure mode
- [ ] 4. Establish component life cycle
- [ ] 5. List other components that may have detrimental response
- [ ] 6. If possible, determine likelihood of failure
- [ ] 7. If possible, determine lowest threshold for detecting failure
- [ ] 8. Rank severity of failure
- [ ] 9. Document probabilistic risk analysis chart

Closed 2020-07-24.

Thread 24 (2020-05-05):

Flowmeter - controller malfunction

Burhan-Q, 2020-05-05:
- [ ] 1. Determine failure testing procedure
- [ ] 2. Investigate possible sources of failure
- [ ] 3. Determine tolerances for failure mode
- [ ] 4. Establish component life cycle
- [ ] 5. List other components that may have detrimental response
- [ ] 6. If possible, determine likelihood of failure
- [ ] 7. If possible, determine lowest threshold for detecting failure
- [ ] 8. Rank severity of failure
- [ ] 9. Document probabilistic risk analysis chart

Closed 2020-07-24.

Thread 25 (2020-05-05):

Flowmeter - air leak

Burhan-Q, 2020-05-05:
- [ ] 1. Determine failure testing procedure
- [ ] 2. Investigate possible sources of failure
- [ ] 3. Determine tolerances for failure mode
- [ ] 4. Establish component life cycle
- [ ] 5. List other components that may have detrimental response
- [ ] 6. If possible, determine likelihood of failure
- [ ] 7. If possible, determine lowest threshold for detecting failure
- [ ] 8. Rank severity of failure
- [ ] 9. Document probabilistic risk analysis chart

Closed 2020-07-24.

Thread 29 (2020-05-16):

Off the shelf parts

Burhan-Q, 2020-05-16:
Collect list of part numbers, specs, links, and documents for any/all off the shelf parts used. These will be listed in the final BOM and assembly documentation, for others to reference if looking to recreate the splitter system.

Burhan-Q, 2020-06-22:
### Tetra valve
v4-1

[G-74 - Compression Spring](https://www.centuryspring.com/catalog/?page=product&cid=root&id=G-74CS)
   Spring critical specifications:
spring rate = 0.385 N/mm (2.2 lbs/inch )
**minimum** inner diameter = 4.44 mm (0.175")
**max** solid length = 2.3 mm (0.09")

[O-Ring: -018 N70 NITRILE (NBR, BUNA) 70 DUROMETER BLACK](https://www.globaloring.com/product/n70018/)
[O-Ring: -020 N70 NITRILE (NBR, BUNA) 70 DUROMETER BLACK](https://www.globaloring.com/product/n70020/)
[O-Ring: -128 N70 NITRILE (NBR, BUNA) 70 DUROMETER BLACK](https://www.globaloring.com/product/n70128/)

v5
[G-74 - Compression Spring](https://www.centuryspring.com/catalog/?page=product&cid=root&id=G-74CS)
   Spring critical specifications:
spring rate = 0.385 N/mm (2.2 lbs/inch )
**minimum** inner diameter = 4.44 mm (0.175")
**max** solid length = 2.3 mm (0.09")

[O-Ring: -018 N70 NITRILE (NBR, BUNA) 70 DUROMETER BLACK](https://www.globaloring.com/product/n70018/)
[O-Ring: -020 N70 NITRILE (NBR, BUNA) 70 DUROMETER BLACK](https://www.globaloring.com/product/n70020/)

Burhan-Q, 2020-06-22:
### Shutoff valve

[4x O-Ring: -361 N75A Viton Fluoroelastomer](https://www.mcmaster.com/9464K623)
[2x Zinc-plated steel M4 x0.7 hex nut](https://www.mcmaster.com/90591A141)
[2x 18-8 stainless steel M4 x 0.7 screw 15 mm](https://www.mcmaster.com/92095A125)

Burhan-Q, 2020-06-29:
**Computer and Display**

[7" Touch display](https://www.raspberrypi.org/products/raspberry-pi-touch-display/)
[Raspberry Pi (additionally appropriate power supply, cables, storage, and other basic accessories](https://www.raspberrypi.org/products/raspberry-pi-4-model-b/)
_Notice: RPi4 in use for prototype, but at the moment no known limit for selecting a model; recommend RPi3 or newer_

capsulecorplab, 2020-07-07:
Linking Hannah's [Hardware parts list](https://docs.google.com/spreadsheets/d/1nCw9LUN7ygv8B8hno6poN-m15rsixNSolVTXhXynrfw/edit?usp=sharing) for cross-reference.

Thread 43 (2020-06-15):

add in the ability to have 20 minutes of power during a blackout

mmroden, 2020-06-15:
Need to have the ability to have 20 minutes of power during a blackout, meaning:
-- have to charge while on main power
-- have to switch over to battery when the power goes out
-- can be internal, does not need to be hot-swappable
-- not intended for transport, only intended for power outages

Judoguy12, 2020-07-10:
Can this be closed @mmroden

mmroden, 2020-07-10:
This is a design constraint around the system, so if we close it, we need to capture the constraint somewhere else to make sure we're testing for it.

Thread 49 (2020-07-07):

Tetra Valve springless design

Burhan-Q, 2020-07-07:
# Primary
- [x] update Tetra (flow control) valve design v5 to work without spring
- [ ] final valve design version will pass all tests

## v7-1
- [x] CHANGE: increase thread length for plunger to clear outlet opening

### Tested
- v7-1 FDM printed
  - difficult to determine setting; REQUEST: add markers and cap stop
- v7-1 SLA printed
  - resin in cap threads difficult to clean; REQUEST: larger threads and/or increase cap diameter
  - outlet leg overhang printing issue; REQUEST: add support

## v7-3
- [x] ADD: outlet leg support rib
- [x] ADD: cap stopper and indicator markings

## v7-4
- [x] ADD: increase thread pitch (SLA printing issue)
 > v7-4
- [x] ADD: adjust plunger cylinder clearance
 > v7-4-1 **untested**
- [x] CHANGE: plunger o-ring profile
 > v7-4-1 **untested**
### Tested
- v7-4 FDM printed
  - inlet o-ring overhang printer issue; REQUEST: less overhang
  - outlet coupler profile leaking air; REQUEST: adjust profile
- v7-4-1 SLA printed
  - resin in cap threads difficult to clean, cap broken
  - no other tests performed

## v7-5
- [x] CHANGE: outlet coupling profile
 > v7-5 **untested**
- [x] CHANGE: reduce inlet o-ring overhang
 > v7-5 **untested**
- [x] ADD: new circular thread profile
 > v7-5-1

### Tested
- v7-5-1 FDM printed
  - PRINT SAMPLE = verified circular thread profile works
- v7-5-1 SLA printed
  - PRINT SAMPLE = **waiting on feedback**

Closed 2020-07-23.

Thread 60 (2020-07-17):

separate 02_Development/ into software/ & hardware/

capsulecorplab, 2020-07-17:
- [ ] move `02_Development/Display/` to separate repo as per #62
- [ ] move CAD/Drawings/STL files from `02_Development/` to `hardware/`
- [ ] delete `02_Development` after above steps are complete

fpdotmonkey, 2021-02-10:
Is this necessary with the software in a separate repo?

Closed 2021-02-10.

Thread 62 (2020-07-19):

move python code for raspberry pi display to separate repo

capsulecorplab, 2020-07-19:
The python for the raspberry pi display would be best maintained in a separate repo, as to not confuse its version number or LICENSE with the CAD, STL, & Drawing (a.k.a hardware) files.

This is really a two part task consisting of:
- [x] adding display code in https://github.com/tetrabiodistributed/project-tetra-display
- [ ] removing display code from https://github.com/tetrabiodistributed/project-tetra

capsulecorplab, 2020-08-05:
Reopening, since display code still technically subsides in https://github.com/tetrabiodistributed/project-tetra/tree/master/02_Development/Display

mmroden, 2021-02-10:
This has been done.  https://github.com/tetrabiodistributed/project-tetra-display/pull/1

Closed 2021-02-10.

Thread 63 (2020-07-19):

Updates to P-PET-000008

mechatroniks-git, 2020-07-19:
1. NPT tap needs to be able to continue thru the hole and not bottom out
2. Concerns with self tapping screws in the plastic, request to use threaded inserts or (captured) nuts
3. O-ring can be larger OD and smaller cross-section to reduce screw clamping force

mechatroniks-git, 2020-07-19:
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

mechatroniks-git, 2020-07-27:
I went ahead and modified the printed part I have here, updated the fusion model to reflect the mods.

mechatroniks-git, 2020-07-27:
Mod looks good
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

Thread 64 (2020-07-20):

P-TET-000004-0 RPi display frame Design change

Burhan-Q, 2020-07-20:
- [x] Add 0.25 mm to current width on inside RPi display frame

cyunis, 2020-07-23:
video with description of issue
[20200720_141340.mp4.zip](https://github.com/tetrabiodistributed/project-tetra/files/4963838/20200720_141340.mp4.zip)

Burhan-Q, 2020-07-23:
@mechatroniks-git What material are you using to print this? The original dimensions for the part are shown in the image:
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

I will add an additional 0.25mm as you mentioned, but would like to track what kind of material shrinkage we're seeing to avoid future issues.

Burhan-Q, 2020-07-23:
@mechatroniks-git change has been made, ready for review. Going to move card to under review on project board.

mechatroniks-git, 2020-07-24:
@mmroden printed it with PLA

mechatroniks-git, 2020-07-24:
Since we already have a -0 STL in github, we need to bump the part number to a -1.

Dimension change appears to be good.
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

Burhan-Q, 2020-07-24:
Understood. I will update part text, but @mechatroniks-git, when I save the new part should I create a new milestone for Rev 1 and update the part number to reflect the revision?

mechatroniks-git, 2020-07-24:
I'd only save a milestone whenever you upload the file to git

Burhan-Q, 2020-07-24:
Agreed (with a minor caveat). I think we have a running discussion of this topic [here](https://helpfulengineering.slack.com/archives/G012Q55KWN7/p1595612022005500) about that. I think once we've hammered out the details, I'll be working with @cyunis to formalize it into the GitHub Docs.

mmroden, 2020-07-27:
less than a day to update, 2 days review

mmroden, 2020-07-27:
to be printed by Mark, reviewed by Patrick

mmroden, 2020-07-27:
will be printed in white

Burhan-Q, 2020-07-28:
@mmroden ready for printing
[P-TET-000004-1.zip](https://github.com/tetrabiodistributed/project-tetra/files/4989315/P-TET-000004-1.zip)

Burhan-Q, 2020-07-29:
@mmroden printed with a nice, uneven marbling; will reprint

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

mechatroniks-git, 2020-08-07:
Ready to test part when handoff is made

Burhan-Q, 2020-08-07:
> Ready to test part when handoff is made

@mmroden will you be able to get this part to @mechatroniks-git before/by next week? If not, recommend we move this ticket to Blocked (if there is no reply, I will move the ticket after 24 hours)

Burhan-Q, 2020-08-17:
@mmroden delivered to @mechatroniks-git this past weekend. Assigning to @mechatroniks-git for review/approval when available.

mechatroniks-git, 2020-08-26:
We will test this during assembly in the next few days

Closed 2020-09-01.

Thread 65 (2020-07-20):

Add part numbers and versions to models

Burhan-Q, 2020-07-20:
All printed parts need to have part number and current version/milestone text embossed or extruded located on the body when released. This will need to be done manually (unless possible to add python script to generate feature).

Burhan-Q, 2020-07-23:
Parts list to add part number boss:

- [ ] P-TET-000001-0	90 Degree Elbow
- [ ] P-TET-000002-0	Large T
- [ ] P-TET-000003-0	Ventilator_IO-T
- [x] P-TET-000004-0	RPi display frame
- [ ] P-TET-000005-0	Pressure Manifold (SLA)
- [ ] P-TET-000006-0	ISO Adapter w/ pressure port
- [ ] P-TET-000007A-0	Radial front & top panel joint
- [ ] P-TET-000007B-0	Radial front & top panel joint
- [ ] P-TET-000007C-0	Radial front & top panel joint
- [ ] P-TET-000007D-0	Radial front & top panel joint
- [ ] P-TET-000008-0	Pressure Manifold (FDM)
- [ ] P-TET-000009-0	Front Port Cover
- [ ] P-TET-000010-0	interior inspiratory support lower
- [ ] P-TET-000011-0	interior inspiratory support upper
- [ ] P-TET-000012-0	interior expiratory support upper
- [ ] P-TET-000013-0	interior expiratory support lower
- [ ] P-TET-000014-0	Handle
- [x] P-TET-000015-1	Corner Bracket Left
- [x] P-TET-000016-1	Corner Bracket Right
- [ ] P-TET-000017-0	RPi display mounting bracket
- [ ] P-TET-000018-0	Shut off Valve Main Body
- [ ] P-TET-000019-0	Shut off Valve Thru Body
- [ ] P-TET-000020-0	Shut off Valve Cap
- [ ] P-TET-000021-0	Shut off Valve Knob
- [ ] P-TET-000022-0	Tetra Valve Plunger
- [ ] P-TET-000023-0	Tetra Valve Main Body

Thread 66 (2020-07-20):

RPi display mounting brackets directionality

Burhan-Q, 2020-07-20:
Add directional indication arrows to outside of brackets

mechatroniks-git, 2020-07-21:
Or adjust design so part can by installed either way

cyunis, 2020-07-23:
[20200720_141804.mp4.zip](https://github.com/tetrabiodistributed/project-tetra/files/4963841/20200720_141804.mp4.zip)

Thread 100 (2020-07-21):

P-TET-000023 Design Updates

mechatroniks-git, 2020-07-21:
- [ ] Method to constrain nuts did not prevent them from spinning during assembly
- [ ] 22M port is not ISO-5356 compliant
- [ ] DFA - Remove extra one way valve nub if not needed to avoid assembly confusion
- [ ] DFAM - Darryl had recommendations for changes

cyunis, 2020-07-23:
Video showing failure to constrain nut from 7/20:
[20200720_173240.mp4.zip](https://github.com/tetrabiodistributed/project-tetra/files/4963913/20200720_173240.mp4.zip)

mmroden, 2020-07-27:
Time estimate: 2 days + 2 days revision

jgrano, 2020-07-30:
@mechatroniks-git 22M port is not ISO-5356 compliant same issue as on the shutoff valve.

jgrano, 2020-07-30:
https://github.com/tetrabiodistributed/project-tetra/blob/master/02_Development/Prototype_release/Alpha/Parts_to_print/P-TET-000023-1.stl - Normal

Burhan-Q, 2020-08-01:
As of today. @DHHwangPhD printed part[ P-TET-000028](https://github.com/tetrabiodistributed/project-tetra/blob/master/02_Development/Prototype_release/Alpha/Parts_to_print/P-TET-000028-0.stl) and at present is curing. Will deliver to @mechatroniks-git as soon as possible

Burhan-Q, 2020-08-05:
@mechatroniks-git if you could review P-TET-000028 (this is the version with the outlet steps) when you have a chance for the ISO fittings, I can export the STL to @DHHwangPhD for test printing once I get the green light from you

Burhan-Q, 2020-08-05:
Tetra valve female coupler (P-TET-000028 version) located in Tetra Valve Fusion folder

Opening diameter = 22.4mm
Length = 21mm (minimum spec)
End taper diameter = 21.8mm
Taper angle ~ 1.637 deg [full]

Did not remove sharp edge as I'm unsure if it will be an issue. Added fillets to aid transition regions

mechatroniks-git, 2020-08-05:
@Burhan-Q 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
Opening diameter is 22.37, not 22.40
Taper is 1.43deg = atan(1/40), not 1.637deg
Here is ISO Spec: https://www.iso.org/obp/ui#iso:std:iso:5356:-1:ed-4:v1:en

mechatroniks-git, 2020-08-05:
On this one, the taper is too short. The diameter at 15mm is correct (22.37mm), so need to extend the taper back another 6.5mm
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

Also, fillet this edge so it's not sharp
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

mechatroniks-git, 2020-08-05:
taper angle is wrong
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

mechatroniks-git, 2020-08-05:
Nuts are 7mm nominal, measuring 6.9mm, and the opening is 7.5mm, I'd reduce it to 7.1mm
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

Burhan-Q, 2020-08-06:
Tetra valve updates. Not sure how to redo outlet valve as single part without breaking geometry.

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

mechatroniks-git, 2020-08-06:
@Burhan-Q P-TET-000028 tweaked & reviewed, ready for test print.

Burhan-Q, 2020-08-06:
@DHHwangPhD ready for print testing. Please comment when you've started printing.

[P-TET-000028-1.zip](https://github.com/tetrabiodistributed/project-tetra/files/5037885/P-TET-000028-1.zip)

Judoguy12, 2020-08-24:
@jgrano Can you check if the heat inserts and oring's are added to the tetra valve bit, as they are not showing up in the animation, Jamie

Burhan-Q, 2020-08-26:
> @jgrano Can you check if the heat inserts and oring's are added to the tetra valve bit, as they are not showing up in the animation, Jamie

@Judoguy12 worst case you can check out the parts list [here](https://docs.google.com/spreadsheets/d/1nCw9LUN7ygv8B8hno6poN-m15rsixNSolVTXhXynrfw/edit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), find the correct size parts, and then add them into the model.

Judoguy12, 2020-08-28:
Do you have an idea of what o-ring it is on the middle part?

Burhan-Q, 2020-08-28:
> Do you have an idea of what o-ring it is on the middle part?

@Judoguy12 I looked at the model (A-TET-001030-0), and seems like it has an o-ring in it, PN V-MCM-9262K525

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

Judoguy12, 2021-02-10:
@mechatroniks-git I believed this is solved, the worked fine for my assembly

Thread 101 (2020-07-21):

A-TET-001010 - Drawing update

mechatroniks-git, 2020-07-21:
- [x] Reorder parts list, item #10 is missing

Judoguy12, 2020-07-22:
Should be good now @mechatroniks-git

mechatroniks-git, 2020-07-22:
There appears to be 2 drawing files for this assembly.
Remove the trail for the nut that doesn't make sense
You need to clean up the arrows
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

Judoguy12, 2020-07-22:
The trail on that nut can't go to there as fusion is tracking the nut back to where it came from as if it was all moved down at once

Judoguy12, 2020-07-22:
Done @mechatroniks-git

Closed 2020-07-24.

Thread 102 (2020-07-21):

P-TET-000004 - Design update

mechatroniks-git, 2020-07-21:
- [ ] Open up Pi Display pocket by .25mm (WAS:193.00mm, IS:193.25mm)
- [ ]  Add embossed part number to model

cyunis, 2020-07-23:
this issue was already opened by burhan (issue #64)

Closed 2020-07-24.

Thread 103 (2020-07-21):

P-TET-000009 Front port cover - Design Updates

mechatroniks-git, 2020-07-21:
- [x] Open up holes to allow ISO5356 22M port to clear
- [x] Add part # to model

Judoguy12, 2020-07-22:
@mechatroniks-git Where is this part located?

mechatroniks-git, 2020-07-22:
In the main assembly, it's the 4 dual port covers where the inspiratory/expiratory connections are

Judoguy12, 2020-07-23:
Updated and ready for review @mechatroniks-git

mechatroniks-git, 2020-07-24:
@Judoguy12 The hole is still too small.
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

Here is the ISO Spec
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

Judoguy12, 2020-07-24:
Done @mechatroniks-git

mmroden, 2020-07-27:
Patrick will review, John will approve

Burhan-Q, 2020-07-28:
PEER check - Port diameters are 22.75mm and have enough space between to allow for 2" filters

Closed 2020-07-31.

Thread 104 (2020-07-21):

P-TET-000018 - Design Updates

mechatroniks-git, 2020-07-21:

jgrano, 2020-07-30:
@mechatroniks-git Can you send me some more close up pictures of the sensirion and the mating problems on this thread?

jgrano, 2020-07-30:
@mechatroniks-git ISO5356 fitting is the same as we used originally on the Flow sensor model that you sent me. If there are dimensional errors, it's likely printing.

mechatroniks-git, 2020-07-31:
Comparing the sensirion 22M to the shutoff valve (P-TET-00018-0) port, with a 22F/22F coupler, the sensirion fits snugly and seals. The valve body bottoms out without sealing
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

mechatroniks-git, 2020-07-31:
Measurements:
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

mechatroniks-git, 2020-07-31:
@jgrano Checking the Sensirion model, it appears to match the ISO Spec pretty well. So the part I'm measuring might have some shrinkage from the injection molding process. I remeasured the sensor with my better calipers, got 22.29mm

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

Burhan-Q, 2020-08-01:
As of today. @DHHwangPhD printed part and is curing. Will deliver to @mechatroniks-git as soon as possible

Burhan-Q, 2020-08-04:
@mechatroniks-git and/or @jgrano please review update to Tetra valve female coupler (P-TET-000028 version) located in Tetra Valve Fusion folder

Opening diameter = 22.4mm
Length = 21mm (minimum spec)
End taper diameter = 21.8mm
Taper angle ~ 1.637 deg [full]

Did not remove sharp edge as I'm unsure if it will be an issue. Added fillets to aid transition regions

Burhan-Q, 2020-08-05:
Added revolve on both ports to conform to ISO standard with 1.432-degree taper angle from 22.2mm to 22.37mm over 15mm

@jgrano and/or @mechatroniks-git please review design and give 👍 if I'm okay to send this to @DHHwangPhD for test printing.

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

Burhan-Q, 2020-08-05:
Feedback from @mechatroniks-git on this part

https://github.com/tetrabiodistributed/project-tetra/issues/100#issuecomment-669461211
https://github.com/tetrabiodistributed/project-tetra/issues/100#issuecomment-669462750
https://github.com/tetrabiodistributed/project-tetra/issues/100#issuecomment-669500081

Burhan-Q, 2020-08-05:
> On this one, the taper is too short. The diameter at 15mm is correct (22.37mm), so need to extend the taper back another 6.5mm
> 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

Per the ISO spec, the 22.37mm diameter dimension for the male insert is to be at 15mm (unless I'm misreading the spec or unclear on the change needed here). Additionally, your comment from earlier on this Issue shows the same distance measurement.
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

Previous comment from July 31
> Measurements:
> 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

Burhan-Q, 2020-08-05:
> taper angle is wrong
> 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

@mechatroniks-git it looks like the measurement point is in the wrong spot
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

When I measure to the outside, I get 0.707-degrees which is still not half of 1.432-degrees (1.414-degrees), but it's quite close and again I was following the instructions you laid out above. I can reduce the outer radius to 10.99mm to get 1.49-degrees of taper if that's preferable.
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

Burhan-Q, 2020-08-06:
Shutoff valve updates
Taper now extends the entire length of ports
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

Nut capture openings now reduced to 7.1mm and added 0.3mm fillets
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

mechatroniks-git, 2020-08-07:
@Burhan-Q unless we have a good reason, we should strive to meet the ISO spec with a 1.432 deg taper, instead of 1.414.

Burhan-Q, 2020-08-07:
> @Burhan-Q unless we have a good reason, we should strive to meet the ISO spec with a 1.432 deg taper, instead of 1.414.

@mechatroniks-git I have no good rationale for keeping the larger angle. I've been focused the design updates primarily from the diameters for the locations, but since we last spoke I am more aware that the standard is more concerned with the taper than diameters. I will make this adjustment

Burhan-Q, 2020-08-07:
Design updated (v32) for port design to be based on taper angle, feature mirrored to other port.

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

mechatroniks-git, 2020-08-08:
@Burhan-Q Looks great, I think we should print one

Burhan-Q, 2020-08-12:
@DHHwangPhD, version ready for test printing

[P-TET-000018-2.zip](https://github.com/tetrabiodistributed/project-tetra/files/5065343/P-TET-000018-2.zip)

Burhan-Q, 2020-08-12:
Reassigned for test printing. After printing complete, assignment follows whomever has the physical part or goes to anyone agreeing to make design changes (if needed).

Thread 105 (2020-07-21):

P-TET-000006 - Design Updates

mechatroniks-git, 2020-07-21:
- [ ] ISO5356 22F port too small to mate with M-SEN-SFM3300 22M
- [ ] O-Ring groove in slip port too small, could not install o-ring
- [ ] Slip port is too loose, (27mm opening to 26mm tube)
- [ ] Tap NPT hole full depth
- [ ] Emboss part number in model

mechatroniks-git, 2020-07-23:
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

jgrano, 2020-07-24:
@mechatroniks-git Fusion still lacks this capability as a FYI for the NPT threads. The thread profile was made by using the MC part as a cutting tool.

jgrano, 2020-07-24:
@Judoguy12 made a quick change out the outer diameter of the ISO section of this part to increase wall thickness. Will print. The part was pulled from the main assembly and is now residing in \tubing in the fusion teams project as a fork.

jgrano, 2020-07-24:
@mechatroniks-git How do you feel about changing the NPT port to a straight threaded M3 and using push to connect for the air hose?

https://www.mcmaster.com/5225K519/

Judoguy12, 2020-07-24:
Please do that it is much easier

mechatroniks-git, 2020-07-24:
For this build, let's stick with parts on hand (time & cost). For next iteration, I don't know if M3 in FDM/SLA would be robust with the leverage that can be exerted during tubing insertion, much better for an aluminum part.

mechatroniks-git, 2020-07-24:
@Burhan-Q had designed this part, maybe the threads were added in Solidworks, not Fusion?

mmroden, 2020-07-27:
John will do it, Patrick will review, Jamie does final approval

mechatroniks-git, 2020-07-27:
@jgrano - for the NPT hole, if you can add a chamfer, it helps with tapping and installing

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

jgrano, 2020-07-29:
Printed out changes, Internal ISO fitting still feels a bit loose.

Judoguy12, 2020-07-29:
@jgrano Shoud be tighter now, if you were referring to the 26 dismeter hole

jgrano, 2020-07-29:
@mechatroniks-git Chamfer isn't coming out super clean on the npt section. Did some work around but still not super happy with it.

In addition I decreased the diameter of the ISO internal again since it is pushing too far along the shutoff/tetra valve ports before locking in place.  Printing again 7/29/20

jgrano, 2020-07-30:
Printing again 7/30/20

jgrano, 2020-08-01:
Had a print fail last night. Starting again today.

Burhan-Q, 2020-08-11:
@mechatroniks-git and @jgrano, just checking in on this issue. I'm seeing a mismatch in Part Number and Part Name on the title of this issue. According to the [hardware doc](https://docs.google.com/spreadsheets/d/1nCw9LUN7ygv8B8hno6poN-m15rsixNSolVTXhXynrfw/edit#gid=0&range=B6) P-TET-000005 is the Pressure Manifold (SLA) and P-TET-000006 is the ISO adapter.

I didn't want to make any changes to this issue before verifying what part is being worked on/discussed here. It appears there are notes for both parts in the above comments, but I'm also not seeing a separate issue for each of these parts. Please let me know what comments are associated with which part and then I'd be happy to separate the issues.

Thread 106 (2020-07-21):

P-TET-000001/2/3 - Design Updates

mechatroniks-git, 2020-07-21:
- [ ]  Update mating diameters for tighter fit with less clearance, based on expected part accuracy from FormLabs
- [ ]  Add alignment marks to ensure assembly of mating parts at the correct angle
- [ ]  Emboss part number in models

cyunis, 2020-07-23:
Video showing how we taped these parts together on 7/20:
[20200720_183919.mp4.zip](https://github.com/tetrabiodistributed/project-tetra/files/4963927/20200720_183919.mp4.zip)

mechatroniks-git, 2020-07-24:
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

mmroden, 2020-07-27:
Glue is the only question here, the rest of this may be bumped down to beta.

Thread 67 (2020-07-21):

Cable for Sensirion SFM3300-D

fpdotmonkey, 2020-07-21:

fpdotmonkey, 2020-07-21:
https://www.mill-max.com/products/new/rugged-4mm-pitch-spring-loaded-connectors

fpdotmonkey, 2020-07-21:
https://www.nxp.com/products/interfaces/ic-spi-serial-interface-devices/ic-bus-repeaters-hubs-extenders/i2c-bus-extender:P82B715

mechatroniks-git, 2020-07-28:
Attempted to use https://www.digikey.com/product-detail/en/avx-corporation/009155004201006/478-4684-1-ND/1687183
Contacts slip off the pad when compressed.
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

mechatroniks-git, 2020-07-28:
This Samtec part is better, but interferes: https://www.digikey.com/product-detail/en/samtec-inc/SIB-104-02-F-S-LC/SAM10715-ND/2664704

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

mechatroniks-git, 2020-07-29:
Going with this part should work: https://www.digikey.com/products/en?keywords=821-22-004-10-002101

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

fpdotmonkey, 2020-07-29:
Seems like this tab doesnt extend out far enough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

Burhan-Q, 2020-07-29:
@fpdotmonkey Just curious, did you try clipping it from both directions? Happy to extend that tab, let me know what Δ you're seeing as needed.

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

mechatroniks-git, 2020-07-29:
@hydronics2, here is the PCB DXF
[Sensirion PCB.zip](https://github.com/tetrabiodistributed/project-tetra/files/4996695/Sensirion.PCB.zip)

mechatroniks-git, 2020-07-29:
The step file:
[Sensirion PCB Assembly Mockup.zip](https://github.com/tetrabiodistributed/project-tetra/files/4996702/Sensirion.PCB.Assembly.Mockup.zip)

fpdotmonkey, 2020-07-29:
@Burhan-Q looking at it closer, I think the issue is actually the fillet on the inside corner of the part stopping it from fully engaging.  That said, it is clipping on and staying affixed. 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

fpdotmonkey, 2020-07-29:
It could also be a print quality issue.

Burhan-Q, 2020-07-29:
@fpdotmonkey I can make that a sharp corner if you'd like to check for a better fit. Let me know what you'd like to do.

fpdotmonkey, 2020-07-29:
Sure sounds good

fpdotmonkey, 2020-07-29:
Also what's the part number on this?

hydronics2, 2020-07-30:
@mechatroniks-git  you're cutting it kinda close here. I'd recommend moving the connector 1-2 mm outboard or just trimming the PCB 1-2mm. Any input?
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

hydronics2, 2020-07-30:
this is just a general note to remember for later... The P82B715 level shifts the i2c signals to 5V.
If we end up putting the 2nd chip on the master board,
be sure it level shifts back down to 3.3V or take other action as needed.

hydronics2, 2020-07-30:
@mechatroniks-git  do we need jumpers? I figure either the P82B715 is landed or it's not. Cheap small boards easy to switch between those with the P82B715 and those without. right? I can put them on no sweat just thought I'd simplify things as needed.

Burhan-Q, 2020-07-30:
> Also what's the part number on this?

@fpdotmonkey just now logged it on the [Hardware Parts List](https://docs.google.com/spreadsheets/d/1nCw9LUN7ygv8B8hno6poN-m15rsixNSolVTXhXynrfw/edit#gid=0&range=B29) as P-TET-000027

hydronics2, 2020-07-30:
@mechatroniks-git  for review
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

hydronics2, 2020-07-30:
@mechatroniks-git  for review
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

hydronics2, 2020-07-30:
@mechatroniks-git   for review
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

mechatroniks-git, 2020-07-31:
@hydronics2
Can we add a parallel cap on the IC? Datasheet calls for .1 and 1uF. Also, add a pullup on SDA1. Thanks

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

hydronics2, 2020-07-31:
@mechatroniks-git I made the changes... why only a pull-up on the SDA line and not an SCL line?
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

hydronics2, 2020-07-31:
@mechatroniks-git @fpdotmonkey @Burhan-Q  I submitted a pull-request. Here are the files. https://github.com/hydronics2/project-tetra/tree/master/02_Development/FlowMeter/Sensirion_connector_board
I estimated the pogo pin distance in the step file. The pogo pins stick out 5mm (0.197") from the board and the stroke is 1.39mm (0.055").
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

fpdotmonkey, 2020-08-01:
@Burhan-Q @hydronics2 ping me on slack when you have the board and the clip ready for me to print

hydronics2, 2020-08-01:
> @Burhan-Q @hydronics2 ping me on slack when you have the board and the clip ready for me to print

I posted a step file tin the link above. Check it out and see what you think.

fpdotmonkey, 2020-08-01:
@hydronics2 in application, are the header pins in the model you posted going to be replaced by the sprung pins like what Patrick suggested?

hydronics2, 2020-08-01:
Yes that's right. I put some header pins in their and tried to size them to 5mm to represent the pogo pins that will stick out 5mm from the board according tonl the data sheet I referenced (uncompressed)

fpdotmonkey, 2020-08-01:
@Burhan-Q so I tried filing out that fillet, and that didn't do anything.  However, I bent it a little so the internal angle on it is a bit smaller, and now the fit is a bit better.

fpdotmonkey, 2020-08-01:
It basically looks like the cross section picture you sent me, so I think it's good.  Time to add a feature for the pins to go through I suppose.

Burhan-Q, 2020-08-01:
Moved to Blocked. See notes [here](https://github.com/tetrabiodistributed/project-tetra/pull/111#issuecomment-667583686).
PCB revision required to address issue shown in image

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

hydronics2, 2020-08-01:
haha.. that's funny. I didn't move that part I swear.... but I can certainly move it outboard as many mm as necessary... say start with 8mm?

mechatroniks-git, 2020-08-03:
We have a mystery to solve, last I left it, the connectors were 8.43mm (center to center distance from the row).  Pushing it out 5mm would work, give me the center to center distance, and I can check.

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

Burhan-Q, 2020-08-03:
Perhaps it's the spacing from the front edge of the board to the phoenix connector thru holes? [both measurements captured in Fusion, from 'front face' of board to center of thru hole]

@mechatroniks-git board measurement **{M}**
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

@hydronics2  board measurement **{H}**
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

Profile view with phoenix connector visible, looks like there's a difference in phoenix connector position/length.

@mechatroniks-git **{M}**
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

@hydronics2 **{H}**
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

Burhan-Q, 2020-08-03:
> @Burhan-Q so I tried filing out that fillet, and that didn't do anything. However, I bent it a little so the internal angle on it is a bit smaller, and now the fit is a bit better.

@fpdotmonkey do you mean that I should decrease the angle of the clip section like this?
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

hydronics2, 2020-08-03:
@mechatroniks-git @Burhan-Q  So it looks like the pogo pins are fine but the large connector exact position needs to be resolved. I can put it wherever it needs to be. This is the latest revision...
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

Burhan-Q, 2020-08-03:
Blocked by #113

- [ ] adjust position of phoenix connector pins

fpdotmonkey, 2020-08-04:
@Burhan-Q the design for the clip is good no need to change it

Burhan-Q, 2020-08-05:
@fpdotmonkey clip updated with cut out for PCB. Ready for testing

[P-TET-000027-0.zip](https://github.com/tetrabiodistributed/project-tetra/files/5029886/P-TET-000027-0.zip)
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

Burhan-Q, 2020-08-05:
> @fpdotmonkey clip updated with cut out for PCB. Ready for testing

@fpdotmonkey please move to card to Testing bucket on project board and add Testing Label to the Issue once you begin printing.

fpdotmonkey, 2020-08-05:
First print of the clip didnt turn out so well. The hook that grabs the ledge nearest the PCB broke off while i was removing support material. Im going to try printing it with the PCB face down to see if that helps at all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

fpdotmonkey, 2020-08-05:
This is how I'm orienting the next print
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

fpdotmonkey, 2020-08-05:
The previous print was just like this one, but on the other outer face of the clip

fpdotmonkey, 2020-08-05:
Ok so the connector is nominally working!! The clip connects to the sensor perfectly, and the PCB slides right in. That said, i feel like its really easy to break the PCB-side hook while removing support, and the features for retaining the PCB didnt resolve super well in the print. 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

fpdotmonkey, 2020-08-05:
Also, the clip has a good bit of slop along the sensor's axis (~.075").  I'm concerned that this could cause a short between pins.

fpdotmonkey, 2020-08-05:
It also only takes a hair of pressure to remove the PCB.  Granted we'll see how hard it is to inert and remove when we have the actual board, but I think an iteration

Burhan-Q, 2020-08-05:
> Also, the clip has a good bit of slop along the sensor's axis (~.075"). I'm concerned that this could cause a short between pins.

@fpdotmonkey could you get me two photos of the extremes of the motion you're seeing, with the Sensirion facing the other direction? I'd looking to see how the harness is moving relative to this feature
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

fpdotmonkey, 2020-08-05:
Full right ![Uploading 89474819...]
Full left ![Uploading 89474827...]

fpdotmonkey, 2020-08-05:
You can most easily see the difference looking at the right edge of the clip.  I measured the displacement to about .075"

Burhan-Q, 2020-08-05:
What's the inside distance you measure on the Sensirion here?
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

hydronics2, 2020-08-06:
@fpdotmonkey @Burhan-Q  should I order the PCB?

Also Fletcher, just checking but you have the mating phoenix phoenix connector... maybe do a quick visual inspection to make sure it plugs in; that is,  the female connector can mate with the PCB-male-phoenix connector. make sense?

fpdotmonkey, 2020-08-06:
@hydronics2 yes order the PCB

fpdotmonkey, 2020-08-06:
@Burhan-Q that distance is .727"

hydronics2, 2020-08-06:
OK, PCB is ordered. thanks, thomas
Don't forget to order the pogo pins.
https://www.digikey.com/product-detail/en/mill-max-manufacturing-corp/821-22-004-10-002101/ED8199-04-ND/1146641

Burhan-Q, 2020-08-06:
> @Burhan-Q that distance is .727" or 18.47mm

> You can most easily see the difference looking at the right edge of the clip. I measured the displacement to about .075"

So I can tighten this up some if need be. I didn't know the exact spacing so I left 0.9mm clearance overall (which is about half the amount of movement you're seeing). The contact pads (on the Sensirion model) are 2.3 mm wide and have 0.24 mm gap between them, so I'll lower the spacing to 0.5mm and that should avoid any chance of a short between pins.

### Sensirion SFM3300-D model ###
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

### Clip current width ###
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

fpdotmonkey, 2020-08-07:
For the print, I used Hatchbox white PLA.  The spool is a few years old; idk if the material quality degrades over time.

For settings, I had the temps set to 225 end/80 plate, the "standard quality" template on Cura, and the retract speed set to 45mm/s

If there's a way to save out the entire settings file, I'd be happy to do that, but a quick search didn't yield me that result.

Burhan-Q, 2020-08-07:
> For the print, I used Hatchbox white PLA. The spool is a few years old; idk if the material quality degrades over time.
>
I believe it will if not humidity controlled

> For settings, I had the temps set to 225 end/80 plate, the "standard quality" template on Cura, and the retract speed set to 45mm/s
>

Those temps seem quite high (to me), I also use Hatchbox PLA and print at 200/50 w/ default retraction speed

> If there's a way to save out the entire settings file, I'd be happy to do that, but a quick search didn't yield me that result.

Would be one of the 2 CFG files found in this directory (Win10), not all settings are included, my settings for the print are shown at the bottom. You can also pull the settings from the GCODE file as well, I made a [PowerShell script](https://github.com/Burhan-Q/PowerShell_projects/blob/master/read_PrusaSlicer_gcode.ps1) that pulls the settings from a Prusa Slicer GCODE files (which should be mostly similar to the Cura files).

%APPDATA%\cura\

```
[general]
version = 4
name = creality_base_extruder_0 #2_user
definition = creality_ender3

[values]
brim_width = 2
filter_out_tiny_gaps = True
infill_enable_travel_optimization = True
infill_sparse_density = 15
ironing_only_highest_layer = True
retraction_hop_enabled = True
skirt_line_count = 2
speed_infill = 75
speed_print = 60
support_connect_zigzags = False
support_infill_rate = 10
support_tower_maximum_supported_diameter = 1
support_tree_angle = 60
support_tree_branch_diameter = 1
support_tree_branch_distance = 0.01
support_tree_collision_resolution = 0.1
support_wall_count = 0
wall_line_count = 4
wall_overhang_angle = 70
wall_overhang_speed_factor = 80
z_seam_type = sharpest_corner
```
**Additionally:**
adaptive_layers = True
layer_height = 0.2
slicing_tolerance = Middle

fpdotmonkey, 2020-08-11:
Got the board in, but it's wider than we expected. The one I 3D printed is 18.08mm wide, whereas this one is 18.88mm. We'll need to adjust the clip to handle this as presently it doesn't fit at all. @Burhan-Q 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

fpdotmonkey, 2020-08-11:
In case it's relevant, the fully extended length of the pogo pins from the top surface of the board is 6.79 mm and the fully retracted length is 5.76mm

fpdotmonkey, 2020-08-11:
The big green Pheonix connector is 16.14mm wide, 9.21mm deep, and 7.06mm above the top surface of the board

fpdotmonkey, 2020-08-11:
Here's a drawing of the dimensions of the board from the factory + me soldering the pogo pins and pheonix connector on
[Sensirion Connector Board.pdf](https://github.com/tetrabiodistributed/project-tetra/files/5059935/Sensirion.Connector.Board.pdf)

Burhan-Q, 2020-08-12:
@fpdotmonkey could you get me the inside dimensions (HxWxD) from the printed harness (height to under the hold downs)? The current model has an inside width of 19.80mm, so it seems there's some significant material shrinkage and knowing what the difference is will be instructive on how to modify the dimensions.

The model I printed measures:
   depth ~ 20.2mm
   height ~1.5mm (overall pcb harness height minus bottom of pcb harness to bottom of hold downs)
   width ~19.5mm

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

fpdotmonkey, 2020-08-13:
I'm getting 18.65mm.  I also noticed there was a bit of extra material there from bad printer settings, so I could change my settings to make it better.  But it may also be good to note on the drawing that the slot that the board goes into needs to be clean.

Burhan-Q, 2020-08-13:
> I'm getting 18.65mm. I also noticed there was a bit of extra material there from bad printer settings, so I could change my settings to make it better. But it may also be good to note on the drawing that the slot that the board goes into needs to be clean.

@fpdotmonkey, since we have essentially the same printer and filament, maybe you could try using my GCODE file to print the same version I did. That way we can narrow down the issue to printer settings or an issue with the printer or filament. I've attached a zip folder with two versions of my GCODE, one with bed mesh leveling, the other without (since I don't know which you use). These were sliced using Cura 4.3 setup for my Ender 3 using Hatchbox PLA. I don't expect the model to come out perfectly, but it should at least allow us to compare more directly the results from your printer and mine.

[40min_P-TET-000027-0.zip](https://github.com/tetrabiodistributed/project-tetra/files/5070047/40min_P-TET-000027-0.zip)

Additionally, I'm open to any other suggestions or ideas to troubleshoot this issue if you or anyone else have some. Please let me know if you have any questions or issues with the attached GCODE, and I'll keep an eye out for updates on your results.

fpdotmonkey, 2020-08-14:
So I printed a couple, and the widths are 18.55mm and 17.84mm.

Other than that, I think the diagonal orientation for the part you're doing is a lot better that the flat one I've been doing.  Way less cleanup and so less risk of breaking the part.  There's also virtually no slop along the sensor's axis and the snap onto the sensor is very clear and satisfying.

fpdotmonkey, 2020-08-14:
_If it fits it ships_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

fpdotmonkey, 2020-08-14:
Things left to do in testing

- [ ] theres a bit of slop now in the sensor axis still. Probably not consequential, but increasing that width a smidge would be nice
- [ ] validate that the electrical connection is good
- [ ] make 4 at once

After all that, I'm ready to say this part passes review

fpdotmonkey, 2020-08-14:
Oh also, is the intention for assembling this that the PCB and the clip are put together before the clip is attached to the sensor?  If not, then board doesn't do that.  I think the issue could be that there's a little resistor on the sensor that would block the pogo pin from pushing forward.

Burhan-Q, 2020-08-15:
> Oh also, is the intention for assembling this that the PCB and the clip are put together before the clip is attached to the sensor? If not, then board doesn't do that. I think the issue could be that there's a little resistor on the sensor that would block the pogo pin from pushing forward.

@fpdotmonkey Yes, the aim (as far as I'm aware) would be to put the PCB into the harness and then attach to the sensor. Just to clarify, you're saying that assembling the clip and the PCB control board first, then to the sensor **_is_** possible?

Burhan-Q, 2020-08-15:
STL file for P-TET-000027-0
[P-TET-000027-0.zip](https://github.com/tetrabiodistributed/project-tetra/files/5079246/P-TET-000027-0.zip)

Burhan-Q, 2020-08-15:
@fpdotmonkey are the design changes you mentioned critical for this iteration or are they lower priority (pushed out for beta)?

fpdotmonkey, 2020-08-15:
The design change I suggested isn't critical

fpdotmonkey, 2020-08-15:
> you're saying that assembling the clip and the PCB control board first, then to the sensor is possible?

Yes this is possible

Burhan-Q, 2020-08-17:
> The design change I suggested isn't critical
Okay, then I will make a new ticket for these changes and tag them for the beta prototype

@fpdotmonkey Are you willing to act as reviewer for this design since you've got the printed part(s)? You can review the assembly [here](https://a360.co/2DtJcij) on the web.

I will remove myself from the assignment while you're reviewing. Once you have finished your review, comment here with the outcome of your review, then please assign the task to me (and remove your assignment), and finally if the design passes your review, please indicate that the design is ready for approval.

Closed 2020-09-01.

Thread 71 (2020-07-21):

⇑ A-TET-001003-0 Pressure Manifold Explode

Burhan-Q, 2020-07-21:
**Create exploded view:** A-TET-001003-0 Pressure Manifold
- [ ] Assigned _(specify assignees)_
- [ ] Work in Progress _(move card on Project Board)_
- [ ] Submit for Review _(assign reviewer, comment, & move on Project Board)_
- [ ] Working on Review changes _(comment w/ list of changes and date)_
- [ ] Review complete _(assigned reviewer comment with approved date)_

mechatroniks-git, 2020-08-07:
Exploded view looks good
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

Closed 2020-08-07.

Thread 76 (2020-07-21):

⇑ A-TET-001010-0 Tetra Valve with One Way Exploded

Burhan-Q, 2020-07-21:
**Create exploded view:** A-TET-001010-0 Tetra Valve with One Way
- [x] Assigned _(specify assignees)_
- [x] Work in Progress _(move card on Project Board)_
- [x] Submit for Review _(assign reviewer, comment, & move on Project Board)_
- [ ] Working on Review changes _(comment w/ list of changes and date)_
- [ ] Review complete _(assigned reviewer comment with approved date)_

Judoguy12, 2020-07-21:
21/07/2020 @mechatroniks-git

Burhan-Q, 2020-07-24:
I'm not 100% on this, but I would think that since the o-ring is installed from the bottom side, you'd want to move it under that section of the valve. I say this since I think the idea of the drawings is to demonstrate how this would be assembled, so the parts should be positioned relative to how they'll be installed. Otherwise, I think this looks good

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

Judoguy12, 2020-07-24:
Did that not update? i had moved that 😓

Judoguy12, 2020-07-24:
@Burhan-Q Should be fixed now

Burhan-Q, 2020-07-24:
Exploded view looks ready for drawing #77

Closing issue

Closed 2020-07-24.

Thread 77 (2020-07-21):

⇓ Tetra Valve with One Way Drawing

Burhan-Q, 2020-07-21:
#76 **Create exploded view** Required to finish before drawing is made

Judoguy12, 2020-07-21:
21/07/2020 @mechatroniks-git

Judoguy12, 2020-07-22:
Blocked awaiting updated logo, title block, copyright, license and notes.

mmroden, 2020-07-27:
Jamie can work with someone to update the template, Hannah will with Jamie.
Burhan will do the review
Patrick will do the final approval

mechatroniks-git, 2020-07-27:
#95 is a related issue

Judoguy12, 2020-08-26:
Ready for review now in the Jamie folder @Burhan-Q

Thread 81 (2020-07-21):

⇑ Tetra Inspiratory/Expiratory Splitter Exploded

Burhan-Q, 2020-07-21:
**Create exploded view:** A-TET-001012-0 Tetra Inspiratory/Expiratory Splitter

Burhan-Q, 2020-08-25:
Attempt to combine with #89 per discussion from meeting on 2020-08-24

Thread 85 (2020-07-21):

Standalone Shut Off valve Exploded

Burhan-Q, 2020-07-21:
**Create exploded view:** A-TET-001015-0 Standalone Shut Off valve

Judoguy12, 2020-07-22:
22/07/2020 @mechatroniks-git

Judoguy12, 2020-07-24:
@Burhan-Q Ready for review

Burhan-Q, 2020-07-24:
When first opened Exploded view, components were hidden
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

Burhan-Q, 2020-07-24:
@Judoguy12
- [ ] move blue highlighted parts up some
- [ ] P-TET-000020-1 needs to be clear of base
- [ ] try to space o-rings evenly
- [ ] remove leader line from nut (unless it can be shown as inserting into catch

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

Judoguy12, 2020-07-24:
@Burhan-Q All fixed now

mmroden, 2020-07-27:
1 day estimate

Burhan-Q, 2020-07-28:
@Judoguy12 Exploded view looks good, ready for approval @mechatroniks-git

Thread 87 (2020-07-21):

⇑ Expiratory Support mounts Exploded

Burhan-Q, 2020-07-21:
**Create exploded view:** A-TET-001014-0 Expiratory Support mounts

Judoguy12, 2020-07-22:
22/07/2020 @mechatroniks-git to review

Judoguy12, 2020-07-24:
@Burhan-Q Ready for review

Burhan-Q, 2020-07-24:
@Judoguy12, please point me where to find this exploded view, I'm unable to locate it. Should only need to comment with the Directory and Filename, no direct link needed.

Judoguy12, 2020-07-24:
@Burhan-Q Animations tab of the prototype v1 system, storyboard with the largest number

mmroden, 2020-07-27:
Burhan will review, John will do final approval

Burhan-Q, 2020-07-28:
@jgrano review changes look good, ready for approving

Burhan-Q, 2020-07-28:
@Judoguy12 consider making the following changes:
- [ ] adjust view so left edge is at (or nearly) 90-degrees
- [ ] **OPTIONAL** add leader lines for the screws
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

Burhan-Q, 2020-07-28:
@Judoguy12  Exploded view looks good. @jgrano ready for approval

mechatroniks-git, 2020-07-29:
@Burhan-Q Missing the heated inserts (x 4)

Burhan-Q, 2020-07-30:
@Judoguy12 can you add the heat-serts and comment when updated? I believe it would be [these](https://www.mcmaster.com/94180A353/), but check the hole depth. You can find the off-the-shelf parts list [here ](https://docs.google.com/spreadsheets/d/1nCw9LUN7ygv8B8hno6poN-m15rsixNSolVTXhXynrfw/edit#gid=80304938&range=A1)if you need it

Judoguy12, 2020-07-30:
Done @Burhan-Q

mechatroniks-git, 2020-08-05:
Can we make these parts the same? Also, the diameter of each of these is different?

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

mechatroniks-git, 2020-08-07:
Fusion search for 001014 not coming up with any results, need to pull this subassembly out of the main assembly

Burhan-Q, 2020-08-25:
Reassigned to @Judoguy12 per discussion from meeting on 2020-08-24

Drawing appears to be ready for approval. @Judoguy12 will need to find an approver and assign the task to the approver (exclusively), once approver has provided feedback or approved, the assignment returns to @Judoguy12 until documentation is ready for pull request. All prior feedback is still applicable for the work to be considered complete and ready for approval.

Judoguy12, 2020-08-26:
@Burhan-Q Ready to approve

Thread 91 (2020-07-21):

⇑ Tetra Electronics Exploded

Burhan-Q, 2020-07-21:
**Create exploded view:** A-TET-001009-0 Tetra Electronics

### Included components
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

- [ ] Assigned _(specify assignees)_
- [ ] Work in Progress _(move card on Project Board)_
- [ ] Submit for Review _(comment w/ date and assigned reviewer)_
- [ ] Working on Review changes _(comment w/ list of changes and date)_
- [ ] Review complete _(assigned reviewer comment with approved date)_

Burhan-Q, 2020-08-25:
This Issue might be deemed stale per discussion from meeting on 2020-08-24 as electronics assembly exploded drawing might not be required.

Will move this into Icebox until further notice. If 45 days have passed since this comment with no action, this issue can be considered closed unless overruled by @mmroden or @mechatroniks-git

Thread 92 (2020-07-21):

⇑ Tetra Electronics Drawing

Burhan-Q, 2020-07-21:
**Create exploded view** Required to finish before drawing is made

### Included components
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

- [ ] Exploded view created
- [ ] Assigned _(specify assignees)_
- [ ] Work in Progress _(move card on Project Board)_
- [ ] Submit for Review _(comment w/ date and assigned reviewer)_
- [ ] Working on Review changes _(comment w/ list of changes and date)_
- [ ] Review complete _(assigned reviewer comment with approved date)_

Burhan-Q, 2020-08-25:
See recent comment on #91 regarding status. Issue male be stale, moving to Icebox with 45 day no action limit to close Issue.

Thread 93 (2020-07-21):

⇑ Tetra Enclosure Body Exploded

Burhan-Q, 2020-07-21:
**Create exploded view:** A-TET-001007-0 Tetra Enclosure Body

### Included components
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

- [ ] Assigned _(specify assignees)_
- [ ] Work in Progress _(move card on Project Board)_
- [ ] Submit for Review _(comment w/ date and assigned reviewer)_
- [ ] Working on Review changes _(comment w/ list of changes and date)_
- [ ] Review complete _(assigned reviewer comment with approved date)_

Burhan-Q, 2020-08-25:
Unassigned per discussion from meeting on 2020-08-24

Requires individual housing part numbers and components to be created, as well as enclosure assembly. Potentially could use flat pattern of folded sheet metal parts.

Thread 94 (2020-07-21):

⇓ Tetra Enclosure Body Drawing

Burhan-Q, 2020-07-21:
#93 **Create exploded view** Required to finish before drawing is made

### Included components
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

- [ ] Exploded view created
- [ ] Assigned _(specify assignees)_
- [ ] Work in Progress _(move card on Project Board)_
- [ ] Submit for Review _(comment w/ date and assigned reviewer)_
- [ ] Working on Review changes _(comment w/ list of changes and date)_
- [ ] Review complete _(assigned reviewer comment with approved date)_

Burhan-Q, 2020-08-25:
Unassigned per discussion from meeting on 2020-08-24

Requires individual housing part numbers and components to be created, as well as enclosure assembly. Potentially could use flat pattern of folded sheet metal parts.

Thread 95 (2020-07-21):

Create Drawing Template

Burhan-Q, 2020-07-21:
- [x] Assigned _(specify assignees)_
- [x] Work in Progress _(move card on Project Board)_
- [x] Submit for Review _(comment w/ date and assigned reviewer)_
- [x] Working on Review changes _(comment w/ list of changes and date)_
- [ ] Final Review complete _(assigned reviewer comment with approved date)_

Burhan-Q, 2020-07-21:
Status update: awaiting logo design from @thehannahfink and @cyunis for adding to template

Burhan-Q, 2020-07-21:
@jgrano Assigned as Reviewer

mechatroniks-git, 2020-07-23:
Drawing templates needed (mostly just notes changes)
- FDM Part Template (perhaps make it 2 sheets, 2nd sheet for heated inserts/post processing)
- SLA Part Template
- Assembly Template

Notes on Assembly Template:
```
Notes (unless otherwise specified):
1. This drawing is construed as information only, it is complete only to the degree necessary to illustrate a system definition for assembly

```

mechatroniks-git, 2020-07-31:
@Judoguy12 I updated the template
- Replaced logo with a image with transparent background I created. (@thehannahfink, do you have a set of PNGs with high resolution and transparent backgrounds?)
- Added units, tolerances and 3rd angle projection box

todo:
Look at replacing the font with Helvitica Bold?
update notes
add open source license info?

Judoguy12, 2020-08-03:
Ready for review @jgrano 3/8/2020

mechatroniks-git, 2020-08-03:
Title block needs help, logo looks rough, @thehannahfink can we do SVG art? [Fusion ](https://knowledge.autodesk.com/support/fusion-360/learn-explore/caas/sfdcarticles/sfdcarticles/How-to-import-SVG-files-in-Fusion-360.html)allows it to be added.
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

Copyright notice - @capsulecorplab does this look right?

Judoguy12, 2020-08-03:
@mechatroniks-git Fusion would not allow the SVG to be added I had to convert to transparent PNG

Judoguy12, 2020-08-03:
@mechatroniks-git fixed address appearing

capsulecorplab, 2020-08-04:
@mechatroniks-git copyright notice looks good!

mechatroniks-git, 2020-08-05:
@Judoguy12 we need to place our web address somewhere

Judoguy12, 2020-08-05:
@mechatroniks-git Is that better or shall i remove the company name above the web address
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

mechatroniks-git, 2020-08-05:
The TETRA BIO DISTRIBUTED is redundant and doesn't match the style guidelines, so best to remove that
The unnecessary blank-space above & below the logo/name should be eliminated.
Maybe swap the logo with the website or combine them in 1 box?

Judoguy12, 2020-08-06:
iS THIS BETTER?
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

thehannahfink, 2020-08-06:
[There is a version on the Git with just the logo and no title](https://github.com/tetrabiodistributed/tetrabiodistributed.github.io/blob/create-logo-6/assets/logo/black/tetra_logo_black_100_x_100_px.svg) if that's the logo version you want. The website should be all on one line, so maybe make the font size small enough to fit without a line break. I liked the website better on far-right column. Should be underneath the Project block in its own "website" block though.

Closed 2020-08-31.

Thread 96 (2020-07-21):

A-TET-001005 - Add wires to assembly

mechatroniks-git, 2020-07-21:
Need to add power and ground wires to the assembly. These typically come with the RPi display, but they need to be added as a component (virtual or modeled) and noted they need to be modified

Burhan-Q, 2020-07-23:
Added virtual (empty) components to assembly, moving ticket to Review

mechatroniks-git, 2020-07-24:
Try to use the existing nomenclature to avoid confusion during assembly:
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

Burhan-Q, 2020-07-24:
@mechatroniks-git, Understood I will make these changes. The wires appeared to be grounding wires in the photos/videos posted but I did not look up they're purpose, and thought with respect to the BOM the wires would not need color specification.

Once changes are complete, should the Revision Number for the assembly be updated due to the addition of the virtual components?

mechatroniks-git, 2020-07-24:
This would be a drawing revision from - to A. The assembly didn't change, just a documentation change.

Burhan-Q, 2020-07-24:
Understood. Changes have been made. Please close if approved

mmroden, 2020-07-27:
Jamie will do final approval

Judoguy12, 2020-07-28:
Approved 28/07/2020

Burhan-Q, 2020-08-05:
Issue can be closed when #80 is complete and ready for pull request

Closed 2020-09-01.

Thread 97 (2020-07-21):

P-TET-000021 Shutoff valve Knob - Design Updates

mechatroniks-git, 2020-07-21:
- [x]  Thin wall section can't print, needs to be cut back or thickend up.
- [x]  Loose fit when mating to P-TET-000019
- [x]  Needs more clearance when mating to P-TET-000020
- [ ]  Consider DFAM tweaks
- [x]  Emboss part number to model

cyunis, 2020-07-23:
Videos from 7/20 showing screw details mostly and modifications to improve fit:
(also see Issue #98 for more videos of part P-TET-000021 with P-TET-000019 fit)

[20200720_181008.mp4.zip](https://github.com/tetrabiodistributed/project-tetra/files/4963976/20200720_181008.mp4.zip)

mechatroniks-git, 2020-07-23:
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

jgrano, 2020-07-23:
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
0.25mm spacing between the knob and the inner stub on part 20

mmroden, 2020-07-27:
1 day + 2 days revisions

jgrano, 2020-07-29:
@mechatroniks-git We're ready to have you print this.

jgrano, 2020-07-30:
https://github.com/tetrabiodistributed/project-tetra/blob/master/02_Development/Prototype_release/Alpha/Parts_to_print/P-TET-000021-1.stl

mechatroniks-git, 2020-07-31:
Printing

mechatroniks-git, 2020-08-04:
The knob appears to fit to P-TET-000019 Shutoff Valve Thru Body pretty well. Need to adjust P-TET-000020 to allow for clearance when spinning.

Closed 2020-08-04.

Thread 98 (2020-07-21):

P-TET-000019 Design Fixes

mechatroniks-git, 2020-07-21:
- [ ] O-ring grooves too tight
- [ ] OD fit with SLA tetra valve was ok, but with FDM shutoff valve, it was a bit tight
- [ ] Pocket to hold nut needs to be changed so that nut doesn't spin
- [ ] Consider modifying pocket to hold nut such that nut kept centered during assembly (drop in to shallow pocket?)

cyunis, 2020-07-23:
Videos from 7/20:
[Archive.zip](https://github.com/tetrabiodistributed/project-tetra/files/4963966/Archive.zip)

mechatroniks-git, 2020-07-23:
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

jgrano, 2020-07-23:
Took all above notes into consideration rework of this part. Will reprint 7/23 and verify fit w/o o-rings

Judoguy12, 2020-07-23:
John, when you save the part you could put in the reason for saving the
issue number so it is traceable

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

jgrano, 2020-07-23:
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
@Judoguy12 so add #98 to the final save?

jgrano, 2020-07-23:
Final save of design and starting to print based on all feedback.

Burhan-Q, 2020-07-27:
Darryl to print for testing

jgrano, 2020-07-29:
Body that I printed works great, integrates fine with existing shutoff valve body.  Waiting for verification from Darryl

mechatroniks-git, 2020-07-29:
John, nice work. Can I go ahead and print the FDM parts on this?  should I pull STLs from Fusion? Point me in the right direction, want to make sure I print the right ones. Thanks.

jgrano, 2020-07-31:
https://github.com/tetrabiodistributed/project-tetra/blob/master/02_Development/Prototype_release/Alpha/Parts_to_print/P-TET-000019-2.stl

Burhan-Q, 2020-07-31:
> https://github.com/tetrabiodistributed/project-tetra/blob/master/02_Development/Prototype_release/Alpha/Parts_to_print/P-TET-000019-2.stl

@DHHwangPhD ready for testing

mechatroniks-git, 2020-08-04:
Part fits knob much better, nut capture is good also. O-ring compression is too much. Need to revise. Currently it is a 2mm o-ring compressed 35%. We should try 10% compression. See https://www.marcorubber.com/o-ring-groove-design-considerations.htm

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

mechatroniks-git, 2020-08-05:
Reduced o-ring groove ID such that o-ring compression is 10%, not 35%. Should make it easier (possible) to assemble.

Bumped part number embossed on part to P-TET-000019-3

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

Ready to print & test

mechatroniks-git, 2020-08-07:
design updated to -3, ready for review @Burhan-Q

Burhan-Q, 2020-08-07:
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
I'm seeing the change as 1.90 mm (5% of 2mm o-ring). If this is still okay, then I think this part looks good.

General note for main body vs thru body nut capture dimensions, request was to reduce main body nut capture to 7.1 mm [here](https://github.com/tetrabiodistributed/project-tetra/issues/100#issuecomment-669500081), but stated above that this size (7.3 mm) was good.

> Part fits knob much better, nut capture is good also.

Burhan-Q, 2020-08-07:
@jgrano @Judoguy12
Ready for approval for whoever is available. Please self assign this issue if you're able to Approve

mechatroniks-git, 2020-08-07:
@Burhan-Q good catch on the oring groove depth. I'm ok to test it with 5% compression on first article

Burhan-Q, 2020-08-17:
Latest model milestone
[P-TET-000019-3.zip](https://github.com/tetrabiodistributed/project-tetra/files/5086555/P-TET-000019-3.zip)

Thread 99 (2020-07-21):

P-TET-000022 Design Fixes

mechatroniks-git, 2020-07-21:
- [ ] Check o-ring groove
- [ ] OD of bore as it mated with P-TET-000023 was too tight, need to reduce to avoid interference
- [ ] Reduce amount of material used in part, cost saving

cyunis, 2020-07-23:
Videos of sanding part to fit (and cleaning after) on 7/20:
[Archive.zip](https://github.com/tetrabiodistributed/project-tetra/files/4963879/Archive.zip)

mmroden, 2020-07-27:
2 day estimate + 2 day revision

jgrano, 2020-07-30:
https://github.com/tetrabiodistributed/project-tetra/blob/master/02_Development/Prototype_release/Alpha/Parts_to_print/P-TET-000022-1.stl

Burhan-Q, 2020-07-31:
@DHHwangPhD please comment when printing has started

Burhan-Q, 2020-08-01:
As of today. @DHHwangPhD printed part and is curing. Will deliver to @mechatroniks-git as soon as possible

mechatroniks-git, 2020-08-06:
P-TET-000022 is now replaced by A-TET-000018, ready for review
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

mechatroniks-git, 2020-08-06:
I would advise holding off on printing the part until we can review print from 5 days ago

Burhan-Q, 2020-08-06:
> I would advise holding off on printing the part until we can review print from 5 days ago

We can hold off, but I recall @DHHwangPhD saying that the last print didn't go well (which is why this change was made by @jgrano). I'll double check with him to see how he wants to proceed with this part.

Burhan-Q, 2020-08-06:
@mechatroniks-git I spoke with @DHHwangPhD and he said that the previous model did not work and would like to print this version. I did a quick review and thing appear okay. I'm going to share the new cap design with him as well as the Tetra valve body #100 part for testing.

Per FormLabs post about threaded inserts for resin prints, they say that the inserts should go in before curing. Of course we could also drill out the cap and glue/epoxy it in after curing, but perhaps it would be worth having Darryl get some from you or order some for the other prints.

Burhan-Q, 2020-08-06:
@DHHwangPhD ready for print testing. Please comment when you've started printing.

Plunger
[P-TET-000030-0.zip](https://github.com/tetrabiodistributed/project-tetra/files/5037913/P-TET-000030-0.zip)

Cap
[P-TET-000031-0.zip](https://github.com/tetrabiodistributed/project-tetra/files/5037914/P-TET-000031-0.zip)

Thread 107 (2020-07-24):

Organize tickets/ issues to different repos

chrismolinari456, 2020-07-24:
Organize issues and tickets to their respective repos/ boards, which this ticket is ironically contributing to.

chrismolinari456, 2020-07-24:
Can't assign this to me for some reason right now, but I will take care of it

Judoguy12, 2020-07-24:
Assigned you

capsulecorplab, 2020-07-29:
PSA: every repo should have its own project board now!

Burhan-Q, 2020-08-26:
> PSA: every repo should have its own project board now!

@capsulecorplab should this ticket get closed?

capsulecorplab, 2020-08-26:
Closing!

Closed 2020-08-26.

Thread 108 (2020-07-27):

P-TET-000001/2/3 Piping manifold design updates

Burhan-Q, 2020-07-27:
Branch of issue #106

Need to determine Glue for tubing parts

@DHHwangPhD & @Burhan-Q (checking with FormLabs)

- possible to use liquid resin and cure with UV flashlight
- potential to use E6000 as a glue

Burhan-Q, 2020-07-30:
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
From [FormLabs blog article](https://formlabs.com/blog/how-to-create-models-larger-than-your-3d-printers-build-volume/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)

Burhan-Q, 2020-07-30:
[adhesive strengths for 3D printed bars](https://pinshape.com/blog/discover-the-best-adhesive-for-your-project/)
[FormLabs forum comment](https://forum.formlabs.com/t/is-there-an-instant-glue-for-formlab-resin-prints/8978/3)
[FL forum discussion on laser resin gluing](https://forum.formlabs.com/t/deeper-laser-gluing-curing-discussion/21792)
[FL general gluing discussion](https://forum.formlabs.com/t/how-do-you-glue-pieces-together/6168/10)
[FL more gluing discussions](https://forum.formlabs.com/t/glue-for-assembly/1856)

Burhan-Q, 2020-07-31:
@DHHwangPhD have any input on which direction we should go? I'm thinking a normal CA super glue might make the most sense for now.

Burhan-Q, 2020-08-01:
Spoke with @DHHwangPhD. Determined 2 means for adhering resin parts to keep air tight:

Primary: Attach with printer resin and cure with handheld UV light
Secondary: Attach using 5 minute epoxy

Darryl has UV light on order, but not likely to arrive in time for Alpha prototype assembly. @mechatroniks-git do you have or could you obtain 5 minute epoxy for assembly?

mechatroniks-git, 2020-08-03:
@Burhan-Q I have a few 2-part epoxy options

Burhan-Q, 2020-08-03:
Excellent @mechatroniks-git, thank you. Do you think we're ready to close this issue?

Closed 2020-08-03.

Thread 110 (2020-07-29):

[DRAFT] Sprint-2 Alpha parts printing queue

Burhan-Q, 2020-07-29:
# DRAFT #
This Issue is a draft outline for a means to track our printing queue for the Alpha Prototype Sprint-2. Once approved for use, this ticket will be closed and new issue will be created to actually use for production. Please comment on this Issue for discussion of changes or suggestions needed, or to communicate your approval for using this format.

----------------------------------------------------------------------------------------------------------------------------------------------

**Files ready for release will be listed in the first section below and contain an active link to the file for printing ONLY when that part has been released.**

## Instructions ##
1. Find part ready for printing in list below
2. If you're able to print a part, click and drag the checkbox for that part under your name.
   - Move under Printing in queue if you can print the part but can't begin immediately
   - Move to Printing in progress if print can start immediately.
3. After all quantities of part have been printed, click checkbox to mark as complete
4. Add comment to this issue with the following information for **each** Part:
   - Type, Brand, and Name of Material used
   - Layer height, InFill %, Critical Printer settings
   - Any important notes or photos with respect to printing the part

### Released Parts for printing ###
- [x] _reserve_
- [x] \[SLA/FDM P-TET-000000-X Description xN](STL_file_link)
- [ ] \[SLA/FDM P-TET-000000-X Description xN](STL_file_link)
- [ ] \[SLA/FDM P-TET-000000-X Description xN](STL_file_link)

----------------------------------------------------------------------------------------------------------------------------------------------
   ## Darryl SLA & FDM ##
### Printing in progress ###
- [x] _reserve_

### Printing in queue ###
- [x] _reserve_

----------------------------------------------------------------------------------------------------------------------------------------------
   ## Mark FDM ##
### Printing in progress ###
- [x] _reserve_

### Printing in queue ###
- [x] _reserve_

----------------------------------------------------------------------------------------------------------------------------------------------
   ## Patrick FDM ##
### Printing in progress ###
- [x] _reserve_

### Printing in queue ###
- [x] _reserve_

----------------------------------------------------------------------------------------------------------------------------------------------
   ## OTHER SLA/FDM ##
### Printing in progress ###
- [x] _reserve_

### Printing in queue ###
- [x] _reserve_
----------------------------------------------------------------------------------------------------------------------------------------------

Burhan-Q, 2020-07-31:
@jgrano @mechatroniks-git @DHHwangPhD

Please check this out and comment with your thoughts about using this format for tracking the print queue

Burhan-Q, 2020-07-31:
@chrismolinari456

chrismolinari456, 2020-07-31:
I'm a bit confused; will this be a separate project board that will have all of our names and the parts? Or does the issue itself support a drag/ drop interface?
I like the shift personally; it keeps everything in one place and cards are easier to edit/ move than cells of text

Burhan-Q, 2020-07-31:
> I'm a bit confused; will this be a separate project board that will have all of our names and the parts? Or does the issue itself support a drag/ drop interface?

Yes it does, if you hover over one of the checkboxes, you should see 3 horizontal bars pop up on the left, you can click and drag those (if you do, please move it back so others see the original)

chrismolinari456, 2020-07-31:
Just checked it out on a test repo and it seems to work pretty well, but for some reason I can't edit it here. Maybe because I haven't done contributed to the main repo

DHHwangPhD, 2020-07-31:
This works for me.

Burhan-Q, 2020-08-01:
> Just checked it out on a test repo and it seems to work pretty well, but for some reason I can't edit it here. Maybe because I haven't done contributed to the main repo

Hm, maybe double check with @capsulecorplab on permissions?

Burhan-Q, 2020-08-01:
Moving to Blocked. Still waiting on feedback from @mechatroniks-git @mmroden and @jgrano; looking for Go/No-Go to use instead of printer spreadsheet and/or recommendations if lacking any features

Burhan-Q, 2020-08-05:
As per discussion from meeting August 5, 2020; we will continue using the [Google Sheets document](https://docs.google.com/spreadsheets/d/1FWTYRxglWDqIK_xI6HlBGKUegICQRsXe5NHCJTlTlHs/edit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) for print tracking.
@capsulecorplab or @mmroden should this Issue be closed? Or should I Label this as "Stale"?

capsulecorplab, 2020-08-06:
I would close it, commenting it as stale or archived

Burhan-Q, 2020-08-06:
stale or archived

Closed 2020-08-06.

Thread 112 (2020-08-03):

A-TET-001004 Tetra PCB Assembly 5V Regulator Issue

mechatroniks-git, 2020-08-03:
Board serial # 00 is not outputting 5VDC

mechatroniks-git, 2020-08-03:
https://github.com/tetrabiodistributed/project-tetra/tree/master/02_Development/FlowMeter/RPi%20Board

Datasheet: http://www.xlsemi.com/datasheet/XL4015%20datasheet.pdf

hydronics2, 2020-08-03:
@mechatroniks-git I just reviewed the pinout and reference schematic. The pinout is correct. All the parts seem placed as shown. I am missing this cap on the FB line. (33nf)
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

hydronics2, 2020-08-03:
I figured it out I think... they installed the diode in backwards... The orientation was correct when I reviewed it online but something must have happened at the boardshop...!  I'll get it swapped around and see what happens...
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

hydronics2, 2020-08-03:
Ok... we got 5V! woohoo...  I turned the diode around and added a 33nF cap along side the 10K resistor (not sure if the cap is 100% necessary but following the data sheet)
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

notice I made the jumper... so now you have 5V LED lit and the RPI 5V LED lit.... + the 12V LED lit...so that's 3 indicator LEDs (all accept the 3V rail which comes from the PI).   Pulling 17ma at 12V.

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

mechatroniks-git, 2020-08-04:
Spun the diode and added a 10nF cap (didn't have 33nF), getting 5V

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

Closed 2020-08-04.

Thread 113 (2020-08-03):

Sensirion control PCB adjustments

Burhan-Q, 2020-08-03:
Phoenix connector needs to move inboard to avoid issues with mounting to Sensirion sensor.
Needed for Issue #67

### Current distance (center to center):
Phoenix pins to pogo pins = 9.705mm
Phoenix pins to board face = 6.721mm

### Constraints:
Distance pogo pins to front of sensirion cut out = 9.597mm - 0.862mm = 8.735mm [bumpouts on inside of Sensirion cutout]
Phoenix connector to control board PCB component = 1.938mm (max distance phoenix connector can move backwards, see image below)

#### Image of interference
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

#### Pogo pins to front wall (subtract 0.862mm for bump-out, center to edge)
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

#### Current space between pogo pins and phoenix connector pins (center to center)
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

#### Current phoenix pins to board (center to face):
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

#### Phoenix pins to Sensirion PCB component:
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

#### Second view:
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

#### Space between rear of (current) phoenix connector to control board PCB component:
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

Burhan-Q, 2020-08-03:
Uploaded these to Slack, but also posting them here
[STEP_files_requested.zip](https://github.com/tetrabiodistributed/project-tetra/files/5018030/STEP_files_requested.zip)

Burhan-Q, 2020-08-03:
### Pogo pins and phoenix connector pins
Center to center distance on @mechatroniks-git board model = 8.43mm
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

### Phoenix connector pins to board face
Center to face distance = 8.00mm
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

hydronics2, 2020-08-04:
@Burhan-Q ... created a pull request with the new files. thanks for the pics!... and that fusion 360 model is worth a 1000 words.

Closed 2020-08-05.

Thread 115 (2020-08-04):

P-TET-000020 Tetra Shutoff Valve Cap needs clearance

mechatroniks-git, 2020-08-04:
Valve cap needs following tweaks
- [ ] Clearance to fit onto valve body P-TET-000023 & P-TET-000018
- [ ] Clearance to fit over the P-TET-000019 without binding
- [ ] Clearance to allow P-TET-000021 to freely rotate

Some of this may be due to printing imperfections, but the design should easily accommodate imperfect printing while allowing functionality.

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

It appears that the current Fusion model has clearance, but the -0 part I printed does not. Need to make sure what is in Fusion is not the same as the -0, then add the necessary clearance (3rd item on lis) and release part for printing.

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

jgrano, 2020-08-04:
@mechatroniks-git did you pull the part from the spread sheet or the main model? I uploaded the parts, printed on high resolution on a taz5 with abs and it went together smoothly for me.

Burhan-Q, 2020-08-04:
@mechatroniks-git something weird is happening the assembly model when you open it. The handle is positioned as such when first opened (like in your image above)
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

But this position is incorrect, and if you move the handle with a click and drag, you'll notice the cap flips to the correct orientation.
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

No more overlapping parts when viewing cross section
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

mechatroniks-git, 2020-08-04:
I've only printed the -0 part.

The latest knob has a max dia of 21.57 - 21.54, depending on the measuring spot. The design is 21.50, so I'm a bit oversized, but well within tolerance.

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

The  mating part is also at 21.50, and should be 21.7. I can adjust the design and print.

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

mechatroniks-git, 2020-08-04:
Printing this one now
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

Burhan-Q, 2020-08-04:
@mechatroniks-git should this issue get updated to Testing?

mechatroniks-git, 2020-08-04:
The -2 part feels good to me. Little bit of vertical play in the valve assembly, maybe .3mm, but probably acceptable.

I think testing is done, ready for review @Burhan-Q

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

Burhan-Q, 2020-08-04:
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

@mechatroniks-git looks like you accomplished the two items above (based on your most recent comment). Not sure if there was a typo on the first bullet point P-TET-000023 is the Tetra valve and is not related to the shutoff valve cap, assuming you meant the shutoff valve body and knob P-TET000018 and P-TET-000021 respectively.

All else looks good, expect the filename needs to be updated to match the revision number -02. Once complete, ready for approval @jgrano.

jgrano, 2020-08-04:
Looks awesome guys

Burhan-Q, 2020-08-05:
> Looks awesome guys

Closing ticket

Burhan-Q, 2020-08-05:
Reopened since file needs to be added to repo. Moved "Closed" bucket on Project board since work is complete otherwise

mmroden, 2020-08-05:
if the file isn't in the repo, then the ticket is not closable.

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

Closed 2020-09-01.

Thread 118 (2020-08-05):

A-TET-001014 Expiratory Support mount Design Change

Burhan-Q, 2020-08-05:
Can we make these parts the same? Also, the diameter of each of these is different?

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

_Originally posted by @mechatroniks-git in https://github.com/tetrabiodistributed/project-tetra/issues/87#issuecomment-669414512_

Judoguy12, 2020-08-06:
Done @mechatroniks-git

mmroden, 2021-02-08:
Needs a reviewer

mechatroniks-git, 2021-02-10:
Not complete. The diameter was adjusted, but the parts are still unique part #s (P-TET-000011 & P-TET-000013). They should be the same. We should add embossed part numbers to the model as well. To make work, we need to modify P-TET-000014 to match the width and screw pattern.

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

Judoguy12, 2021-02-13:
Should be all done @mechatroniks-git

Thread 119 (2020-08-07):

Verify new pressure sensor assembly fits inside housing A-TET-001017

Burhan-Q, 2020-08-07:
New pressure sensor communication PCB #113 & #114 and wiring harness #67 needs to be checked for clearances in full assembly model.

- [ ] import new pressure sensor assembly A-TET-001017 to Alpha prototype assembly
- [ ] join A-TET-001017 with piping in correct location(s)
- [ ] verify that A-TET-001017 doesn't interfere with other components or creates other assembly or usability issues

Assignments:
- Work assigned to:
     @Burhan-Q
- Reviewer (select name):
     - [ ] @mechatroniks-git
     - [ ] @Judoguy12
     - [ ] @jgrano
- Approver (select name):
     - [ ] @mechatroniks-git
     - [ ] @Judoguy12
     - [ ] @jgrano

Burhan-Q, 2020-08-11:
Clearance to housing enclosure is 2.637 mm. No other interference observed. Assembly may be rotated to assist with other potential collisions (with any parts currently not added to model).

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

Judoguy12, 2020-08-17:
Reviewed 17/08/2020 All changes have been made ready for approval

mmroden, 2021-02-08:
Housing is now "nice to have"

mmroden, 2021-02-08:
PCB grew 1 mm, this issue is still open, and not nice-to-have

Thread 120 (2020-08-07):

Review parts for Alpha prototype

Burhan-Q, 2020-08-07:
All parts, components, and assemblies need to be reviewed and verified as ready

- [ ] List parts not yet produced in comment below, include issue number where applicable, provide additional details as needed
- [ ] List parts still being revised in comment below, include issue number where applicable, provide additional details as needed
- [ ] Verify that all off-the-shelf components have been ordered and are on hand, comment with any that are missing
- [ ] Establish plan to address outstanding concerns/problems over (at least) the next week

Burhan-Q, 2020-08-07:
## Parts not yet made: ##
- [ ]

Burhan-Q, 2020-08-07:
## Parts under revision: ##
- [ ]

Burhan-Q, 2020-08-07:
## Missing off-the-shelf-parts: ##
- [ ]

Burhan-Q, 2020-08-15:
Shared by @mechatroniks-git via slack

- [ ] 1. Rear Port Cover - needs part # and STL to test print. Will need 1 for build.
     (2020-08-14) blocked by bias components, @jgrano will design this once bias is ready

- [x] 2. P-TET-000019 - need to print one of -3 & test. Will need 8 for build.
     (2020-08-14) test version printed and delivered to patrick

- [x] 3. P-TET-000021-2 - need print 8 for build. (Patrick to complete by 8/14)
     (2020-08-14) @mechatroniks-git currently printing
- [x] 4. P-TET-000020-2 - need to print 8 for build. (Patrick to complete by 8/14)
     (2020-08-14) @mechatroniks-git currently printing

- [ ] 5. P-TET-000018 - need to print one of -2 & test. Will need 8 for build.
     (2020-08-14) model updated and shared with @DHHwangPhD , part printed and getting ready to cure (should be ready Saturday)

- [ ] 6. P-TET-000006 - need to print one of -? & test. Will need 4 for build.
     (2020-08-14) @jgrano working on this, doing print tests and will send to @mechatroniks-git

- [ ] 7. P-TET-000027 - need status? Will need 4 for build.
     (2020-08-14) @Burhan-Q been working with @fpdotmonkey to troubleshoot printing issues; PCB not fitting
     (2020-08-15) @fpdotmonkey resolve issues with printer, PCB fits, design changes needed

- [ ] 8. P-TET-000028 - may need to elongate one way disc nub? Will need 4 for build.
     (2020-08-14) @jgrano making adjustments to valve length, will print more and ship to @mechatroniks-git

- [ ] 9. P-TET-000029 - Will need 4 for build.
     (2020-08-14) @fpdotmonkey has the parts for these, can build enough for next Friday

- [ ] 10. P-TET-000030-0 - Part good, need 4 for build.
     (2020-08-14) @mechatroniks-git made modifications to model; @DHHwangPhD printed and looks good and will print 3 more

- [ ] 11. P-TET-000031 - Design good, can reduce print mass. Will need 4 for build.
     (2020-08-14) reduction of mass can wait, @mechatroniks-git has eval unit, @DHHwangPhD printing 3 more

- [ ] 12. P-TET-000025 - needs STL to print. Will need 1 for build
     (2020-08-14) @Burhan-Q working on this, @jgrano will print once ready

- [ ] 13. P-TET-000026 - needs STL to print. Will need 1 for build
     (2020-08-14) @Burhan-Q working on this, @jgrano will print once ready

Burhan-Q, 2020-08-17:
UPDATE:

7. P-TET-000027 - need status? Will need 4 for build.
- printer issues resolved, PCB now fits
- @fpdotmonkey to print remaining parts needed to deliver to @mechatroniks-git

 12. P-TET-000025 - needs STL to print. Will need 1 for build
- Shared with @jgrano for printing on August 14

 13. P-TET-000026 - needs STL to print. Will need 1 for build
- Shared with @jgrano for printing August 14

See printing log [here](https://docs.google.com/spreadsheets/d/1FWTYRxglWDqIK_xI6HlBGKUegICQRsXe5NHCJTlTlHs/edit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)

Burhan-Q, 2020-08-26:
Second sprint concluded. Parts shipping to or on premise with @mechatroniks-git for assembly and testing. This issue was created as a log and has no associated PR or commit.

Closed 2020-08-26.

Thread 121 (2020-08-15):

P-TET-000025 Inspiratory bias

Burhan-Q, 2020-08-15:
- [ ] cleanup designs, remodel if needed
- [ ] add part number emboss
- [ ] share STLs for printing
- [ ] print test and review
    @jgrano will print these

Burhan-Q, 2020-08-15:
Ready to print
[P-TET-000025-1.zip](https://github.com/tetrabiodistributed/project-tetra/files/5079369/P-TET-000025-1.zip)

Burhan-Q, 2020-08-15:
Work completed 2020-08-15; reassign to @jgrano for printing

Burhan-Q, 2020-08-24:
### Update ###
@Burhan-Q made minor adjustments to prior design, @jgrano finalized designs; these were sent to @DHHwangPhD for printing

### Notes ###
- will need one-way valve flapper installed
- Grooves (x2) for O-Ring have outside diameter of 28.50 mm and are 1.05 mm deep

**Inspiratory bias circuit**
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

mmroden, 2021-02-08:
Jamie to test

Thread 123 (2020-08-18):

Create P-TET-000032 Rear port cover

Burhan-Q, 2020-08-18:
Relies on completion of #121 and #122 (bias components).

Specifications:
- [ ] conforms to ISO-5356 fitting standard
- [ ] attaches to rear opening on housing (?)

Burhan-Q, 2020-08-24:
### Update ###
@jgrano created parts and added to assembly, these were sent to @DHHwangPhD for printing with use in the Alpha prototype

### Notes ###
- ISO port adapters for rear panel are using P-TET-000032, need to change descriptor and create new part number (PN) for rear cover; will create new Issue for the new component and document notes there
- O-Ring groove is 1.05 mm deep with seat diameter of 28.50 mm
- Taper angle as measured in image below is 1.432 degrees (agrees with ISO spec taper ratio 1/40)

### Review ###
- [ ] 1. Need to add visible embossing of PN on components
- [ ] 2. Taper distance until outside diameter (OD) is 22.314 mm; 13.4mm (see photo); ISO spec is for 22.37 mm at distance of 15 mm
- [ ] 3. O-Ring spec is required (add comment to thread); is it possible to modify design to match an existing O-Ring spec?
- [ ] 4. Add locking coupler to prevent untwisting of port connector (not needed if bonded chemically)?

**OD taper angle distance**
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

**O-ring groove**
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

**Rear ports w/ cover**
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

mmroden, 2021-02-08:
being superceded by nylon, Jamie can test

Thread 124 (2020-08-24):

P-TET-000033 Rear port cover

Burhan-Q, 2020-08-24:
Need to create Rear port cover part.

It will be a housing cover plate for rear ports adapters that connect to ventilator #123

Burhan-Q, 2020-08-24:
This ticket was opened after the work by @jgrano was completed. Creating ticket separate from the Rear port adapters #123 which was initially established for creation of rear cover

Burhan-Q, 2020-08-24:
### Notes ###
- Openings cut at angle to match housing rear panel
- No apparent mechanism designed for attaching plate to housing, options: bond with epoxy, glue, or drill and screw
- Clearance between ports and opening ~2 mm
- No part number embossed on body
- Status (per week of August 24, 2020)
    - [ ] Ready for review
    - [ ] Design requires more updates

**Rear port cover**
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

**Port clearance**
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

Burhan-Q, 2020-08-26:
@mechatroniks-git made some modifications to the design and iterated to P-TET-000033-1 (see image). He will also be printing this for the Alpha build, so the Assignment for this issue has been updated and the [G-Sheet](https://docs.google.com/spreadsheets/d/1FWTYRxglWDqIK_xI6HlBGKUegICQRsXe5NHCJTlTlHs/edit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) will also reflect this. These details come from a Slack DM at ~1700-1715 EDT on August 26, 2020.

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

mmroden, 2021-02-08:
Good for now, will reopen if we need it

Closed 2021-02-08.

Thread 129 (2020-09-05):

Pi Hat design updates

fpdotmonkey, 2020-09-05:
- [ ] Hardware Port 1 for the Sensirion Sensor should correspond to software port 0
- [ ] The 50-pin connector to the Pi shouldn't allow for pins to be off by 1
- [x] The silkscreen for the buzzer should indicate which side is positive
- [x] There should be an interface for the software to hard reset the sensor

mechatroniks-git, 2021-02-10:
The request for the logical ports (starting at 0) to align with physical pin numbers (starting at 1) is not recommended practice, as all the datasheets have pins that start at pin 1. The hardware should reference the datasheet.

If the request was to align GPIO ports, then best to maintain a config.h with the hardware mappings.

Closed 2021-02-10.

Thread 130 (2020-09-05):

Look into using different flow sensors

fpdotmonkey, 2020-09-05:

fpdotmonkey, 2020-09-05:
My thoughts after not thinking about this too much is that for a DIY-based device, the automotive sensors are extremely attractive.  For a packaged device, the SFM3100 looks about perfect.

Judoguy12, 2020-09-16:
@fpdotmonkey I completely agree

Thread 131 (2020-09-16):

Explore making the MAF sensor a drop in sensirion replacement

Judoguy12, 2020-09-16:
As came out of the meeting on Wednesday it was discussed about seeing if the MAF sensor could be made into a drop in replacement for the sensirion for more DIY uses.

Thread 133 (2020-10-05):

Alpha Prototype rework

Burhan-Q, 2020-10-05:
@jgrano taking on all tasks pertaining to Prototype design updates/changes and final assembly.

## Goals ##
- Restructure Fusion files based on PDM discussion
- Find all fitment issues, update designs as needed
- Modify internal components and/or enclosure design as needed for optimizing assembly
- Optimize any designs for manufacturing or assembly
- Manufacture and fully assemble prototype
- Verify mechanical components functionality and perform basic leak check for all airway components

## Expected outcomes ##
- Documentation of all issues discovered and modifications made (images, notes, etc.)
- Fully assembled prototype passing basic tests for mechanical functionality and airtightness (minimal to no leaking)
- Completed prototype assembly shipped to California for electronics and functionality testing

Burhan-Q, 2020-10-05:
Identified overlapping components (inside of CAD)

## Sensirion to Shutoff valve overlap ##
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

## Sensirion to ISO adapter overlap ##
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

## Tetra to Shutoff valve overlaps ##
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

Judoguy12, 2020-10-05:
Following

Thread 134 (2020-10-12):

Add capacitor to PCB

Judoguy12, 2020-10-12:
It was mentioned that the PCB needs an extra capacitor to fix a problem

hydronics2, 2020-10-13:
added 33nf capacitor based on the updated data sheet for the 5V regulator
https://github.com/tetrabiodistributed/project-tetra/pull/135

mechatroniks-git, 2020-12-23:
5V regulator has been replaced with new device, this is no longer an issue

Closed 2020-12-23.

Thread 140 (2020-11-18):

Write Tetra's Testing specification

Judoguy12, 2020-11-18:
Write down the tests we want tetra to undergo and define pass criteria

Judoguy12, 2020-11-18:
Will be transferred to the website

https://docs.google.com/document/d/1woSVfRFWcU1IHEs3X66P7dTMBY_45qS-Xk9WlSRjt7Q/edit

Burhan-Q, 2020-11-21:
Also see the following documents for reference on ventilator and vent-sharing testing and/or protocols:

[Ventilator Service manual](https://www.medonegroup.com/pdf/manuals/techManuals/Maquet-Servo-i-Service-Manual.pdf) - see Troubleshooting section, other sections good reference as well
[FDA Criteria for safety, performance, and labeling](https://www.fda.gov/media/136437/download) - includes some info about vent splitting on pg4
[NY Hospital Vent-sharing protocol](https://www.gnyha.org/wp-content/uploads/2020/03/Ventilator-Sharing-Protocol-Dual-Patient-Ventilation-with-a-Single-Mechanical-Ventilator-for-Use-during-Critical-Ven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) - includes some testing info

Closed 2021-05-15.

Thread 142 (2020-11-18):

Get the Mechanical test document

Judoguy12, 2020-11-18:
Find the document of tests needed to run on the Tetra device to ensure it is mechanically sound

Judoguy12, 2020-11-18:
This needs writing considering testing the software and the leak of the device. Previously a ventilator was used so a solution may be needed to avoid this.

Judoguy12, 2020-11-20:
https://docs.google.com/document/d/1d5qQ5dmPzwSBTMPdLzqYaVzz-wIni7c2SQICvF_ySZA/edit?usp=sharing

Judoguy12, 2020-11-25:
Superceded by https://docs.google.com/document/d/15b1f-CKBMfO2Kmck0VQR8wqceb-19cEREcwgl8lF6Rk/edit?usp=drivesdk

mmroden, 2021-02-08:
Needs a PR, not in git yet

Closed 2021-05-15.

Thread 146 (2020-12-11):

Pi HAT PCB review

darraghbr, 2020-12-11:
Upon reviewing the Pi HAT for the tetra project I have come up with a couple of potential issues.

1 - The pullup resistors between the pressure sensors and the I2C multiplexer seem too high a value, according to the application note and some calcs I would expect them to be in the range of 1 - 5 KOhm depending upon fast mode being enabled.

2 - The I2C address selection pins on the I2C multiplexer are currently connected to GND or 3.3V via a 10K resistor, the application note suggests that they are connected directly to 3.3V or GND, this is probably not critical.

3 - The board layout has some potential clearance issues between the edge of the board and the mounting holes, this issue may or may not be relevant depending on the board house.

4 - The PCB also has some curious wire stubs that don’t appear to be intentional, they should be replaced with polygon, this is also not critical.

5 - The application note for the ADC suggests crossing the analogue and digital traces at 90° to one another, and to keep the traces as short as possible, the layout at the moment doesn’t seem ideal for these. If we see much poorer accuracy on ADC channel 1 and 2 compared to 3 and 4 this will probably be why. If there is a suspicion are close to the tolerance on these sensors it may warrant more investigation.

mmroden, 2020-12-11:
Please make each one of these into separate issues so we can be sure that
they all get addressed; when there are many issues in the same ticket,
chances are good that one or two will get lost in the shuffle.

On Fri, Dec 11, 2020 at 11:41 AM Darragh Broadbent <notifications@github.com>
wrote:

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

mmroden, 2020-12-11:
Thank you for the split!  I don't want to lose anything you're saying

Closed 2020-12-11.

Thread 147 (2020-12-11):

Pi HAT PCB multiplexer resistors incorrect value

darraghbr, 2020-12-11:
The pullup resistors between the pressure sensors and the I2C multiplexer seem too high a value, according to the application note and some calcs I would expect them to be in the range of 1 - 5 KOhm depending upon fast mode being enabled.

On the schematic this applies to R7-10 and R13-18.

mechatroniks-git, 2020-12-12:
@hydronics2 or @fpdotmonkey Can you tell us if fast mode is being used?

darraghbr, 2020-12-12:
Even with fast mode enabled and nearly the highest bus capacitance that the chip can tolerate the range for the appropriate resistor is between 900 and ~ 1012 Ohms. I would just replace them with a 1K resistor.

mechatroniks-git, 2020-12-12:
I didn't run the formula, but page 23 of the [datasheet](https://www.ti.com/lit/ds/symlink/tca9548a.pdf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) shows this:
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
I agree with your recommendation to reduce the 10K resistors. 1K would cover the range, if we are using fast mode. Downside is slightly higher drive currents, and possible higher EMI (di/dt). If we are never running fast mode, then we should stick to a higher R in the 3K range, to play it conservative, for the sake of EMI.

hydronics2, 2020-12-13:
wow... that's a great graph. Thanks for the feedback. I don't know the i2c
speed but we should be pushing for slow speeds as much as possible for the
off-board sensiron sensors.

I typically push using 10K for everything to simplify the board design.
Weak pullups  (10k) should be fine for the onboard SPL006 pressure
sensors but the sensirion sensors (off board) probably makes sense to drop
these pullups to something less than 10K.

I'll drop to 3K per your suggestion for all i2c just to keep things similar.

On Sat, Dec 12, 2020 at 12:43 PM Mechatroniks <notifications@github.com>
wrote:

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

darraghbr, 2020-12-14:
Issue resolved by #152

Closed 2020-12-19.

Thread 148 (2020-12-11):

I2C address selection pins not connected in accordance with application note

darraghbr, 2020-12-11:
The I2C address selection pins on the I2C multiplexer are currently connected to GND or 3.3V via a 10K resistor, the application note suggests that they are connected directly to 3.3V or GND, this is probably not critical.

On the schematic this applies to R19, 20, 25 and R39-41.

mechatroniks-git, 2020-12-12:
On page 5&6 of [datasheet](https://www.ti.com/lit/ds/symlink/tca9548a.pdf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)

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

shows 1uA of current on these pins, having a 10 to gnd or +Vcc will not affect the logic level. The 10k can be left in place, as this is usually considered good practice to tie logic pins to power rails in this manner.

darraghbr, 2020-12-12:
While I don't disagree with you that having a 10K resistor won't hurt, the data sheet on page 4 states this. That was the basis for me making this issue.

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

mechatroniks-git, 2020-12-12:
The "directly" comment here is certainly confusing.

I found this:  [eval board](https://www.ti.com/lit/ug/slvua73/slvua73.pdf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), Here TI is using 10K to gnd/vcc.
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

Closed 2020-12-12.

Thread 149 (2020-12-11):

Some plated through holes too close to traces on PCB

darraghbr, 2020-12-11:
The board layout has some potential clearance issues between the edge of some plated throughholes and a number of traces, this issue may or may not be relevant depending on the board house.

mechatroniks-git, 2020-12-12:
@darraghbr Can you share your eagle DRU file? We should be evaluating the design rules with a common file.

darraghbr, 2020-12-12:
I am using the dru file presented in the JLCPCB official GitHub repo, which can be found here:

https://github.com/JLCPCBofficial/jlcpcb-eagle/tree/master/design%20rules

It turns out that I misread the clearances slightly and it is actually an issue between a wire and a hole rather than a hole and something on the dimension layer. I will edit the title and initial comment to reflect this.

mechatroniks-git, 2020-12-12:
Ah ok, I had downloaded someone's JLCPCB from github, but upon inspection didn't match their [capabilities](https://jlcpcb.com/capabilities/Capabilities) page. Even the official one is not consistent, for example, website offers 0.2mm minimum drill, DRU is at 0.3mm.

In any case, using their official DRU, looking at the file:

- I see the 3 clearance errors on the bottom copper, which I agree they should be fixed.
- The 6 overlap errors with the ground vias, only way to fix those is to make the vias part of the library package, but it's not a true error and could be ignored without issue.
> I don't have the th_libraries.lbr file, so @hydronics2 would have to provide for me to fix

darraghbr, 2020-12-13:
Yes I recognised the thermal vias on the power supply were just a small issue with the library. That's definitely in the non critical category.

hydronics2, 2020-12-13:
- yea it looks like the JLCP allows signal to edge of 0.2mm or 8mil. I
don't like stretching my polygon ground planes to the max allowable extent
so I have it set at 15mil in the DRU. Setting the DRU to 15mil I do see
some errors for 5 plated holes on the right side of the board that go away
when I set the DRU to 8mil. Can you send me a screen shot of the "3
clearance errors on the bottom side"?
[image: image.png]
[image: image.png]

- 6 overlap errors... I researched a bit adding vias to the part library.
From my autodesk googling it seemed perfectly allowable to add vias
manually in the Schematic/Board editor.  To get get rid of the DRU error
you can change the clearance between same signals as follows:
[image: image.png]

On Sat, Dec 12, 2020 at 6:42 PM Darragh Broadbent <notifications@github.com>
wrote:

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

hydronics2, 2020-12-13:
do these images show up?
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

darraghbr, 2020-12-14:
Issue resolved by #152

Closed 2020-12-19.

Thread 150 (2020-12-11):

Potential issue with noise on the ADC

darraghbr, 2020-12-11:
The application note for the ADC suggests crossing the analogue and digital traces at 90° to one another, and to keep the traces as short as possible, the layout at the moment doesn’t seem ideal for these. If we see much poorer accuracy on ADC channel 1 and 2 compared to 3 and 4 this will probably be why. If there is a suspicion that we are close to the tolerance on these sensors it may warrant more investigation.

hydronics2, 2020-12-13:
Yea I agree the routing on the ADC could be better although I've not studied how the digital/analog lines cross each other.  I think we should keep this issue open and evaluate it once we get feedback on the sensors. The layout was for a quick prototype and right now there there seems little interest in moving forward with the ADC and associated automotive sensor so I'm hesitant to spend any time on this.

mmroden, 2021-02-08:
Does not need to be done for a first deployment, not sure if the ADCs will be used

Thread 151 (2020-12-11):

Wire stubs found in PCB design

darraghbr, 2020-12-11:
Upon doing a DRC check the PCB has some curious wire stubs that don’t appear to be intentional, they should be replaced with polygon, this is probably not critical.

mechatroniks-git, 2020-12-12:
I see 6 wire stub warnings, some in the GND plane get covered by GND polygon. None are an issue, but certainly worth cleaning up when fixing the other errors.

hydronics2, 2020-12-13:
I tried deleting the wire stubs and I get air-wire warnings (un-routed
traces). This happens to me from time to time when I'm routing and
rerouting work between revisions... finicky Ealge thing... I'm not sure how
to get rid of the wire-stubs and because air-wire warnings are worse than
wire-stub warnings I'm inclined to leave them. If anyone can get rid of the
wire stubs, please go ahead.

On Sat, Dec 12, 2020 at 1:29 PM Mechatroniks <notifications@github.com>
wrote:

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

darraghbr, 2020-12-14:
Issue resolved by #152

Closed 2020-12-19.

Thread 153 (2020-12-18):

P-TET-000026 Dimension problems

Judoguy12, 2020-12-18:
This part has some wrong dimensions, the 3 way tube has a different dimension for each output, these need to be standardised. Also it has an orange groove but the orang is not specified

Burhan-Q, 2020-12-22:
@Judoguy12 can you provide details on which dimensions are incorrect/different? Looking at the model (in the Alpha 2.0 folder) looks like they're all the same diameters.

Also, the ID for the o-ring groove looks to be 26.40 mm, so the o-ring to use is likely V-MCM-9262K527 - Buna-N O-Ring 1.5 mm Wide, 26 mm ID

Judoguy12, 2020-12-22:
Yeah the right angle pipe that connects to the bias peice was much harder
to fit that the right angles on the edges of the inspiratory and expiratory
circuits even though they look to be largely the same part.

Thanks for the oring size

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

mmroden, 2021-02-08:
Jamie will check it

Thread 154 (2020-12-18):

P-TET-000032-0 No O-ring specified

Judoguy12, 2020-12-18:
This part has an o-ring groove but no o-ring specified, which o-ring should it be

Burhan-Q, 2020-12-22:
Very likely V-MCM-9262K527 - Buna-N O-Ring 1.5 mm Wide, 26 mm ID

The ID of the o-ring groove is 26.40 mm is 2 mm wide

mmroden, 2021-02-08:
Needs to be added to the BOM

mechatroniks-git, 2021-02-10:
O-Rings are already in the BOM, need to do a BOM scrub to determine if quantity is correct.
https://docs.google.com/spreadsheets/d/1nCw9LUN7ygv8B8hno6poN-m15rsixNSolVTXhXynrfw/edit#gid=80304938****

Thread 159 (2021-01-31):

Missing item on Pi HAT BOM

darraghbr, 2021-01-31:
We are missing the 2x20 header strip that goes between the Pi and the HAT.

I think this is roughly the correct part number.

https://www.mouser.co.uk/ProductDetail/TE-Connectivity/2-534998-0/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

darraghbr, 2021-01-31:
@mechatroniks-git

hydronics2, 2021-01-31:
That looks right to me. This is the one I used: https://lcsc.com/product-detail/Pin-Header-Female-Header_BOOMELE-Boom-Precision-Elec-C50982_C50982.html

mechatroniks-git, 2021-02-01:
The TE part will work just fine.
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

Closed 2021-02-03.

Thread 163 (2021-02-23):

[Hardware] Review drawings for push fit manifold and tube adaptors before release

darraghbr, 2021-02-23:
I have generated a version of the pressure sensing manifold and 22 mm tube adaptor in order to be compatible with the push fit nylon version of the Tetra. It needs reviewing before it is issue for manufacture.

Please see attached pdfs of the components. A step file will be generated and issued along with the drawings.

[D-TET-001105-0 Push Fit Manifold Drawing.pdf](https://github.com/tetrabiodistributed/project-tetra/files/6026938/D-TET-001105-0.Push.Fit.Manifold.Drawing.pdf)

[D-TET-001106-0 Push fit to 22mm hose adaptor Drawing.pdf](https://github.com/tetrabiodistributed/project-tetra/files/6026939/D-TET-001106-0.Push.fit.to.22mm.hose.adaptor.Drawing.pdf)

darraghbr, 2021-02-23:
@mmroden who should this get assigned to?

mechatroniks-git, 2021-02-24:
1. The assembly drawing should not have part dimensions, this should only be on the part drawing. Here we can have dims on the assembly, between parts, or overall dims are ok too.
2.  Part number not meeting format, should be M-LEGRIS-XXX & M-???-BS111
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

Specific to the assembly drawing - assembly should not have a material property, as it consists of parts being assembled.

Specific to the parts (which should be on the part drawings):
3. 6061-T6 is more commonly available, this may be harder to source and more expensive?
4. With CNC, need to put in a inside corner radius to that's slightly larger than the tool radius. So if using a 4mm dia tool, set the radius to 2.5mm. (more of a part note, not assembly)
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

mechatroniks-git, 2021-02-24:
D-TET-001106 same issues with part number missing M-LEGRIS. Also, need part drawing for the aluminum part. This looks like a CNC lathe part, so need corner radius
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

Does the Legris o-ring need any o-ring grease during assembly? If so, make a note.

darraghbr, 2021-02-24:
The ID on the 001106 part I would suspect will be bored out, so radius on the end will be minimal. I have added a comment on the OD of the part to suggest the feature is non-critical.

On 001105 6061-T6 is not a material we can source readily, 6082 is the alloy we can get hold of here. I have also added a note about the external profile being non-critical. With an ISO standard drawing it's pretty normal to have assembly and parts mixed together with dimensions, and ultimately with .step files being issued as well it should not matter.

Please find attached new versions of the drawings.

[D-TET-001106-0 Push fit to 22mm hose adaptor Drawing.pdf](https://github.com/tetrabiodistributed/project-tetra/files/6038054/D-TET-001106-0.Push.fit.to.22mm.hose.adaptor.Drawing.pdf)
[D-TET-001105-0 Push Fit Manifold Drawing.pdf](https://github.com/tetrabiodistributed/project-tetra/files/6038055/D-TET-001105-0.Push.Fit.Manifold.Drawing.pdf)

Judoguy12, 2021-02-26:
@mechatroniks-git Are these drawings up to snuff?

mechatroniks-git, 2021-02-26:
I still say that an assembly drawing shouldn't have any part dimensions, other than what's needed for assembly. We need to delete those and create a part drawing with those dimensions, so we have a single source of truth.

darraghbr, 2021-03-02:
Ultimately a drawing is there to convey information, and unless a drawing is difficult or confusing to read what we are talking about is a style choice.

Removing information from a drawing and generating twice as many drawings as is necessary does not solve any problems that I can see and in my opinion dilutes the concept of a single source of truth.

This is my argument to keep them how they are, @mmroden please make a call and I will follow it.

mmroden, 2021-03-02:
I'm not sure I understand completely what I'm being asked to adjudicate here.  It sounds like there's a question of having an assembly drawing and a part drawing?  Should we discuss in the meeting tomorrow?  What's the difficulty of having a part drawing with materials distinct from an assembly drawing with no materials but just how parts are expected to fit together?  Don't they convey different information?

I also think we should be putting the drawings up in PRs rather than issues, so that we have them in the repo immediately after approval, rather than a second PR approval process.

mechatroniks-git, 2021-03-03:
I've never sent assembly drawings to a machine shop, but I've never used shops in Europe, perhaps it's common there?  Here, they want part drawings if they are doing to make parts. But if it works, leave it as-is

Closed 2021-03-10.

Thread 165 (2021-03-04):

[Hardware] Build Progress Photos needed from UK Group

mmroden, 2021-03-04:
### Creating a task using this template
1. Rename Task title
2. Add details of task -- Darragh has built some splitters, need progress
3. Add reference of any existing Issue
4. Expand checklist below (if needed)
5. Add/Create appropriate label(s)
6. Select Project
7. Add/Create Milestone
8. Add any Assignee(s)

Task details
#(related issue number)

- [ X] Assigned _(specify assignees)_
- [ ] Work in Progress _(move card on Project Board)_
- [ ] Submit for Review _(assign reviewer, comment, & move on Project Board)_
- [ ] Working on Review changes _(comment w/ list of changes and date)_
- [ ] Review complete _(assigned reviewer comment with approved date)_

Judoguy12, 2021-08-22:
Testing pushfit adaptors
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

Judoguy12, 2021-08-22:
Testing 12mm pressure drop
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

Judoguy12, 2021-08-22:
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

mmroden, 2021-08-23:
Instead of tape, how about an o-ring?

Thread 168 (2021-05-15):

[Hardware] pushfit adapters to 22mm

mmroden, 2021-05-15:
### Creating a task using this template
1. Rename Task title
2. Add details of task
3. Add reference of any existing Issue
4. Expand checklist below (if needed)
5. Add/Create appropriate label(s)
6. Select Project
7. Add/Create Milestone
8. Add any Assignee(s)

Task details
#(related issue number)

- [ ] Assigned _(specify assignees)_
- [ ] Work in Progress _(move card on Project Board)_
- [ ] Submit for Review _(assign reviewer, comment, & move on Project Board)_
- [ ] Working on Review changes _(comment w/ list of changes and date)_
- [ ] Review complete _(assigned reviewer comment with approved date)_

Judoguy12, 2021-08-21:
I have just tested plastic threaded adaptors and they seem to fit together with the threaded part well now Ill move onto testing pressure drop across the pipe

Judoguy12, 2021-08-21:
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

Closed 2021-08-22.

Thread 169 (2021-05-15):

[Hardware] pushfit to sensirion sensors

mmroden, 2021-05-15:
### Creating a task using this template
1. Rename Task title
2. Add details of task
3. Add reference of any existing Issue
4. Expand checklist below (if needed)
5. Add/Create appropriate label(s)
6. Select Project
7. Add/Create Milestone
8. Add any Assignee(s)

Task details
#(related issue number)

- [ ] Assigned _(specify assignees)_
- [ ] Work in Progress _(move card on Project Board)_
- [ ] Submit for Review _(assign reviewer, comment, & move on Project Board)_
- [ ] Working on Review changes _(comment w/ list of changes and date)_
- [ ] Review complete _(assigned reviewer comment with approved date)_

Closed 2021-08-22.

Thread 170 (2021-05-15):

[Hardware] build up working tetra electronics with sensirion and pi board

mmroden, 2021-05-15:
### Creating a task using this template
1. Rename Task title
2. Add details of task
3. Add reference of any existing Issue
4. Expand checklist below (if needed)
5. Add/Create appropriate label(s)
6. Select Project
7. Add/Create Milestone
8. Add any Assignee(s)

Task details
#(related issue number)

- [ ] Assigned _(specify assignees)_
- [ ] Work in Progress _(move card on Project Board)_
- [ ] Submit for Review _(assign reviewer, comment, & move on Project Board)_
- [ ] Working on Review changes _(comment w/ list of changes and date)_
- [ ] Review complete _(assigned reviewer comment with approved date)_

mechatroniks-git, 2021-05-16:
Board built, wired to sensors, power tested with Raspberry Pi 4. Ready for Raspberry Pi 3B+ and Pi Display.

mmroden, 2021-08-11:
To be done in the US

mmroden, 2021-08-14:
Blocked on the UK prototype because we can't test it without the prototype

Thread 172 (2021-07-09):

[Hardware] Moving to 12mm Push-fit

Judoguy12, 2021-07-09:
### Creating a task using this template
Having tested 6mm push-fit the pressure drop was found to be much too high and not enough flow was reaching the lung. To alleviate this we are moving to using 12mm push-fit piping. This means new 22mm adaptors are needed for the larger size

Task details
#171

- [ ] Assigned @darraghbr
- [ ] Work in Progress _(move card on Project Board)_
- [ ] Submit for Review _(assign reviewer, comment, & move on Project Board)_
- [ ] Working on Review changes _(comment w/ list of changes and date)_
- [ ] Review complete

darraghbr, 2021-07-11:
Can we have some supporting information here about the move to 12mm, for instance an image of the test set up with the 6mm system in situ showing that it is unable to crack the non-return valves. Which non-return valves did we test in the end? Was it just the John Guest stuff? If so I might get some SMC ones just in case they are much better.

Judoguy12, 2021-08-22:
Pressure Drop Across 30cm of 12mm tube was undetectable with the tools I have available. I tested at both 19cmH2O and 60cmH2O. The images below show the testing Setup.
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

19cmH2O
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

60cmH2O
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

mmroden, 2021-08-22:
Have you replicated this capability?

https://www.markmroden.com/Tetra-Testing/24-April-2020-ventilator-splitting

That is, shown that one patient can have a different PIP than the other?
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

darraghbr, 2021-08-22:
Not yet Mark, this is in direct response to my request in the comment above Jamies.

mmroden, 2021-08-22:
Gotcha, makes sense.
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

Judoguy12, 2021-08-28:
Whole circuit test setup at 45cm H2O

Found that lungs deflated very slowly and need a thinner one way valve to work
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

Judoguy12, 2021-08-28:
![Uploading w7{26b0e70} (bf98d54d-252b-4970-ba39-c199b261db53 > id=0x7f0a037d) …]()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

Judoguy12, 2021-08-28:
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

Judoguy12, 2021-08-28:
With a weaker one way valve operation would be much more optimal and lungs would deflate at the normal rate. After rearranging the inspiratory arm to the correct configuration the flow restriction worked much better going to 24.4 when blue is 2 turns down with pink remaining unaffected at 25.7

Judoguy12, 2021-09-12:
With more compliant valves on both inspiratory and expiratory of breathing circuits we get pressures as in the vent except a 1cmH2O drop in PEEP
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

Judoguy12, 2021-09-12:
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

Judoguy12, 2021-09-12:
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

Judoguy12, 2021-09-12:
With blue shut off and a compliant valve from there used in pink we notice no change to PIP but the PEEP does get much closer to the 9.5 so the bias circuit needs a soft valve too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

Judoguy12, 2021-09-12:
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

Judoguy12, 2021-09-12:
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

Judoguy12, 2021-09-12:
Also upon significantly reducing blues flow valve we found pink's PIP and PEEP not to change. I believe this is the requirement asked for by @mmroden .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

Judoguy12, 2021-09-12:
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

Thread 176 (2021-08-21):

[Hardware] pushfit adapters to 22mm leaking in FDM

Judoguy12, 2021-08-21:
### Creating a task using this template
1. Rename Task title
2. Add details of task
3. Add reference of any existing Issue
4. Expand checklist below (if needed)
5. Add/Create appropriate label(s)
6. Select Project
7. Add/Create Milestone
8. Add any Assignee(s)

Task details
#(related issue number)

- [ ] Assigned _(specify assignees)_
- [ ] Work in Progress _(move card on Project Board)_
- [ ] Submit for Review _(assign reviewer, comment, & move on Project Board)_
- [ ] Working on Review changes _(comment w/ list of changes and date)_
- [ ] Review complete _(assigned reviewer comment with approved date)_

Judoguy12, 2021-08-21:
The Current 22mm Adaptors are leaking when Printed using FDM. They leak at 19cmH2O. This is likely due to the relatively short taper and also the grooved nature of the FDM prints.  Tomorrow I will wrap the connector in tape to seal the mating surface and retest .If Printed in Resin or machined I do not believe the leak would be an issue. In the Photo the connector is connected to the inspirtory arm of the ventilator and then to a check valve opposing the flow of air to create a seal. It was tested in a soapy water mix. Images of the Test  carried out today where they are leaking are attached. If Printed in Resin or machined I do not believe the leak would be an issue.

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

Judoguy12, 2021-08-22:
Once I wrapped black tape around I retested under same conditions and got a much smaller negligible leak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

mmroden, 2021-08-24:
Should be testing leak between 80 and 120 cmH20 of pressure.

Also, investigate an o-ring solution vs tape

mmroden, 2021-08-24:
We investigated a lot of leak before, the resin prints may help, but a proper ISO 5356 taper should also do the trick, esp with an o-ring on it.

mmroden, 2021-08-24:
80-120 is the standard per Daniel for pressures in the hospital, so 120 is a good target.  No need to go above that.

mmroden, 2021-08-24:
Also, a pre-use check will be useful for making sure that everything's good.  This is a circuit-safety check and device safety check prior to being put on a human.  Check the sparrow preuse checks on the puritan bennet ventilator in the EUA documentation (not the standard, but will work for EUA).

Thread 177 (2021-08-30):

[Hardware] Pushfit expiratory valve needs a redesign to have a very low crack pressure

mmroden, 2021-08-30:
Lungs remain inflated at the end of the breath cycle and need to be able to deflate back to PEEP.  At 6 breaths/minute, they're fine, but any faster, then there's accumulation

### Creating a task using this template
1. Rename Task title
2. Add details of task
3. Add reference of any existing Issue
4. Expand checklist below (if needed)
5. Add/Create appropriate label(s)
6. Select Project
7. Add/Create Milestone
8. Add any Assignee(s)

Task details
#(related issue number)

- [ ] Assigned _(specify assignees)_
- [ ] Work in Progress _(move card on Project Board)_
- [ ] Submit for Review _(assign reviewer, comment, & move on Project Board)_
- [ ] Working on Review changes _(comment w/ list of changes and date)_
- [ ] Review complete _(assigned reviewer comment with approved date)_

Closed 2021-09-12.

Thread 181 (2021-10-03):

[Hardware] 3D printed adapters showing signs of leakage

darraghbr, 2021-10-03:
A significant leak has been observed on the current iteration of the push fit system.

It is suspected that it is coming from an FDM printed adapter between the push fit parts and the VentMon.

We need to identify the leaks exact location and remediate as we go.

@Judoguy12 please use this issue to document where you locate the leaks and we will go from there.

I have pre-emptively redesigned the Sensirion adapters so they will effectively be an intereferance fit on the Sensirions and have printed some in a flexible resin (Photocentric Flexible LCD) these appear to seal to the Sensirions very well (so much so that I can fire the PCB clean off if I dead head it and blow hard into it)

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

In this image the purple is our adapter, and the cyan is the Sensirion.

I will be publishing these files in a new branch but keeping the PR as a draft.

darraghbr, 2021-10-04:
Honestly using the Sensirion I have and printing the adapters as they are on the master branch in some Photocentric flex resin they seal perfectly well, I can still blow the PCB clean off the sensor if I blow hard enough. So I don't think the #182 PR will be necessary.

Judoguy12, 2021-10-21:
Solved by the resin adaptors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
