tetrabiodistributed/project-tetra/02_Development/Push_Fit_Design/D-TET-001105-0 Push Fit Manifold Drawing.pdf

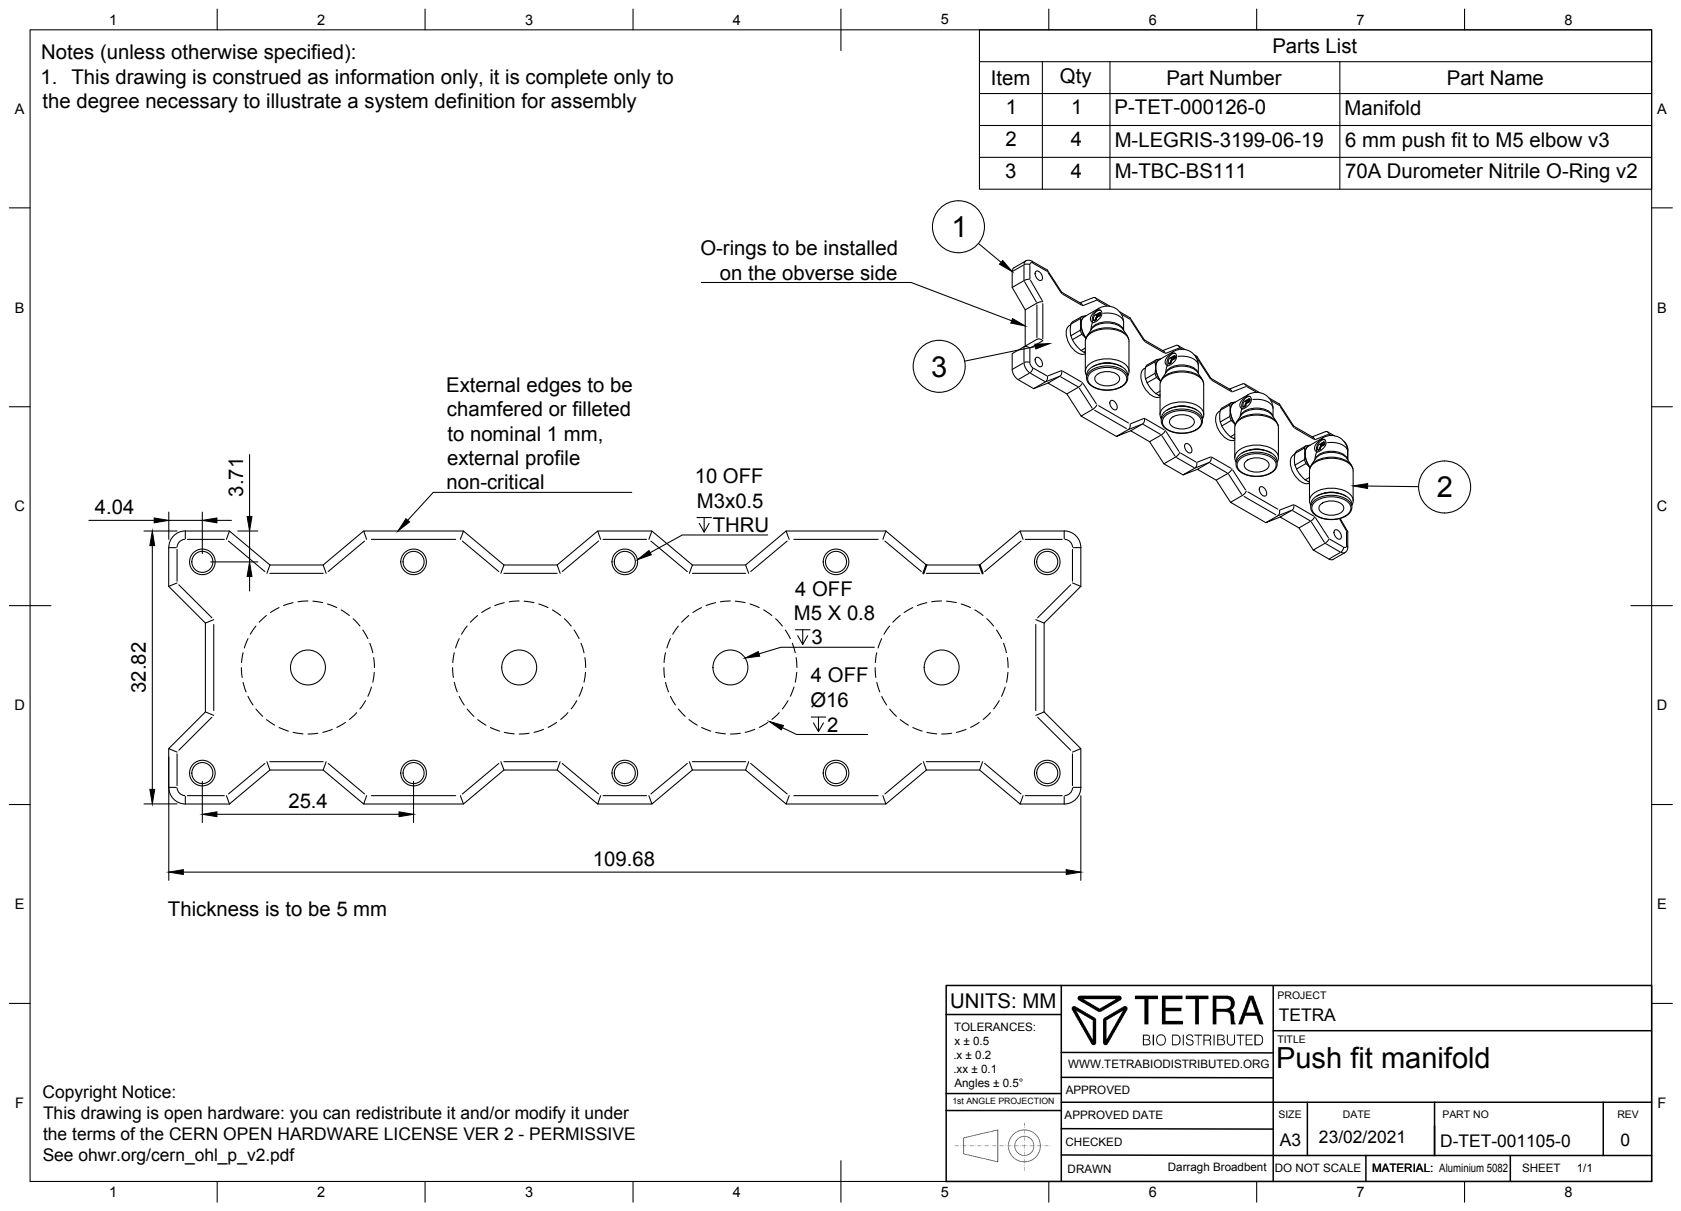
[picture p221: page 1]
UNITS: MM; Angles ± 0.5° 1st ANGLE PROJECTION; SIZE; DATE; PART NO; DO NOT SCALE; MATERIAL:; APPROVED DATE; Darragh Broadbent; Aluminium 5082; Parts List; 10 OFF; 4 OFF M5 X 0.8; 4 OFF

Notes (unless otherwise specified):
1. This drawing is construed as information only, it is complete only to
the degree necessary to illustrate a system definition for assembly

Item | Qty | Part Number | Part Name
1 | 1 | P-TET-000126-0 | Manifold
2 | 4 | M-LEGRIS-3199-06-19 | 6 mm push fit to M5 elbow v3
3 | 4 | M-TBC-BS111 | 70A Durometer Nitrile O-Ring v2

O-rings to be installed
on the obverse side

External edges to be
chamfered or filleted
to nominal 1 mm,
external profile
non-critical

Thickness is to be 5 mm

PROJECT
TETRA
Push fit manifold

WWW.TETRABIODISTRIBUTED.ORG

F Copyright Notice:
This drawing is open hardware: you can redistribute it and/or modify it under
the terms of the CERN OPEN HARDWARE LICENSE VER 2 - PERMISSIVE
See ohwr.org/cern_ohl_p_v2.pdf
