tetrabiodistributed/project-tetra/02_Development/3WayValve/3WayConicalValve/3WayConicalValveAssembly.pdf

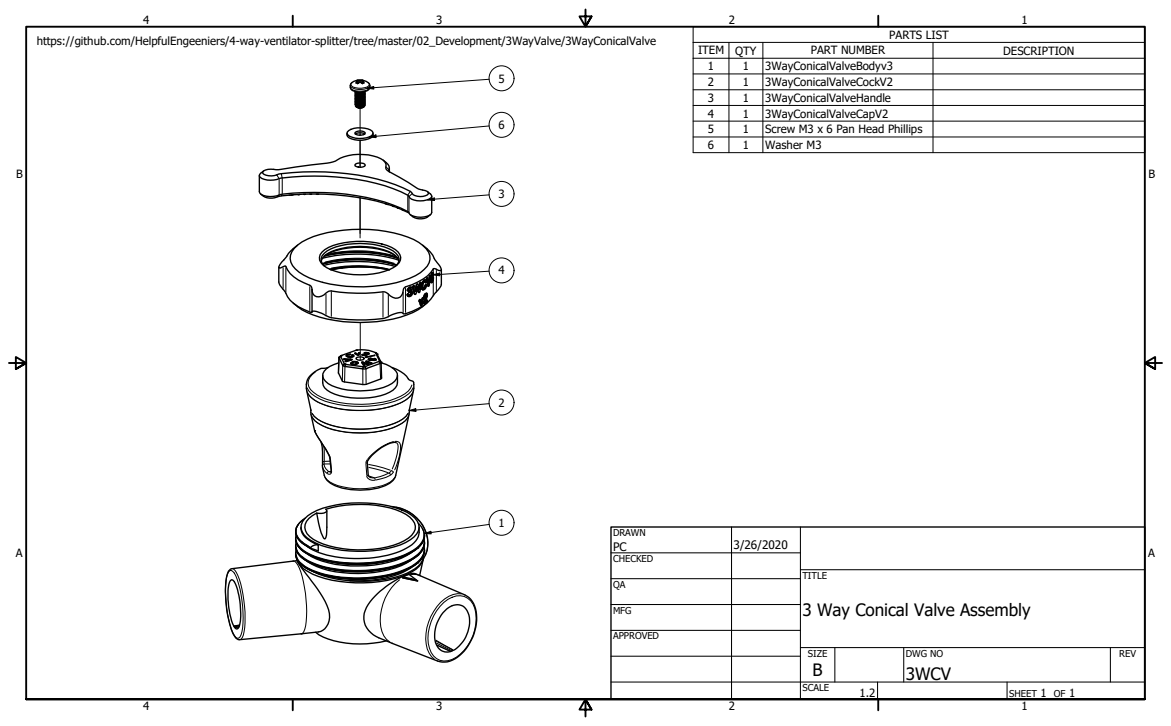
[picture p222: page 1]

PARTS LIST

https://github.com/HelpfulEngeeniers/4-way-ventilator-splitter/tree/master/02_Development/3WayValve/3WayConicalValve

ITEM | QTY | PART NUMBER | DESCRIPTION
1 | 1 | 3WayConicalValveBodyv3
2 | 1 | 3WayConicalValveCockV2
3 | 1 | 3WayConicalValveHandle
4 | 1 | 3WayConicalValveCapV2
5 | 1 | Screw M3 x 6 Pan Head Phillips
6 | 1 | Washer M3

DRAWN PC | 3/26/2020

CHECKED

MFG

3 Way Conical Valve Assembly

APPROVED

SIZE B | DWG NO 3WCV | REV

SCALE 1.2 | | SHEET 1 OF 1
