tetrabiodistributed/project-tetra/03_Visulisation_and_Handbooks/CAD_drawings/Tetra_drawing_templates/August-2020/PDF/Tetra Drawing Template - Assembly v18.pdf

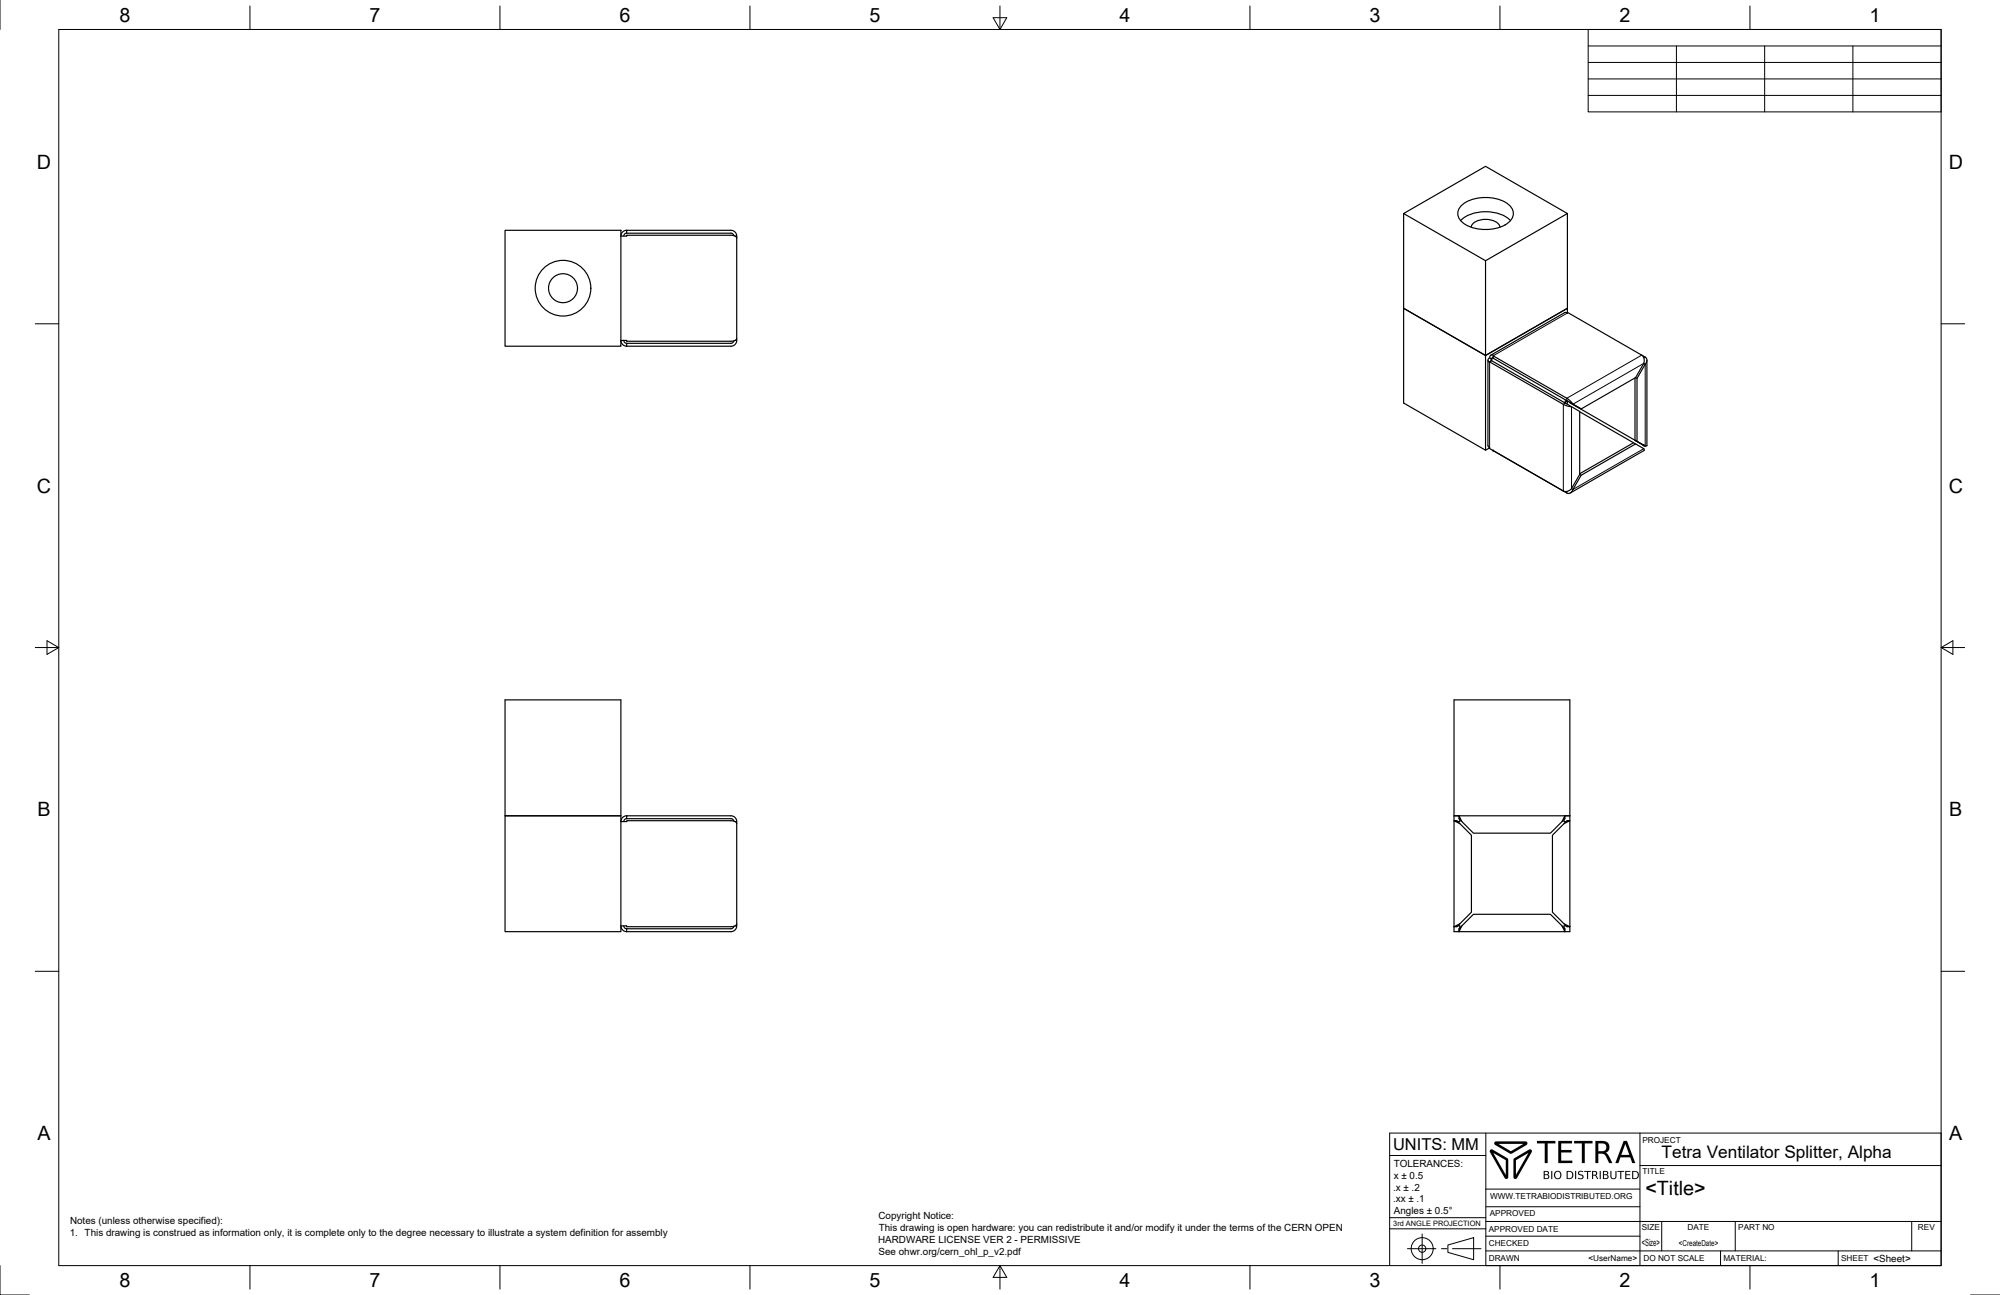
[picture p223: page 1]
APPROVED DATE; DO NOT SCALE; MATERIAL:; SHEET; SIZE; DATE; PART NO; REV; UNITS: MM; x ± 0.5 .x ± .2 .xx ± .1 Angles ± 0.5°; 3rd ANGLE PROJECTION

PROJECT
Tetra Ventilator Splitter, Alpha

WWW.TETRABIODISTRIBUTED.ORG

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
