tetrabiodistributed/project-tetra/02_Development/Pressure Manifold/P-TET-000005-0.pdf

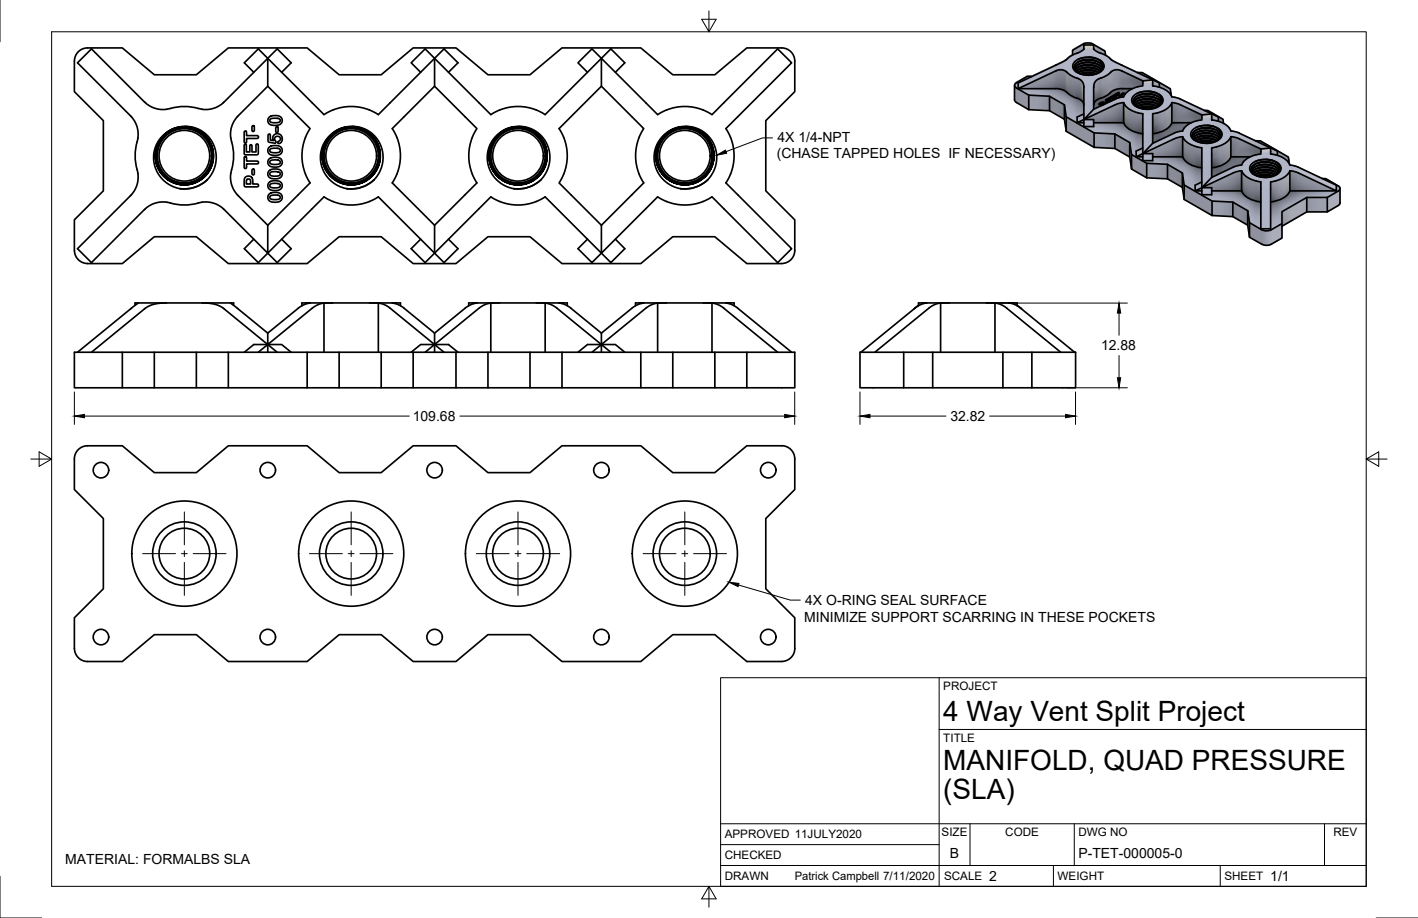
[picture p224: page 1]
SIZE; CODE; DWG NO; REV; Patrick Campbell 7/11/2020

4X 1/4-NPT
(CHASE TAPPED HOLES IF NECESSARY)

4X O-RING SEAL SURFACE
MINIMIZE SUPPORT SCARRING IN THESE POCKETS

PROJECT
4 Way Vent Split Project
MANIFOLD, QUAD PRESSURE
(SLA)

MATERIAL: FORMALBS SLA
