tetrabiodistributed/project-tetra/03_Visulisation_and_Handbooks/CAD_drawings/One-way_valve/one-way_valve_Rev5_BQ.PDF

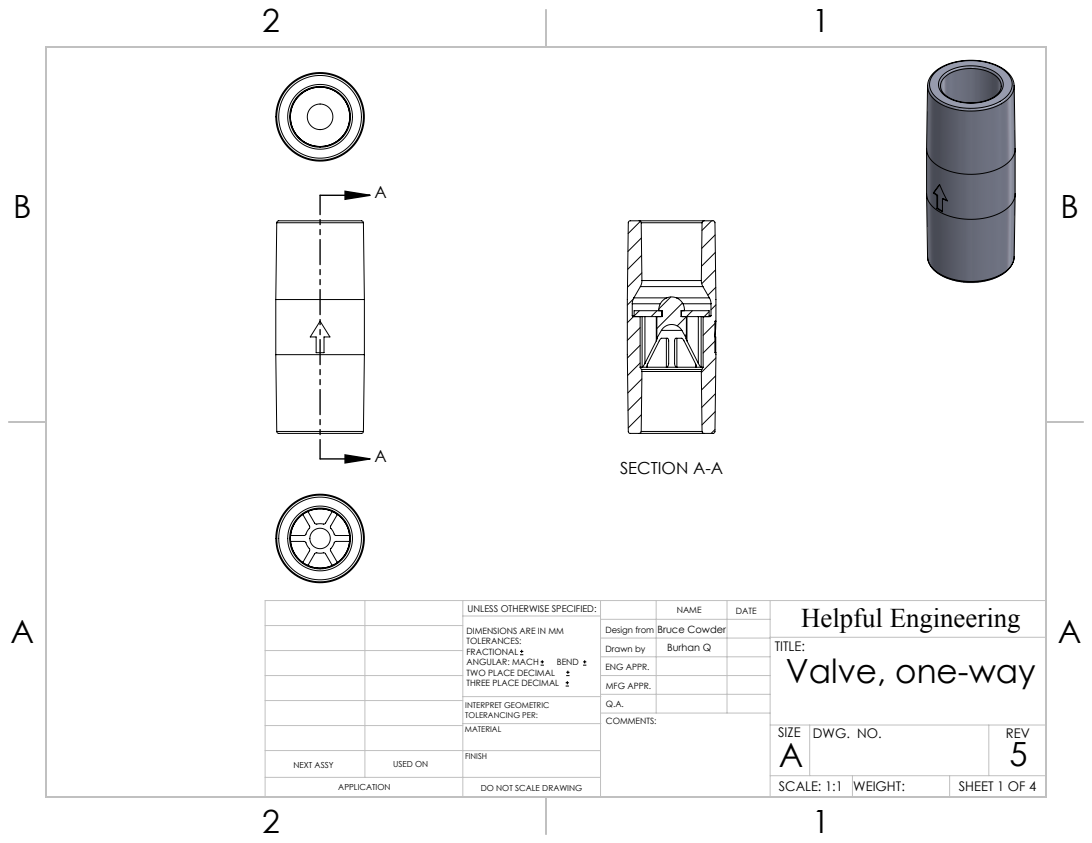
[picture p225: page 1]
SECTION A-A

UNLESS OTHERWISE SPECIFIED: | | | DATE | Helpful Engineering NAME
DIMENSIONS ARE IN MM TOLERANCES: FRACTIONAL ANGULAR: MACH BEND TWO PLACE DECIMAL THREE PLACE DECIMAL | Design from | Bruce Cowder

Drawn by | Burhan Q | | TITLE: Valve, one-way

ENG APPR.
MFG APPR.

INTERPRET GEOMETRIC TOLERANCING PER: | Q.A.
MATERIAL | | SIZE A | DWG. NO. | REV 5

NEXT ASSY | USED ON | FINISH

APPLICATION | DO NOT SCALE DRAWING | | SCALE: 1:1 | WEIGHT: | SHEET 1 OF 4

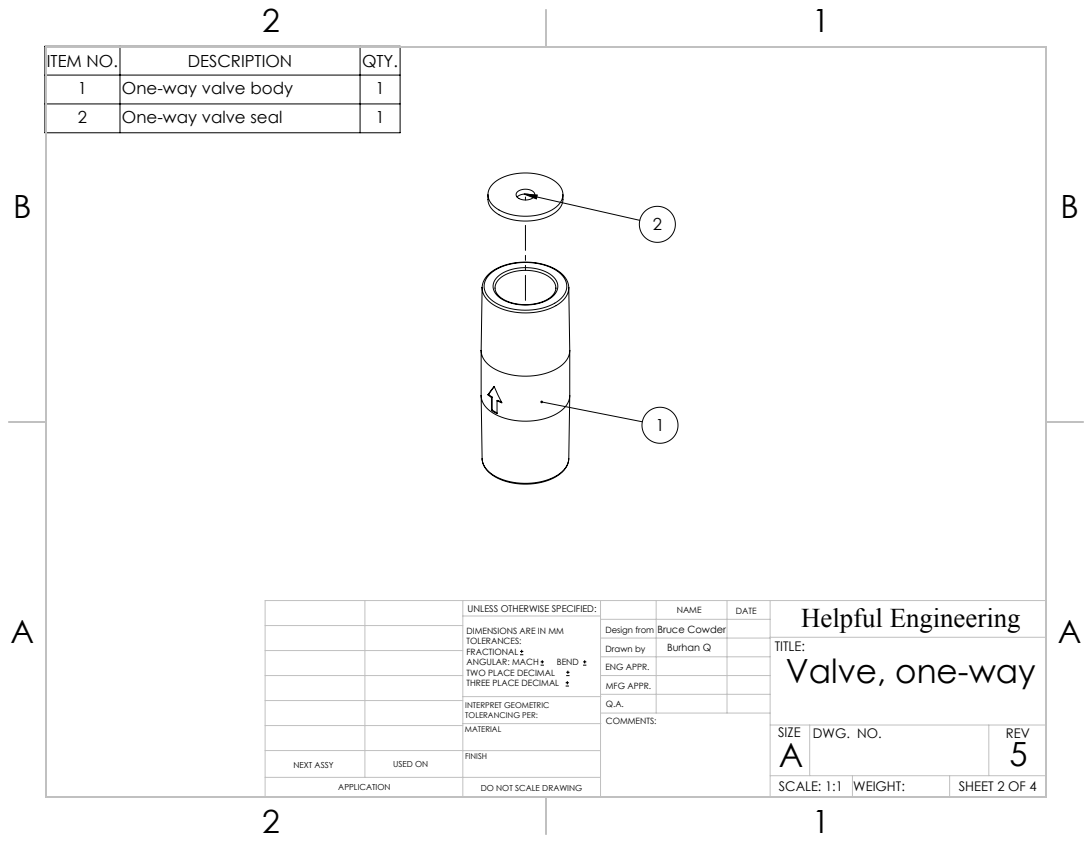
[picture p226: page 2]

ITEM NO. | DESCRIPTION | QTY.
1 | One-way valve body | 1
2 | One-way valve seal | 1

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

Drawn by | Burhan Q | | TITLE: Valve, one-way

ENG APPR.
MFG APPR.

INTERPRET GEOMETRIC TOLERANCING PER: | Q.A.
MATERIAL | | SIZE A | DWG. NO. | REV 5

NEXT ASSY | USED ON | FINISH

SCALE: 1:1 | WEIGHT:

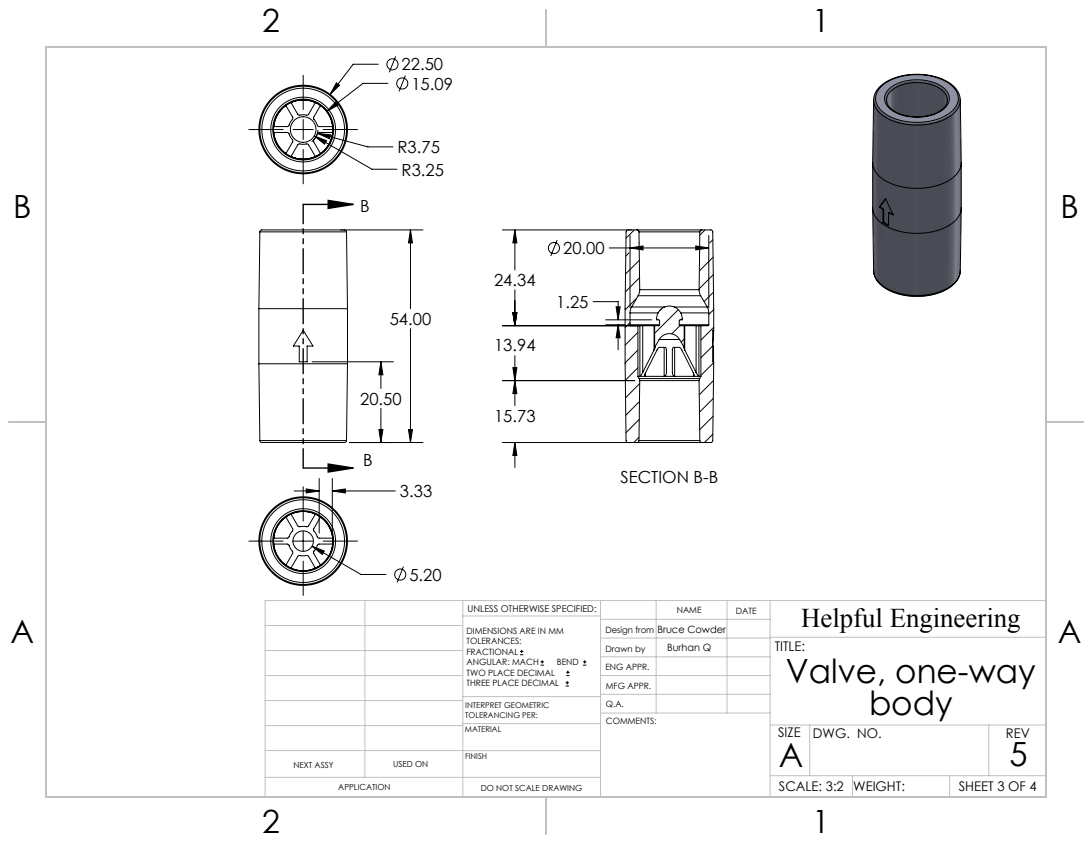
[picture p227: page 3]
SECTION B-B

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

Drawn by | Burhan Q | | TITLE: Valve, one-way body

ENG APPR.
MFG APPR.

INTERPRET GEOMETRIC TOLERANCING PER: | Q.A.
MATERIAL | | SIZE A | DWG. NO. | REV 5

NEXT ASSY | USED ON | FINISH

SCALE: 3:2 | WEIGHT:

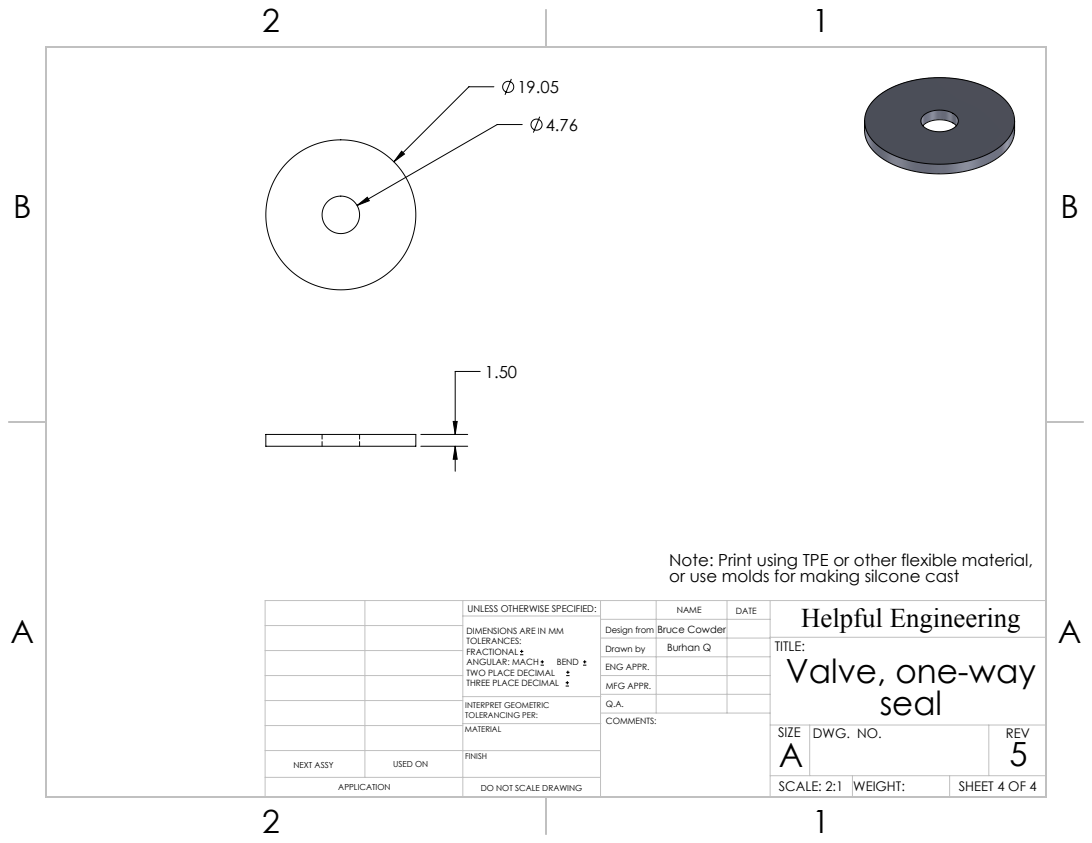
[picture p228: page 4]

Note: Print using TPE or other flexible material,
or use molds for making silcone cast

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

Drawn by | Burhan Q | | TITLE: Valve, one-way seal

ENG APPR.
MFG APPR.

INTERPRET GEOMETRIC TOLERANCING PER: | Q.A.
MATERIAL | | SIZE A | DWG. NO. | REV 5

NEXT ASSY | USED ON | FINISH

SCALE: 2:1 | WEIGHT:
