tetrabiodistributed/project-tetra/03_Visulisation_and_Handbooks/CAD_drawings/CPAP_regulator_venturi/FiO2-34_BQ.PDF

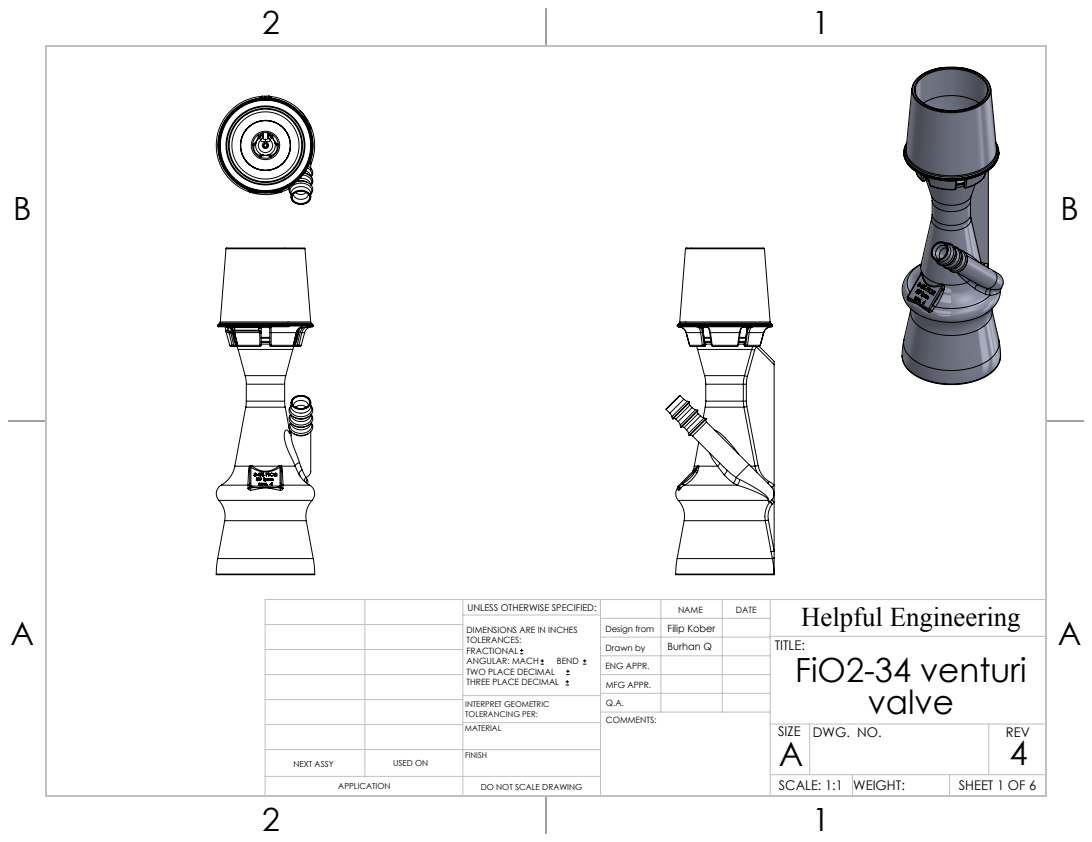
[picture p241: page 1]

UNLESS OTHERWISE SPECIFIED: | | | DATE | Helpful Engineering NAME
DIMENSIONS ARE IN INCHES TOLERANCES: FRACTIONAL ANGULAR: MACH BEND TWO PLACE DECIMAL THREE PLACE DECIMAL | Design from | Filip Kober

Drawn by | Burhan Q | | TITLE: FiO2-34 venturi valve

ENG APPR.
MFG APPR.

INTERPRET GEOMETRIC TOLERANCING PER: | Q.A.
MATERIAL | | SIZE A | DWG. NO. | REV 4

NEXT ASSY | USED ON | FINISH

APPLICATION | DO NOT SCALE DRAWING | | SCALE: 1:1 | WEIGHT: | SHEET 1 OF 6

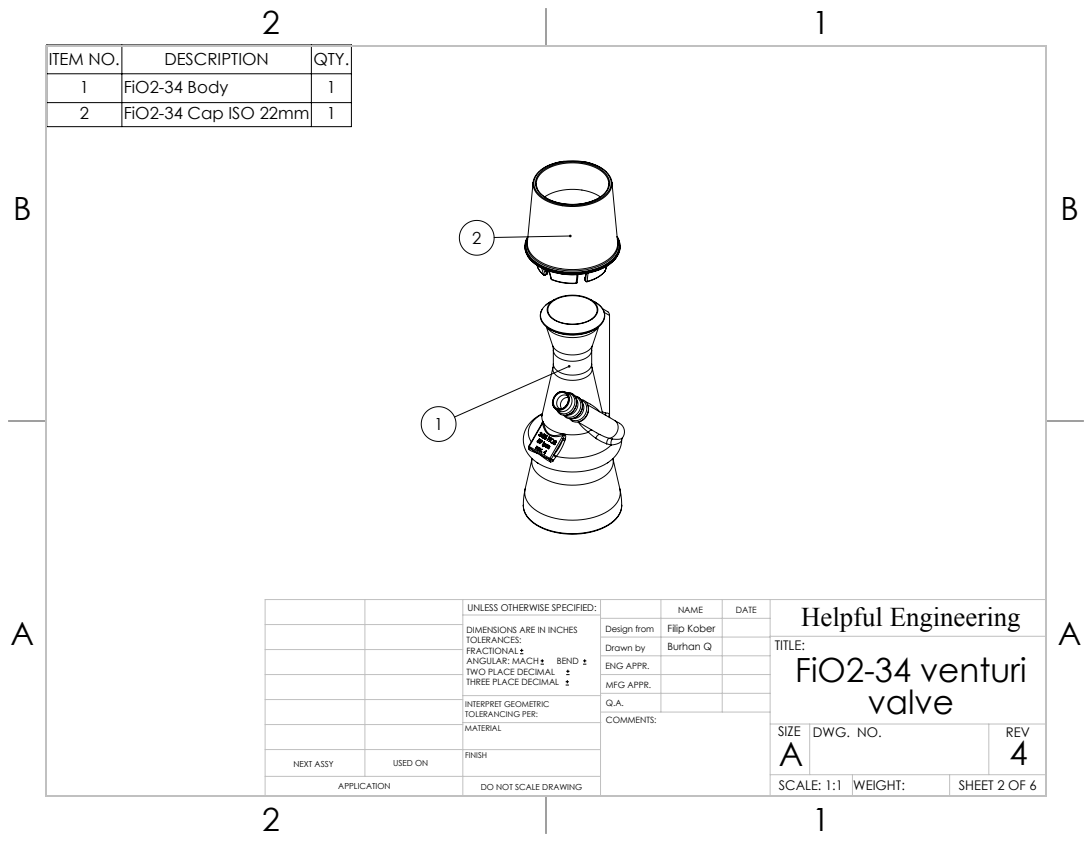
[picture p242: page 2]

ITEM NO. | DESCRIPTION | QTY.
1 | FiO2-34 Body | 1
2 | FiO2-34 Cap ISO 22mm | 1

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

Drawn by | Burhan Q | | TITLE: FiO2-34 venturi valve

ENG APPR.
MFG APPR.

INTERPRET GEOMETRIC TOLERANCING PER: | Q.A.
MATERIAL | | SIZE A | DWG. NO. | REV 4

NEXT ASSY | USED ON | FINISH

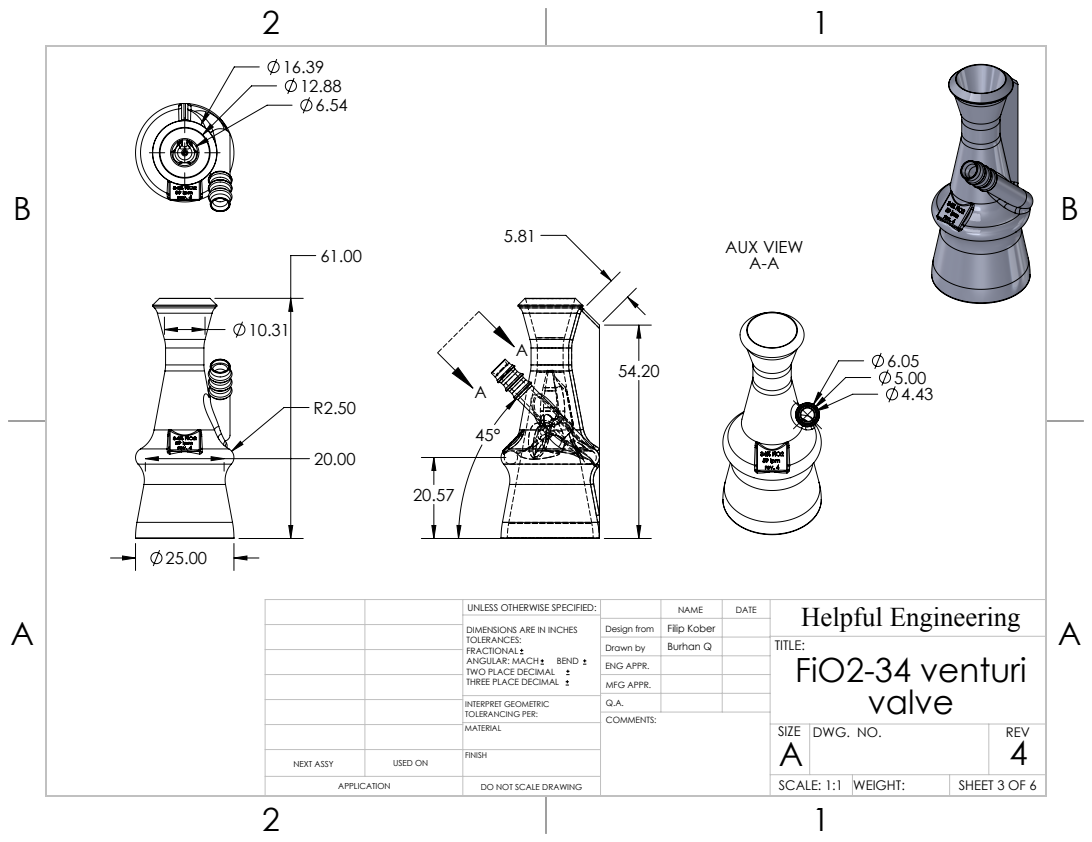
[picture p243: page 3]
AUX VIEW

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

Drawn by | Burhan Q | | TITLE: FiO2-34 venturi valve

ENG APPR.
MFG APPR.

INTERPRET GEOMETRIC TOLERANCING PER: | Q.A.
MATERIAL | | SIZE A | DWG. NO. | REV 4

NEXT ASSY | USED ON | FINISH

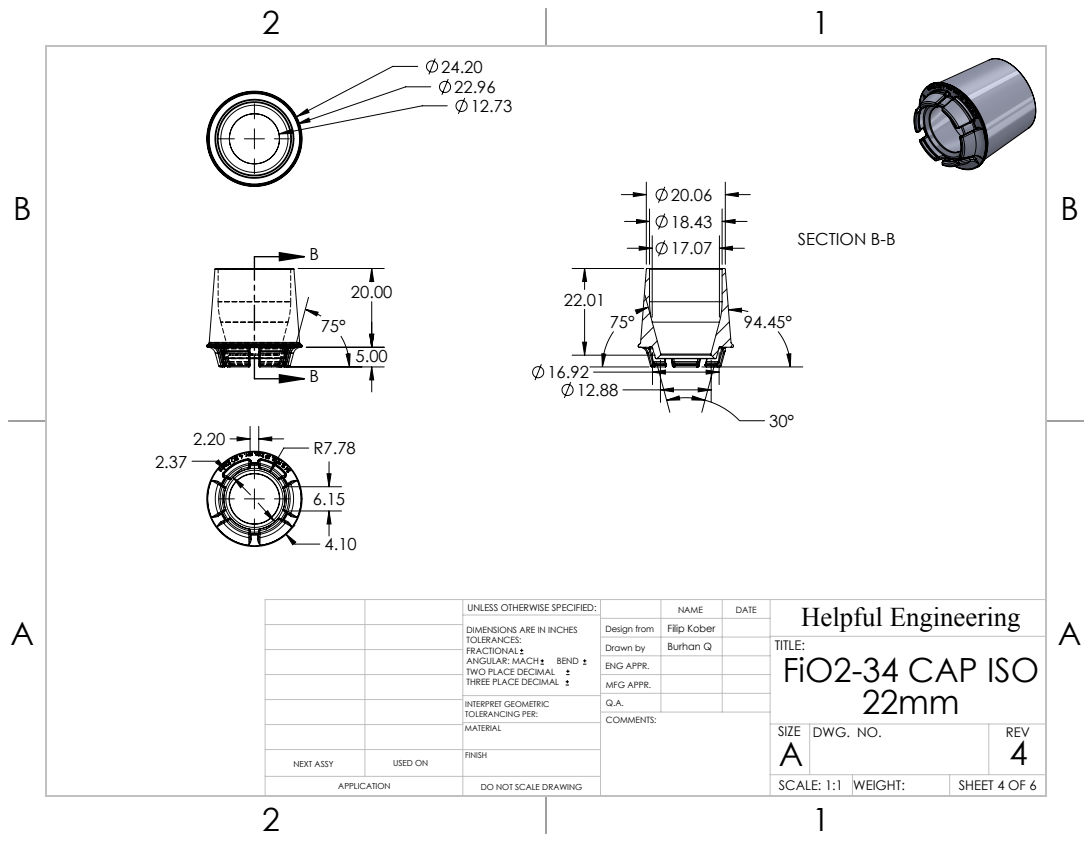
[picture p244: page 4]
SECTION B-B

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

Drawn by | Burhan Q | | TITLE: FiO2-34 CAP ISO 22mm

ENG APPR.
MFG APPR.

INTERPRET GEOMETRIC TOLERANCING PER: | Q.A.
MATERIAL | | SIZE A | DWG. NO. | REV 4

NEXT ASSY | USED ON | FINISH

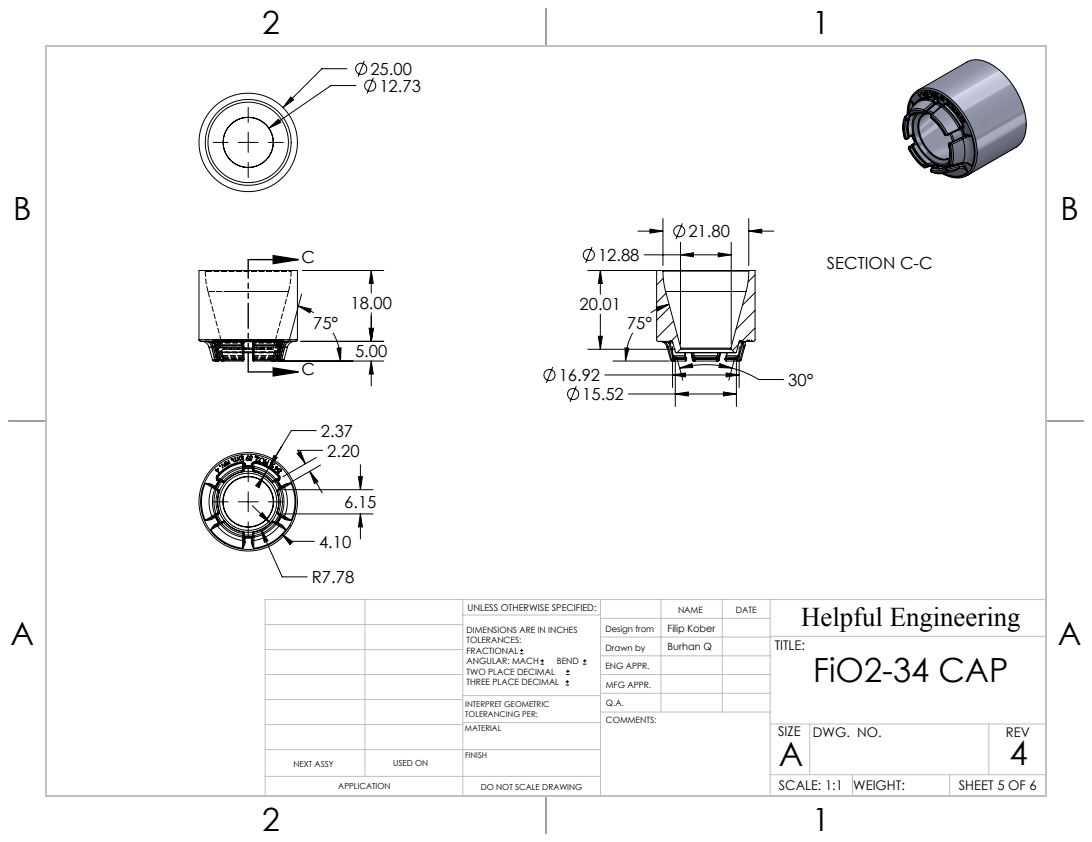
[picture p245: page 5]
SECTION C-C

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

Drawn by | Burhan Q | | TITLE: FiO2-34 CAP

ENG APPR.
MFG APPR.

INTERPRET GEOMETRIC TOLERANCING PER: | Q.A.
MATERIAL | | SIZE A | DWG. NO. | REV 4

NEXT ASSY | USED ON | FINISH

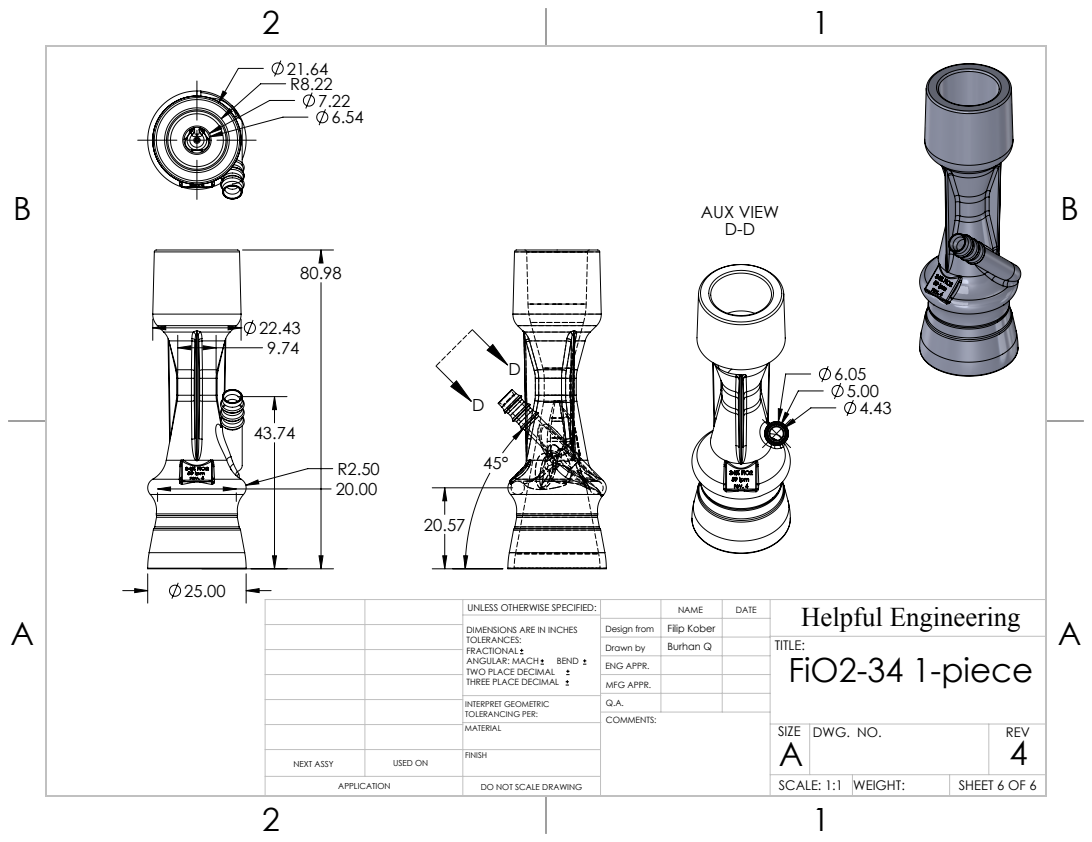
[picture p246: page 6]
AUX VIEW

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

Drawn by | Burhan Q | | TITLE: FiO2-34 1-piece

ENG APPR.
MFG APPR.

INTERPRET GEOMETRIC TOLERANCING PER: | Q.A.
MATERIAL | | SIZE A | DWG. NO. | REV 4

NEXT ASSY | USED ON | FINISH
