tetrabiodistributed/project-tetra/03_Visulisation_and_Handbooks/CAD_drawings/PEEP_valve_rev2/PEEP_valve_regulator_BQ.PDF

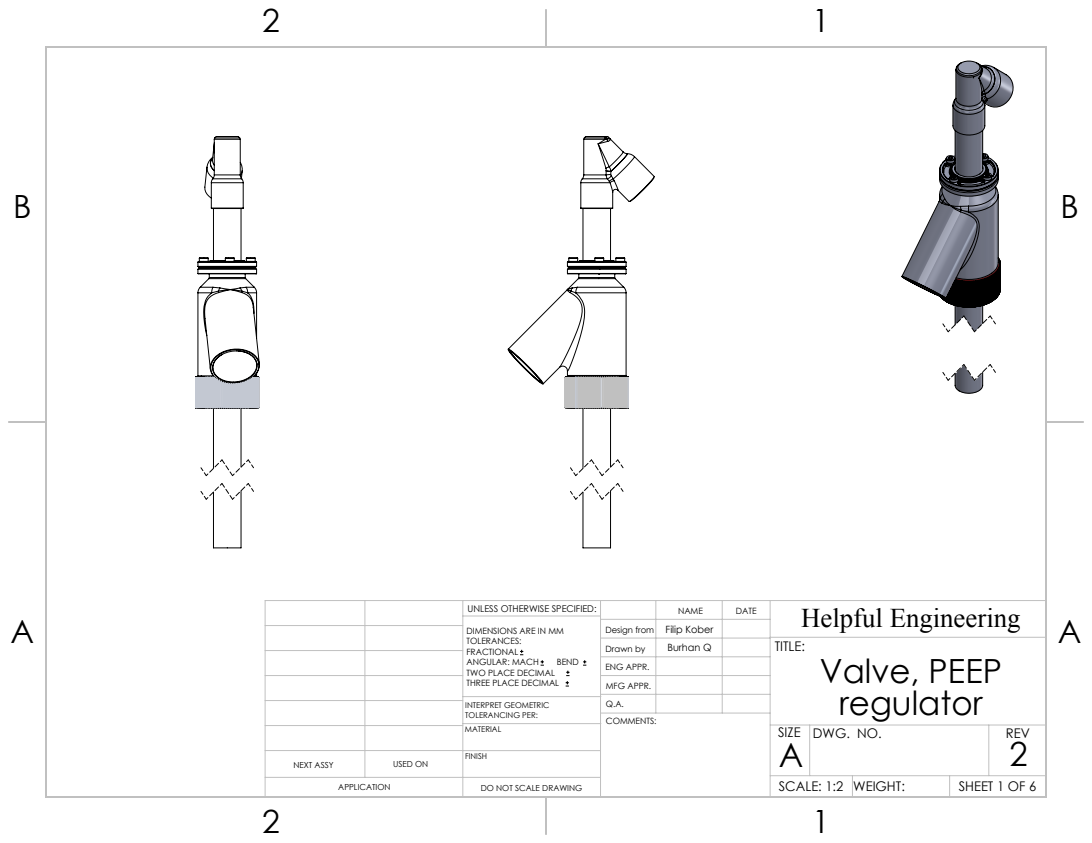
[picture p259: page 1]

UNLESS OTHERWISE SPECIFIED: | | | DATE | Helpful Engineering NAME
DIMENSIONS ARE IN MM TOLERANCES: FRACTIONAL ANGULAR: MACH BEND TWO PLACE DECIMAL THREE PLACE DECIMAL | Design from | Filip Kober

Drawn by | Burhan Q | | TITLE: Valve, PEEP regulator

ENG APPR.
MFG APPR.

INTERPRET GEOMETRIC TOLERANCING PER: | Q.A.
MATERIAL | | SIZE A | DWG. NO. | REV 2

NEXT ASSY | USED ON | FINISH

APPLICATION | DO NOT SCALE DRAWING | | SCALE: 1:2 | WEIGHT: | SHEET 1 OF 6

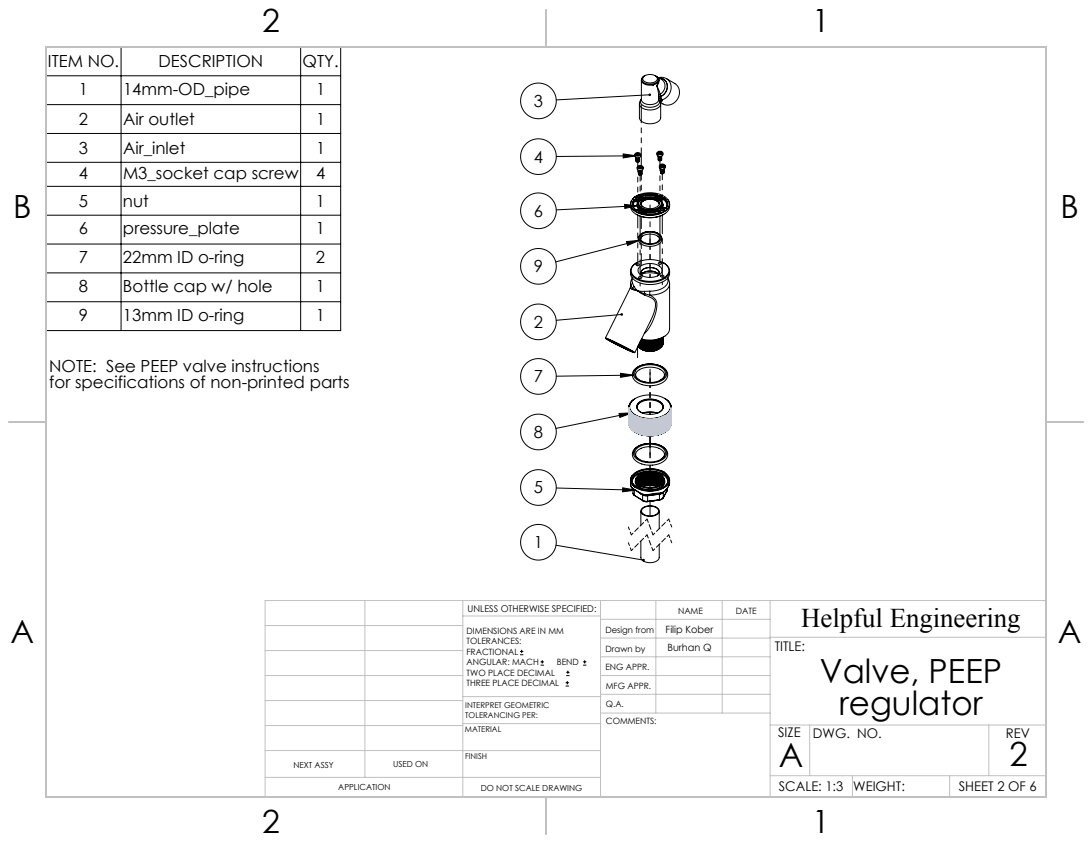
[picture p260: page 2]

ITEM NO. | DESCRIPTION | QTY.
1 | 14mm-OD_pipe | 1
2 | Air outlet | 1
3 | Air_inlet | 1
4 | M3_socket cap screw | 4
5 | nut | 1
6 | pressure_plate | 1
7 | 22mm ID o-ring | 2
8 | Bottle cap w/ hole | 1
9 | 13mm ID o-ring | 1

NOTE: See PEEP valve instructions
for specifications of non-printed parts

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

Drawn by | Burhan Q | | TITLE: Valve, PEEP regulator

ENG APPR.
MFG APPR.

INTERPRET GEOMETRIC TOLERANCING PER: | Q.A.
MATERIAL | | SIZE A | DWG. NO. | REV 2

NEXT ASSY | USED ON | FINISH

SCALE: 1:3 | WEIGHT:

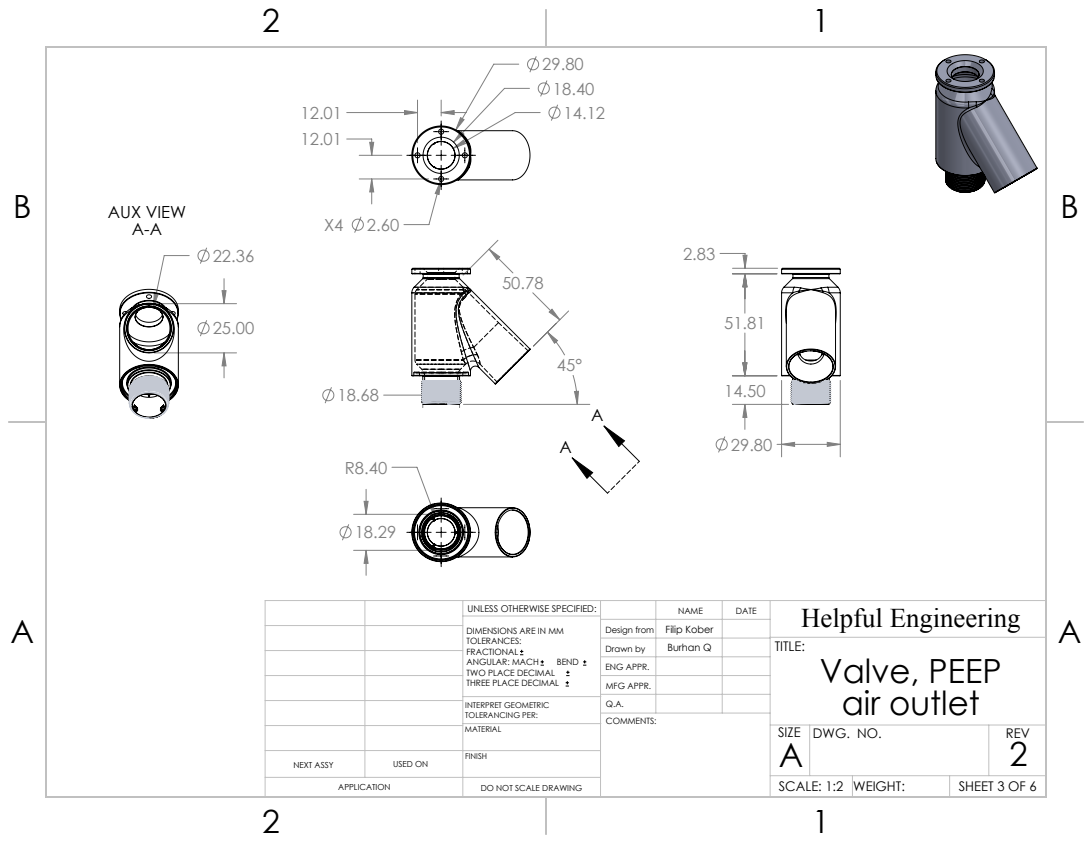
[picture p261: page 3]
AUX VIEW

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

Drawn by | Burhan Q | | TITLE: Valve, PEEP air outlet

ENG APPR.
MFG APPR.

INTERPRET GEOMETRIC TOLERANCING PER: | Q.A.
MATERIAL | | SIZE A | DWG. NO. | REV 2

NEXT ASSY | USED ON | FINISH

SCALE: 1:2 | WEIGHT:

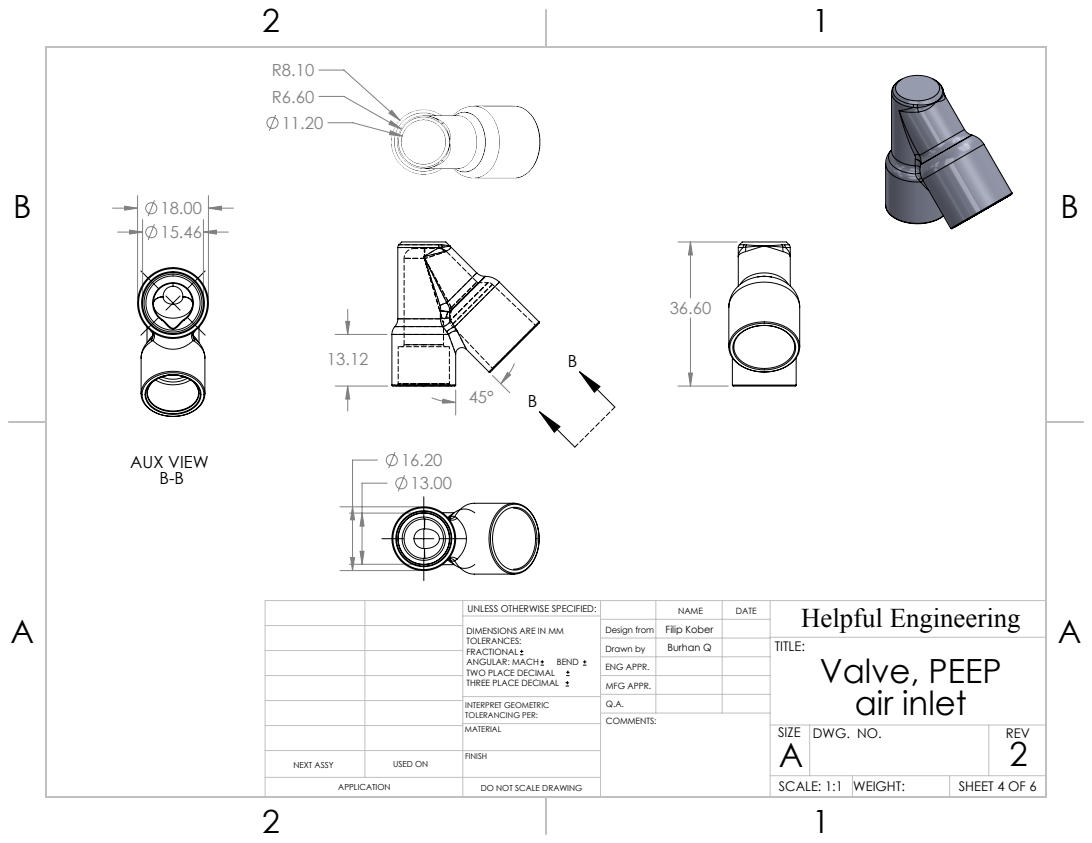
[picture p262: page 4]
AUX VIEW

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

Drawn by | Burhan Q | | TITLE: Valve, PEEP air inlet

ENG APPR.
MFG APPR.

INTERPRET GEOMETRIC TOLERANCING PER: | Q.A.
MATERIAL | | SIZE A | DWG. NO. | REV 2

NEXT ASSY | USED ON | FINISH

SCALE: 1:1 | WEIGHT:

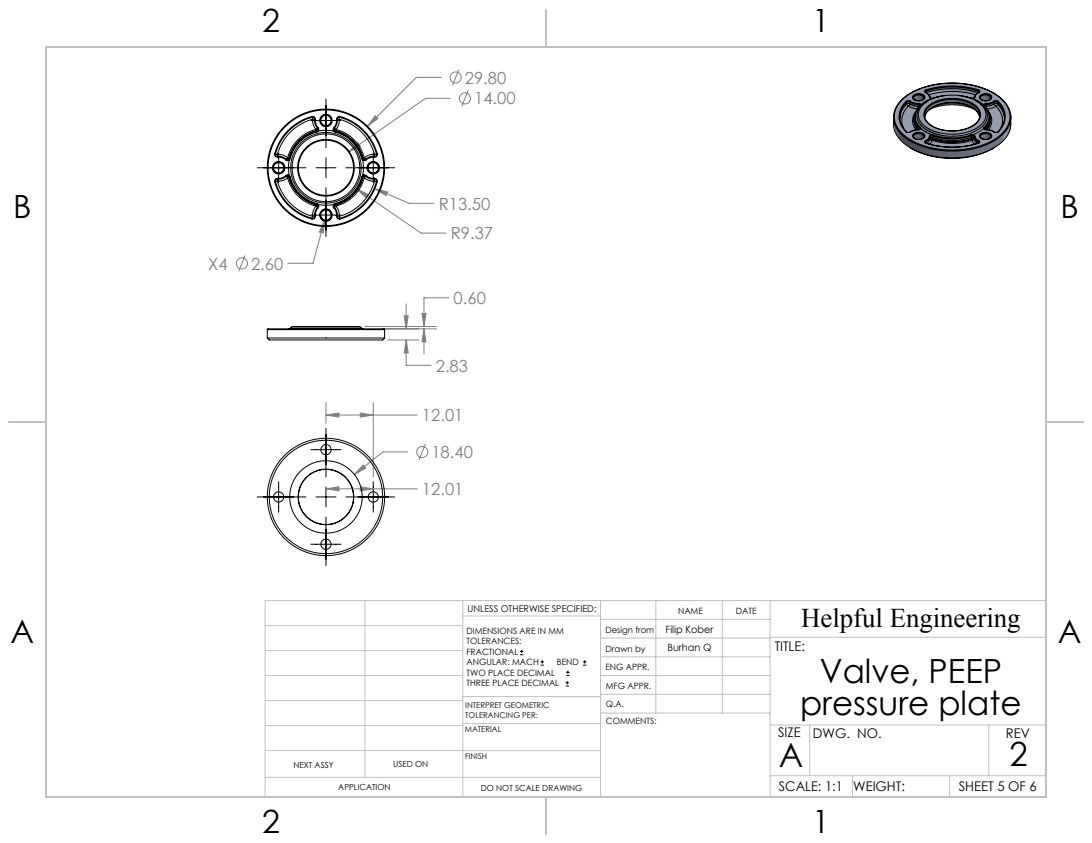
[picture p263: page 5]
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

Drawn by | Burhan Q | | TITLE: Valve, PEEP pressure plate

ENG APPR.
MFG APPR.

INTERPRET GEOMETRIC TOLERANCING PER: | Q.A.
MATERIAL | | SIZE A | DWG. NO. | REV 2

NEXT ASSY | USED ON | FINISH

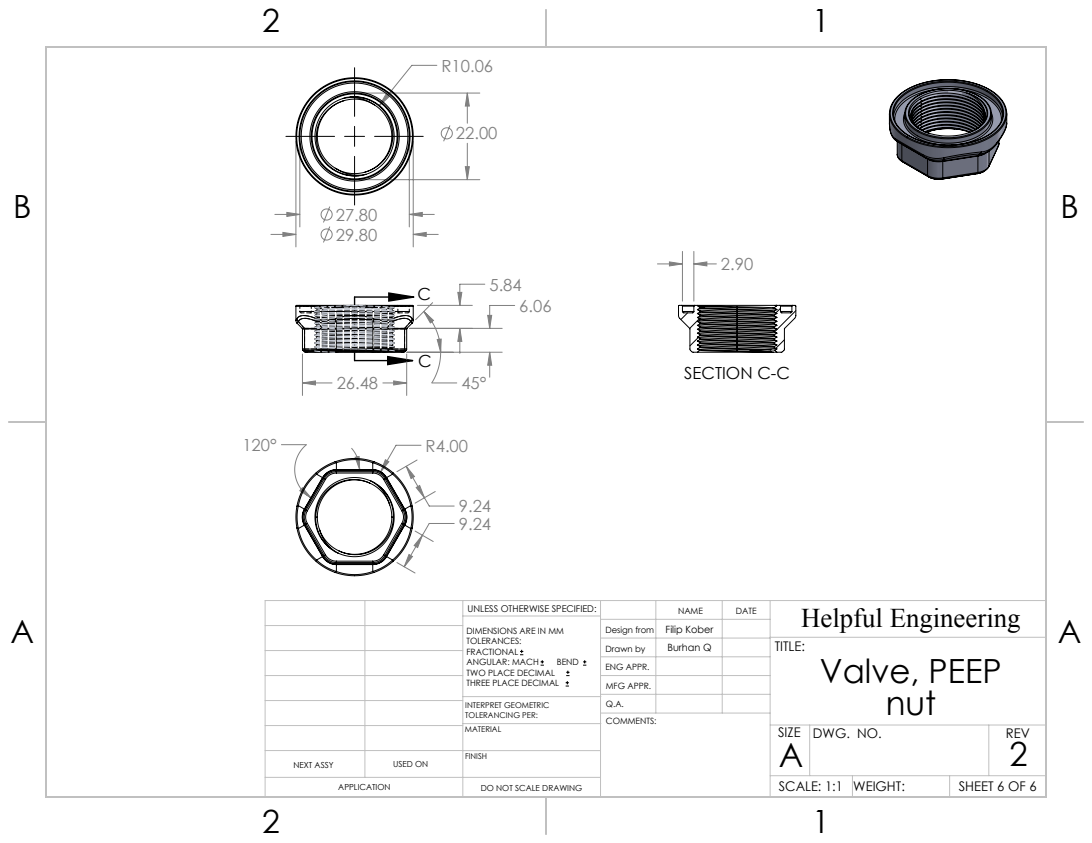
[picture p264: page 6]
SECTION C-C

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

Drawn by | Burhan Q | | TITLE: Valve, PEEP nut

ENG APPR.
MFG APPR.

INTERPRET GEOMETRIC TOLERANCING PER: | Q.A.
MATERIAL | | SIZE A | DWG. NO. | REV 2

NEXT ASSY | USED ON | FINISH
