tetrabiodistributed/project-tetra/03_Visulisation_and_Handbooks/CAD_drawings/Splitters/22mm_splitters_BQ.PDF

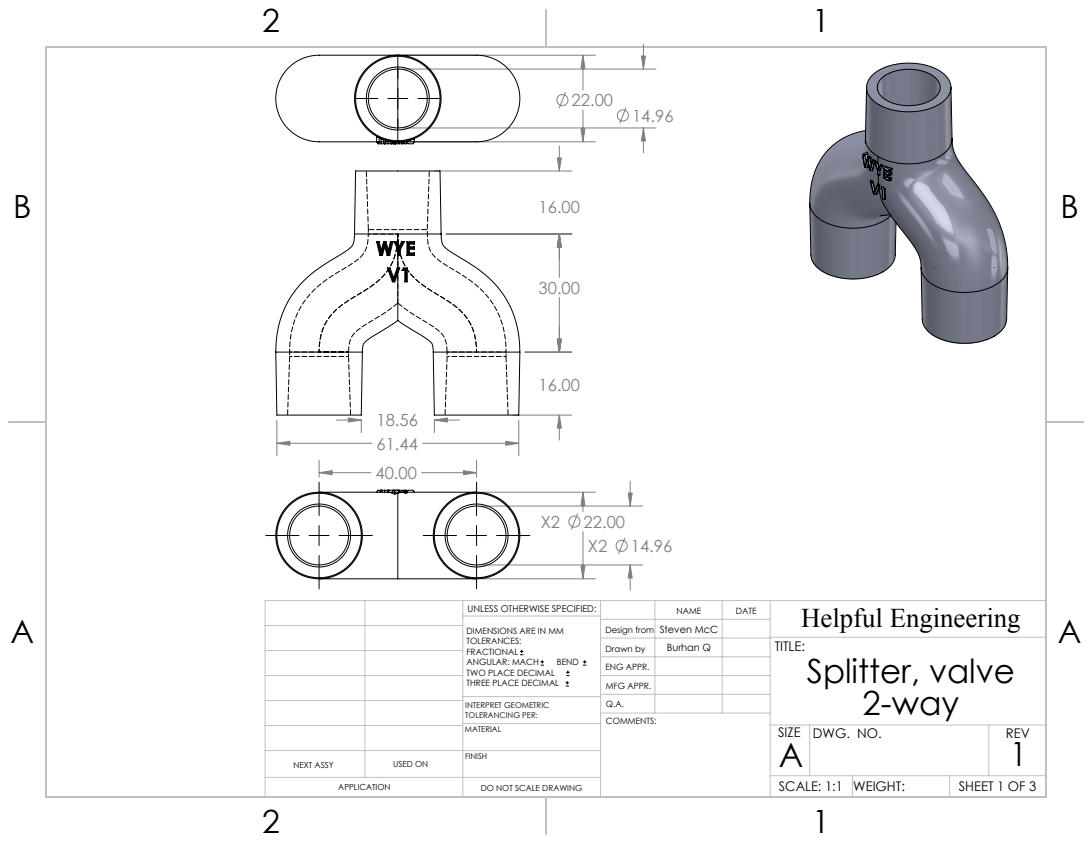
[picture p265: page 1]

UNLESS OTHERWISE SPECIFIED: | | | DATE | Helpful Engineering NAME
DIMENSIONS ARE IN MM TOLERANCES: FRACTIONAL ANGULAR: MACH BEND TWO PLACE DECIMAL THREE PLACE DECIMAL | Design from | Steven McC

Drawn by | Burhan Q | | TITLE: Splitter, valve 2-way

ENG APPR.
MFG APPR.

INTERPRET GEOMETRIC TOLERANCING PER: | Q.A.
MATERIAL | | SIZE A | DWG. NO. | REV 1

NEXT ASSY | USED ON | FINISH

APPLICATION | DO NOT SCALE DRAWING | | SCALE: 1:1 | WEIGHT: | SHEET 1 OF 3

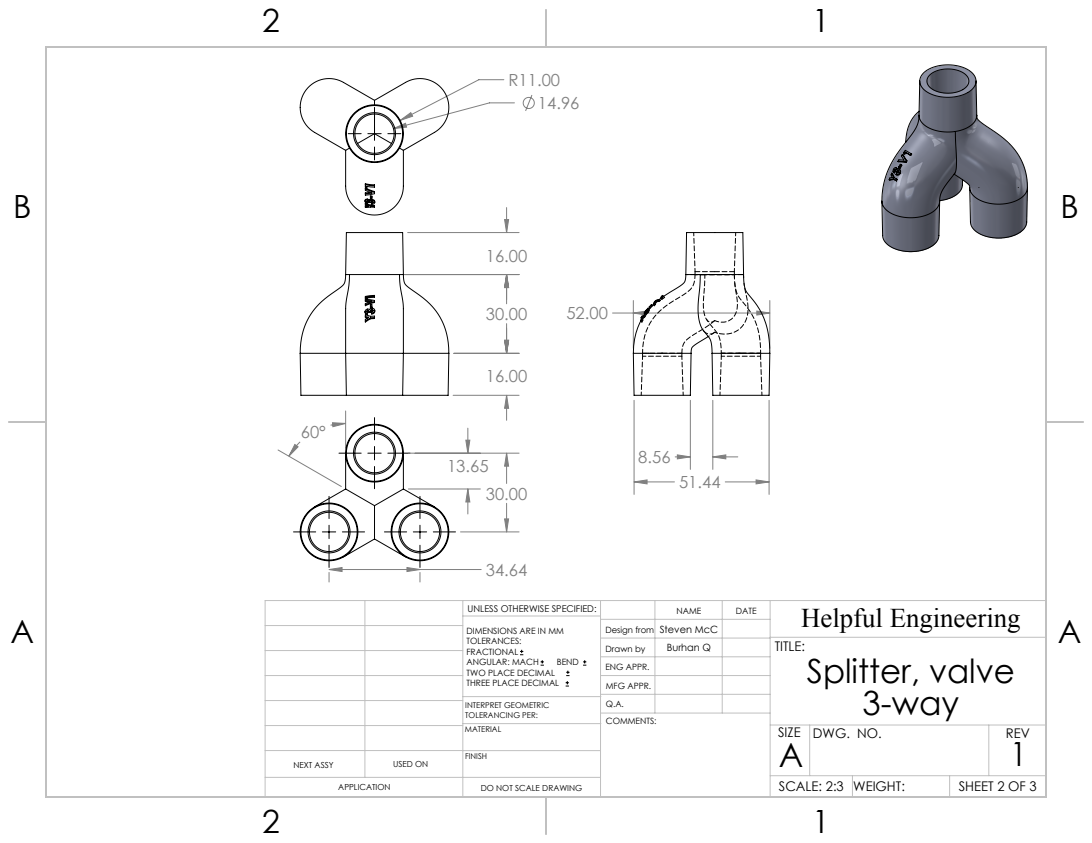
[picture p266: page 2]
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

Drawn by | Burhan Q | | TITLE: Splitter, valve 3-way

ENG APPR.
MFG APPR.

INTERPRET GEOMETRIC TOLERANCING PER: | Q.A.
MATERIAL | | SIZE A | DWG. NO. | REV 1

NEXT ASSY | USED ON | FINISH

SCALE: 2:3 | WEIGHT:

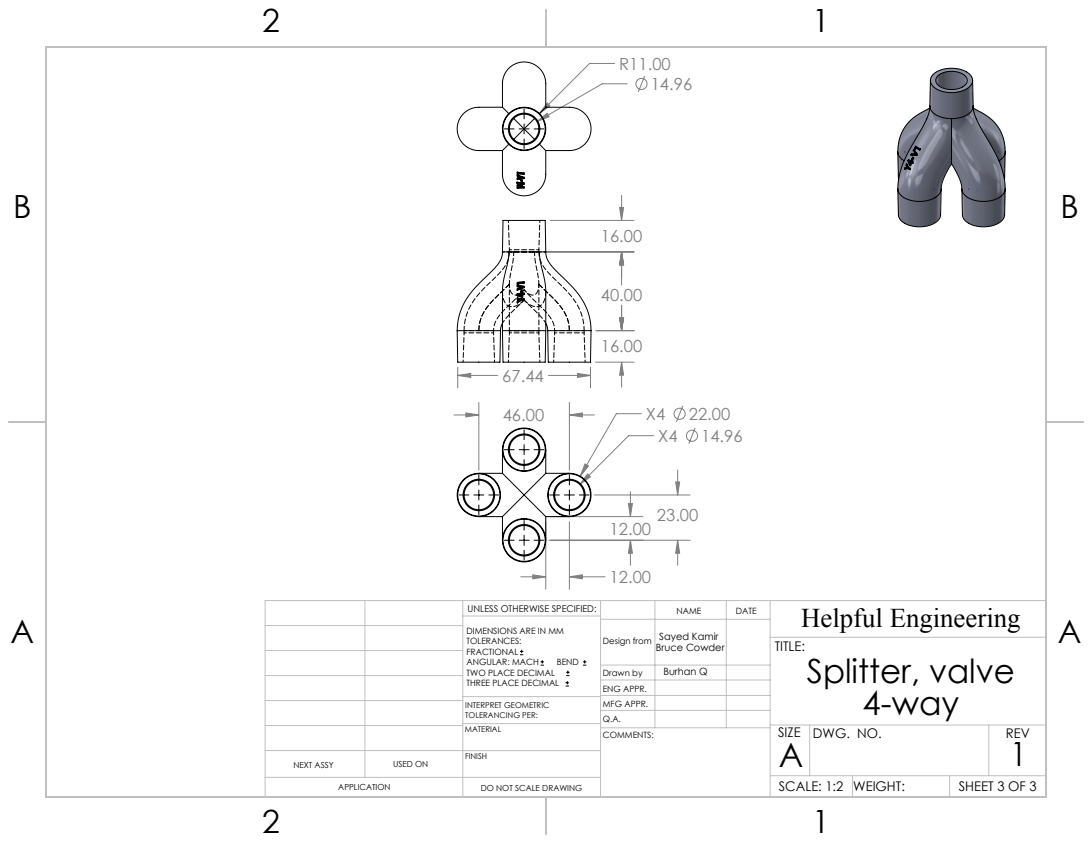
[picture p267: page 3]
Splitter, valve

UNLESS OTHERWISE SPECIFIED: | | | DATE | Helpful Engineering NAME
DIMENSIONS ARE IN MM TOLERANCES: FRACTIONAL ANGULAR: MACH BEND TWO PLACE DECIMAL THREE PLACE DECIMAL | Design from | Sayed Kamir Bruce Cowder

Drawn by | Burhan Q
ENG APPR.

INTERPRET GEOMETRIC TOLERANCING PER: | MFG APPR.
MATERIAL | COMMENTS: | SIZE A | DWG. NO. | REV 1

NEXT ASSY | USED ON | FINISH

SCALE: 1:2 | WEIGHT:
