tetrabiodistributed/project-tetra/05_Visulisation_and_Handbooks/CAD_drawings/One-way_valve/one-way_valve_BQ.PDF

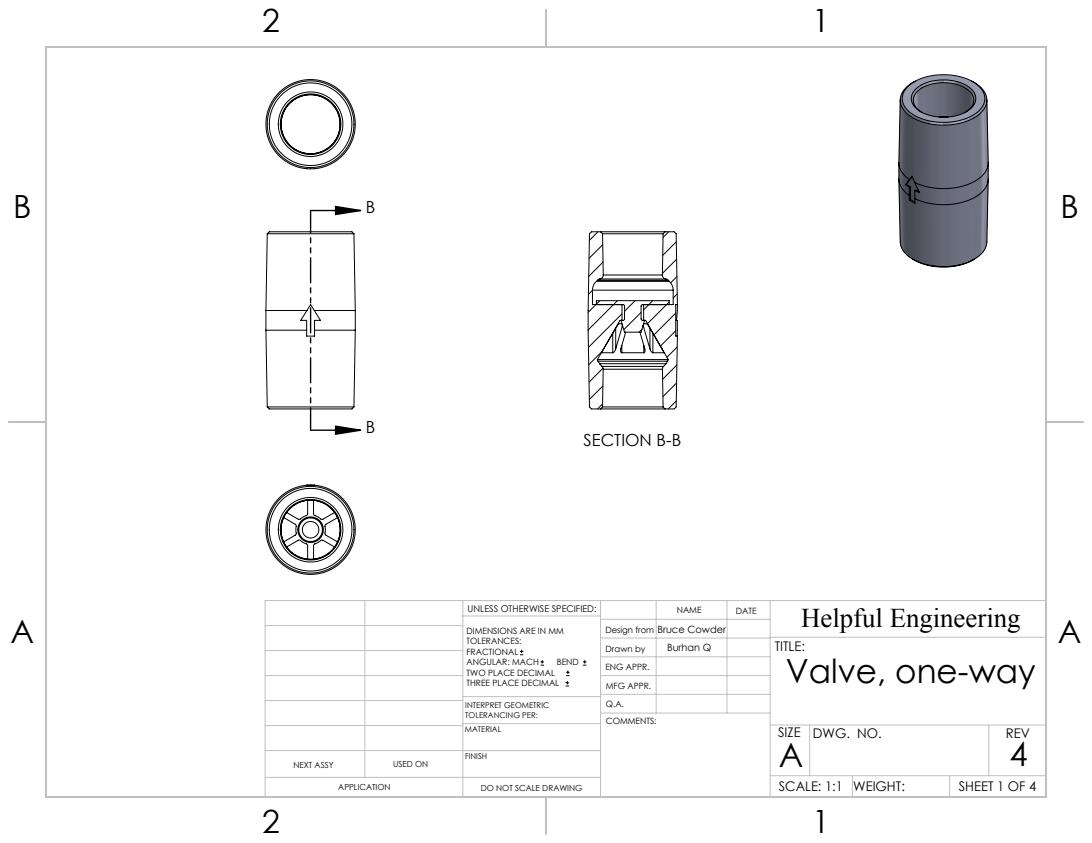
[picture p268: page 1]
SECTION B-B

UNLESS OTHERWISE SPECIFIED: | | | DATE | Helpful Engineering NAME
DIMENSIONS ARE IN MM TOLERANCES: FRACTIONAL ANGULAR: MACH BEND TWO PLACE DECIMAL THREE PLACE DECIMAL | Design from | Bruce Cowder

Drawn by | Burhan Q | | TITLE: Valve, one-way

ENG APPR.
MFG APPR.

INTERPRET GEOMETRIC TOLERANCING PER: | Q.A.
MATERIAL | | SIZE A | DWG. NO. | REV 4

NEXT ASSY | USED ON | FINISH

APPLICATION | DO NOT SCALE DRAWING | | SCALE: 1:1 | WEIGHT: | SHEET 1 OF 4

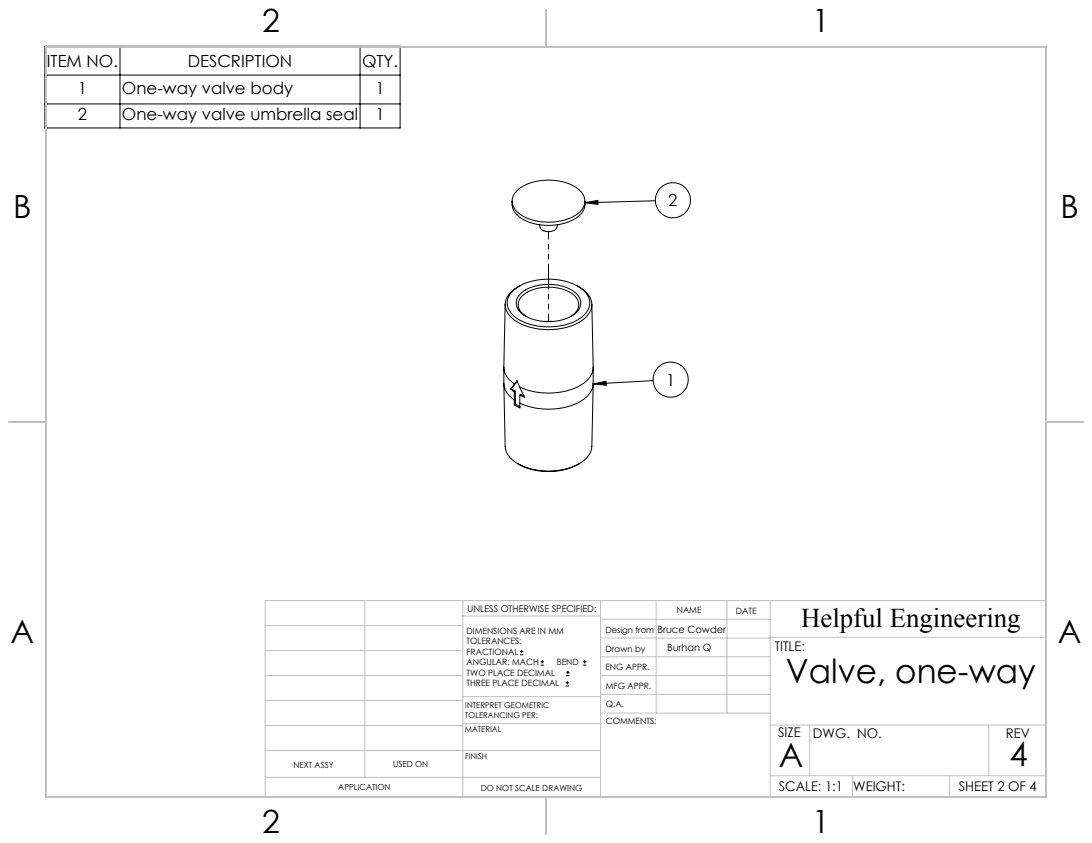
[picture p269: page 2]

ITEM NO. | DESCRIPTION | QTY.
1 | One-way valve body | 1
2 | One-way valve umbrella seal | 1

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

Drawn by | Burhan Q | | TITLE: Valve, one-way

ENG APPR.
MFG APPR.

INTERPRET GEOMETRIC TOLERANCING PER: | Q.A.
MATERIAL | | SIZE A | DWG. NO. | REV 4

NEXT ASSY | USED ON | FINISH

SCALE: 1:1 | WEIGHT:

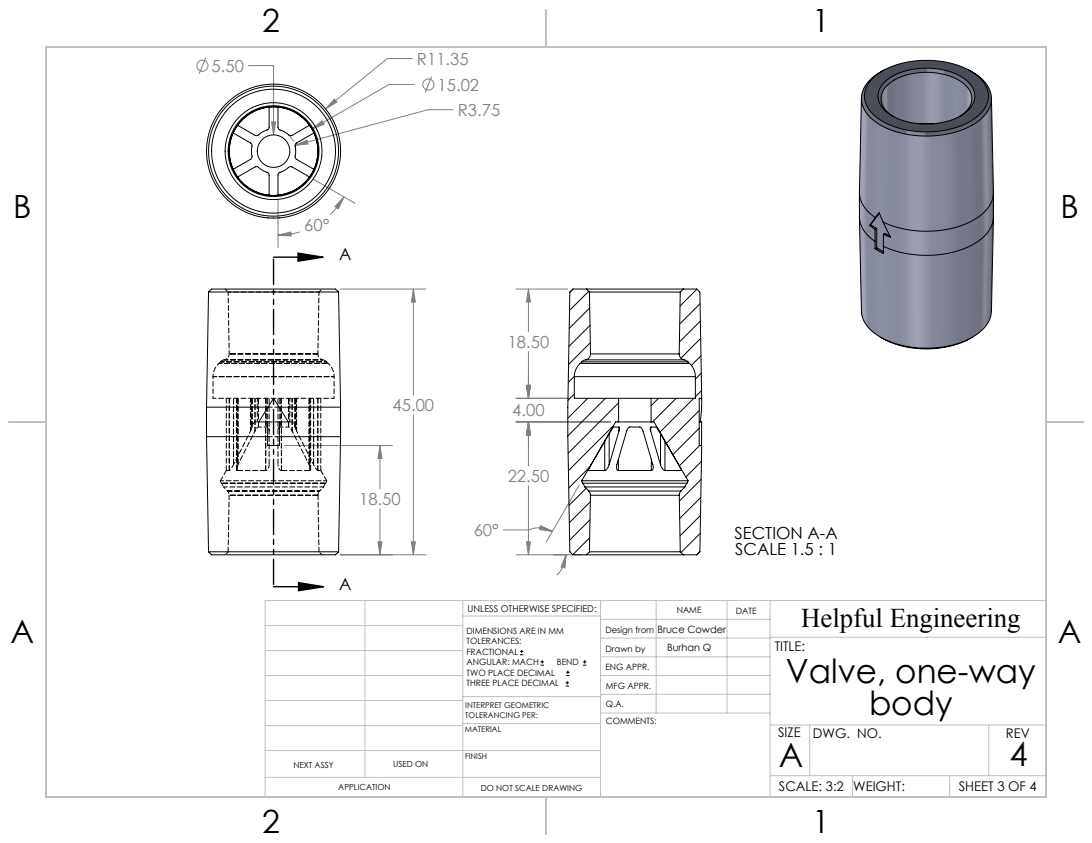
[picture p270: page 3]
SECTION A-A SCALE 1.5 : 1

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

Drawn by | Burhan Q | | TITLE: Valve, one-way body

ENG APPR.
MFG APPR.

INTERPRET GEOMETRIC TOLERANCING PER: | Q.A.
MATERIAL | | SIZE A | DWG. NO. | REV 4

NEXT ASSY | USED ON | FINISH

SCALE: 3:2 | WEIGHT:

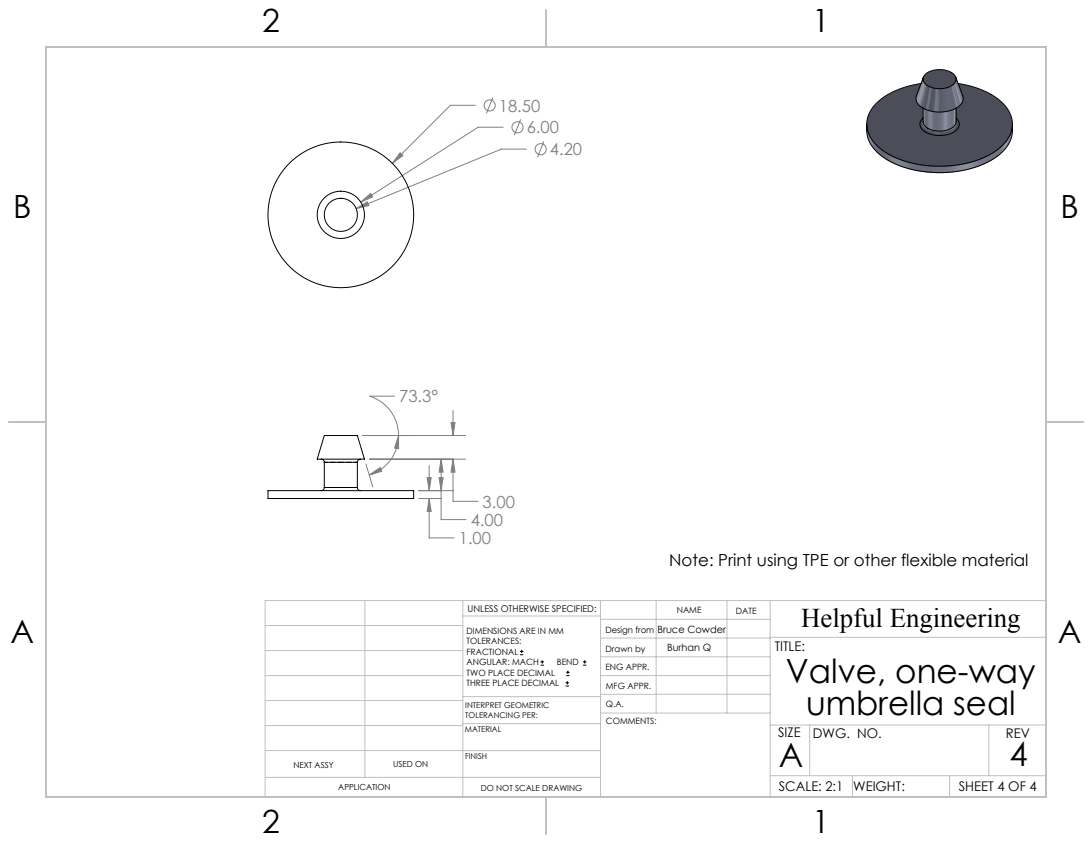
[picture p271: page 4]

Note: Print using TPE or other flexible material

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

Drawn by | Burhan Q | | TITLE: Valve, one-way umbrella seal

ENG APPR.
MFG APPR.

INTERPRET GEOMETRIC TOLERANCING PER: | Q.A.
MATERIAL | | SIZE A | DWG. NO. | REV 4

NEXT ASSY | USED ON | FINISH

SCALE: 2:1 | WEIGHT:
