tetrabiodistributed/project-tetra/03_Visulisation_and_Handbooks/CAD_drawings/Splitters/in-&_expiratory_2way_splitters/inspiratory_and_expiratory_splitters_BQ.PDF

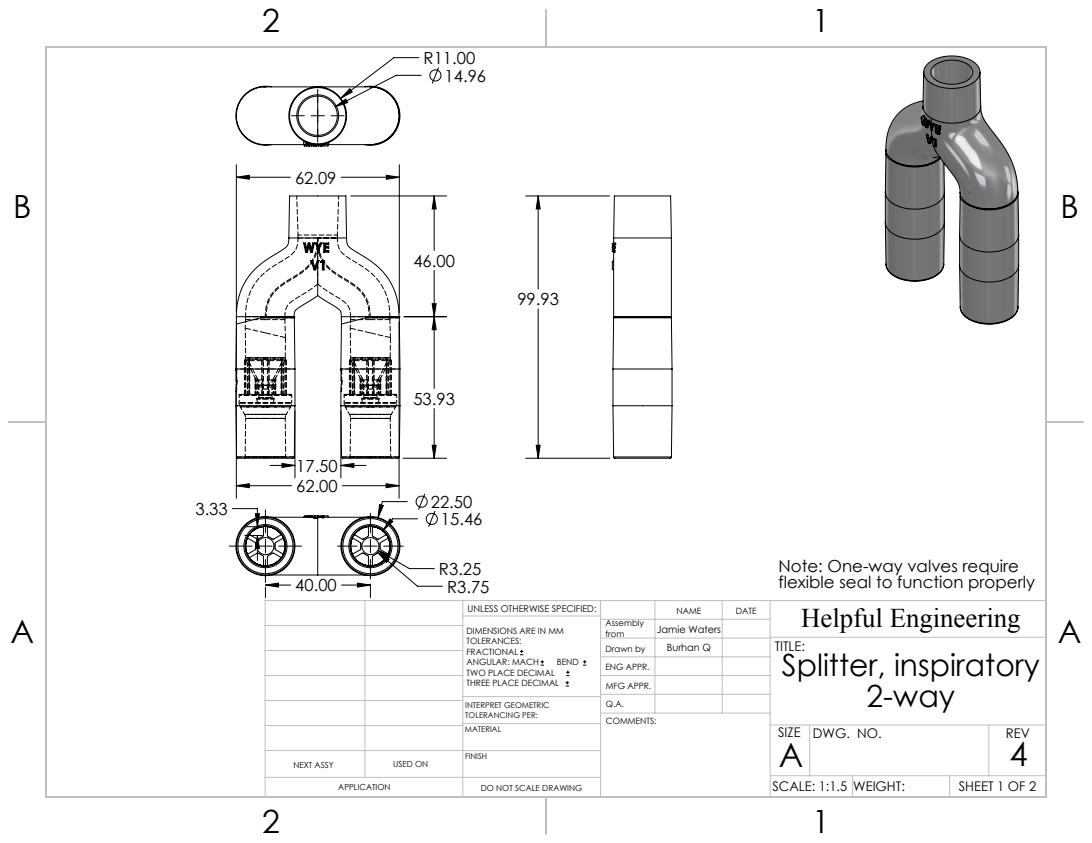
[picture p272: page 1]

Note: One-way valves require
flexible seal to function properly

UNLESS OTHERWISE SPECIFIED: | | | DATE | Helpful Engineering NAME
DIMENSIONS ARE IN MM TOLERANCES: FRACTIONAL ANGULAR: MACH BEND TWO PLACE DECIMAL THREE PLACE DECIMAL | Assembly from | Jamie Waters

Drawn by | Burhan Q | | TITLE: Splitter, inspiratory 2-way

ENG APPR.
MFG APPR.

INTERPRET GEOMETRIC TOLERANCING PER: | Q.A.
MATERIAL | | SIZE A | DWG. NO. | REV 4

NEXT ASSY | USED ON | FINISH

APPLICATION | DO NOT SCALE DRAWING | | SCALE: 1:1.5 | WEIGHT: | SHEET 1 OF 2

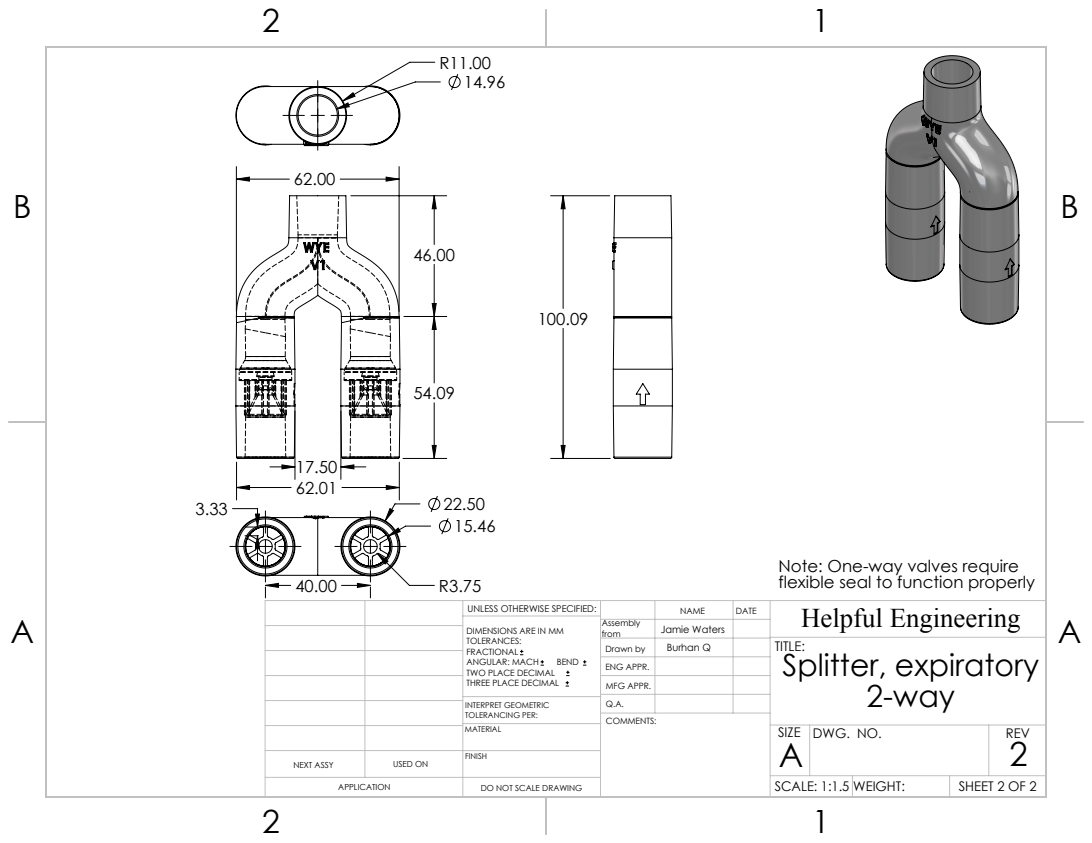
[picture p273: page 2]

Note: One-way valves require
flexible seal to function properly

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

Drawn by | Burhan Q | | TITLE: Splitter, expiratory 2-way

ENG APPR.
MFG APPR.

INTERPRET GEOMETRIC TOLERANCING PER: | Q.A.
MATERIAL | | SIZE A | DWG. NO. | REV 2

NEXT ASSY | USED ON | FINISH

APPLICATION | DO NOT SCALE DRAWING | | SCALE: 1:1.5 WEIGHT: | | SHEET 2 OF 2
