tetrabiodistributed/project-tetra/03_Visulisation_and_Handbooks/CAD_drawings/Tetra_drawing_templates/August-2020/PDF/Tetra Drawing Template - Part FDM v2.pdf

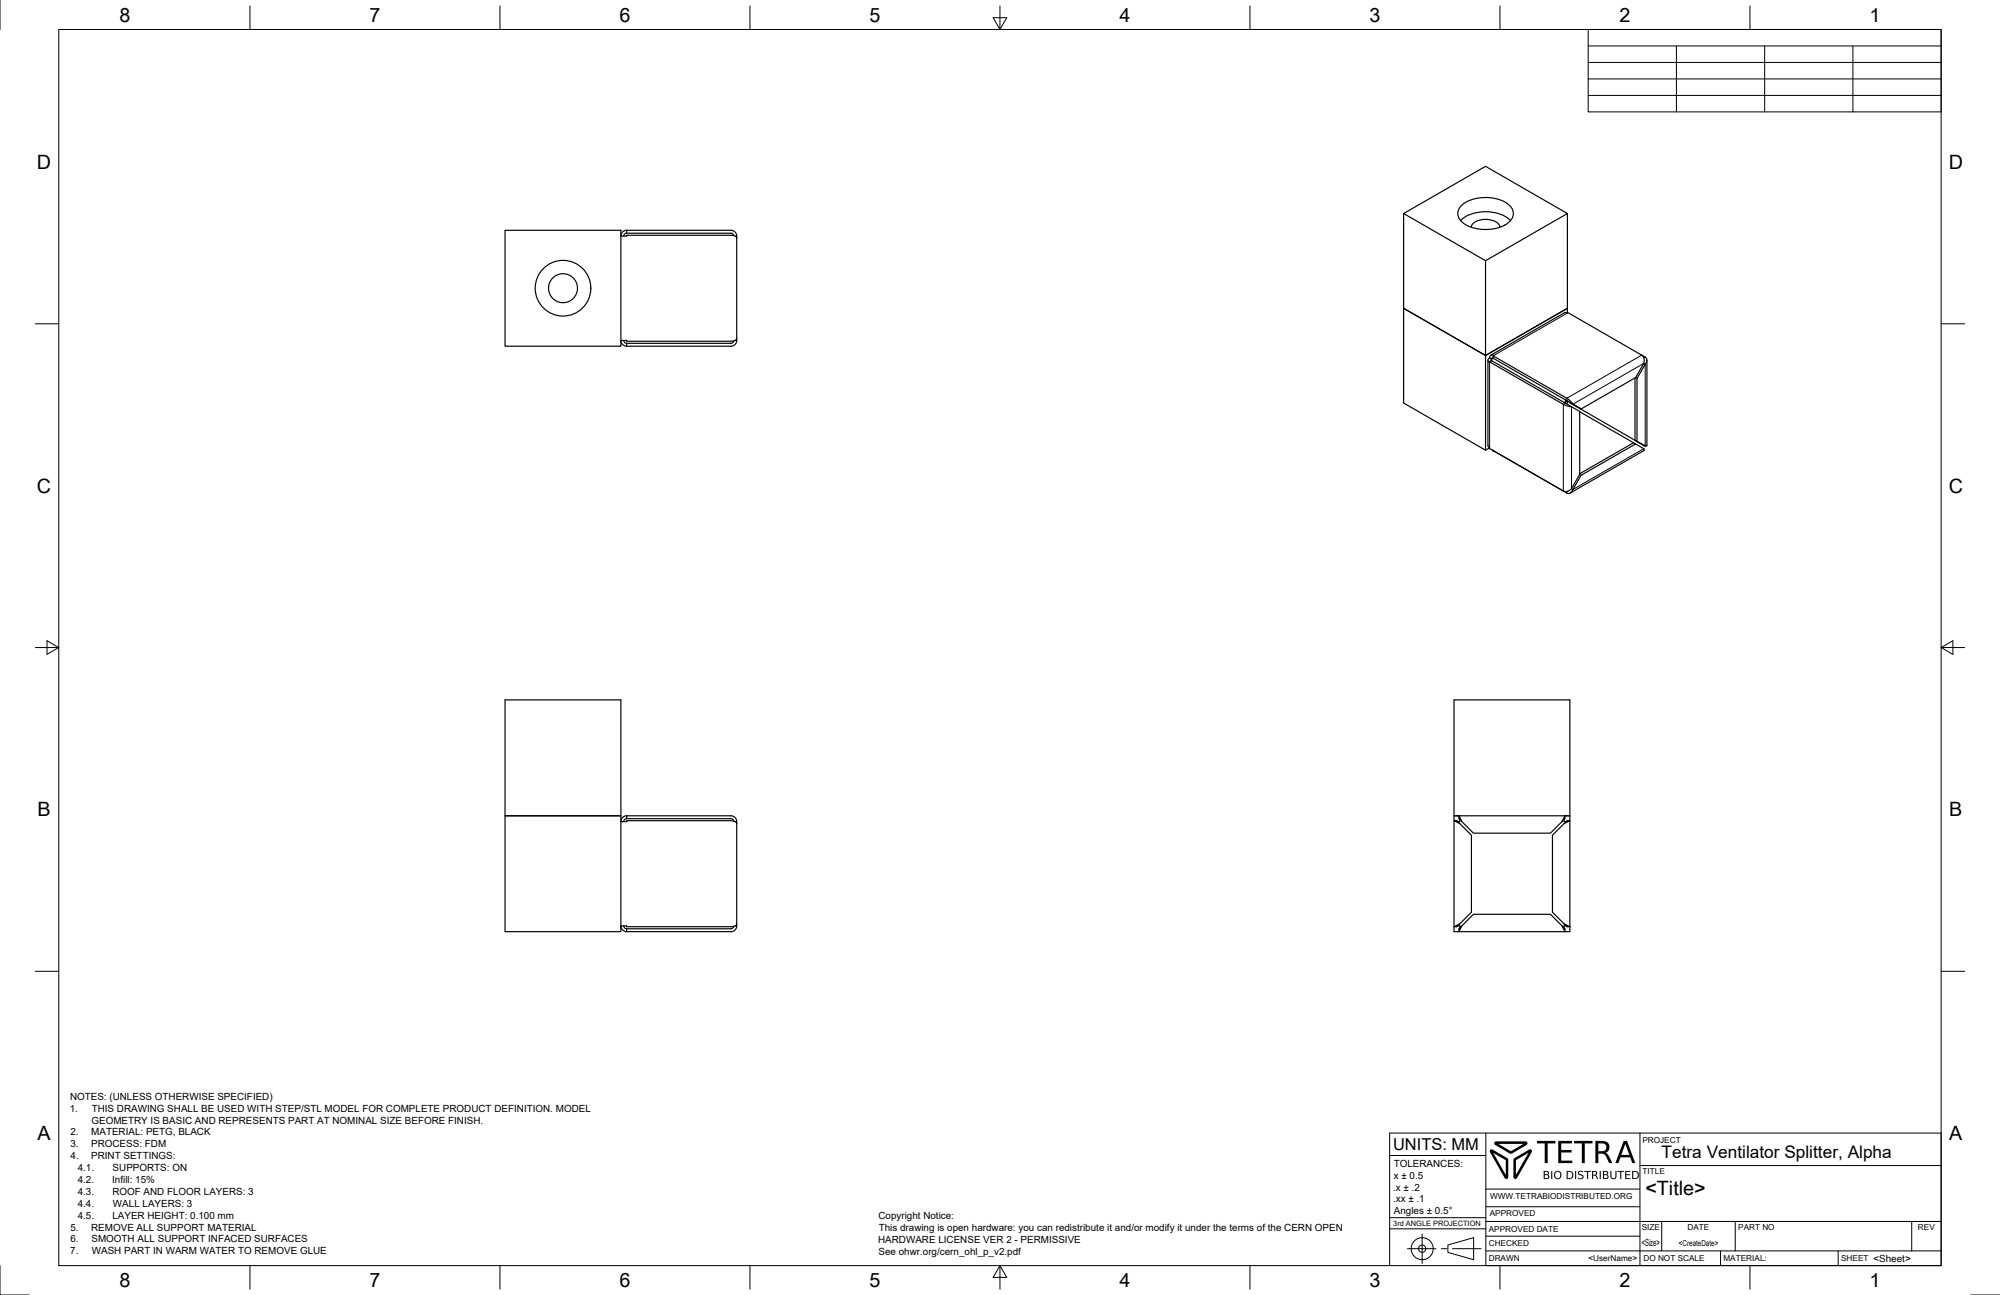
[picture p274: page 1]
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

NOTES: (UNLESS OTHERWISE SPECIFIED)
1. THIS DRAWING SHALL BE USED WITH STEP/STL MODEL FOR COMPLETE PRODUCT DEFINITION. MODEL
GEOMETRY IS BASIC AND REPRESENTS PART AT NOMINAL SIZE BEFORE FINISH.

2. MATERIAL: PETG, BLACK
3. PROCESS: FDM
4. PRINT SETTINGS:
4.1. SUPPORTS: ON
4.2. Infill: 15%
4.3. ROOF AND FLOOR LAYERS: 3
4.4. WALL LAYERS: 3
4.5. LAYER HEIGHT: 0.100 mm
5. REMOVE ALL SUPPORT MATERIAL
6. SMOOTH ALL SUPPORT INFACED SURFACES
7. WASH PART IN WARM WATER TO REMOVE GLUE

PROJECT
Tetra Ventilator Splitter, Alpha

WWW.TETRABIODISTRIBUTED.ORG

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
