tetrabiodistributed/project-tetra/03_Visulisation_and_Handbooks/CAD_drawings/Tetra_drawing_templates/August-2020/PDF/Tetra Drawing Template - Part SLA v2.pdf

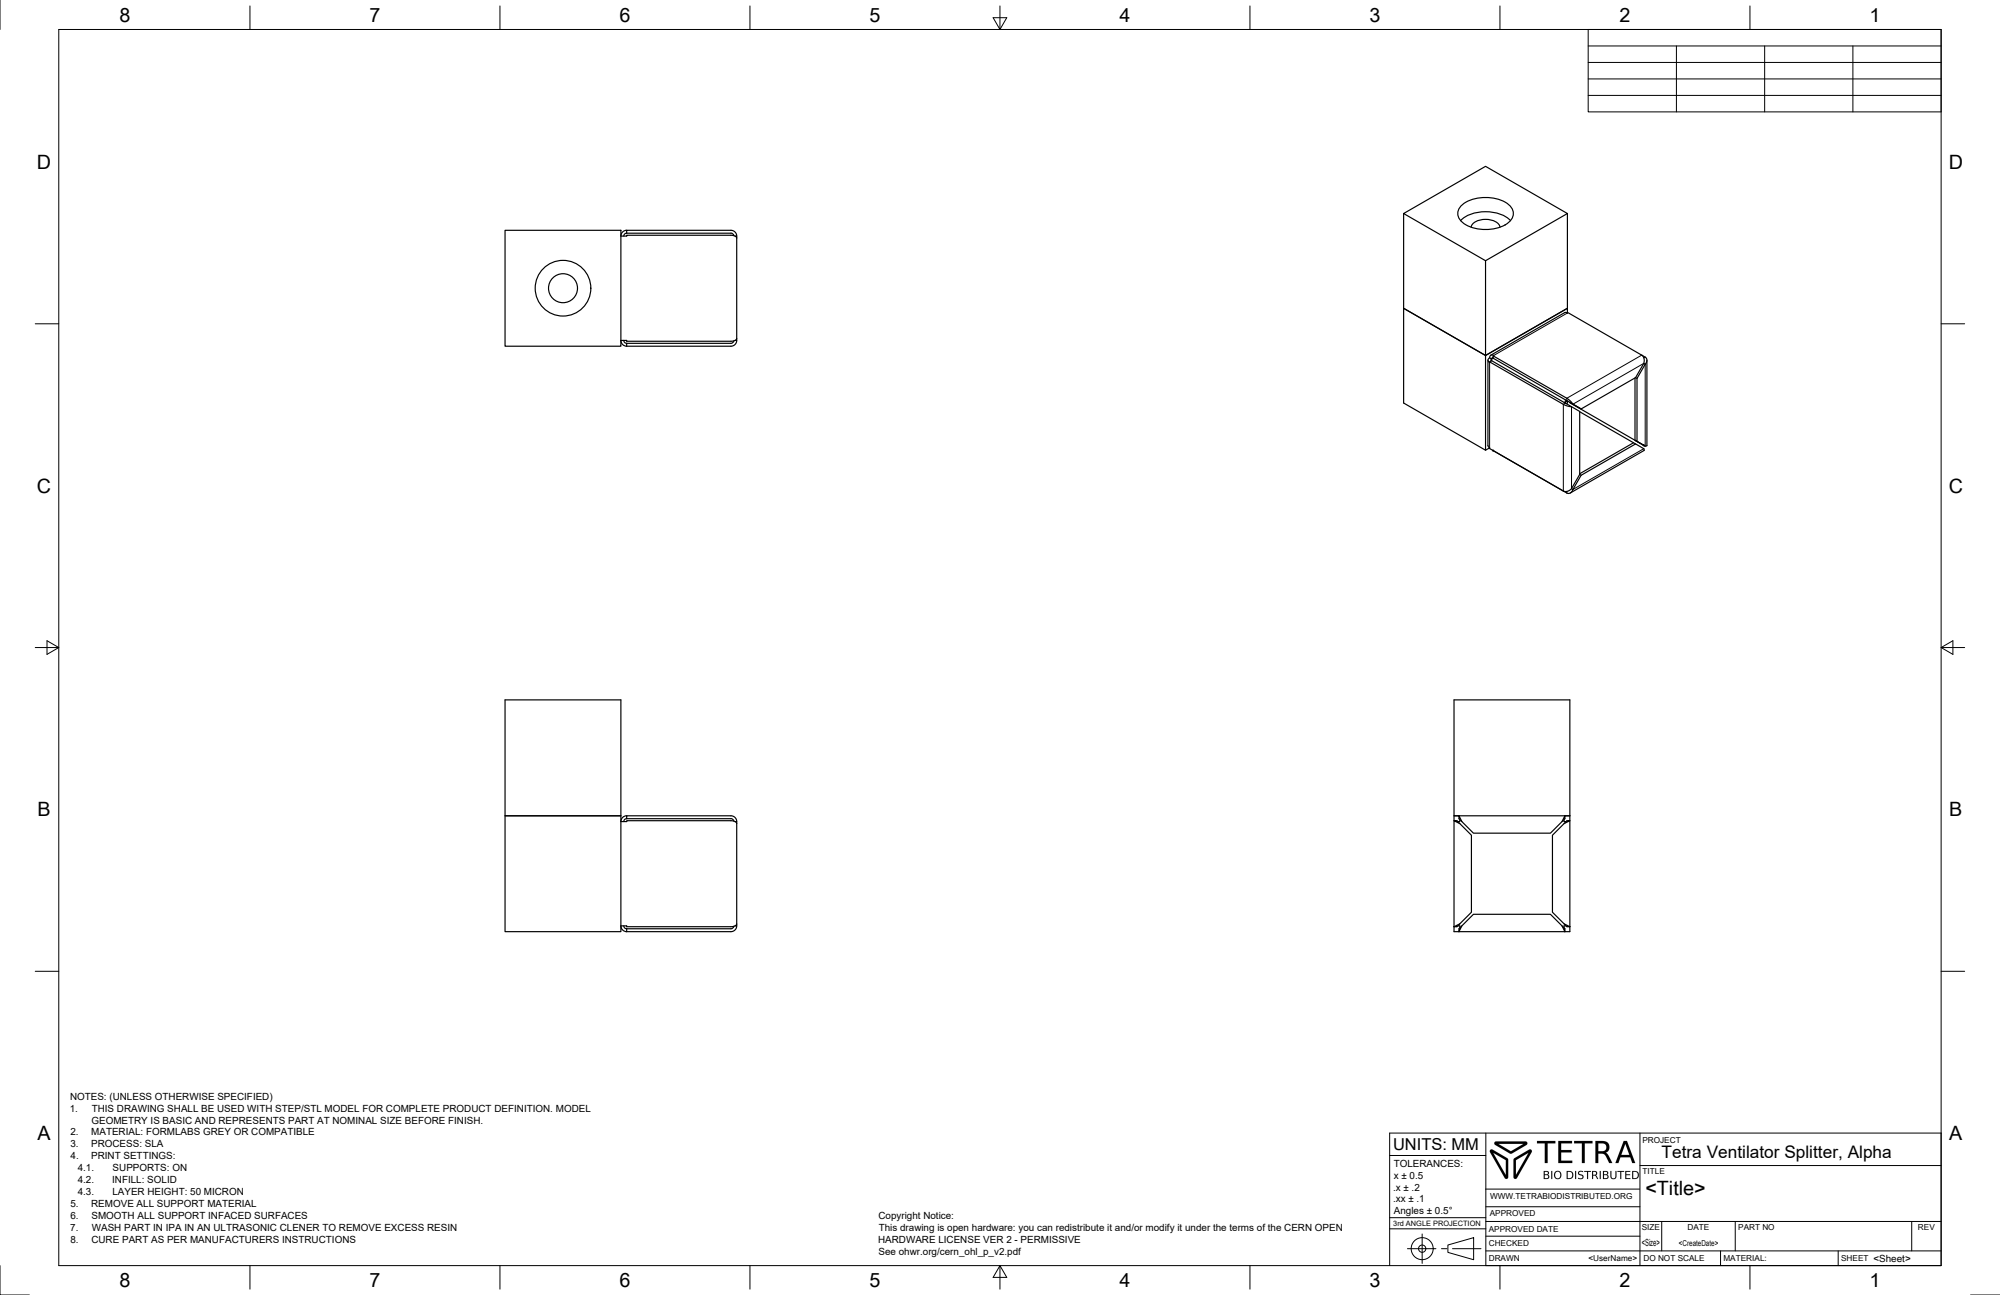
[picture p275: page 1]
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

2. MATERIAL: FORMLABS GREY OR COMPATIBLE
3. PROCESS: SLA
4. PRINT SETTINGS:
4.1. SUPPORTS: ON
4.2. INFILL: SOLID
4.3. LAYER HEIGHT: 50 MICRON
5. REMOVE ALL SUPPORT MATERIAL
6. SMOOTH ALL SUPPORT INFACED SURFACES
7. WASH PART IN IPA IN AN ULTRASONIC CLENER TO REMOVE EXCESS RESIN
8. CURE PART AS PER MANUFACTURERS INSTRUCTIONS

PROJECT
Tetra Ventilator Splitter, Alpha

WWW.TETRABIODISTRIBUTED.ORG

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
