tetrabiodistributed/project-tetra/02_Development/FlowMeter/RPi Board/PCB Design Files/raspberry_pi_v007.pdf

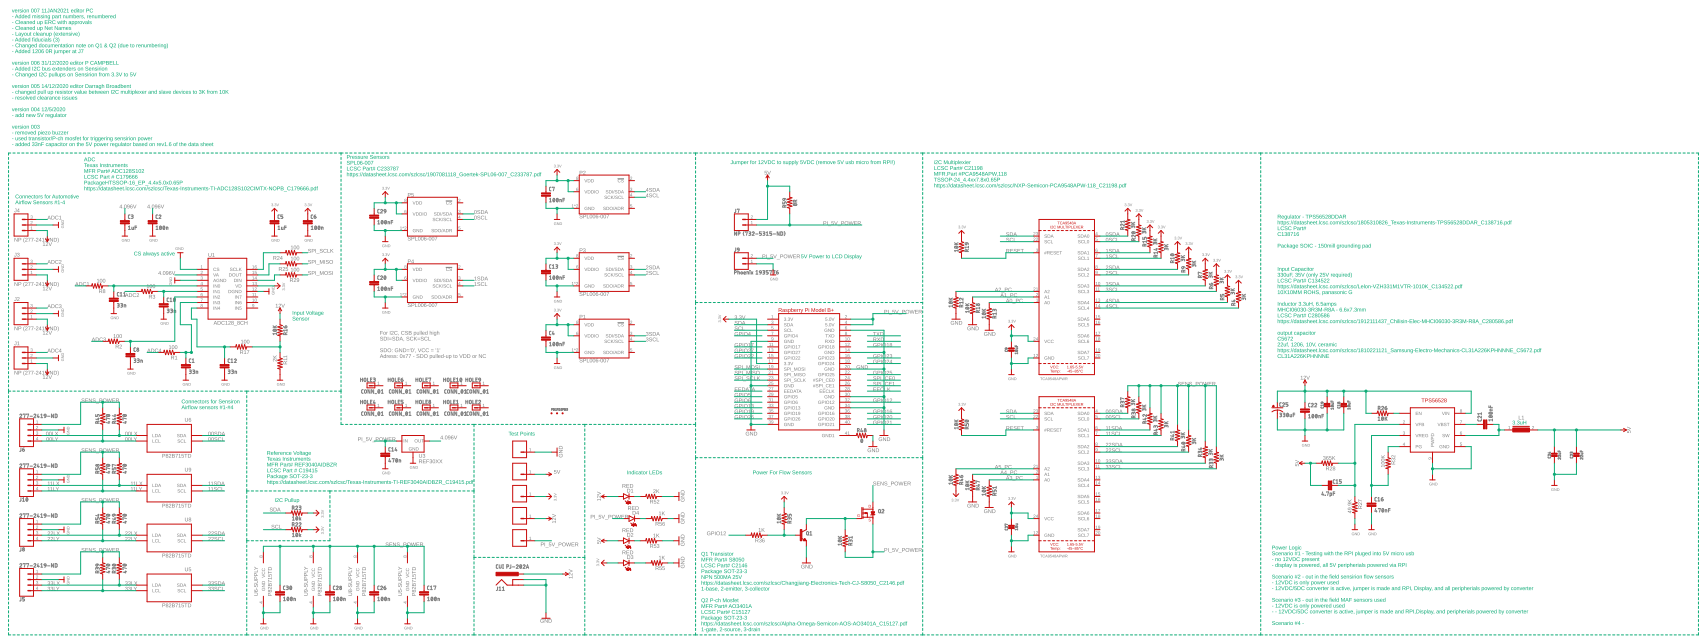
[picture p276: page 1]
