tetrabiodistributed/project-tetra/02_Development/FlowMeter/sensirion_connector_pcb/PCB Design Files/Sensirion_connector_board_v002.pdf

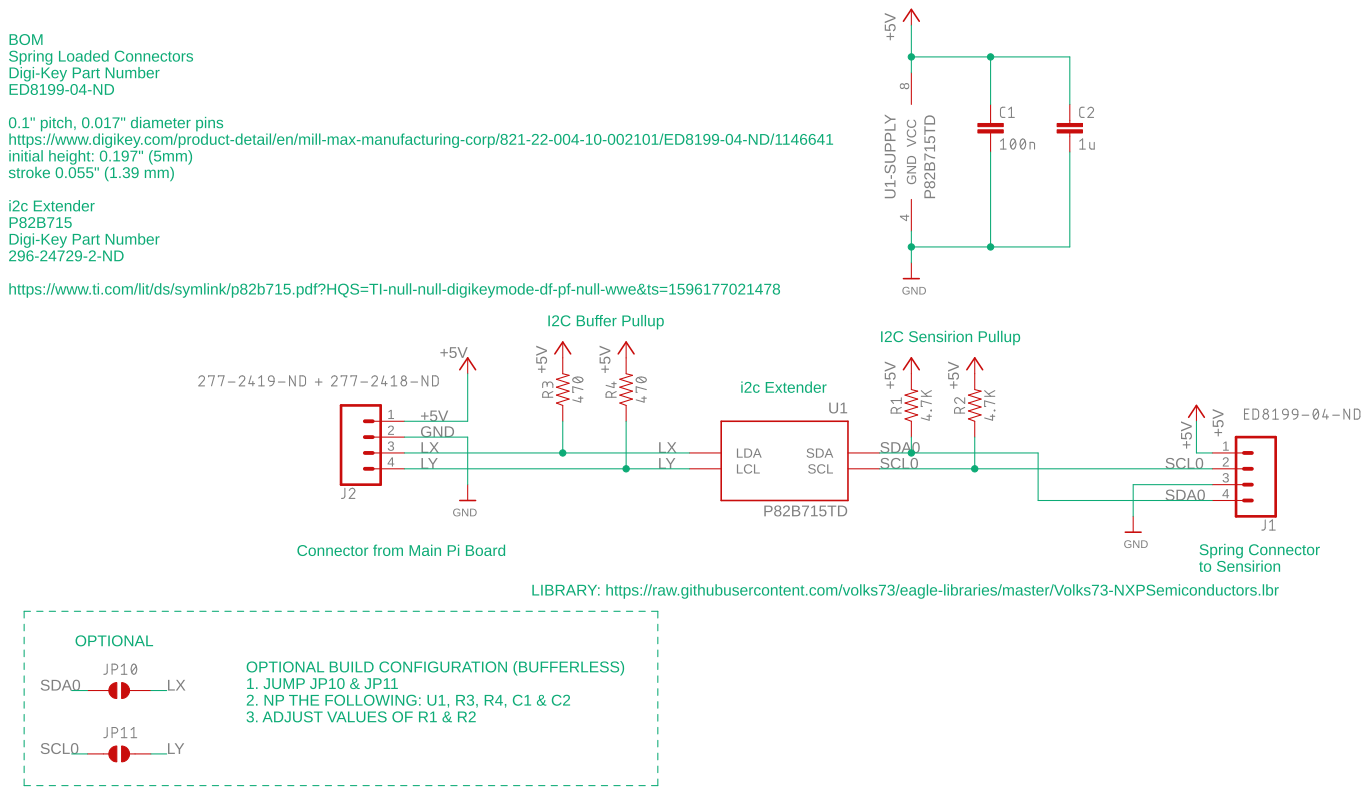
[picture p277: page 1]
