tetrabiodistributed/project-tetra/02_Development/FlowMeter/RPi Board/PCB Design Files/raspberry_pi_v007.brd

## EAGLE design 02_Development/FlowMeter/RPi Board/PCB Design Files/raspberry_pi_v007.brd (2021-01-24)

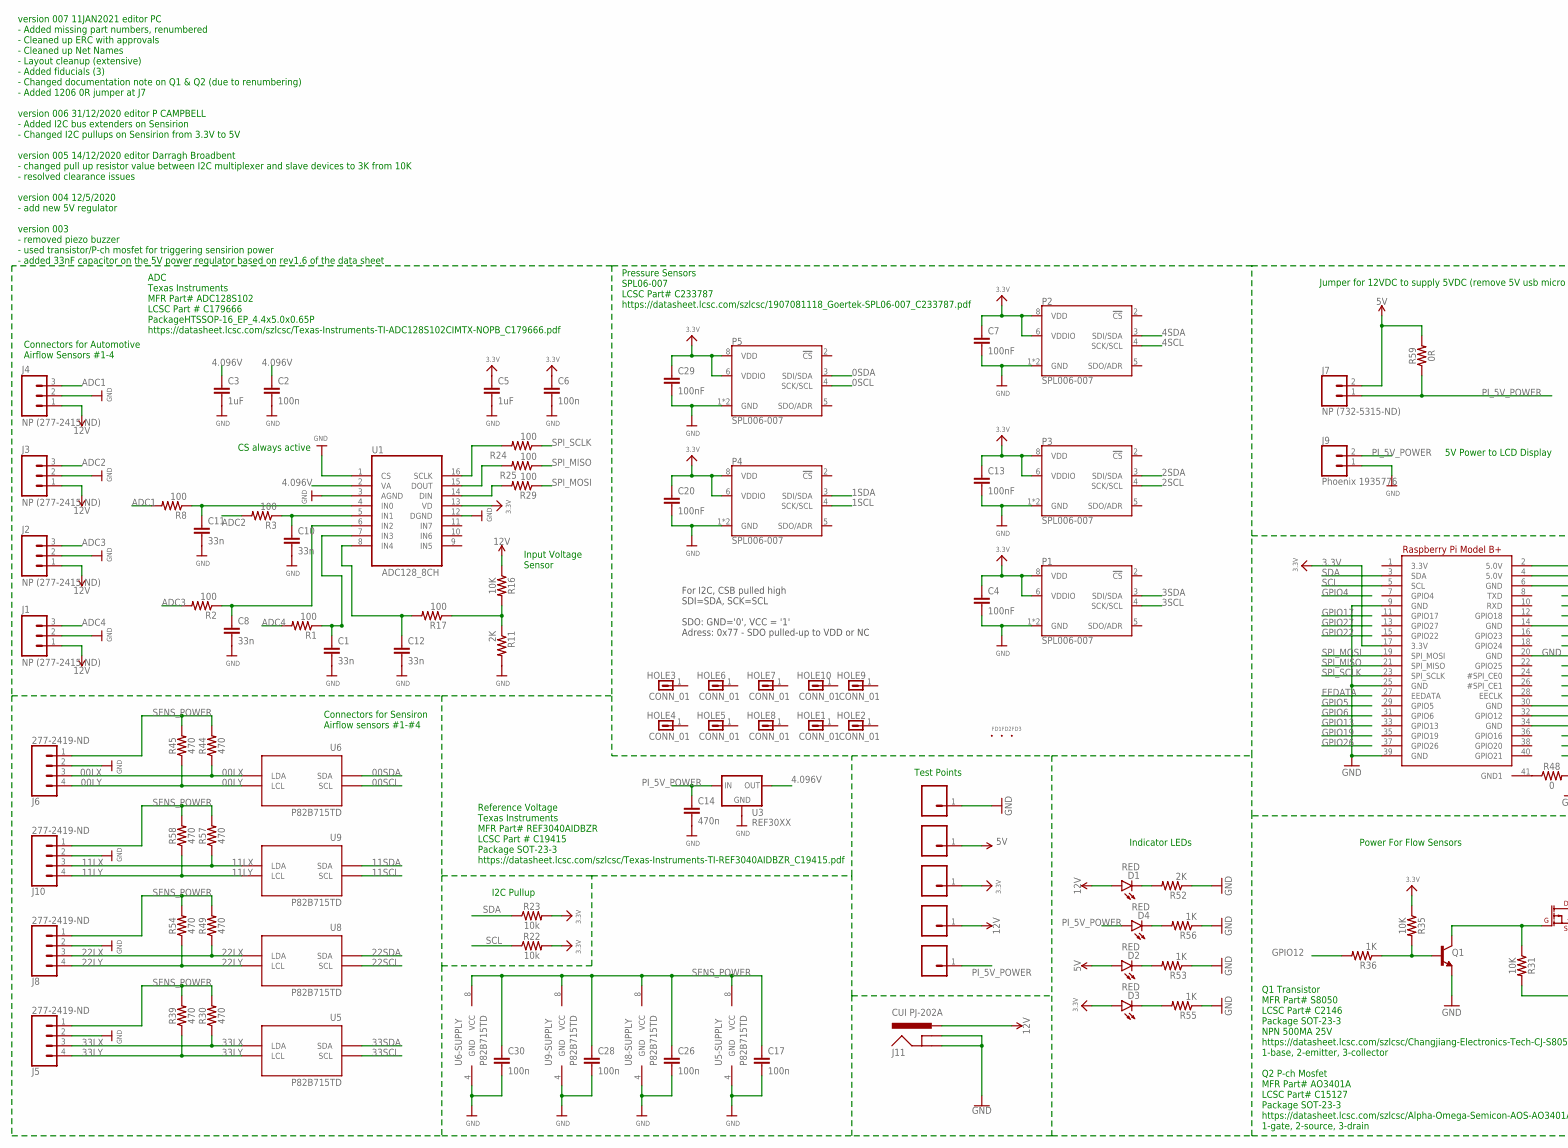
[picture p278: schematic raspberry_pi_v007.sch, part in row 1, column 1]

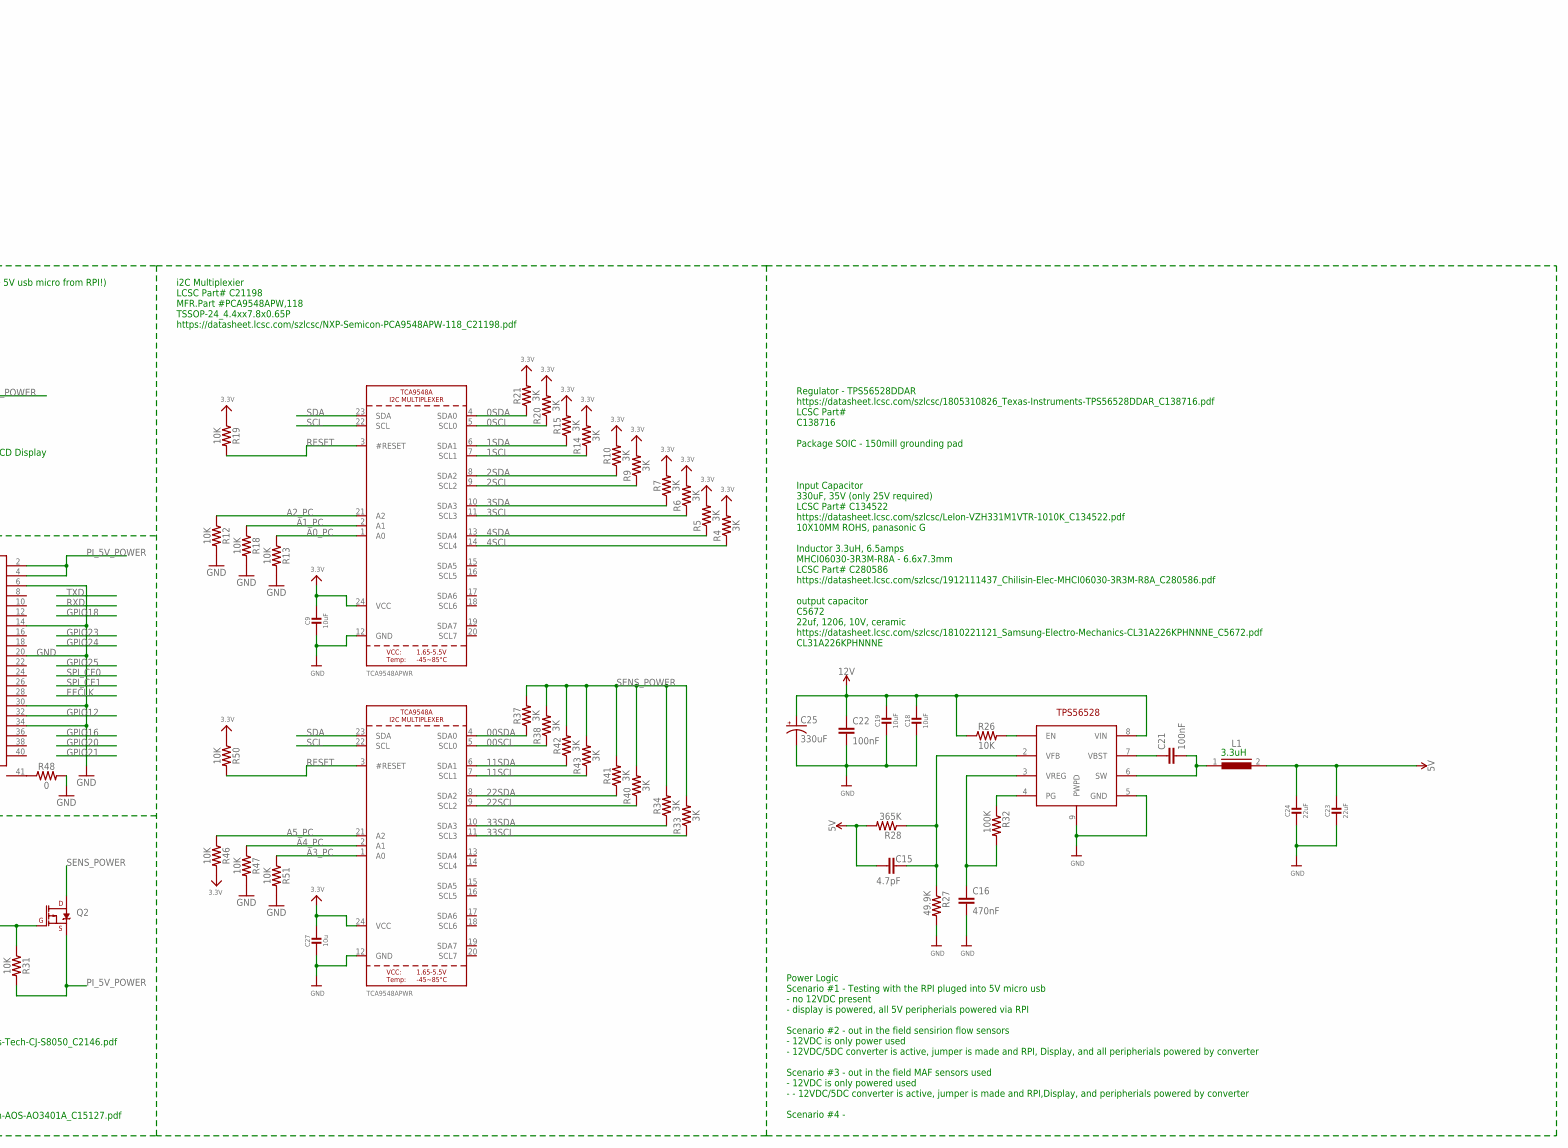
[picture p279: schematic raspberry_pi_v007.sch, part in row 1, column 2]

Parts:
C1, C8, C10, C11, C12: 33n; 0805
C2, C6, C17, C26, C28, C30: 100n; 0805
C3, C5: 1uF; 0805
C4, C7, C13, C20, C21, C22, C29: 100nF; 0805
C9, C18, C19: 10uF; 0805-NO
C14: 470n; 0805
C15: 4.7pF; 0603
C16: 470nF; 0805
C23, C24: 22uF; _1206
C25: 330uF; PANASONIC_G
C27: 10u; 0805-NO
D1, D2, D3, D4: RED; LED-1206
FD1, FD2, FD3: FID_40MIL; FID_040
HOLE1, HOLE2, HOLE3, HOLE4, HOLE5, HOLE6, HOLE7, HOLE8, HOLE9, HOLE10: CONN_01; 1X01-#6_MACHINE
J1, J2, J3, J4: NP (277-2415-ND); SCREWTERMINAL-3.5MM-3
J5, J6, J8, J10: 277-2419-ND; 1X04_3.5MM_RA
J7: NP (732-5315-ND); 1X02
J9: Phoenix 1935776; SCREWTERMINAL-5MM-2
J11: CUI PJ-202A; POWER_JACK_PTH
L1: INDUCTOR_6.6_7.3
P1, P2, P3, P4, P5: SPL006-007; LGA-8-2.5X2.0
Q1: 500mA/300V; SOT23-3
Q2: 4.3A/20V/54mΩ; SOT23-3
R1, R2, R3, R8, R17, R24, R25, R29: 100; 0805
R4, R5, R6, R7, R9, R10, R14, R15, R20, R21, R33, R34, R37, R38, R40, R41, R42, R43: 3K; 0805
R11, R52: 2K; 0805
R12, R13, R16, R18, R19, R26, R31, R35, R46, R47, R50, R51: 10K; 0805
R22, R23: 10k; 0805
R27: 49.9K; 0805
R28: 365K; 0805
R30, R39, R44, R45, R49, R54, R57, R58: 470; 0805
R32: 100K; 0805
R36, R53, R55, R56: 1K; 0805
R48: 0; 0805
R59: 0R; 1206
RPI3B+: MICROBUILDER_RASPBERRYPI_BPLUS_HATSLOTS; MICROBUILDER_PI_HAT_SLOTS
TP1, TP2, TP3, TP4, TP5: CONN_0138MILL; 1X01-40MILL
U1: ADC128_8CH; TSSOP16
U2, U7: TCA9548APWR; TSSOP24
U3: REF30XX; SOT23-3
U4: TPS56528; SOIC8_POWER
U5, U6, U8, U9: P82B715TD; SOIC-8

Connections:
00LX: J6.3, R44.1, U6.7 (LDA)
00LY: J6.4, R45.1, U6.2 (LCL)
0SCL: P5.4 (SCK/SCL), R20.1, U2.5 (SCL0)
00SCL: R38.1, U6.3 (SCL), U7.5 (SCL0)
0SDA: P5.3 (SDI/SDA), R21.1, U2.4 (SDA0)
00SDA: R37.1, U6.6 (SDA), U7.4 (SDA0)
1SCL: P4.4 (SCK/SCL), R14.1, U2.7 (SCL1)
1SDA: P4.3 (SDI/SDA), R15.1, U2.6 (SDA1)
2SCL: P3.4 (SCK/SCL), R9.1, U2.9 (SCL2)
2SDA: P3.3 (SDI/SDA), R10.1, U2.8 (SDA2)
3.3V: C4.1, C5.1, C6.1, C7.1, C9.1, C13.1, C20.1, C27.1, C29.1, D3.A, P1.6 (VDDIO), P1.8 (VDD), P2.6 (VDDIO), P2.8 (VDD), P3.6 (VDDIO), P3.8 (VDD), P4.6 (VDDIO), P4.8 (VDD), P5.6 (VDDIO), P5.8 (VDD), R4.2, R5.2, R6.2, R7.2, R9.2, R10.2, R14.2, R15.2, R19.1, R20.2, R21.2, R22.2, R23.2, R35.1, R46.2, R50.1, RPI3B+.17 (3.3V), TP4.1, U1.13 (VD), U2.24 (VCC), U7.24 (VCC)
3.3V-LED-R: D3.C, R55.2
3SCL: P1.4 (SCK/SCL), R6.1, U2.11 (SCL3)
3SDA: P1.3 (SDI/SDA), R7.1, U2.10 (SDA3)
4.096V: C2.1, C3.1, U1.2 (VA), U3.2 (OUT)
4SCL: P2.4 (SCK/SCL), R4.1, U2.14 (SCL4)
4SDA: P2.3 (SDI/SDA), R5.1, U2.13 (SDA4)
5V: C15.1, C23.1, C24.1, D2.A, J7.2, L1.2, R28.2, R59.2, TP2.1
5V-LED-R: D2.C, R53.2
5VREG-EN: R26.2, U4.1 (EN)
5VREG-PG: R32.1, U4.4 (PG)
5VREG-SW: C21.2, L1.1, U4.6 (SW)
5VREG-VBST: C21.1, U4.7 (VBST)
5VREG-VFB: C15.2, R27.1, R28.1, U4.2 (VFB)
5VREG-VREG: C16.1, R32.2, U4.3 (VREG)
11LX: J10.3, R57.1, U9.7 (LDA)
11LY: J10.4, R58.1, U9.2 (LCL)
11SCL: R43.1, U7.7 (SCL1), U9.3 (SCL)
11SDA: R42.1, U7.6 (SDA1), U9.6 (SDA)
12V: C18.1, C19.1, C22.1, C25.+, D1.A, J1.1, J2.1, J3.1, J4.1, J11.PWR, R16.1, R26.1, TP1.1, U4.8 (VIN)
12V-LED-R: D1.C, R52.2
22LX: J8.3, R49.1, U8.7 (LDA)
22LY: J8.4, R54.1, U8.2 (LCL)
22SCL: R40.1, U7.9 (SCL2), U8.3 (SCL)
22SDA: R41.1, U7.8 (SDA2), U8.6 (SDA)
33LX: J5.3, R30.1, U5.7 (LDA)
33LY: J5.4, R39.1, U5.2 (LCL)
33SCL: R33.1, U5.3 (SCL), U7.11 (SCL3)
33SDA: R34.1, U5.6 (SDA), U7.10 (SDA3)
A0_PC: R13.1, U2.1 (A0)
A1_PC: R18.1, U2.2 (A1)
A2_PC: R12.1, U2.21 (A2)
A3_PC: R51.1, U7.1 (A0)
A4_PC: R47.1, U7.2 (A1)
A5_PC: R46.1, U7.21 (A2)
ADC1: J4.3, R8.2
ADC2: J3.3, R3.2
ADC3: J2.3, R2.2
ADC4: J1.3, R1.2
ADC-12V-SENSE: R11.1, R16.2, R17.1
ADC-DIN: R29.2, U1.14 (DIN)
ADC-DOUT: R25.2, U1.15 (DOUT)
ADC-IN0: C11.1, R8.1, U1.4 (IN0)
ADC-IN1: C10.1, R3.1, U1.5 (IN1)
ADC-IN2: C8.1, R2.1, U1.6 (IN2)
ADC-IN3: C1.1, R1.1, U1.7 (IN3)
ADC-IN4: C12.1, R17.2, U1.8 (IN4)
ADC-SCLK: R24.2, U1.16 (SCLK)
GND: C1.2, C2.2, C3.2, C4.2, C5.2, C6.2, C7.2, C8.2, C9.2, C10.2, C11.2, C12.2, C13.2, C14.2, C16.2, C17.2, C18.2, C19.2, C20.2, C22.2, C23.2, C24.2, C25.-, C26.2, C27.2, C28.2, C29.2, C30.2, J1.2, J2.2, J3.2, J4.2, J5.2, J6.2, J8.2, J9.1, J10.2, J11.GND, J11.GNDBREAK, P1.1 (GND), P1.7 (GND), P2.1 (GND), P2.7 (GND), P3.1 (GND), P3.7 (GND), P4.1 (GND), P4.7 (GND), P5.1 (GND), P5.7 (GND), Q1.2 (E), R11.2, R12.2, R13.2, R18.2, R27.2, R47.2, R48.2, R51.2, R52.1, R53.1, R55.1, R56.1, RPI3B+.6 (GND), RPI3B+.9 (GND), RPI3B+.14 (GND), RPI3B+.20 (GND), RPI3B+.25 (GND), RPI3B+.30 (GND), RPI3B+.34 (GND), RPI3B+.39 (GND), TP3.1, U1.1 (CS), U1.3 (AGND), U1.12 (DGND), U2.12 (GND), U3.3 (GND), U4.5 (GND), U4.9 (PWPD), U5.4 (GND), U6.4 (GND), U7.12 (GND), U8.4 (GND), U9.4 (GND)
GND1: R48.1, RPI3B+.41 (GND1)
GPIO12: R36.2, RPI3B+.32 (GPIO12)
PI5V-LED-R: D4.C, R56.2
PI_5V_POWER: C14.1, D4.A, J7.1, J9.2, Q2.2 (S), R31.2, R59.1, RPI3B+.2 (5.0V), RPI3B+.4 (5.0V), TP5.1, U3.1 (IN)
RESET: R19.2, R50.2, U2.3 (#RESET), U7.3 (#RESET)
SCL: R22.1, RPI3B+.5 (SCL), U2.22 (SCL), U7.22 (SCL)
SDA: R23.1, RPI3B+.3 (SDA), U2.23 (SDA), U7.23 (SDA)
SENS_POWER: C17.1, C26.1, C28.1, C30.1, J5.1, J6.1, J8.1, J10.1, Q2.3 (D), R30.2, R33.2, R34.2, R37.2, R38.2, R39.2, R40.2, R41.2, R42.2, R43.2, R44.2, R45.2, R49.2, R54.2, R57.2, R58.2, U5.8 (VCC), U6.8 (VCC), U8.8 (VCC), U9.8 (VCC)
SENS_POWER_BASE: Q1.1 (B), R35.2, R36.1
SENS_POWER_GATE: Q1.3 (C), Q2.1 (G), R31.1
SPI_MISO: R25.1, RPI3B+.21 (SPI_MISO)
SPI_MOSI: R29.1, RPI3B+.19 (SPI_MOSI)
SPI_SCLK: R24.1, RPI3B+.23 (SPI_SCLK)

Notes on the sheet:
I2C Pullup
Test Points
Indicator LEDs
Power For Flow Sensors
For I2C, CSB pulled high SDI=SDA, SCK=SCL SDO: GND='0', VCC = '1' Adress: 0x77 - SDO pulled-up to VDD or NC
Connectors for Automotive Airflow Sensors #1-4
Pressure Sensors SPL06-007 LCSC Part# C233787 https://datasheet.lcsc.com/szlcsc/1907081118_Goertek-SPL06-007_C233787.pdf
Connectors for Sensiron Airflow sensors #1-#4
CS always active
Regulator - TPS56528DDAR https://datasheet.lcsc.com/szlcsc/1805310826_Texas-Instruments-TPS56528DDAR_C138716.pdf LCSC Part# C138716 Package SOIC - 150mill grounding pad Input Capacitor 330uF, 35V (only 25V required) LCSC Part# C134522 https://datasheet.lcsc.com/szlcsc/Lelon-VZH331M1VTR-1010K_C13452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
i2C Multiplexier LCSC Part# C21198 MFR.Part #PCA9548APW,118 TSSOP-24_4.4xx7.8x0.65P https://datasheet.lcsc.com/szlcsc/NXP-Semicon-PCA9548APW-118_C21198.pdf
ADC Texas Instruments MFR Part# ADC128S102 LCSC Part # C179666 PackageHTSSOP-16_EP_4.4x5.0x0.65P https://datasheet.lcsc.com/szlcsc/Texas-Instruments-TI-ADC128S102CIMTX-NOPB_C179666.pdf
Reference Voltage Texas Instruments MFR Part# REF3040AIDBZR LCSC Part # C19415 Package SOT-23-3 https://datasheet.lcsc.com/szlcsc/Texas-Instruments-TI-REF3040AIDBZR_C19415.pdf
Q1 Transistor MFR Part# S8050 LCSC Part# C2146 Package SOT-23-3 NPN 500MA 25V https://datasheet.lcsc.com/szlcsc/Changjiang-Electronics-Tech-CJ-S8050_C2146.pdf 1-base, 2-emitter, 3-collector Q2 P-ch Mosfet MFR Part# AO3401A LCSC Part# C15127 Package SOT-23-3 https://datasheet.lcsc.com/szlcsc/Alpha-O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
Input Voltage Sensor
Jumper for 12VDC to supply 5VDC (remove 5V usb micro from RPI!)
5V Power to LCD Display
Power Logic Scenario #1 - Testing with the RPI pluged into 5V micro usb - no 12VDC present - display is powered, all 5V peripherials powered via RPI Scenario #2 - out in the field sensirion flow sensors - 12VDC is only power used - 12VDC/5DC converter is active, jumper is made and RPI, Display, and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
version 007 11JAN2021 editor PC - Added missing part numbers, renumbered - Cleaned up ERC with approvals - Cleaned up Net Names - Layout cleanup (extensive) - Added fiducials (3) - Changed documentation note on Q1 & Q2 (due to renumbering) - Added 1206 0R jumper at J7 version 006 31/12/2020 editor 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
3.3uH

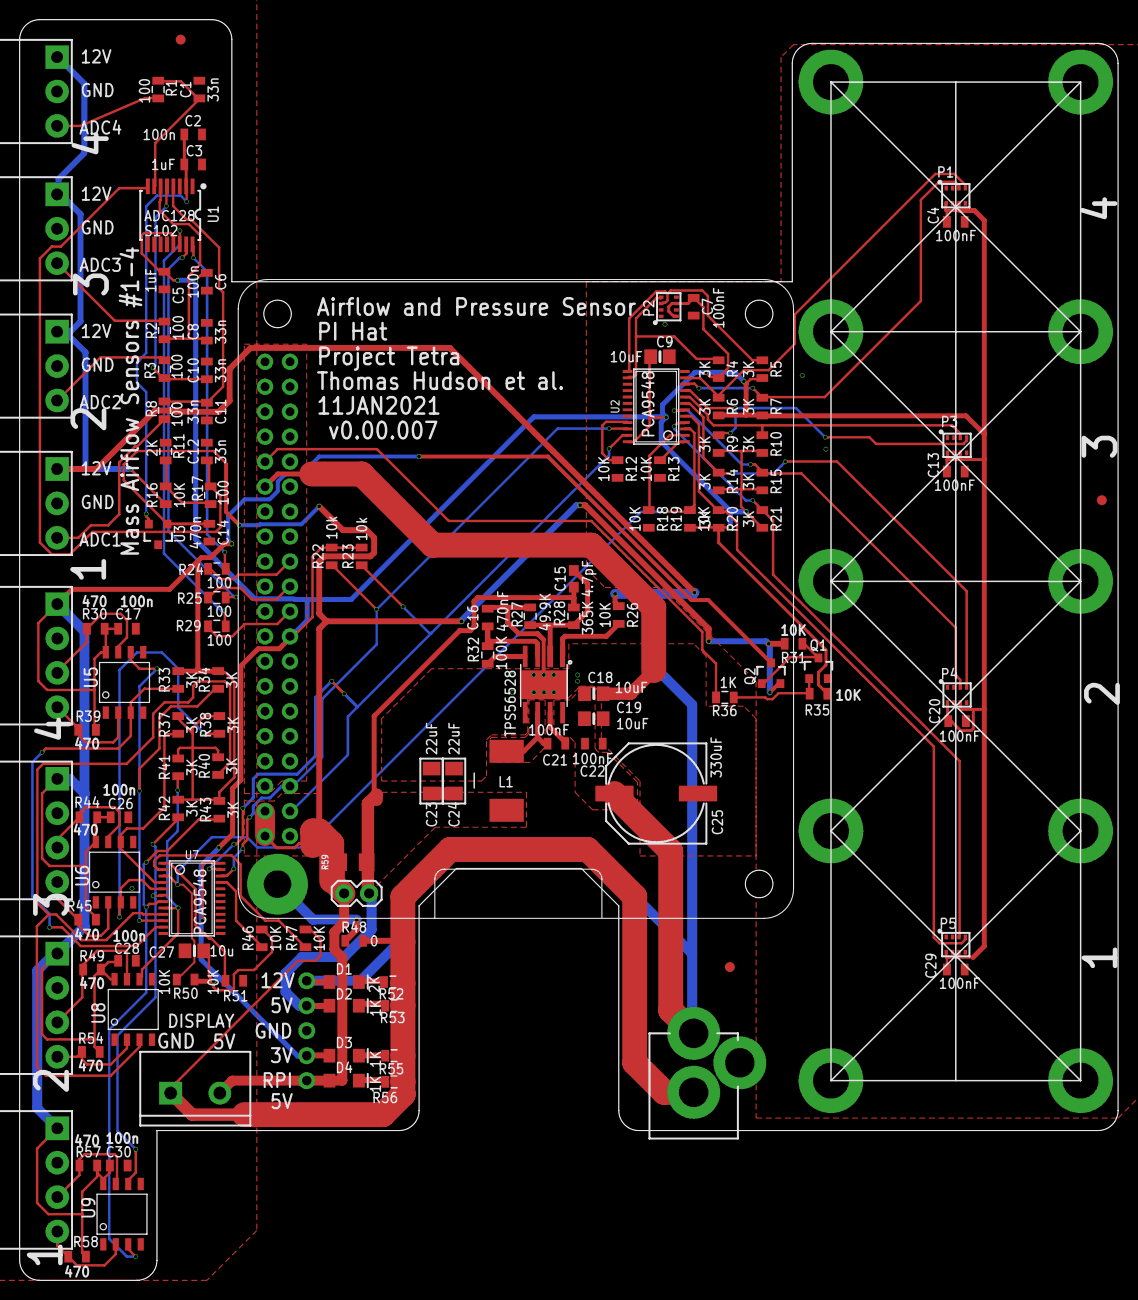
[picture p280: board raspberry_pi_v007.brd from above]

Board: 2 copper layers, 111.8 x 128.3 mm, 140 parts (0 on the bottom side), 72 nets.
