tetrabiodistributed/project-tetra/02_Development/FlowMeter/sensirion_connector_pcb/PCB Design Files/Sensirion_connector_board_v002.brd

## EAGLE design 02_Development/FlowMeter/sensirion_connector_pcb/PCB Design Files/Sensirion_connector_board_v002.brd (2021-01-24)

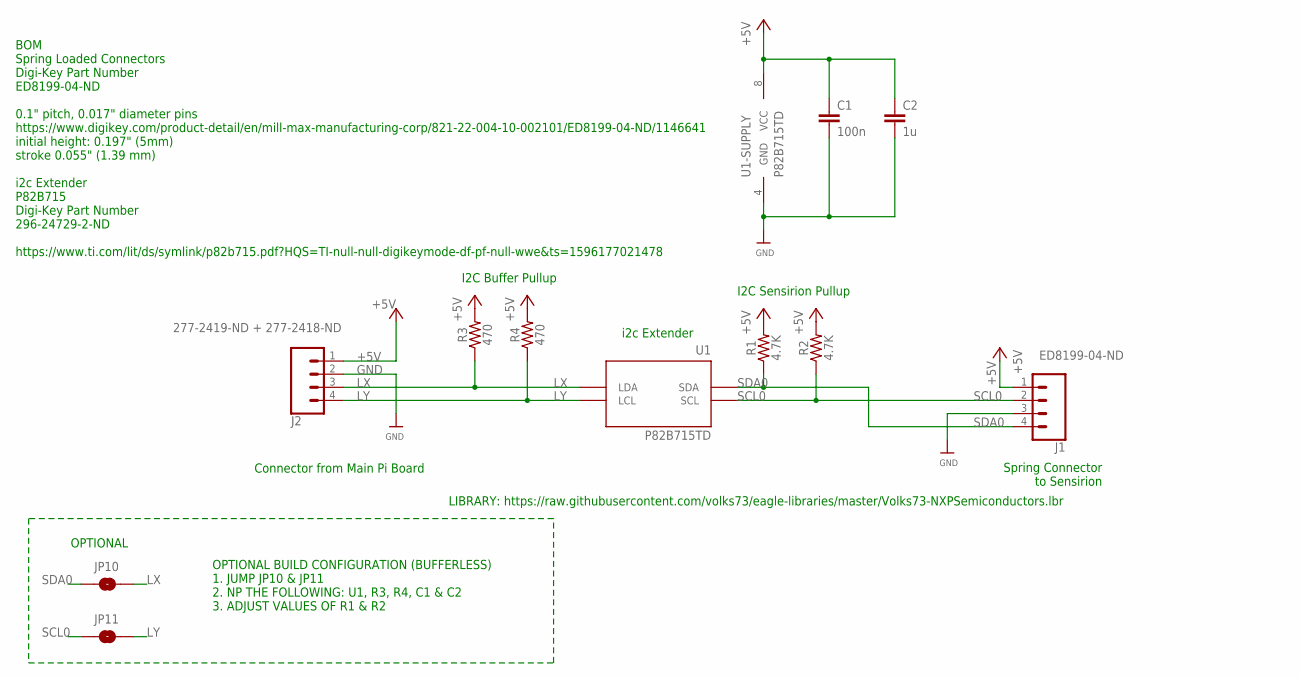
[picture p281: schematic Sensirion_connector_board_v002.sch]

Parts:
C1: 100n; 0805
C2: 1u; 0805
J1: ED8199-04-ND; 1X04_30MILL_DIA
J2: 277-2419-ND + 277-2418-ND; 1X04_3.5MM_RA
JP10, JP11: JUMPER-SMT_2_NO_SILK; SMT-JUMPER_2_NO_SILK
R1, R2: 4.7K; 0805
R3, R4: 470; 0805
U1: P82B715TD; SOIC-8

Connections:
+5V: C1.1, C2.1, J1.1, J2.1, R1.2, R2.2, R3.2, R4.2, U1.8 (VCC)
GND: C1.2, C2.2, J1.3, J2.2, U1.4 (GND)
LX: J2.3, JP10.2, R3.1, U1.7 (LDA)
LY: J2.4, JP11.2, R4.1, U1.2 (LCL)
SCL0: J1.2, JP11.1, R2.1, U1.3 (SCL)
SDA0: J1.4, JP10.1, R1.1, U1.6 (SDA)

Notes on the sheet:
Connector from Main Pi Board
BOM Spring Loaded Connectors Digi-Key Part Number ED8199-04-ND 0.1" pitch, 0.017" diameter pins https://www.digikey.com/product-detail/en/mill-max-manufacturing-corp/821-22-004-10-002101/ED8199-04-ND/1146641 initial height: 0.197" (5mm) stroke 0.055" (1.39 mm) i2c Extender P82B715 Digi-Key Part Num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
Spring Connector to Sensirion
OPTIONAL
i2c Extender
I2C Buffer Pullup
I2C Sensirion Pullup
OPTIONAL BUILD CONFIGURATION (BUFFERLESS) 1. JUMP JP10 & JP11 2. NP THE FOLLOWING: U1, R3, R4, C1 & C2 3. ADJUST VALUES OF R1 & R2
LIBRARY: https://raw.githubusercontent.com/volks73/eagle-libraries/master/Volks73-NXPSemiconductors.lbr

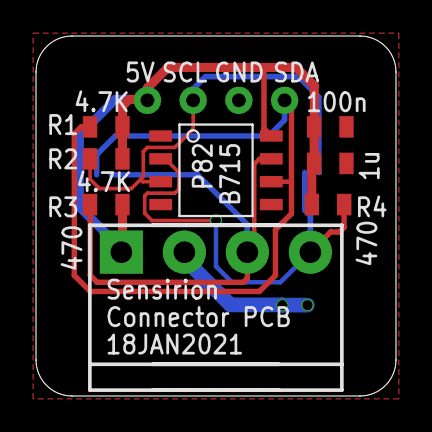
[picture p282: board Sensirion_connector_board_v002.brd from above]

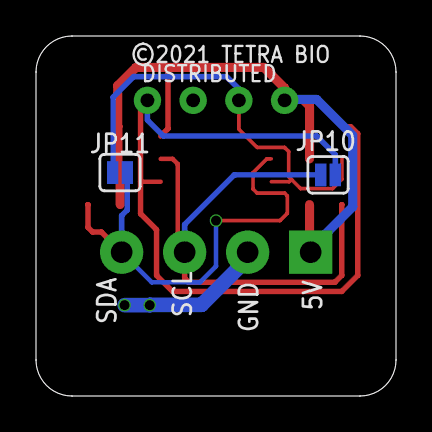
[picture p283: board Sensirion_connector_board_v002.brd from below]

Board: 2 copper layers, 20.0 x 20.0 mm, 11 parts (2 on the bottom side), 6 nets.
