tetrabiodistributed/project-tetra/02_Development/FlowMeter/RPi Board/PCB Design Files/raspberry_pi_v003.brd

## EAGLE design 02_Development/FlowMeter/RPi Board/PCB Design Files/raspberry_pi_v003.brd (2020-10-13, an earlier design)

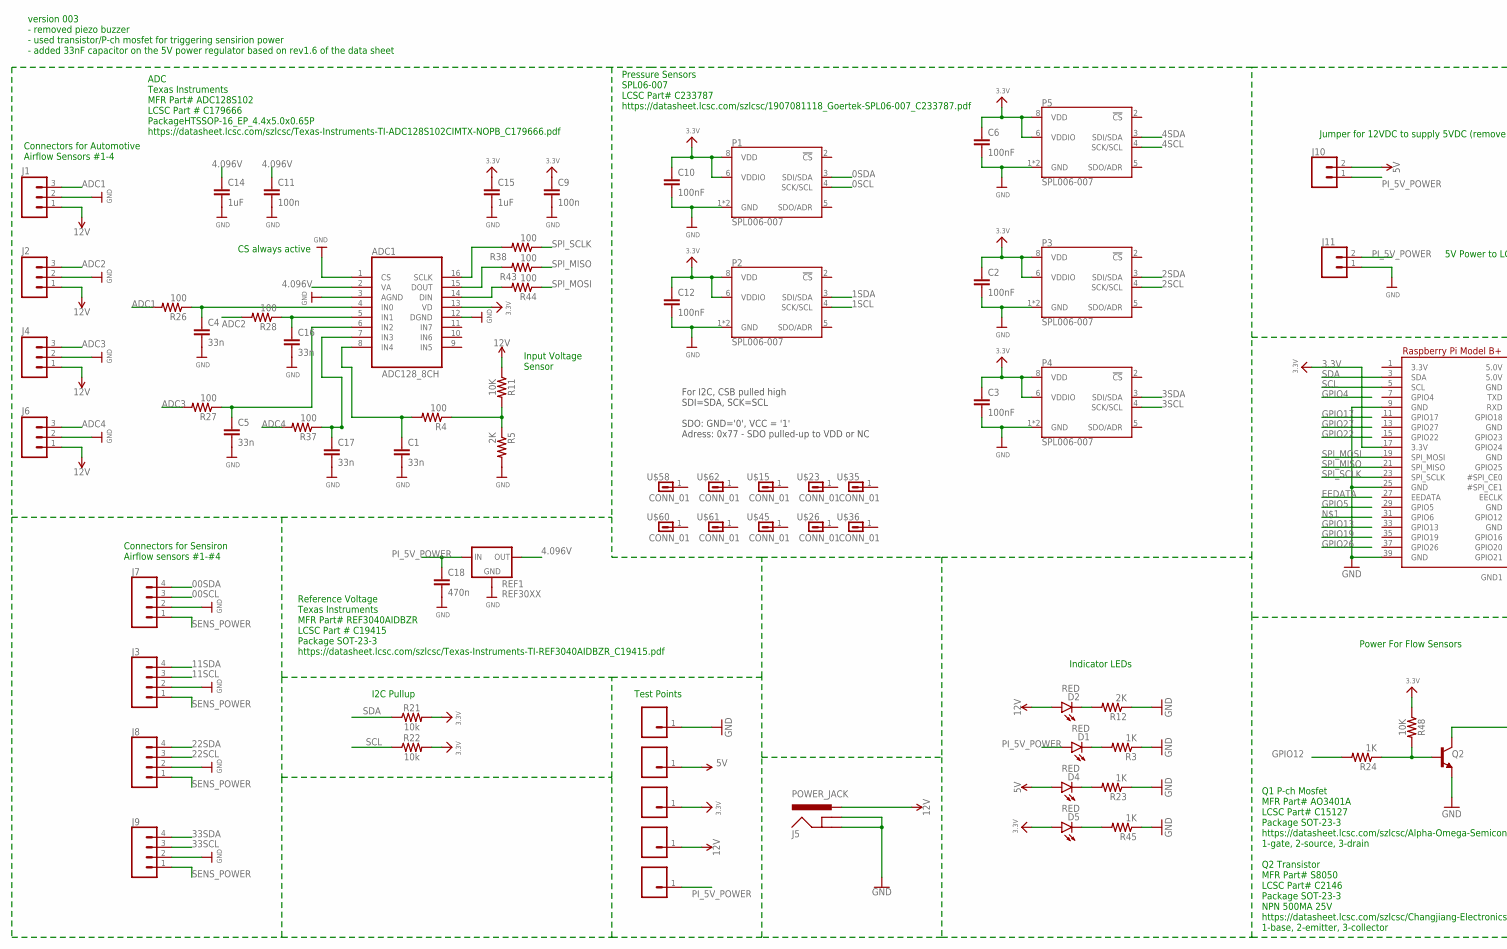
[picture p284: schematic raspberry_pi_v003.sch, part in row 1, column 1]

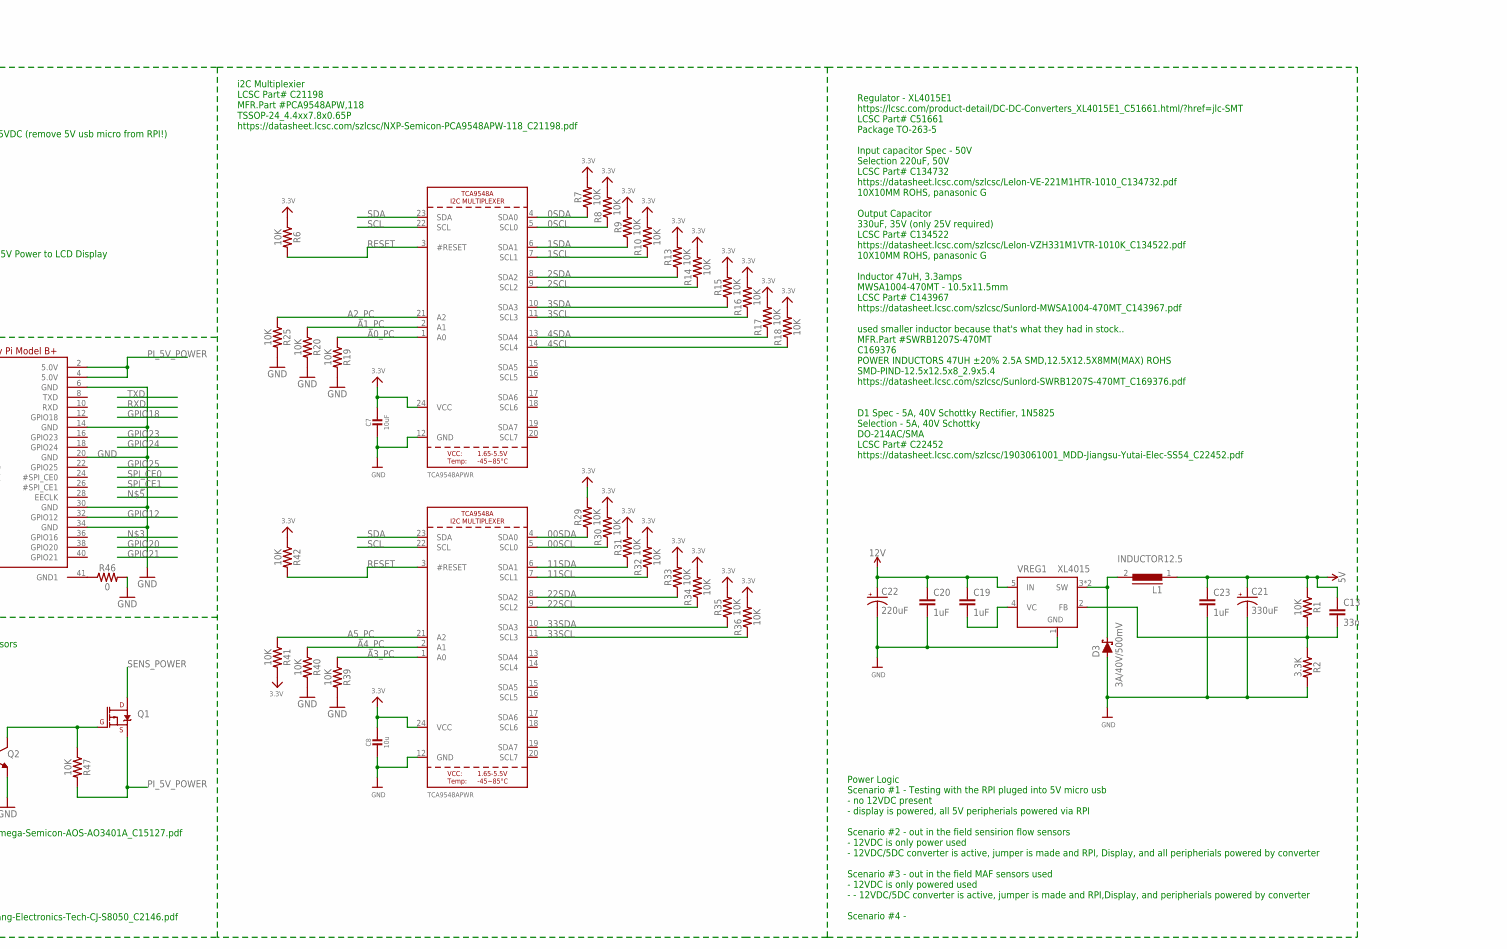
[picture p285: schematic raspberry_pi_v003.sch, part in row 1, column 2]

Parts:
ADC1: ADC128_8CH; TSSOP16
C1, C4, C5, C13, C16, C17: 33n; 0805
C2, C3, C6, C10, C12: 100nF; 0805
C7: 10uF; 0805-NO
C8: 10u; 0805-NO
C9, C11: 100n; 0805
C14, C15, C19, C20, C23: 1uF; 0805
C18: 470n; 0805
C21: 330uF; PANASONIC_G
C22: 220uF; PANASONIC_G
D1, D2, D4, D5: RED; LED-1206
D3: 3A/40V/500mV; SMA-DIODE
J1, J2, J4, J6: M03SCREW; SCREWTERMINAL-3.5MM-3
J3, J7, J8, J9: CONN_043.5MM_RA; 1X04_3.5MM_RA
J5: POWER_JACK; POWER_JACK_PTH
J10: CONN_02; 1X02
J11: CONN_025MM; SCREWTERMINAL-5MM-2
L1: INDUCTOR12.5; INDUCTOR_12.5X12.5
P1, P2, P3, P4, P5: SPL006-007; LGA-8-2.5X2.0
Q1: 4.3A/20V/54mΩ; SOT23-3
Q2: 500mA/300V; SOT23-3
R1, R6, R7, R8, R9, R10, R11, R13, R14, R15, R16, R17, R18, R19, R20, R25, R29, R30, R31, R32, R33, R34, R35, R36, R39, R40, R41, R42, R47, R48: 10K; 0805
R2: 3.3K; 0805
R3, R23, R24, R45: 1K; 0805
R4, R26, R27, R28, R37, R38, R43, R44: 100; 0805
R5, R12: 2K; 0805
R21, R22: 10k; 0805
R46: 0; 0805
REF1: REF30XX; SOT23-3
RPI2: MICROBUILDER_RASPBERRYPI_BPLUS_HATSLOTS; MICROBUILDER_PI_HAT_SLOTS
U6, U7: TCA9548APWR; TSSOP24
U$15, U$23, U$26, U$35, U$36, U$45, U$58, U$60, U$61, U$62: CONN_01; 1X01-#6_MACHINE
U$20, U$31, U$40, U$59, U$64: CONN_0138MILL; 1X01-40MILL
VREG1: XL4015; TO263-5

Connections:
0SCL: P1.4 (SCK/SCL), R8.1, U6.5 (SCL0)
00SCL: J7.3, R30.1, U7.5 (SCL0)
0SDA: P1.3 (SDI/SDA), R7.1, U6.4 (SDA0)
00SDA: J7.4, R29.1, U7.4 (SDA0)
1SCL: P2.4 (SCK/SCL), R10.1, U6.7 (SCL1)
1SDA: P2.3 (SDI/SDA), R9.1, U6.6 (SDA1)
2SCL: P3.4 (SCK/SCL), R14.1, U6.9 (SCL2)
2SDA: P3.3 (SDI/SDA), R13.1, U6.8 (SDA2)
3.3V: ADC1.13 (VD), C2.1, C3.1, C6.1, C7.1, C8.1, C9.1, C10.1, C12.1, C15.1, D5.A, P1.6 (VDDIO), P1.8 (VDD), P2.6 (VDDIO), P2.8 (VDD), P3.6 (VDDIO), P3.8 (VDD), P4.6 (VDDIO), P4.8 (VDD), P5.6 (VDDIO), P5.8 (VDD), R6.1, R7.2, R8.2, R9.2, R10.2, R13.2, R14.2, R15.2, R16.2, R17.2, R18.2, R21.2, R22.2, R29.2, R30.2, R31.2, R32.2, R33.2, R34.2, R35.2, R36.2, R41.2, R42.1, R48.1, RPI2.17 (3.3V), U6.24 (VCC), U7.24 (VCC), U$20.1
3SCL: P4.4 (SCK/SCL), R16.1, U6.11 (SCL3)
3SDA: P4.3 (SDI/SDA), R15.1, U6.10 (SDA3)
4.096V: ADC1.2 (VA), C11.1, C14.1, REF1.2 (OUT)
4SCL: P5.4 (SCK/SCL), R18.1, U6.14 (SCL4)
4SDA: P5.3 (SDI/SDA), R17.1, U6.13 (SDA4)
5V: C13.1, C21.+, C23.1, D4.A, J10.2, L1.1, R1.1, U$59.1
11SCL: J3.3, R32.1, U7.7 (SCL1)
11SDA: J3.4, R31.1, U7.6 (SDA1)
12V: C19.1, C20.1, C22.+, D2.A, J1.1, J2.1, J4.1, J5.PWR, J6.1, R11.1, U$40.1, VREG1.5 (IN)
22SCL: J8.3, R34.1, U7.9 (SCL2)
22SDA: J8.4, R33.1, U7.8 (SDA2)
33SCL: J9.3, R36.1, U7.11 (SCL3)
33SDA: J9.4, R35.1, U7.10 (SDA3)
A0_PC: R19.1, U6.1 (A0)
A1_PC: R20.1, U6.2 (A1)
A2_PC: R25.1, U6.21 (A2)
A3_PC: R39.1, U7.1 (A0)
A4_PC: R40.1, U7.2 (A1)
A5_PC: R41.1, U7.21 (A2)
ADC1: J1.3, R26.2
ADC2: J2.3, R28.2
ADC3: J4.3, R27.2
ADC4: J6.3, R37.2
GND: ADC1.1 (CS), ADC1.3 (AGND), ADC1.12 (DGND), C1.2, C2.2, C3.2, C4.2, C5.2, C6.2, C7.2, C8.2, C9.2, C10.2, C11.2, C12.2, C14.2, C15.2, C16.2, C17.2, C18.2, C20.2, C21.-, C22.-, C23.2, D3.A, J1.2, J2.2, J3.2, J4.2, J5.GND, J5.GNDBREAK, J6.2, J7.2, J8.2, J9.2, J11.1, P1.1 (GND), P1.7 (GND), P2.1 (GND), P2.7 (GND), P3.1 (GND), P3.7 (GND), P4.1 (GND), P4.7 (GND), P5.1 (GND), P5.7 (GND), Q2.2 (E), R2.2, R3.1, R5.2, R12.1, R19.2, R20.2, R23.1, R25.2, R39.2, R40.2, R45.1, R46.2, REF1.3 (GND), RPI2.6 (GND), RPI2.9 (GND), RPI2.14 (GND), RPI2.20 (GND), RPI2.25 (GND), RPI2.30 (GND), RPI2.34 (GND), RPI2.39 (GND), U6.12 (GND), U7.12 (GND), U$31.1, VREG1.1 (GND)
GND1: R46.1, RPI2.41 (GND1)
GPIO12: R24.2, RPI2.32 (GPIO12)
unnamed: D2.C, R12.2
unnamed: D3.C, L1.2, VREG1.3 (SW), VREG1.6 (SW)
unnamed: C19.2, VREG1.4 (VC)
unnamed: D1.C, R3.2
unnamed: Q1.1 (G), Q2.3 (C), R47.1
unnamed: Q2.1 (B), R24.1, R48.2
unnamed: C13.2, R1.2, R2.1, VREG1.2 (FB)
unnamed: ADC1.8 (IN4), C1.1, R4.2
unnamed: R4.1, R5.1, R11.2
unnamed: D4.C, R23.2
unnamed: D5.C, R45.2
unnamed: ADC1.4 (IN0), C4.1, R26.1
unnamed: ADC1.6 (IN2), C5.1, R27.1
unnamed: ADC1.5 (IN1), C16.1, R28.1
unnamed: ADC1.7 (IN3), C17.1, R37.1
unnamed: ADC1.16 (SCLK), R38.2
unnamed: ADC1.15 (DOUT), R43.2
unnamed: ADC1.14 (DIN), R44.2
PI_5V_POWER: C18.1, D1.A, J10.1, J11.2, Q1.2 (S), R47.2, REF1.1 (IN), RPI2.2 (5.0V), RPI2.4 (5.0V), U$64.1
RESET: R6.2, R42.2, U6.3 (#RESET), U7.3 (#RESET)
SCL: R22.1, RPI2.5 (SCL), U6.22 (SCL), U7.22 (SCL)
SDA: R21.1, RPI2.3 (SDA), U6.23 (SDA), U7.23 (SDA)
SENS_POWER: J3.1, J7.1, J8.1, J9.1, Q1.3 (D)
SPI_MISO: R43.1, RPI2.21 (SPI_MISO)
SPI_MOSI: R44.1, RPI2.19 (SPI_MOSI)
SPI_SCLK: R38.1, RPI2.23 (SPI_SCLK)

Notes on the sheet:
I2C Pullup
Test Points
Indicator LEDs
Power For Flow Sensors
For I2C, CSB pulled high SDI=SDA, SCK=SCL SDO: GND='0', VCC = '1' Adress: 0x77 - SDO pulled-up to VDD or NC
Connectors for Automotive Airflow Sensors #1-4
Pressure Sensors SPL06-007 LCSC Part# C233787 https://datasheet.lcsc.com/szlcsc/1907081118_Goertek-SPL06-007_C233787.pdf
Connectors for Sensiron Airflow sensors #1-#4
CS always active
Regulator - XL4015E1 https://lcsc.com/product-detail/DC-DC-Converters_XL4015E1_C51661.html/?href=jlc-SMT LCSC Part# C51661 Package TO-263-5 Input capacitor Spec - 50V Selection 220uF, 50V LCSC Part# C134732 https://datasheet.lcsc.com/szlcsc/Lelon-VE-221M1HTR-1010_C134732.pdf 10X10MM ROHS, panasonic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
i2C Multiplexier LCSC Part# C21198 MFR.Part #PCA9548APW,118 TSSOP-24_4.4xx7.8x0.65P https://datasheet.lcsc.com/szlcsc/NXP-Semicon-PCA9548APW-118_C21198.pdf
ADC Texas Instruments MFR Part# ADC128S102 LCSC Part # C179666 PackageHTSSOP-16_EP_4.4x5.0x0.65P https://datasheet.lcsc.com/szlcsc/Texas-Instruments-TI-ADC128S102CIMTX-NOPB_C179666.pdf
Reference Voltage Texas Instruments MFR Part# REF3040AIDBZR LCSC Part # C19415 Package SOT-23-3 https://datasheet.lcsc.com/szlcsc/Texas-Instruments-TI-REF3040AIDBZR_C19415.pdf
Q1 P-ch Mosfet MFR Part# AO3401A LCSC Part# C15127 Package SOT-23-3 https://datasheet.lcsc.com/szlcsc/Alpha-Omega-Semicon-AOS-AO3401A_C15127.pdf 1-gate, 2-source, 3-drain Q2 Transistor MFR Part# S8050 LCSC Part# C2146 Package SOT-23-3 NPN 500MA 25V https://datasheet.lcsc.com/szlcsc/Changjiang-Elect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
Input Voltage Sensor
Jumper for 12VDC to supply 5VDC (remove 5V usb micro from RPI!)
5V Power to LCD Display
Power Logic Scenario #1 - Testing with the RPI pluged into 5V micro usb - no 12VDC present - display is powered, all 5V peripherials powered via RPI Scenario #2 - out in the field sensirion flow sensors - 12VDC is only power used - 12VDC/5DC converter is active, jumper is made and RPI, Display, and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
version 003 - removed piezo buzzer - used transistor/P-ch mosfet for triggering sensirion power - added 33nF capacitor on the 5V power regulator based on rev1.6 of the data sheet

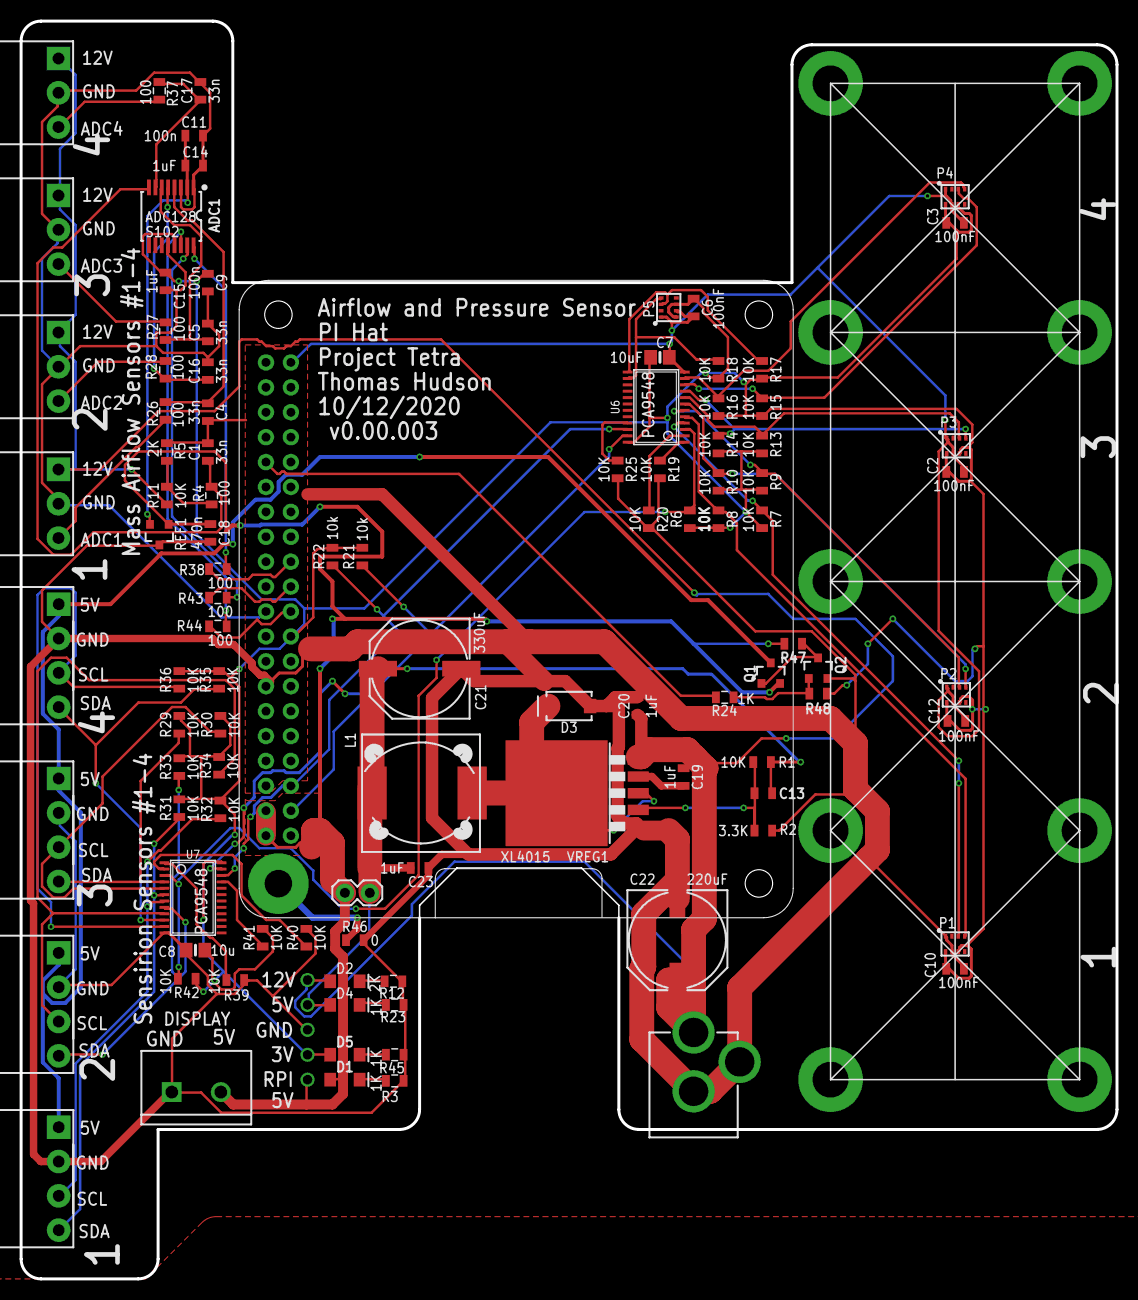
[picture p286: board raspberry_pi_v003.brd from above]

Board: 2 copper layers, 111.8 x 128.3 mm, 116 parts (0 on the bottom side), 61 nets.
