tetrabiodistributed/project-tetra/02_Development/FlowMeter/FastTrackTidalVolMeter/PCB/Olimex ESP32 POE Wing.brd

## EAGLE design 02_Development/FlowMeter/FastTrackTidalVolMeter/PCB/Olimex ESP32 POE Wing.brd (2020-03-23)

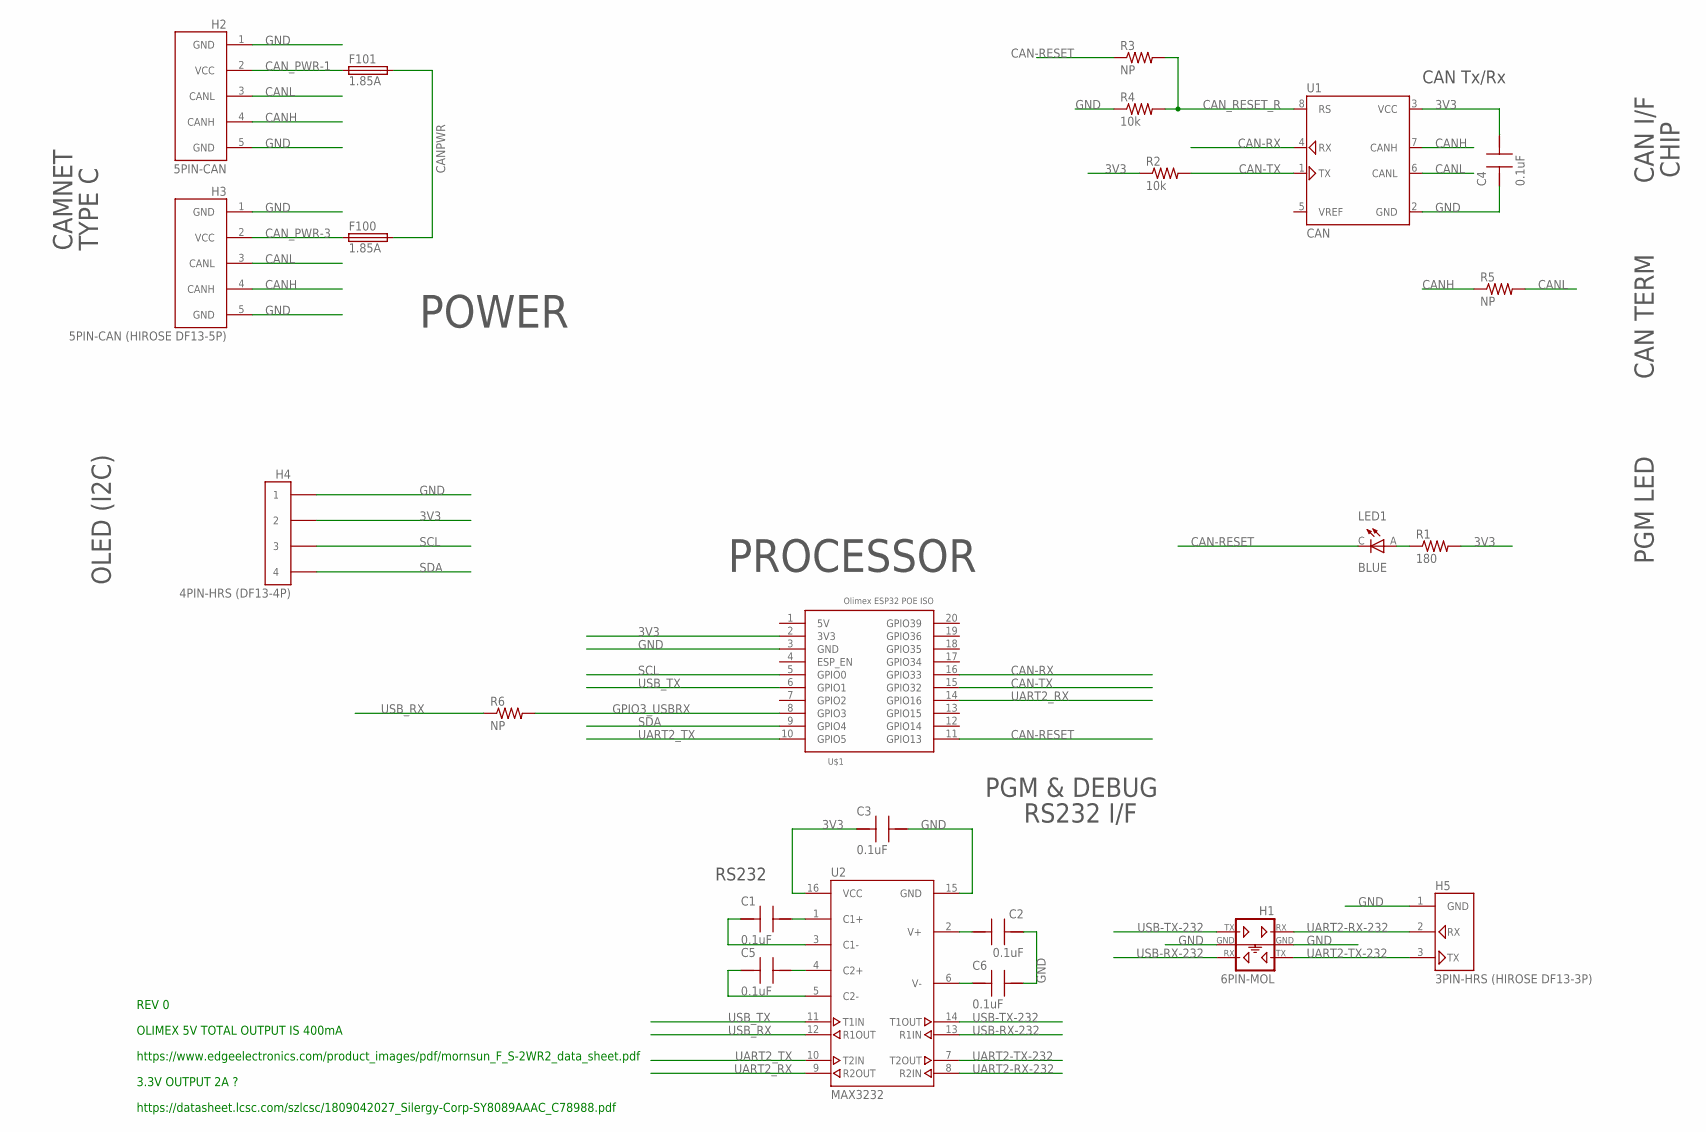
[picture p287: schematic Olimex ESP32 POE Wing.sch]

Parts:
C1, C2, C3, C4, C5, C6: 0.1uF; C0805
F100, F101: 1.85A; 2920
H1: 6PIN-MOL; 87831-0620
H2: 5PIN-CAN; DF13-5P-1.25DSA
H3: 5PIN-CAN (HIROSE DF13-5P); DF13-5P-1.25DSA
H4: 4PIN-HRS (DF13-4P); DF13-4P-1.25DSA
H5: 3PIN-HRS (HIROSE DF13-3P); DF13-3P-1.25DSA
LED1: BLUE; CHIPLED_0805
R1: 180; R0805
R2, R4: 10k; R0805
R3, R5, R6: NP; R0805
U1: CAN; SO-08
U2: MAX3232; TSSOP16
U$1: OLIMEX_POE_ISOPOEISO; OLIMEX_POE_ISO

Connections:
3V3: C3.2 (-), C4.1 (+), H4.2, R1.2, R2.1, U1.3 (VCC), U2.16 (VCC), U$1.2 (3V3)
5V: U$1.1 (5V)
BLUEX: LED1.A, R1.1
C1+: C1.1 (+), U2.1 (C1+)
C1-: C1.2 (-), U2.3 (C1-)
C2+: C5.1 (+), U2.4 (C2+)
C2-: C5.2 (-), U2.5 (C2-)
CAN-RESET: LED1.C, R3.1, U$1.11 (GPIO13)
CAN-RX: U1.4 (RX), U$1.16 (GPIO33)
CAN-TX: R2.2, U1.1 (TX), U$1.15 (GPIO32)
CANH: H2.4 (CANH), H3.4 (CANH), R5.1, U1.7 (CANH)
CANL: H2.3 (CANL), H3.3 (CANL), R5.2, U1.6 (CANL)
CANPWR: F100.P2 (2), F101.P2 (2)
CAN_PWR-1: F101.P1 (1), H2.2 (VCC)
CAN_PWR-3: F100.P1 (1), H3.2 (VCC)
CAN_RESET_R: R3.2, R4.2, U1.8 (RS)
GND: C2.2 (-), C3.1 (+), C4.2 (-), C6.1 (+), H1.3, H1.4, H2.1 (GND), H2.5 (GND), H3.1 (GND), H3.5 (GND), H4.1, H5.1 (GND), R4.1, U1.2 (GND), U2.15 (GND), U$1.3 (GND)
GPIO3_USBRX: R6.2, U$1.8 (GPIO3)
SCL: H4.3, U$1.5 (GPIO0)
SDA: H4.4, U$1.9 (GPIO4)
UART2-RX-232: H1.1, H5.2 (RX), U2.8 (R2IN)
UART2-TX-232: H1.5, H5.3 (TX), U2.7 (T2OUT)
UART2_RX: U2.9 (R2OUT), U$1.14 (GPIO16)
UART2_TX: U2.10 (T2IN), U$1.10 (GPIO5)
USB-RX-232: H1.6, U2.13 (R1IN)
USB-TX-232: H1.2, U2.14 (T1OUT)
USB_RX: R6.1, U2.12 (R1OUT)
USB_TX: U2.11 (T1IN), U$1.6 (GPIO1)
V+: C2.1 (+), U2.2 (V+)
V-: C6.2 (-), U2.6 (V-)

Notes on the sheet:
PROCESSOR
RS232
CAN TERM
CAN Tx/Rx
PGM LED
CAN I/F
CHIP
RS232 I/F
PGM & DEBUG
POWER
TYPE C
CAMNET
OLED (I2C)
OLIMEX 5V TOTAL OUTPUT IS 400mA
https://www.edgeelectronics.com/product_images/pdf/mornsun_F_S-2WR2_data_sheet.pdf
REV 0
3.3V OUTPUT 2A ?
https://datasheet.lcsc.com/szlcsc/1809042027_Silergy-Corp-SY8089AAAC_C78988.pdf
