tetrabiodistributed/project-tetra/02_Development/FlowMeter/FastTrackTidalVolMeter/PCB/Olimex ESP32 POE Wing.brd

## EAGLE design 02_Development/FlowMeter/FastTrackTidalVolMeter/PCB/Olimex ESP32 POE Wing.brd (continued)

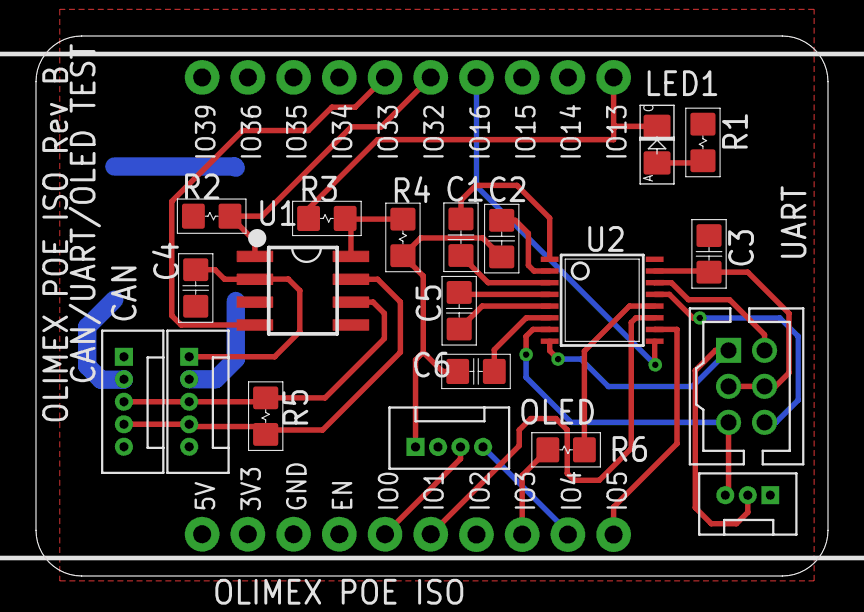
[picture p288: board Olimex ESP32 POE Wing.brd from above]

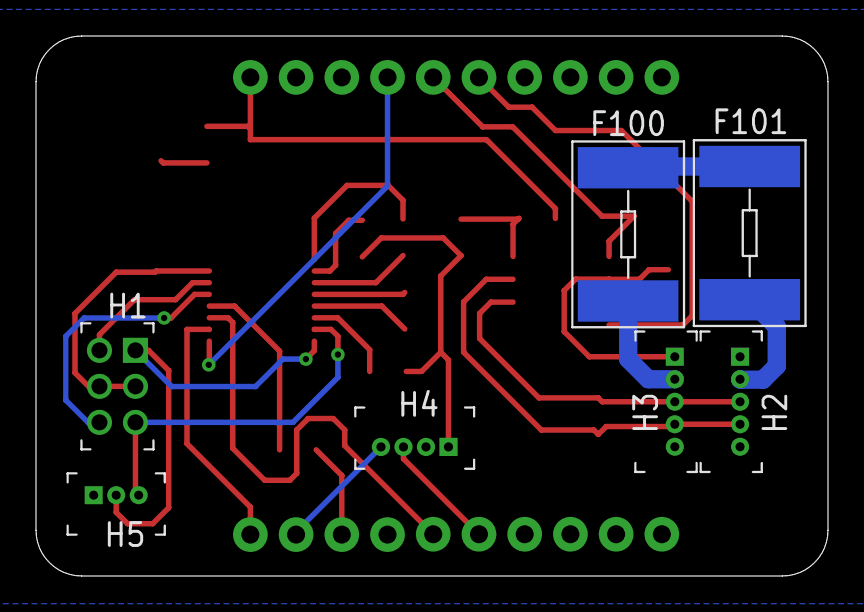
[picture p289: board Olimex ESP32 POE Wing.brd from below]

Board: 2 copper layers, 44.0 x 30.0 mm, 23 parts (2 on the bottom side), 29 nets.
