tetrabiodistributed/project-tetra/02_Development/FlowMeter/FastTrackTidalVolMeter/ESP32Code/FastTrackTidalFlowMeter/FastTrackTidalFlowMeter.ino

// Code butcherd from https://randomnerdtutorials.com/esp32-servo-motor-web-server-arduino-ide/
#include <Wire.h>  
#include "SSD1306Wire.h"
#include <Arduino.h>
#include <ESP32CAN.h>
#include <HardwareSerial.h>
#include <WiFi.h>
#include "esp32config.h"


unsigned long previousMillis = 0;   // will store last time a CAN Message was send
const int interval = 1000;          // interval at which send CAN Messages (milliseconds)
const int rx_queue_size = 10;       // Receive Queue size

HardwareSerial hwSerial(1);
SSD1306Wire display(0x3c, esp32I2CSDA, esp32I2CSCL); // SCL -> GPIO0  SDA -> GPIO4

// Replace with your network credentials
const char* ssid     = "wifi_SSID";
const char* password = "password";

// Set web server port number to 80
WiFiServer server(80);

// Variable to store the HTTP request
String header;

// Decode HTTP GET value
String valueString = String(5);
int pos1 = 0;
int pos2 = 0;


void setup() {
  hwSerial.begin(115200, SERIAL_8N1, esp32Uart2Rx, esp32Uart2Tx);
  Serial.begin(115200);
  Serial.println("Basic Demo - ESP32-Arduino");
  hwSerial.println("Basic Demo - ESP32-Arduino from UART2");
  display.init();
  display.flipScreenVertically();
  display.clear();
  display.setFont(ArialMT_Plain_16);
  display.setTextAlignment(TEXT_ALIGN_CENTER_BOTH);
  display.drawString(display.getWidth()/2, display.getHeight()/2 - 10, "TidalVolume");
  display.display();
  Serial.print("Connecting to ");
  Serial.println(ssid);
  WiFi.begin(ssid, password);
  while (WiFi.status() != WL_CONNECTED) {
    delay(500);
    Serial.print(".");
  }
  // Print local IP address and start web server
  Serial.println("");
  Serial.println("WiFi connected.");
  Serial.println("IP address: ");
  Serial.println(WiFi.localIP());
  server.begin();
  Serial.println("Server started");
}

void loop() {
  //int sliderVal;
  WiFiClient client = server.available();   // Listen for incoming clients
  
  if (client) {                             // If a new client connects,
    Serial.println("New Client.");          // print a message out in the serial port
    String currentLine = "";                // make a String to hold incoming data from the client
    while (client.connected()) {            // loop while the client's connected
      if(Serial.available() > 0) {
        Serial.println("Char received");
        char letter = Serial.read();
        switch (letter)  {
          case 'c': break;
          case 'C': break;
          default: break;
        } 
      }
      if (client.available()) {             // if there's bytes to read from the client,
        char c = client.read();             // read a byte, then
        Serial.write(c);                    // print it out the serial monitor
        header += c;
        if (c == '\n') {                    // if the byte is a newline character
          // if the current line is blank, you got two newline characters in a row.
          // that's the end of the client HTTP request, so send a response:
          if (currentLine.length() == 0) {
            // HTTP headers always start with a response code (e.g. HTTP/1.1 200 OK)
            // and a content-type so the client knows what's coming, then a blank line:
            client.println("HTTP/1.1 200 OK");
            client.println("Content-type:text/html");
            client.println("Connection: close");
            client.println();

            // Display the HTML web page
            client.println("<!DOCTYPE html><html>");
            client.println("<head><meta name=\"viewport\" content=\"width=device-width, initial-scale=1\">");
            client.println("<link rel=\"icon\" href=\"data:,\">");
            // CSS to style the on/off buttons 
            // Feel free to change the background-color and font-size attributes to fit your preferences
            client.println("<style>body { text-align: center; font-family: \"Trebuchet MS\", Arial; margin-left:auto; margin-right:auto;}");
            client.println(".slider { width: 200px; height:25px; }</style>");
            client.println("<script src=\"https://ajax.googleapis.com/ajax/libs/jquery/3.3.1/jquery.min.js\"></script>");
                     
            // Web Page
            client.println("</head><body><h1>CamRoCo Motor Controller</h1>");
            client.println("<p>Position: <span id=\"servoPos\"></span></p>");          
            client.println("<input type=\"range\" min=\"0\" max=\"500\" class=\"slider\" id=\"servoSlider\" onchange=\"servo(this.value)\" value=\""+valueString+"\"/>");

            client.println("<script>var slider = document.getElementById(\"servoSlider\");");
            client.println("var servoP = document.getElementById(\"servoPos\"); servoP.innerHTML = slider.value;");
            client.println("slider.oninput = function() { slider.value = this.value; servoP.innerHTML = this.value; }");
            client.println("$.ajaxSetup({timeout:1000}); function servo(pos) { ");
            client.println("$.get(\"/?value=\" + pos + \"&\"); {Connection: close};}</script>");
           
            client.println("</body></html>");     
            
            //GET /?value=180& HTTP/1.1
            if(header.indexOf("GET /?value=")>=0) {
              pos1 = header.indexOf('=');
              pos2 = header.indexOf('&');
              valueString = header.substring(pos1+1, pos2);
              
              // SEND PACKET HERE              

            }         
            // The HTTP response ends with another blank line
            client.println();
            // Break out of the while loop
            break;
          } else { // if you got a newline, then clear currentLine
            currentLine = "";
          }
        } else if (c != '\r') {  // if you got anything else but a carriage return character,
          currentLine += c;      // add it to the end of the currentLine
        }
      }
    }
    // Clear the header variable
    header = "";
    // Close the connection
    client.stop();
    Serial.println("Client disconnected.");
    Serial.println("");
  }

  
}
