tetrabiodistributed/project-tetra/(commit log)

2020-03-17 Added inline
    [4WayVent_InLine_3DP_v1.SLDPRT, 4WayVent_InLine_3DP_v1.STEP, 4WayVent_InLine_3DP_v1.STL]
2020-03-17 Rename In development/4WayVent_InLine_3DP_v1.STEP to In development/Inline/4WayVent_InLine_3DP_v1.STEP
    [4WayVent_InLine_3DP_v1.STEP]
2020-03-17 Original files uploaded
    [4WayVent_3DP_v4.SLDPRT, 4WayVent_3DP_v4.STEP, 4WayVent_3DP_v4.STL]
2020-03-17 Added original files from drive
    [4WayValveCapV1_0_0.SLDPRT, 4WayValveCapV1_0_0.STEP, 4WayValveCapV1_0_0.STL, 4WayValveV1_0_1.SLDPRT]
2020-03-17 Added SOLIDWORKS file
    [2way.SLDPRT]
2020-03-17 Tesla valve sketch added
2020-03-17 Added latest valve version
    [4WayValveV1.1.STL]
2020-03-18 Added 2Way_Wye_V1 files
    2Way_Wye is for ventilating 2 patients at the same time with minimal flow restriction.
    [2Way_WYE_V1.SLDPRT, 2Way_WYE_V1.STEP, 2Way_WYE_V1.STL, Backup (1) of 2Way_WYE_V1.SLDPRT, Backup (2) of 2Way_WYE_V1.SLDPRT]
2020-03-18 Added 2Way_Wye_V1
    Ventilator attachment that can hook up 2 patients to the same ventilator.
    [Backup (1) of 2Way_WYE_V1.SLDPRT, Backup (2) of 2Way_WYE_V1.SLDPRT]
2020-03-18 Adding no support parts
    [4WayVent_V04 cap.stl]
2020-03-18 Added no support files
    [4WayVent_V04 cap.sldprt, 4WayVent_V04 cap.stl]
2020-03-18 UPDATED 2 WAY
    [2WayValve.SLDPRT, 2WayValve.STEP, 2way.SLDPRT, 2way.STL]
2020-03-18 updated 4wayvalve
    [4WayValveV1.1.STL]
2020-03-18 moved old files and added master changed no support to threaded
    [2WayValve.SLDPRT, 2WayValve.STEP, 4WayVent_V04 cap.sldprt, 4WayVent_V04 cap.stl, 4WayVent_V04.sldprt]
2020-03-18 Adeed 2WayValveV1_0_1 step and sldprt
    [2WayValveV1_0_1.SLDPRT, 2WayValveV1_0_1.STEP]
2020-03-19 V1 commit
    [3WayValveBody_v001.stl, 3WayValveBody_v001.stp, 3WayValveCock_v001.stl, 3WayValveCock_v001.stp, 92000A116_18-8 SS METRIC PAN HEAD PHIL MACHINE SCREW.STEP]
2020-03-19 updated threading, moved designs to old
    [2WayValve.SLDPRT, 2WayValve.STEP, 2WayValveV1_0_1.SLDPRT, 2WayValveV1_0_1.STEP, 2WayVent_3DP_v05.sldprt, 2WayVent_3DP_v05.step, 2WayVent_3DP_v05_15 mm adapter.sldprt, 2WayVent_3DP_v05_15 mm adapter.step]
2020-03-19 threaded cap with better grip from Sayed Amir Karim
    [4WayLid_HandOperated_SAK_V1_0_0.SLDPRT, 4WayLid_HandOperated_SAK_V1_0_0.STEP]
2020-03-19 updated valve cock for better grip
    [3WayValveCock_v002.stl, 3WayValveCock_v002.stp]
2020-03-19 Modified valve grip, bigger and softer edges
    [3WayValveCock_v003.stl, 3WayValveCock_v003.stp]
2020-03-19 TeeValve Initial Commit
    [TeeValveAssembly_v001.stp, TeeValveBody_v001.stl, TeeValveBody_v001.stp, TeeValveCock_v001.stl, TeeValveCock_v001.stp]
2020-03-19 organised threaded into files
    [2WayVent_3DP_v05.sldprt, 2WayVent_3DP_v05.step, 2WayVent_3DP_v05_15 mm adapter.sldprt, 2WayVent_3DP_v05_15 mm adapter.step, 4WayLid_HandOperated_SAK_V1_0_0.SLDPRT, 4WayLid_HandOperated_SAK_V1_0_0.STEP, 4WayVent_3DP_v05 - main cap (1).sldprt, 4WayVent_3DP_v05 - main cap.step]
2020-03-19 Added CPAP Regulator folder
    Added concept drawings for bubbler
2020-03-19 Added -1 undersized parts
    [TeeValveCock_v001-undersize 1.stl, TeeValveCock_v001-undersize 1.stp, TeeValveCock_v001-undersize 2.stl, TeeValveCock_v001-undersize 2.stp]
2020-03-20 Added one way valve
    [one_way_valve V1 A.sldprt, one_way_valve V1 A.step, one_way_valve V1 B.sldprt, one_way_valve V1 B.step]
2020-03-21 added oring valve
    [Assem.STEP, ValveBody.STEP, ValveBody.STL, ValveCock.STEP]
2020-03-21 Added 3D printable o-ring
    [3D printable o-ring, TPU.stl, O-ring v1.f3d, O-ring v1.step]
2020-03-22 Adding FreeFlowR1PCBA step model
    [800AWSP9M2xE.stp, FreeFlowR1PCBA.stp, Freescale 98ASA99255D Case.STEP, LQFP-32-7x7.STEP, M-Honeywell-HIH8120.stp, mpr-series-long-port-with-gel-gage-cad-model.stp, pec12r-4x20f-sxxxx.stp]
2020-03-22 added peep valve design to cpap regulator
    [1. Bottle cap.SLDPRT, 1. Bottle cap.STEP, 1. Bottle cap.STL, 2. Main body.SLDPRT, 2. Main body.STEP, 2. Main body.STL, 3. Cylinder.SLDPRT, 3. Cylinder.STEP]
2020-03-22 Added Rev7 oring
    [TPERing_V1_0_0_SAK.SLDPRT, TPERing_V1_0_0_SAK.STEP, TPERing_V1_0_0_SAK.STL, ValveBodyV1_0_0_SAK.SLDPRT, ValveBodyV1_0_0_SAK.STEP, ValveBodyV1_0_0_SAK.STL, ValveCock_V1_0_0_SAK.SLDPRT, ValveCock_V1_0_0_SAK.STEP]
2020-03-23 cleanup
    cleanup
    [1. Bottle cap.SLDPRT, 1. Bottle cap.STEP, 1. Bottle cap.STL, 2. Main body.SLDPRT, 2. Main body.STEP, 2. Main body.STL, 2WayValve.SLDPRT, 2WayValve.STEP]
2020-03-23 adoptions after Print
    -Changed diameter of TPERing by 0.1mm+
    -addedFixRing
    [2WaySplitterAssembly.SLDASM, 3WayValveBody_v001.stl, 3WayValveBody_v001.stp, 3WayValveCock_v001.stl, 3WayValveCock_v001.stp, 3WayValveCock_v002.stl, 3WayValveCock_v002.stp, 3WayValveCock_v003.stl]
2020-03-23 Rev2 one way valve
    [one_way_valve V1 A.sldprt, one_way_valve V1 A.step, one_way_valve V1 B.sldprt, one_way_valve V1 B.step, one_way_valve V2 A.STEP, one_way_valve V2 A.sldprt, one_way_valve V2 B.STEP, one_way_valve V2 B.sldprt]
2020-03-23 new threads features
    [ValveBodyV1_0_1_SAK.SLDPRT, ValveBodyV1_0_1_SAK.STEP]
2020-03-23 added and changed parts
    a thread instead of clamping function on the fixRing and ValveCock
    [FixRingV1_0_1_SAK.SLDPRT, FixRingV1_0_1_SAK.STEP]
2020-03-23 adoptions
    adopted the parts to make them more suitable for 3d printing. Also added a rendel ring around the FixRIng.
    [2WaySplitterAssemblyV1_0_2.SLDASM, FixRingV1_0_1_SAK.SLDPRT, FixRingV1_0_1_SAK.STEP, ValveBodyV1_0_2_SAK.SLDPRT, ValveBodyV1_0_2_SAK.STEP, ValveCock_V1_0_3_SAK.SLDPRT, ValveCock_V1_0_3_SAK.STEP]
2020-03-23 updated cpap and hand operated stoppers
    [4WayLid_HandOperated_BBC_V2.SLDPRT, 4WayLid_HandOperated_BBC_V2.STEP, 4WayLid_HandOperated_SAK_V1_0_0.SLDPRT, 4WayLid_HandOperated_SAK_V1_0_0.STEP, Respirator-free reanimation Venturi's valve (rev. 4) FiO2-28 Body.STEP, Respirator-free reanimation Venturi's valve (rev. 4) FiO2-28 Body.STL, Respirator-free reanimation Venturi's valve (rev. 4) FiO2-28 Cap.STEP, Respirator-free reanimation Venturi's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]
2020-03-24 Added testing to one way and updated hand tightened
    [4WayLid_HandOperated_BBC_V2.SLDPRT, 4WayLid_HandOperated_BBC_V2.STEP, 4WayLid_HandOperated_BBC_V2_0_1.SLDPRT, 4WayLid_HandOperated_BBC_V2_0_1.STEP, 4WayLid_HandOperated_BBC_V2_0_1.STL]
2020-03-24 Adding rev3 of one way valve
    [OWV Assembly.SLDASM, OWV Assembly.STEP, OWV.SLDPRT, OWV.STEP, OWV.STL, Umbrella Mould Female.SLDPRT, Umbrella Mould Female.STL, Umbrella Mould Male.SLDPRT]
2020-03-24 added tpu ring
    [OWV Assembly.SLDASM, OWV Assembly.STEP, OWV.SLDPRT, OWV.STEP, OWV.STL, TPU - Disk v1.stl, TPU - Disk v2.f3d, TPU - Disk v2.step]
2020-03-25 Chaned main splitter name
    [2WayVent_3DP_v05.sldprt, 2WayVent_3DP_v05.step, 2WayVent_3DP_v05_15 mm adapter.sldprt, 2WayVent_3DP_v05_15 mm adapter.step, 4WayLid_HandOperated_BBC_V2.SLDPRT, 4WayLid_HandOperated_BBC_V2.STEP, 4WayLid_HandOperated_BBC_V2_0_1.SLDPRT, 4WayLid_HandOperated_BBC_V2_0_1.STEP]
2020-03-25 added the re4 one way valve
    [one-way valve V3.SLDASM, one-way valve V3.STEP, one-way valve body V3.SLDPRT, one-way valve body V3.STEP, one-way valve umbrella seal V3.SLDPRT, one-way valve umbrella seal V3.STEP, one-way valve umbrella seal V3.STL]
2020-03-26 Adding 3WayConicalValve
    [3WayConicalValveBodyv2.stl, 3WayConicalValveCapV2.stl, 3WayConicalValveCockV2.stl, 3WayConicalValveHandleV2.stl]
2020-03-26 Adding Step of assemlby
    [3WayConicalValveAssembly.step, 3WayValveBody_v001.stl, 3WayValveBody_v001.stp, 3WayValveCock_v001.stl, 3WayValveCock_v001.stp, 3WayValveCock_v002.stl, 3WayValveCock_v002.stp, 3WayValveCock_v003.stl]
2020-03-26 Updated CPAP regulator
    [Respirator-free reanimation Venturi's valve (rev. 4) FiO2-28 Body.STEP, Respirator-free reanimation Venturi's valve (rev. 4) FiO2-28 Body.STL, Respirator-free reanimation Venturi's valve (rev. 4) FiO2-28 Cap ISO 22mm.STEP, Respirator-free reanimation Venturi's valve (rev. 4) FiO2-28 Cap ISO 22mm.STL, Respirator-free reanimation Venturi's valve (rev. 4) FiO2-28 Cap.STEP, Respirator-free reanimatio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]
2020-03-26 Cleanup of 3 way valve folder
    [2WaySplitterAssembly.SLDASM, 2WaySplitterAssemblyV1_0_2.SLDASM, 3D printable o-ring, TPU.stl, 3WayConicalValveAssembly.step, 3WayConicalValveBodyv2.stl, 3WayConicalValveCapV2.stl, 3WayConicalValveCockV2.stl, 3WayConicalValveHandleV2.stl]
2020-03-26 cleaned main splitter folder
    [2WayVent_3DP_v05.sldprt, 2WayVent_3DP_v05.step, 2WayVent_3DP_v05_15 mm adapter.sldprt, 2WayVent_3DP_v05_15 mm adapter.step, 4WayLid_HandOperated_BBC_V2.SLDPRT, 4WayLid_HandOperated_BBC_V2.STEP, 4WayLid_HandOperated_BBC_V2_0_1.SLDPRT, 4WayLid_HandOperated_BBC_V2_0_1.STEP]
2020-03-26 updated ring for oring valve
    [FixRingV1_0_2_SAK_BC.SLDPRT, FixRingV1_0_2_SAK_BC.STEP]
2020-03-26 Updated Conical Valve Handle
    [3WayConicalValveHandleV3.stl]
2020-03-26 Updating conical assembly with V3 handle
    [3WayConicalValveAssembly.step, 3WayConicalValveHandleV2.stl]
2020-03-27 Assembly Drawing
2020-03-27 Update one way valve readme, remove test both marker
    [OWV Assembly.SLDASM, OWV Assembly.STEP, OWV.SLDPRT, OWV.STEP, OWV.STL, TPU - Disk v1.stl, TPU - Disk v2.f3d, TPU - Disk v2.step]
2020-03-27 Updated Readme and cleaned landing page
2020-03-27 Added Silicone Molding Form
    Added Silicone molding form for the TPE RIng
    [3WayValve_RIng_MoldPartA.STL, 3WayValve_RIng_MoldPartA.sldprt, 3WayValve_RIng_MoldPartB.STL, 3WayValve_RIng_MoldPartB.sldprt, MoldAssmably.SLDASM, MoldAssmably02.SLDASM, MoldAssmably02.STEP, ShellV1_0_0.SLDPRT]
2020-03-27 added Molding form Umerella
    Added Molding Form for Umrella, shringing 0,25%. 2x Bore holes need to be cutted with M3
    [MoldAssemblyV1_0_0.SLDASM, MoldingFormUmrellaV1_0_0_SAK.SLDPRT, UmberellaMoldParA_V1_0_0_SAK.STEP, UmberellaMoldParA_V1_0_0_SAK.STL, UmberellaMoldParA_V1_0_0_SAK.sldprt, UmberellaMoldParB_V1_0_0_SAK.STEP, UmberellaMoldParB_V1_0_0_SAK.STL, UmberellaMoldParB_V1_0_0_SAK.sldprt]
2020-03-28 Added 2/3/4 way splitters and Unthreaded versions of all valves
    Added Unthreaded 1 way valve
    Added Unthreaded 3 way valve (O RING)
    Added 2 way WYE
    Added 3 way WYE
    Added 4 way WYE
    [2WaySplitterAssemblyV1_0_2.SLDASM, 2Way_WYE_V1.SLDPRT, 2Way_WYE_V1.STEP, 2Way_WYE_V1.STL, 3Way_WYE_V1.SLDPRT, 3Way_WYE_V1.STEP, 3Way_WYE_V1.STL, 4Way_WYE_V1.SLDPRT]
2020-03-30 updated one way valve
    [BC Umbrella Mold.SLDPRT, BC Umbrella Mold_female.STL, BC Umbrella Mold_male.STL, MoldAssemblyV1_0_0.SLDASM, MoldingFormUmrellaV1_0_0_SAK.SLDPRT, TPU - Disk v1.stl, TPU - Disk v2.f3d, TPU - Disk v2.step]
2020-03-31 removed duplcate
    [Backup (1) of one-way valve V3.SLDASM, one-way valve V3.SLDASM]
2020-03-31 update one way valve
    [Backup (1) of one-way valve body V3_Unthreaded.SLDPRT, one-way valve body V3_Unthreaded.SLDPRT, one-way valve body V3_Unthreaded.STEP, one-way valve body V3_Unthreaded.STL, one-way valve umbrella seal V3 - TPU under test.STL, one-way valve umbrella seal V3.SLDPRT, one-way valve umbrella seal V3.STEP, one-way valve umbrella seal V3.STL]
2020-03-31 update mould
    [Umbrella Mould Female.STL, Umbrella Mould Male.STL, one-way valve umbrella seal V3.STL]
2020-04-02 added new cpap regulator
    [1. Bottle cap.SLDPRT, 1. Bottle cap.STEP, 1. Bottle cap.STL, 2. Main body.SLDPRT, 2. Main body.STEP, 2. Main body.STL, 3. Cylinder.SLDPRT, 3. Cylinder.STEP]
2020-04-03 Update one-way valve body V3_Unthreaded.STL
    [one-way valve body V3_Unthreaded.STL]
2020-04-03 Adding first assembly drawings
    These are initial drawings and will require updates, changes, and fixes. I have started a list of changes that needs to be made, but please comment if you notice anything or have any recommendations.
2020-04-03 Clean and update one way valve
    [one-way valve body V3_Unthreaded.STL]
2020-04-03 added ne part OneWayValve and canceled threads on 3WaySplitterBody
    [FlapperBodyV1_0_0.SLDPRT, FlapperBodyV1_0_0.STL, ValveBodyV1_0_3_SAK.SLDPRT, ValveBodyV1_0_3_SAK.STL]
2020-04-04 update 3 way valve
    [ValveBodyV1_0_3_SAK.STL]
2020-04-05 Create one-way valve body V3_Unthreaded.STL
    [one-way valve body V3_Unthreaded.STL]
2020-04-07 added 2 way splitter + one way valve
    [2Way_WYE_V1 v3.iges, 2Way_WYE_V1 v3.step]
2020-04-07 Create 2Way_WYE_V1 v4.f3z
    Fusion 360 archive file#
    [2Way_WYE_V1 v4.f3z]
2020-04-07 Documentation dump
    First set of schematics, documentation of the April 2 2020 test
2020-04-07 Starting to add PVCManifold parts
    [22M to 3_4 Slip v1.stl, 22M to 3_4 Slip v1.stp]
2020-04-07 added rev5 One way valve
    [OWV Rev5 seal Mold Female.STL, OWV Rev5 seal Mold Male.STL, OWV Rev5 seal Mold.SLDPRT, OWV Rev5 seal mold female.STEP, OWV Rev5 seal mold male.STEP, OWV body Rev5.SLDPRT, OWV body Rev5.STEP, OWV seal ReV5.SLDPRT]
2020-04-07 Updated inspiratory 2-way slitter with name change and v4
    [2Way_WYE_V1 v3.iges, 2Way_WYE_V1 v3.step, 2Way_WYE_V1 v4.f3z, inspiratory 2-way slitter v3.iges, inspiratory 2-way slitter v3.step, inspiratory 2-way slitter v4.f3z, inspiratory 2-way slitter v4.step, inspiratory 2-way slitterv3.f3z]
2020-04-07 changed name of inspiratory 2-way splitter
    [inspiratory 2-way splitter v3.f3z, inspiratory 2-way splitter v3.iges, inspiratory 2-way splitter v3.step, inspiratory 2-way splitter v4.f3z, inspiratory 2-way splitter v4.step]
2020-04-07 added Expiratory 2 way splitter
    [Expiratory 2 way splitter v2.step]
2020-04-07 Create Expiratory 2 way splitter v1.f3z
    [Expiratory 2 way splitter v1.f3z]
2020-04-08 Adding 1 way valve for 3/4" PVC Slip
    [One Way Valve 3_4 Slip v1.stl, One Way Valve 3_4 Slip v1.stp]
2020-04-08 Adding valve mounts
    [Valve Lower Mount v1.stl, Valve Lower Mount v1.stp, Valve Upper Mount v1.stl, Valve Upper Mount v1.stp]
2020-04-13 Added custom stopper for globe valve
    [globe_valve_test-001_stopper.SLDPRT, globe_valve_test-001_stopper.STEP, globe_valve_test-001_stopper.STL]
2020-04-15 relocate files for organization
    [globe_valve_test-001.SLDPRT, globe_valve_test-001.STEP, globe_valve_test-001.STL, globe_valve_test-001_stopper.SLDPRT, globe_valve_test-001_stopper.STEP, globe_valve_test-001_stopper.STL]
2020-04-15 improved revision
    [globe_valve_005-2.SLDASM, globe_valve_005.SLDASM, globe_valve_test-005.STEP, globe_valve_test-005.STL, globe_valve_test-005_stopper-002.SLDPRT, globe_valve_test-005_stopper-002.STEP, globe_valve_test-005_stopper-002.STL]
2020-04-22 Added panda folder
    [PANDA_Steelspring_V2_1.stp, PANDAflow_Base.stl, PANDAflow_Cap.stl, TPU_seal.stl, base_gen2_inline.stl, cover_gen2_inline.stl, disc_bikeSpring.stl, disc_gen2_inline_plastic.stl]
2020-04-27 Clearance update
    Request for splitters to be updated to accommodate 2" diameter filter installed on each outlet of splitter. Remodeled parts to work with Solidworks 2018. Note that expiratory splitter as previously configured (and modeled here) will not allow for installation of one-way valve flapper. Likely that all splitters will require redesign to better fit new manifold design and/or IM manufacturing processes.
    [1-3way_splitter_BQ_SW-2018.SLDPRT, 1-4way_splitter_BQ_SW-2018.SLDPRT, 2way_splitter_BQ_SW-2018.SLDPRT, Expiratory_splitter_BQ-2018.SLDPRT, Inspiratory_splitter_BQ-2018.SLDPRT]
2020-04-27 OWV SW-2018
    Remodeled part in Solidworks 2018 to gain better functionality and if needed make minor modifications
    [OWV_body_rev5_BQ-2018.SLDPRT]
2020-04-30 Adding HEVS Peep Body
    [HEVS PEEP V1.stp]
2020-05-14 adding HEVS peep valves
    [HEVS PEEP Cap V1.stl, Hevs Peep Body v2.stp, Hevs Peep Body v2b.stp, Hevs_Peep_Body_v2_cut-feet.STL, PANDA_Steelspring_V2_1.stp, PANDAflow_Base.stl, PANDAflow_Cap.stl, PEEP_cap_v2-2_Helix-thread_1-25mm_pitch.STL]
2020-05-14 adding hotwire and pressure sensor
    [Hotwire Flow Meter V1 - Short NPT v2.stl, Pressure sensor body V2.stl]
2020-05-14 adding Hannah's peep knob design
    [peep knob.stp]
2020-05-20 Cap label changes and & stl
    [TetraValveCap v3.stl, TetraValveCap v3.stp]
2020-05-20 Updated Valve Head
    [PEEP_cap_v3_2mm_pitch.STEP, PEEP_valve_head_v3.STEP, Patrick Peep Valve Seal.STEP, TetraValveHead v3.stl, TetraValveHead v3.stp]
2020-05-28 Update to design for new spring
    [TETRA_cap_v4-2_2mm_pitch.STL, TETRA_valve_head_v4-2.STL, Tetra_valve_body-v4-2.STL]
2020-05-28 Uploading version with correct label
    [Tetra_valve_body-v4-2.STL]
2020-05-29 add 'Documents' to Reference page
    - add links for "Project Proposal", "Testing Questions", "Printing Queue", & "System Concept Diagram" to Reference page
    - update Reference page description
2020-05-31 Update landing page w/ executive summary
    - add executive summary
    - remove unused boilerplate verbiage
    - add link to contributing guide
    - replace Norsk w/ Spanish
2020-06-04 Added the 5 way splitter
    [1-5way_splitter_BQ_SW-2018.STEP]
2020-06-04 Add 5-way splitter
    [1-5way_splitter_BQ_SW-2018.SLDPRT]
2020-06-04 v4-1 Tetra valve
    Design works with G-74 - Compression Spring from Century Spring Corp
    https://www.centuryspring.com/catalog/?page=product&cid=root&id=G-74CS
    [TETRA_cap_v4-1.STL, TETRA_valve_head_v4-1.STL, Tetra_valve_body-v4-2.STL]
2020-06-04 Tetra valve v4-2
    Design works with S-262 - Compression Spring from Century Spring Corp
    https://www.centuryspring.com/catalog/compression-regular?page=product&cid=compression-regular&id=S-262CS
    [TETRA_cap_v4-2.STL, TETRA_valve_head_v4-2.STL, Tetra_valve_body-v4-2.STL]
2020-06-04 Tetra valve v4-2
2020-06-04 Added Tetra valve overview
    Added overview from google docs
2020-06-04 updating the documentation to be the most recent, including removing peep valves and starting a parts/build guide
2020-06-04 saving current version
2020-06-04 updated landing docs page link and moved images
2020-06-10 Cleaned up main-splitter
    [2WayVent_3DP_v05.sldprt, 2WayVent_3DP_v05.step, 2WayVent_3DP_v05_15 mm adapter.sldprt, 2WayVent_3DP_v05_15 mm adapter.step, 2Way_WYE_V1.SLDPRT, 2Way_WYE_V1.STEP, 2Way_WYE_V1.STL, 3Way_WYE_V1.SLDPRT]
2020-06-13 Added folders for RPi PCB
2020-06-13 STLs for printing
    Tested on FDM/FFF printer with 0.4mm nozzle:
    - Cura 4.3 for slicing
    - 0.2 mm adaptive layers
    - 55 mm/s print speed
    - Grid infill = 15%
    - Z-Hop enabled
    [tetra_concept-body-v5.STL, tetra_concept-cap_v5.STL, tetra_concept-plunger_v5.STL, tetra_concept-top-v5.STL]
2020-06-15 created a first version of the Tubing Data information screen
2020-06-16 Changed the language in the turning-on tutorial to use the word instead of and to have a better test procedure to verify the splitter is working. Added a new tutorial on how to make a application run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
2020-06-24 updated pcb design files
    [raspberry_pi2.brd, raspberry_pi2.sch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]
2020-06-30 v00.00.002
    updated with new DC/DC conveter. Added all JLCPCB SMT parts for assembly, adjusted footprint of PI board to fit LCD
    [RPI_v2_BOM.csv, raspberry_pi2.brd, raspberry_pi2.sch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]
2020-06-30 add ibd-ventilator-splitter-assembly
2020-07-07 Add files via upload
    Details on changes listed on [project card] (https://github.com/orgs/tetrabiodistributed/projects/1#card-41428429)
    [Manifold_v2-0.STL]
2020-07-07 Manifold v2-0 STEP
    [Manifold_v2-0.STEP]
2020-07-07 Manifold v2 STEP
    [Manifold_v2-0.STEP]
2020-07-07 Manifold v2 SW-2018
    [Manifold_v2-0.SLDPRT]
2020-07-08 Added unit tests and behaviour tests to the tracer program. Also made it so setup and testing can be done with convenient scripts
2020-07-08 fixed a typo in server.py
    [server.py]
2020-07-08 changed the sensors module so it will read data from a file when it's not run on a raspberry pi and added the start of a behave test to verify that the Docker image works.
2020-07-11 Adding pressure manifold files (P-TET-000005-0)
    [P-TET-000005-0.stl]
2020-07-13 Adding piping complex STLs
    P-TET-000001-0
    P-TET-000002-0
    P-TET-000003-0
    [P-TET-000001-0.stl]
2020-07-14 Add P-TET-000006-0.stl
    ISO Adapter with pressure port
2020-07-15 Adding FDM version of Pressure Manifold
    [P-TET-000008-0.stl]
2020-07-16 P-TET-000007-0 released
    [P-TET-000007A-0.stl, P-TET-000007B-0.stl, P-TET-000007C-0.stl, P-TET-000007D-0.stl]
2020-07-16 Remove redundant part
    [P-TET-000018-0.stl]
2020-07-16 P-TET-000004-0 alpha prototype release
    [P-TET-000004-0.stl]
2020-07-17 Delete P-TET-000023-0.stl
    bad upload
2020-07-17 Updated corners with lip (#59)
    [P-TET-000015-1.stl, P-TET-000016-1.stl]
2020-07-28 Feature/drivers (#57)
    * Created a driver for the SPL06-007 pressure sensor. Does not yet pass correctness test.
    * made the code closer to the data sheet, but the bug causing the incorrect pressure/temperature readings is at large.
    * improved the pressure driver a bit (though it still returns wrong values) and added a script to find all i2c devices and documentation on the sensor
    * moved the pressure driver to the new working directory
    * retrieved some files that mysteriously dissapeared from git
    * renamed the problem files to something more clear to a non-case-sensitive file system
    * made all the tests work with the recovered files. The README also apparently dissapeared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
    [causal_integral_filter.py, causal_velocity_filter.py, constants.py, discrete_transfer_function.py]
2020-07-29 Adds a (nonfunctional) pretty front end to the system (#109)
    * changed the sensors module so it will read data from a file when it's not run on a raspberry pi and added the start of a behave test to verify that the Docker image works.
    moved directories for Display to 02_Development/Display
    Created a driver for the SPL06-007 pressure sensor. Does not yet pass correctness test.
    made the code closer to the data sheet, but the bug causing the incorrect pressure/temperature readings is at large.
    improved the pressure driver a bit (though it still returns wrong values) and added a script to find all i2c devices and documentation on the sensor
    moved the pressure driver to the new wo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
    [constants.py, i2c_interface.py, sensors.py]
2020-07-30 Delete P-TET-000022-1.stl
    Bad export.
2020-07-30 Add files via upload
    Shutoff Valve Knob
    [P-TET-000021-1.stl]
2020-08-05 pcb_for_sensirion_connector (#114)
    move phoenix connector to be 8.4mm or 0.33" from pogo_pins
    [POGO_pins_export.step, Phoneix_connector_from_Patrick's_model.step, air_flow.brd, air_flow.sch, connector_board.step]
2020-08-31 Drawing template #95 (#127)
    Files created by @mechatroniks-git for use as drawing templates for use with Alpha prototype
    [Tetra Drawing Template - Assembly v18 Assembly.dxf, Tetra Drawing Template - Assembly v18.dwg, Tetra Drawing Template - Part FDM v2 Assembly.dxf, Tetra Drawing Template - Part FDM v2.dwg, Tetra Drawing Template - Part SLA v2 Assembly.dxf, Tetra Drawing Template - Part SLA v2.dwg]
2020-09-01 Alpha sprint p2 (#128)
    * Create folder
    * Issue #98
    * Issue #97
    * Clean up release vs testing files
    Add Archive folder for previous revision models
    Add Testing folder for models not released but ready to test
    Migrated For_Printing folder with currently released models
    P-TET-000019-2 Issue #98
    P-TET-000021-1 Issue #97
    P-TET-000022-1 Issue #99
    P-TET-000023-1 Issue #100
    P-TET-000028-0 New iteration of Tetra valve with steps added to outlet
    * Updated P-TET-000030 to -1
    * Design files Alpha sprint 2
    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
    [P-TET-000001-0_90-degree_elbow.step, P-TET-000001-0_90-degree_elbow.stl, P-TET-000002-0_Large-T.step, P-TET-000002-0_Large-T.stl, P-TET-000003-0_Tetra_T-joint.step, P-TET-000003-0_Tetra_T-joint.stl, P-TET-0000032-0.step, P-TET-0000032-0.stl]
2020-10-13 add new PCB v003 with updates (#135)
    - added hard reset for sensirion using p-channel moseft
    - added capacior per the updated cut sheet v1.6 for the 5V regulator
    [RPI_v003_BOM.csv, raspberry_pi_v003.brd, raspberry_pi_v003.sch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]
2020-10-18 beta testing parts (#136)
    Initial changes for beta updates of prototype, changes for parts:
    P-TET-000001
    P-TET-000002
    P-TET-000003
    P-TET-000018
    P-TET-000019
    [P-TET-000001-0.stl, P-TET-000002-0.stl, P-TET-000003-0.stl, P-TET-000018-3.stl, P-TET-000019-4.stl]
2020-10-22 Added P-TET-000033-0 to Beta P1 (#138)
    * beta testing parts
    * Create P-TET-000033-0.stl
    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
    [P-TET-000033-0.stl]
2020-11-09 Changed part numbers to remove duplicates and fit with current system (#137)
    [P-TET-000012-0_Expiratory_mount_support_upper.stl, P-TET-000013-0_Expiratory_mount_support_lower.stl]
2020-11-24 Beta p1 (#143)
    * Create P-TET-000006-2.stl
    Update ISO adapter geometery
    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
    [P-TET-000006-2.stl]
2020-12-11 updated PCB with new 5V regulator (#145)
    * added new 5V regulator
    added new 5V regulator as existing regulator was out-of-stock at JLCPCB
    * updated capacitor
    changed C22 and C25 to 1206 footprint and specified 2mohm low ESR cap
    [RPI_v003_BOM.csv, RPI_v004_BOM.csv, raspberry_pi_v004.brd, raspberry_pi_v004.sch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]
2020-12-16 Next revision of PCB (#152)
    * Next revision of PCB
    Changed I2C pullup resistors to 3Kohm
    General tidy up and fix of issues on the PCB. Tweaked some polygons to eliminate sharp corners, made some traces larger.
    * Changes made as per PR152
    Changes made as requested, I also updated the pdf of the schematic and the dru file.
    One thing I have noticed is that generating the BOM automatically comes up with the incorrect resistor value of 0.3 Ohms. I suspect this is to do with the library that is being used.
    * Create READ ME BEFORE CONTINUING.md
    Added a cautionary text file to explain the issue with the automatically generated BOM and the incorrect resistor values being utilised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
    [RPI_v004_BOM.csv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]
2021-01-13 Pi Updates
    [Manifold_v1.STEP, Manifold_v1.STL, Manifold_v2-0.SLDPRT, Manifold_v2-0.STEP, Manifold_v2-0.STL, RPI_v004_BOM.csv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]
2021-01-13 sensor board updates
    [Sensirion_connector_board_v002.brd, Sensirion_connector_board_v002.sch, Sensirion_connector_board_v002_HAND_BOM.csv, Sensirion_connector_board_v002_JLCPCB_BOM.csv, air_flow.brd, air_flow.sch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]
2021-01-15 Fixed ground track, updated date & gerbers
    [Sensirion_connector_board_v002.brd]
2021-01-15 Undeleting mechanical folders
    [Manifold_v1.STEP, Manifold_v1.STL, Manifold_v2-0.SLDPRT, Manifold_v2-0.STEP, Manifold_v2-0.STL]
2021-01-18 Adjusted board outline to be 20mm x 20mm for JLC Assembly
    [Sensirion_connector_board_v002.brd]
2021-01-18 Adjusted width of PCB to be 20mm
    was still 19mm
    [Sensirion_connector_board_v002.brd]
2021-02-01 Update to BOM for missing 40pin
    [raspberry_pi_v007_HAND_BOM.csv]
2021-02-10 Update manifold
    [P-TET-000008-1.stl]
2021-03-05 Upload step files for manufacture
    [P-TET-000126-0.step, P-TET-000127-0.step]
2021-03-05 Move everything to more appropriate folder
    [P-TET-000126-0.step, P-TET-000127-0.step]
2021-05-12 Add in sensirion adapter components and iges files
    [P-TET-000126-0.iges, P-TET-000127-0.iges, P-TET-000136-0.iges, P-TET-000136-0.step, P-TET-000137-0.iges, P-TET-000137-0.step]
2021-07-08 Upload 12 mm push fit parts for manufacture
    [P-TET-000127-0.iges, P-TET-000127-0.step, P-TET-000136-0.iges, P-TET-000136-0.step, P-TET-000137-0.iges, P-TET-000137-0.step]
2021-07-09 Fixed issue with part 000136
    There was a missing feature in the revolve that led to the part not being a complete solid.
    [P-TET-000136-0.iges, P-TET-000136-0.step]
2021-08-21 Upload printable push fit adapters
    These adapters are compatible with 3/8" BSPT fittings and because Fusion 360 cannot model tapered threads were made by importing a part with 3/8" BSPT threads from McMaster-Carr, scaling them up in the radial direction by 0.5% and performing a boolean operation to cut the scaled up threads into the parts.
2021-09-01 Create P-TET-000138-0.stl
    Added printable check valve that uses off the shelf membranes.
2021-09-02 Update P-TET-000138-0.stl
    Update to bring valve seat in line with tetra valve
2021-09-14 Move files into more sensible place
    [P-TET-000126-0.iges, P-TET-000126-0.step, P-TET-000127-0.iges, P-TET-000127-0.step, P-TET-000136-0.iges, P-TET-000136-0.step, P-TET-000137-0.iges, P-TET-000137-0.step]
2021-09-14 Create BOM.md
    Create first stab at bill of materials
2021-09-14 Update BOM.md
    Added part number and better link for hose.
2021-09-14 Remove old versions of adapters
    The iges and step files were only relevant when we were going to have the components machined. Now we are printing them they are surplus to requirements. The associated drawings have also been removed to avoid confusion as they are not up to date.
    [P-TET-000127-0.iges, P-TET-000127-0.step, P-TET-000136-0.iges, P-TET-000136-0.step, P-TET-000137-0.iges, P-TET-000137-0.step]
2021-09-14 Update BOM.md
    Update to add other internal part numbers.
2021-09-14 Update BOM.md
    Added thread spec on stud
2021-09-14 Update BOM.md
    Update to remove redundant spaces.
2021-09-14 Update BOM.md
    Removed component cost as it is unnecessary.
2021-09-15 Update BOM.md
    Add o-ring and M5 to 6mm tube adapter as well as reducers from 12mm to 6mm.
2021-09-15 Update BOM.md
    Add description of o ring standard.
2021-09-15 Update BOM.md
    Add in silicone (are they actually silicone?) one way valves, tried my best with a functional description but honestly might as well have just called them silicone whatsits
2021-09-15 Update BOM.md
    Change quantity of aforementioned silicone whatsit
2021-10-03 Upload with adapters optimised for flexible resin printing
    These adapters have been modified to remove the taper so they would effectively be an interference fit but printed in flexible resin (~85A) they seem to seal well.
