tetrabiodistributed/project-tetra/(notices)

Notices in the files:
02_Development/FlowMeter/sensirion_connector_pcb/PCB Design Files/Sensirion_connector_board_v002.brd:
©2021 TETRA BIO
parts and their libraries:
SparkFun-PowerSymbols: Licensing: Creative Commons ShareAlike 4.0 International - https://creativecommons.org/licenses/by-sa/4.0
microbuilder: This work is placed in the public domain, and may be freely used for commercial and non-commercial work with the following conditions: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
